muvi/ELController/preview/ELController.png

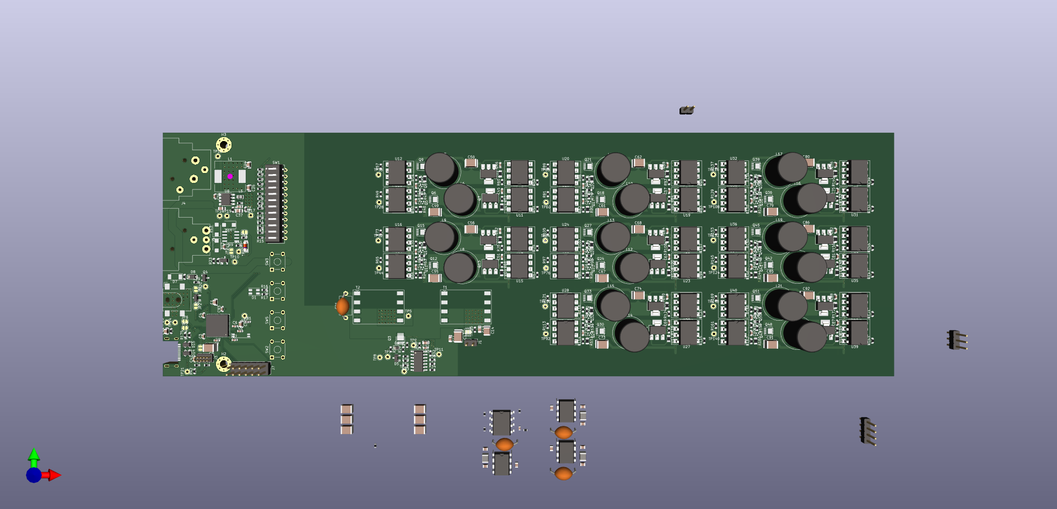
preview/ELController.png
