muvi/ELController/board design/Design Errors.txt

| oben links ist das 170V-Netzteil nur auf einer Seite verbunden und auf der anderen unterbrochen
| Der SWD stecker passt nicht, weil eine prtr-Schutzdiode vom USB Anschluss im Weg ist
  |-> angepasst, Silkscreen muss aber noch angepasst werden
| Der SWD STecker verdeckt ein Schraubloch
| Button 1 ist C, button 3 ist A
| channelnummerierung wurde geändert
| trace width change in OUTPUT_ENABLE net
/ Ground pin of DMX plug does not fit
| Numbering of DMX channels for selector DIP switch is wrong
- Additional support for 5 pin DMX connector
(/ CONFIG2 uses the same interrupt as BTN3 (EXTINT[5]))
| Silkscreen-Richtungsmarkierung ist bei D3 und D16 anders als bei D2
- at least one pin of the makeshift ADC should be a GPIO
/ add support for a display
| one more Button / replace reset button with regular BTN4
| Change order of BTN1 to BTN4 to match the letters from A to D
- replace transformers, they are not fit for the purpose (with GA3459-BL or GA3460-BL for example)
- the DIP switch could have one digit more resolution if the resistors where referenced to 1V, not 1.5V
/ maybe add support for a microphone over I2S
- order a lot more buttons. They break easily.
/ (add a header for a potential battery holder module which can also charge lithium ion batteries)
/ (add a header for wireless communication)
| Grundlast hinzufügen (10meg sind zu viel, noch ermitteln, < 250K)
- USB Anschluss ein bisschen weiter herausgucken lassen ?!
/ DMX connector does not fit easily in footprint (NOFIX: changes according to datasheet would worsen the situation)
- Add more capacitance to high voltage side (around 100 uF?)
- add capacitors to output channels
- remove some DNP resistors (at inverter for HV switching, ...)
- Diode D2 has not enough current capability, measure if 4 diodes are really enough (measure maximum discharge time and calculate current)
- buy more buttons

Channel mapping: (Beschriftung = Netzname)
1 = 2
2 = 1
3 = 4
4 = 3
5 = 5
6 = 7
7 = 6
8 = 8
