muvi/ELController/code R1/ELController/My Project/hpl/doc_lite/usart.rst

======================
USART driver
======================
The Universal Synchronous and Asynchronous serial Receiver and Transmitter (USART) peripheral is a
fast and flexible serial communication module. The USART supports full-duplex communication,
asynchronous and synchronous operation and one-wire configurations.

Features
--------
* Initialization

Applications
------------
* Terminal application
* Low-speed communication between devices.

Dependencies
------------
* CLKCTRL for clock
* PORT for I/O lines and connections
* CPUINT for interrupts
* EVSYS for events
* UPDI for debug

Concurrency
-----------
N/A

Limitations
-----------
N/A

Knows issues and workarounds
----------------------------
N/A
