muvi/ELController/board design R1/Pin mapping R1.ods

Sheet: Pins
SAMD2xG | SAMD2xJ | Pin | Cluster SAMD2xG | Cluster SAMD2xJ | Usage | Function | Power (mA) | Conflicts
1 | 1 | PA00 | 6 | 7 | XIN32 | -
2 | 2 | PA01 | 6 | 7 | XOUT32 | -
3 | 3 | PA02 | 6 | 7 | ADC – AIN[0] | B
4 | 4 | PA03 | 6 | 7 | ADC – AIN[1] | B |  | ADC/VREFA
 | 5 | PB04 |  | 7 | ADC – AIN[12] |  |  |  | USB CC1
 | 6 | PB05 |  | 7 | ADC – AIN[13] |  |  |  | USB CC2
5 | 7 | GNDANA
6 | 8 | VDDANA
 | 9 | PB06 |  | 6
 | 10 | PB07 |  | 6
7 | 11 | PB08 | 5 | 6 | TC4/WO[0] | E | 10
8 | 12 | PB09 | 5 | 6 | TC4/WO[1] | E | 10
9 | 13 | PA04 | 5 | 6 | ADC – AIN[4] | B |  | TCC0/WO[0]
10 | 14 | PA05 | 5 | 6 | ADC – AIN[5] | B |  | TCC0/WO[1]
11 | 15 | PA06 | 5 | 6 | ADC – AIN[6] | E | 10 | TCC1/WO[0]
12 | 16 | PA07 | 5 | 6 | TCC1/WO[1] | E | 10
13 | 17 | PA08 | 4 | 5 | TCC0/WO[0] | E | 10
14 | 18 | PA09 | 4 | 5 | TCC0/WO[1] | E | 10
15 | 19 | PA10 | 4 | 5 | TCC0/WO[2] | F | 10 | TCC1/WO[0]
16 | 20 | PA11 | 4 | 5 | TCC0/WO[3] | F | 10 | TCC1/WO[1]
17 | 21 | VDDIO
18 | 22 | GND
19 | 23 | PB10 | 3 | 4 | TC5/WO[0] | E | 10
20 | 24 | PB11 | 3 | 4 | TC5/WO[1] | E | 10
 | 25 | PB12 |  | 4
 | 26 | PB13 |  | 4
 | 27 | PB14 |  | 4
 | 28 | PB15 |  | 4
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
