muvi/ELController/board design/Pin mapping.xlsx

Sheet: Pins
SAMD2xG | SAMD2xJ | Pin | Cluster SAMD2xG | Cluster SAMD2xJ | Name | Usage | Function | Power (mA) | Old Name | HV Support Wave out
1 | 1 | PA00 | 6 | 7 | XIN32 | XIN32 | - |  | XIN32
2 | 2 | PA01 | 6 | 7 | XOUT32 | XOUT32 | - |  | XOUT32
3 | 3 | PA02 | 6 | 7 | PWR_SENSE | ADC – AIN[0] | B (ADC) |  | PWR_SENSE
4 | 4 | PA03 | 6 | 7 | HV_SENSE | ADC – AIN[1] | B (ADC) |  | HV_SENSE
 | 5 | PB04 |  | 7 | USB_CC1 | - | - |  | USB_CC1
 | 6 | PB05 |  | 7 | USB_CC2 | - | - |  | USB_CC2
5 | 7 | GNDANA
6 | 8 | VDDANA
 | 9 | PB06 |  | 6 | BTN_A | EXTINT[6] | A |  | GPIO3
 | 10 | PB07 |  | 6 | BTN_B | EXTINT[7] | A |  | GPIO4
7 | 11 | PB08 | 5 | 6 | CH7+ | TC4/WO[0] | E | 10 | CH6+
8 | 12 | PB09 | 5 | 6 | CH7- | TC4/WO[1] | E | 10 | CH6-
9 | 13 | PA04 | 5 | 6 | CONFIG1 | AC – AIN[0] | B (AC) |  | CONFIG1
10 | 14 | PA05 | 5 | 6 | CONFIG2 | AC – AIN[1] | B (AC) |  | CONFIG2
11 | 15 | PA06 | 5 | 6 | CONFIG3 | AC – AIN[2] | B (AC) | 10 | CONFIG3 | X
12 | 16 | PA07 | 5 | 6 | HV_SW | TCC1/WO[1] | E | 10 | HV_SW
13 | 17 | PA08 | 4 | 5 | PWR_GOOD | NMI | A | 10 | CH1+ | X
14 | 18 | PA09 | 4 | 5 | OUTPUT_ENABLE | - | - | 10 | CH1-
15 | 19 | PA10 | 4 | 5 | CH1+ | TCC0/WO[2] | F | 10 | CH2+ | X
16 | 20 | PA11 | 4 | 5 | CH1- | TCC0/WO[3] | F | 10 | CH2-
17 | 21 | VDDIO
18 | 22 | GND
19 | 23 | PB10 | 3 | 4 | CH6+ | TC5/WO[0] | E | 10 | CH7+
20 | 24 | PB11 | 3 | 4 | CH6- | TC5/WO[1] | E | 10 | CH7-
 | 25 | PB12 |  | 4 | BTN_C | EXTINT[12] | A |  | DISPLAY_MOSI / GPIO5
 | 26 | PB13 |  | 4 | BTN_D | EXTINT[13] | A |  | DISPLAY_SCK / GPIO6
 | 27 | PB14 |  | 4 | DISPLAY_SS | SERCOM4/PAD[2] | C |  | DISPLAY_SS / GPIO7
 | 28 | PB15 |  | 4 | DISPLAY_MISO | SERCOM4/PAD[3] | C |  | DISPLAY_MISO / GPIO8
21 | 29 | PA12 | 3 | 4 | DISPLAY_MOSI | SERCOM4/PAD[0] | D |  | CH3+
22 | 30 | PA13 | 3 | 4 | DISPLAY_SCK | SERCOM4/PAD[1] | D |  | CH3-
23 | 31 | PA14 | 3 | 4 | CH4+ | TC3/WO[0] | E | 10 | PWR_GOOD
24 | 32 | PA15 | 3 | 4 | CH4- | TC3/WO[1] | E | 10 | DMX_SENDER_ENABLE
 | 33 | GND
 | 34 | VDDIO
25 | 35 | PA16 | 3 | 3 | CH3+ | TCC2/WO[0] | E | 10 | BTN1
26 | 36 | PA17 | 3 | 3 | CH3- | TCC2/WO[1] | E | 10 | BTN2
27 | 37 | PA18 | 3 | 3 | MIC_ENABLE | - | - |  | CH4+
28 | 38 | PA19 | 3 | 3 | I2S_SD | I2S/SD[0] | G |  | CH4-
 | 39 | PB16 |  | 3 | GPIO1 |  | - |  | GPIO9
 | 40 | PB17 |  | 3 | GPIO2 | - | - |  | GPIO10
29 | 41 | PA20 | 3 | 3 | i2S_SCK | I2S/SCK[0] | G |  | OUTPUT_ENABLE
30 | 42 | PA21 | 3 | 3 | I2S_WS | I2S/FS[0] | G |  | BTN3
31 | 43 | PA22 | 3 | 3 | DMX_TX | SERCOM3/PAD[0] | C |  | DMX_TX
32 | 44 | PA23 | 3 | 3 | DMX_RX | SERCOM3/PAD[1] | C |  | DMX_RX
33 | 45 | PA24 | 3 | 3 | USB_D- | USB/DM | G |  | USB/DM | X
34 | 46 | PA25 | 3 | 3 | USB_D+ | USB/DP | G |  | USB/DP
35 | 47 | GND
36 | 48 | VDDIO
37 | 49 | PB22 | 2 | 2 | CH8+ | TC7/WO[0] | E | 10 | CH8+
38 | 50 | PB23 | 2 | 2 | CH8- | TC7/WO[1] | E | 10 | CH8-
39 | 51 | PA27 | 2 | 2 | LED1 | - | - | 10 | LED1
40 | 52 | RESET
41 | 53 | PA28 | 2 | 2 | LED2 | - | - | 10 | LED2
42 | 54 | GND
43 | 55 | VDDCORE
44 | 56 | VDDIN
45 | 57 | PA30 | 1 | 1 | SWDCLK | SWCLK | G |  | SWDCLK | X
46 | 58 | PA31 | 1 | 1 | SWDIO | SWDIO | G |  | SWDIO
 | 59 | PB30 |  | 1 | CH2+ | TCC0/WO[0] | E | 10 | GPIO11 | X
 | 60 | PB31 |  | 1 | CH2- | TCC0/WO[1] | E |  | GPIO12
 | 61 | PB00 |  | 7 | GPIO3 | - | - |  | GPIO1
 | 62 | PB01 |  | 7 | DMX_SENDER_ENABLE | - | - |  | GPIO2
47 | 63 | PB02 | 6 | 7 | CH5+ | TC6/WO[0] | E | 10 | CH5+
48 | 64 | PB03 | 6 | 7 | CH5- | TC6/WO[1] | E | 10 | CH5-

Sheet: Settings
 | Power (mA)
Power per channel driver | 10
Power per LED | 10
Source current per cluster | 46
Sink current per cluster | 65
Cluster | G Version | J Version
1 | 0 | 10
2 | 40 | 40
3 | 60 | 20
4 | 40 | 40
5 | 40 | 40
6 | 20 | 40
7 | 0 | 20
Sum | 200
