muvi/ELController/board design/ELController-bom-log.csv

Title: | EL Controller
Revision: | 2
Date: | Sat 25 Feb 2023 07:12:46 PM CET
Ref | Error message | Value | Footprint | Datasheet
