muvi/ELController/ideal diode board/ideal_diode-bom-log.csv

Title: | Ideal diode
Revision: | 1
Date: | Fri 06 Jan 2023 10:19:56 PM CET
Ref | Error message | Value | Footprint | Datasheet
