muvi/ELController/Ordering/2022-04-10 BOM grouped.xlsx

Sheet: Items
Item | Qty | Minimum Amount | Amount Arrived/Ordered | Duplicate of | Reference(s) | Value | Supplier part number |  | LibPart | Footprint | Datasheet
1 | 7 | 50 | 100 |  | C1, C5, C24, C28, C31, C34, C38 | 10uF | CL21A106KOQNNNE | CL21A106KOQNNNE | Device:C |  | https://www.mouser.de/datasheet/2/585/MLCC-1837944.pdf
2 | 41 | 210 | 250 |  | C2, C3, C4, C6, C10, C23, C35, C43, C45, C46, C47, C48, C51, C52, C53, C54, C57, C58, C59, C60, C63, C64, C65, C66, C69, C70, C71, C72, C75, C76, C77, C78, C81, C82, C83, C84, C87, C88, C89, C90, C93 | 100nF | CL10B104KA8NFNC | CL10B104KA8NFNC | Device:C |  | ~
3 | 2 | 10 | 20 |  | C7, C8 | 9.1pF | 0603N9R1C500CT | #N/A | Device:C |  | ~
4 | 18 | 0 | 0 | 7 | C9, C12, C49, C50, C55, C56, C61, C62, C67, C68, C73, C74, C79, C80, C85, C86, C91, C92 | 1uF, 200V |  | 0 | Device:C |  | ~
5 | 3 | 0 | 0 | 1 | C11, C13, C22 | 10uF |  | 0 | Device:C_Polarized |  | ~
6 | 1 | 5 | 10 |  | C14 | 47uF, GRM32EC81C476KE15K | GRM32EC81C476KE15K | GRM32EC81C476KE15K | Device:C_Polarized |  | ~
7 | 6 | 120 | 120 |  | C15, C16, C17, C18, C19, C20 | 1uF, 200V | 1812B105K251CT | 1812B105K251CT | Device:C_Polarized |  | ~
8 | 4 | 20 | 30 |  | C21, C39, C40, C41 | Y2 1nF | C901U102MZWDBA7317 | C901U102MZWDBA7317 | Device:C |  | ~
9 | 2 | 10 | 20 |  | C25, C37 | 22uF | CL21A226MOQNNNE | CL21A226MOQNNNE | Device:C |  | ~
10 | 6 | 30 | 40 |  | C26, C27, C29, C30, C32, C33 | 4.7uF | CL21A475KAQNNNF | CL21A475KAQNNNF | Device:C_Polarized |  | ~
11 | 1 | 5 | 10 |  | C36 | 680pF | 885012206033 | 885012206033 | Device:C |  | ~
12 | 1 | 0 | 0 | 2 | C42 | 100nF, DNP |  | 0 | Device:C |  | ~
13 | 1 | 5 | 10 |  | C44 | 4.7nF | 885012206087 | 885012206087 | Device:C |  | ~
14 | 1 | 5 | 10 |  | D1 | LED_Dual_CACA: Pinout incorrect | 150141YB73100 | 150141YB73100 | Device:LED_Dual_KAKA |  | https://eu.mouser.com/datasheet/2/445/150141YB73100-1714285.pdf
15 | 1 | 5 | 10 |  | D2 | FM4007W-W | FM4007W-W | FM4007W-W | Device:D |  | https://www.mouser.de/datasheet/2/345/fm4001w_fm4007w-1396243.pdf
16 | 2 | 10 | 15 |  | D3, D16 | BZD27B180P-M3-08 | BZD27B180P-M3-08 | BZD27B180P-M3-08 | Device:D_Zener |  | https://www.mouser.de/datasheet/2/427/VISH_S_A0008998136_1-2570582.pdf
17 | 2 | 10 | 15 |  | D4, D5 | BZX8450-C1V8-QR | BZX8450-C1V8-QR | BZX8450-C1V8-QR | el_components:BZX8450-C1V8-QR |  | ~
18 | 1 | 5 | 10 |  | D6 | MM3Z36VT1G | MM3Z36VT1G | MM3Z36VT1G | Device:D_Zener |  | ~
19 | 1 | 5 | 10 |  | D7 | PMEG3050EP,115 | PMEG3050EP,115 | PMEG3050EP,115 | Device:D_Schottky |  | ~
20 | 1 | 5 | 10 |  | D8 | PTVS13VS1UTR,115 | PTVS13VS1UTR,115 | PTVS13VS1UTR,115 | el_components:DESD1CAN2WQ-7 |  | https://www.mouser.de/datasheet/2/916/PTVSXS1UTR_SER-1600409.pdf
21 | 1 | 5 | 10 |  | D9 | BAT54A_R1_00001 | BAT54A_R1_00001 | BAT54A_R1_00001 | Diode:BAT54AW | Package_TO_SOT_SMD:SOT-323_SC-70 | https://www.mouser.de/datasheet/2/1057/BAT54_SERIES-1869048.pdf
22 | 1 | 5 | 10 |  | D10 | ZMM5226B | ZMM5226B | ZMM5226B | Diode:ZMMxx | Diode_SMD:D_MiniMELF | https://diotec.com/tl_files/diotec/files/pdf/datasheets/zmm1.pdf
23 | 3 | 15 | 20 |  | D11, D12, D13 | SMAJ6.0A-W | SMAJ6.0A-W | SMAJ6.0A-W | Device:D_TVS |  | ~
24 | 2 | 10 | 15 |  | D14, D15 | PRTR5V0U2X | PRTR5V0U2X,215 | PRTR5V0U2X,215 | Power_Protection:PRTR5V0U2X | Package_TO_SOT_SMD:SOT-143 | https://assets.nexperia.com/documents/data-sheet/PRTR5V0U2X.pdf
25 | 1 | 5 | 20 |  | F1 | ERB-RE5R00V | ERB-RE5R00V | ERB-RE5R00V | Device:Fuse |  | https://www.mouser.de/datasheet/2/315/AFA0000C7-1025982.pdf
26 | 2 | 10 | 20 |  | FB1, FB2 | MMZ1608Y221BTD25 |  | 0 | Device:FerriteBead |  | ~
27 | 4 | 20 | N/A |  | H1, H2, H3, H4 | MountingHole_Pad |  | 0 | Mechanical:MountingHole_Pad |  | ~
28 | 1 | 5 | N/A |  | J1 | 01x01_Male |  | 0 | Connector:Conn_01x01_Male |  | ~
29 | 1 | 5 | 10 |  | J2 | 54-00164 |  | 0 | Connector:Barrel_Jack_Switch |  | ~
30 | 1 | 5 | 10 |  | J3 | SWD_Connector | 3220-10-0100-00 | #N/A | Connector_Generic:Conn_02x05_Odd_Even |  | http://www.cnctech.us/pdfs/3220-XX-0100-00_.pdf
31 | 1 | 5 | 5 |  | J4 | AC3FAH2-AU-PRE |  | 0 | Connector:XLR3 |  | ~
32 | 1 | 5 | 5 |  | J5 | AC3MAH-AU-PRE |  | 0 | Connector:XLR3 |  | ~
33 | 1 | 5 | N/A |  | J6 | Conn_01x03 |  | 0 | Connector_Generic:Conn_01x03 |  | ~
34 | 1 | 5 | N/A |  | J7 | Conn_02x06_Top_Bottom |  | 0 | Connector_Generic:Conn_02x06_Top_Bottom |  | ~
35 | 1 | 5 | N/A |  | J8 | Conn_01x04 |  | 0 | Connector_Generic:Conn_01x04 |  | ~
36 | 1 | 5 | 11 |  | J9 | USB_C | USB4105-GF-A | #N/A | Connector:USB_B_Micro |  | ~
37 | 8 | 40 | 40 |  | J10, J11, J12, J13, J14, J15, J16, J17 | JST-SM |  | #N/A | Connector:Conn_01x02_Female |  | ~
38 | 3 | 15 | N/A |  | JP1, JP2, JP4 | SolderJumper |  | #N/A | Jumper:SolderJumper_2_Open |  | ~
39 | 2 | 10 | N/A |  | JP3, JP5 | SolderJumper_2_Open |  | #N/A | Jumper:SolderJumper_2_Open |  | ~
40 | 1 | 5 | 10 |  | L1 | 22uH | 7447706220 | 7447706220 | Device:L |  | ~
41 | 3 | 15 | 20 |  | L2, L3, L4 | 6.8uH | LBC3225T6R8MR | LBC3225T6R8MR | Device:L |  | ~
42 | 1 | 5 | 10 |  | L5 | 2.2uH | TFM201610ALVA2R2MTAA | TFM201610ALVA2R2MTAA | Device:L |  | ~
43 | 16 | 80 | 100 |  | L6, L7, L8, L9, L10, L11, L12, L13, L14, L15, L16, L17, L18, L19, L20, L21 | 3.3mH | RFS1317-335KL | #N/A | Device:L |  | ~
44 | 1 | 0 | 0 | 45 | Q1 | DNP, RZM001P02 |  | #N/A | Device:Q_PMOS_GSD |  | ~
45 | 17 | 90 | 100 |  | Q2, Q5, Q8, Q11, Q14, Q17, Q20, Q23, Q26, Q29, Q32, Q35, Q38, Q41, Q44, Q47, Q50 | RZM001P02 |  | #N/A | Device:Q_PMOS_GSD |  | ~
46 | 1 | 5 | 10 |  | Q3 | RQ3G100GN | RQ3G100GNTB | RQ3G100GNTB | el_components:RQ3G100GN |  | https://www.mouser.de/datasheet/2/348/rq3g100gntb-e-1873284.pdf
47 | 1 | 5 | 10 |  | Q4 | RK7002BMT116 | RK7002BMT116 | RK7002BMT116 | Device:Q_NMOS_DGS |  | ~
48 | 16 | 80 | 100 |  | Q6, Q9, Q12, Q15, Q18, Q21, Q24, Q27, Q30, Q33, Q36, Q39, Q42, Q45, Q48, Q51 | Si7119DN |  | #N/A | el_components:Si7119DN |  | https://www.mouser.de/datasheet/2/427/VISH_S_A0001142067_1-2567136.pdf
49 | 16 | 80 | 100 |  | Q7, Q10, Q13, Q16, Q19, Q22, Q25, Q28, Q31, Q34, Q37, Q40, Q43, Q46, Q49, Q52 | STN4NF20L |  | #N/A | el_components:STN4NF20L |  | https://www.mouser.de/datasheet/2/389/cd00272247-1797117.pdf
50 | 20 | 110 | 200 |  | R1, R6, R11, R21, R46, R54, R62, R70, R78, R86, R94, R102, R110, R118, R126, R134, R142, R150, R158, R166 | 10k | RC0603JR-0710KL | RC0603JR-0710KL | Device:R |  | ~
51 | 3 | 15 | 30 |  | R2, R7, R12 | 560 | RC0603JR-07560RL | RC0603JR-07560RL | Device:R |  | ~
52 | 3 | 15 | 30 |  | R3, R8, R13 | 1k2 | RMC1/16-122JTP | RMC1/16-122JTP | Device:R |  | ~
53 | 3 | 15 | 30 |  | R4, R9, R14 | 2k2 | RC0603FR-072K2L | RC0603FR-072K2L | Device:R |  | ~
54 | 3 | 15 | 30 |  | R5, R10, R15 | 4k7 | RMC1/16-472JTP | RMC1/16-472JTP | Device:R |  | ~
55 | 35 | 175 | 200 |  | R16, R17, R18, R49, R51, R57, R59, R65, R67, R73, R75, R81, R83, R89, R91, R97, R99, R105, R107, R113, R115, R121, R123, R129, R131, R137, R139, R145, R147, R153, R155, R161, R163, R169, R171 | 470 -> 510 | RC0603JR-07510RL | RC0603JR-07510RL | Device:R |  | ~
56 | 19 | 95 | 125 |  | R19, R40, R41, R50, R58, R66, R74, R82, R90, R98, R106, R114, R122, R130, R138, R146, R154, R162, R170 | 1k | RC0603FR-071KL | RC0603FR-071KL | Device:R |  | ~
57 | 1 | 0 | 0 | 50 | R20 | DNP, 10k |  | #N/A | Device:R |  | ~
58 | 1 | 5 | 20 |  | R22 | DNP, 10meg, 200V | MR12W1005FTL | #N/A | Device:R |  | ~
59 | 2 | 10 | 25 |  | R23, R24 | 22k 1% | CR0603-FX-2202ELF | CR0603-FX-2202ELF | Device:R |  | ~
60 | 1 | 5 | 10 |  | R25 | 22 | 301-22-RC | 301-22-RC | Device:R |  | ~
61 | 2 | 10 | 25 |  | R26, R27 | 680 1% | CR0603-FX-6800ELF | CR0603-FX-6800ELF | Device:R |  | ~
62 | 22 | 110 | 125 |  | R28, R31, R33, R34, R35, R36, R47, R55, R63, R71, R79, R87, R95, R103, R111, R119, R127, R135, R143, R151, R159, R167 | 0 | CR0603-J/-000ELF | CR0603-J/-000ELF | Device:R |  | ~
63 | 1 | 5 | 10 |  | R29 | 220, 1/8W | RK73B1JTTDD221J | RK73B1JTTDD221J | Device:R |  | ~
64 | 4 | 20 | 30 |  | R30, R32, R44, R45 | 1meg | RC0603JR-131ML | RC0603JR-131ML | Device:R |  | ~
65 | 1 | 5 | 10 |  | R37 | 16k | RMC16K163FTP | RMC16K163FTP | Device:R |  | ~
66 | 3 | 15 | 20 |  | R38, R174, R175 | 5.1k | WR06X512 JTL | WR06X512 JTL | Device:R |  | ~
67 | 1 | 5 | 15 |  | R39 | 10meg | RC0603JR-0710ML | RC0603JR-0710ML | Device:R |  | ~
68 | 1 | 0 | 0 | 50 | R42 | 10k, DNP |  | 0 | Device:R |  | ~
69 | 1 | 5 | 10 |  | R43 | 330 | CR0603-JW-331ELF | CR0603-JW-331ELF | Device:R |  | ~
70 | 32 | 160 | 200 |  | R48, R53, R56, R61, R64, R69, R72, R77, R80, R85, R88, R93, R96, R101, R104, R109, R112, R117, R120, R125, R128, R133, R136, R141, R144, R149, R152, R157, R160, R165, R168, R173 | 100 | RC0805FR-13100RL | RC0805FR-13100RL | Device:R |  | ~
71 | 16 | 80 | 100 | 53 | R52, R60, R68, R76, R84, R92, R100, R108, R116, R124, R132, R140, R148, R156, R164, R172 | 2.2k | 301-2.2K-RC | 301-2.2K-RC | Device:R |  | ~
72 | 1 | 5 | (8) + 6 |  | SW1 | SW_DIP_x12 | DS01C-254-S-12BE | DS01C-254-S-12BE | Switch:SW_DIP_x12 |  | ~
73 | 4 | 20 | 25 |  | SW2, SW3, SW4, SW5 | SW_Push | MJTP1230 | MJTP1230 | Switch:SW_Push |  | ~
74 | 2 | 10 | 16 |  | T1, T2 | 750032050 |  | 0 | el_components:750032050 |  | ~
75 | 33 | 165 | 200 |  | U1, U10, U11, U12, U13, U14, U15, U16, U17, U18, U19, U20, U21, U22, U23, U24, U25, U26, U27, U28, U29, U30, U31, U32, U33, U34, U35, U36, U37, U38, U39, U40, U41 | 6N137 |  | 0 | Isolator:6N137 | Package_DIP:DIP-8_W7.62mm | https://docs.broadcom.com/docs/AV02-0940EN
76 | 1 | 5 | 25 |  | U2 | ATSAMD21J15B-M |  | 0 | MCU_Microchip_SAMD:ATSAMD21J15B-M | Package_DFN_QFN:QFN-64-1EP_9x9mm_P0.5mm_EP4.7x4.7mm | http://ww1.microchip.com/downloads/en/DeviceDoc/SAM_D21_DA1_Family_Data%20Sheet_DS40001882E.pdf
77 | 1 | 5 | 10 |  | U3 | MP5000A |  | 0 | el_components:MP5000A |  | https://www.mouser.de/datasheet/2/277/MP5000A-1384322.pdf
78 | 1 | 5 | 10 |  | U4 | 74ACT14 | MC74ACT14DR2G | MC74ACT14DR2G | 74xx:74HC14 |  | http://www.ti.com/lit/gpn/sn74HC14
79 | 3 | 15 | 18 |  | U5, U6, U7 | PDSE1-S5-S5-D | PDSE1-S5-S5-D | PDSE1-S5-S5-D | el_components:PDSE1-S5-S5-D |  | https://www.mouser.de/datasheet/2/670/pdse1_d-1774645.pdf
80 | 1 | 5 | 10 |  | U8 | BD93291EFJ |  | 0 | el_components:BD93291EFJ |  | https://www.mouser.de/datasheet/2/348/bd93291efj-e-1874257.pdf
81 | 1 | 5 | 10 |  | U9 | MAX485 |  | 0 | Interface_UART:MAX485E |  | https://datasheets.maximintegrated.com/en/ds/MAX1487-MAX491.pdf
82 | 1 | 5 | 10 |  | Y1 | SSP-T7-F, MS1V-T1K | SSPT7F-7PF20-R | SSPT7F-7PF20-R | Device:Crystal_GND23 |  | ~
83 | 1 | 5 | 10 |  | D17 | TPSMB210A | TPSMB210A | TPSMB210A | Device:D_TVS |  | https://www.mouser.de/datasheet/2/240/Littelfuse_TVS_Diode_TPSMB_Datasheet_pdf-349004.pdf

Sheet: Mouser
WARENKORB
Dies ist keine Rechnung
11-Apr-22 16:41:46
 | Mouser-Nr. | Herst.- Nr. | Hersteller | Kunden-Teilenr | Beschreibung | RoHS | Lebenszyklus | Stückzahl | Preis (EUR) | Gesamtpreis: (EUR)
1 | 187-CL21A106KOQNNNE | CL21A106KOQNNNE | Samsung Electro-Mechanics |  | Kondensator aus mehreren Keramikschichten MLCC - SMD/SMT 10uF+/-10% 16V X5R 2 0805 | RoHS-konform | Neu bei Mouser | 100 | 0,035 € | 3,50 € | CL21A106KOQNNNE
2 | 187-CL10B104KA8NFNC | CL10B104KA8NFNC | Samsung Electro-Mechanics |  | Kondensator aus mehreren Keramikschichten MLCC - SMD/SMT 100nF+/-10% 25V X7R 0603 | RoHS-konform | Neu bei Mouser | 250 | 0,012 € | 3,00 € | CL10B104KA8NFNC
3 | 81-GRM32EC81C476KE5K | GRM32EC81C476KE15K | Murata |  | Kondensator aus mehreren Keramikschichten MLCC - SMD/SMT 47UF 16V 10% 1210 | RoHS-konform |  | 10 | 0,379 € | 3,79 € | GRM32EC81C476KE15K
4 | 791-1812B105K251CT | 1812B105K251CT | Walsin |  | Kondensator aus mehreren Keramikschichten MLCC - SMD/SMT 1812 MLCC X7R 1 uF +/- 10% 250 V T&R GP | RoHS-konform |  | 120 | 0,363 € | 43,56 € | 1812B105K251CT
5 | 187-CL21A226MOQNNNE | CL21A226MOQNNNE | Samsung Electro-Mechanics |  | Kondensator aus mehreren Keramikschichten MLCC - SMD/SMT 22uF+/-20% 16V X5R 2 0805 | RoHS-konform | Neu bei Mouser | 20 | 0,127 € | 2,54 € | CL21A226MOQNNNE
6 | 187-CL21A475KAQNNNF | CL21A475KAQNNNF | Samsung Electro-Mechanics |  | Kondensator aus mehreren Keramikschichten MLCC - SMD/SMT 4.7uF+/-10% 25V X5R 0805 | RoHS-konform | Neu bei Mouser | 40 | 0,074 € | 2,96 € | CL21A475KAQNNNF
7 | 710-885012206033 | 885012206033 | Wurth Elektronik |  | Kondensator aus mehreren Keramikschichten MLCC - SMD/SMT WCAP-CSGP 680pF 0603 10% 16V MLCC | RoHS-konform |  | 10 | 0,02 € | 0,20 € | 885012206033
8 | 710-885012206087 | 885012206087 | Wurth Elektronik |  | Kondensator aus mehreren Keramikschichten MLCC - SMD/SMT WCAP-CSGP 4700pF 0603 10% 50V MLCC | RoHS-konform |  | 10 | 0,017 € | 0,17 € | 885012206087
9 | 628-SSPT7F-7PF20PPM | SSPT7F-7PF20-R | Seiko Instruments |  | Quarze Quartz Crystal Unit 32.768KHZ 7pF | RoHS-konform |  | 10 | 0,553 € | 5,53 € | SSPT7F-7PF20-R
10 | 81-GRM0225C1H9R1CA3L | GRM0225C1H9R1CA03L | Murata |  | Kondensator aus mehreren Keramikschichten MLCC - SMD/SMT | RoHS-konform |  | 10 | 0,046 € | 0,46 € | #N/A
11 | 80-C901U102MZWDBAP | C901U102MZWDBA7317 | KEMET |  | Sicherheitskondensatoren 440/300V 1000pF Y5U 20% LS=10mm | RoHS-konform |  | 30 | 0,148 € | 4,44 € | C901U102MZWDBA7317
12 | 490-PDSE1-S5-S5-D | PDSE1-S5-S5-D | CUI Inc. |  | ISOLIERTE DC-DC-WANDLER dc-dc isolated, 1 W, 4.5~5.5 Vdc input, 5 Vdc, 0.2 A, single unregulated output, DIP | RoHS-konform |  | 18 | 2,70 € | 48,60 € | PDSE1-S5-S5-D
13 | 863-MC74ACT14DR2G | MC74ACT14DR2G | onsemi |  | Inverter 5V CMOS Hex Schmitt Trigger | RoHS-konform |  | 10 | 0,464 € | 4,64 € | MC74ACT14DR2G
14 | 642-MJTP1230 | MJTP1230 | Apem |  | Sensorschalter 6mm TACTILE SW | RoHS-konform |  | 25 | 0,074 € | 1,85 € | MJTP1230
15 | 755-RQ3G100GNTB | RQ3G100GNTB | ROHM Semiconductor |  | MOSFET Nch 40V 10A Power MOSFET | RoHS: Konform durch Ausnahmegenehmigung |  | 10 | 0,383 € | 3,83 € | RQ3G100GNTB
16 | 755-RK7002BMT116 | RK7002BMT116 | ROHM Semiconductor |  | MOSFET 2.5V Drive Nch MOSFET | RoHS: Konform durch Ausnahmegenehmigung |  | 10 | 0,17 € | 1,70 € | RK7002BMT116
17 | 583-FM4007W-W | FM4007W-W | Rectron |  | Gleichrichter 1A, 1000V, SM | RoHS: Konform durch Ausnahmegenehmigung |  | 10 | 0,14 € | 1,40 € | FM4007W-W
18 | 771-BZX8450-C1V8-QR | BZX8450-C1V8-QR | Nexperia |  | Zener-Dioden BZX8450-C1V8-Q/SOT23/TO-236AB | RoHS-konform | Neues Produkt | 15 | 0,134 € | 2,01 € | BZX8450-C1V8-QR
19 | 863-MM3Z36VT1G | MM3Z36VT1G | onsemi |  | Zener-Dioden 36V 200mW | RoHS-konform |  | 10 | 0,127 € | 1,27 € | MM3Z36VT1G
20 | 771-PMEG3050EP115 | PMEG3050EP,115 | Nexperia |  | Schottky Dioden & Gleichrichter SCHOTTKY RECT 30V 5A | RoHS: Konform durch Ausnahmegenehmigung |  | 10 | 0,438 € | 4,38 € | PMEG3050EP,115
21 | 241-BAT54A_R1_00001 | BAT54A_R1_00001 | Panjit |  | Schottky Dioden & Gleichrichter 30V Schottky 0.2A | RoHS-konform | Neu bei Mouser | 10 | 0,142 € | 1,42 € | BAT54A_R1_00001
22 | 583-ZMM5226B | ZMM5226B | Rectron |  | Zener-Dioden 0.5W 3.3V 5% | RoHS: Konform durch Ausnahmegenehmigung |  | 10 | 0,108 € | 1,08 € | ZMM5226B
23 | 583-SMAJ6.0A-W | SMAJ6.0A-W | Rectron |  | ESD-Entstörer/TVS-Dioden SMA 400w TVS 5% | RoHS-konform |  | 20 | 0,108 € | 2,16 € | SMAJ6.0A-W
24 | 771-PRTR5V0U2X-T/R | PRTR5V0U2X,215 | Nexperia |  | ESD-Entstörer/TVS-Dioden 5.5V DUAL R-R ESD ULTRA LOW CAP | RoHS-konform |  | 15 | 0,407 € | 6,11 € | PRTR5V0U2X,215
25 | 667-ERB-RE5R00V | ERB-RE5R00V | Panasonic |  | Sicherungen zur Aufbaumontage 5A 0603 micro chip | RoHS-konform |  | 20 | 0,211 € | 4,22 € | ERB-RE5R00V
26 | 603-RC0603JR-0710KL | RC0603JR-0710KL | YAGEO |  | Dickfilmwiderstände - SMD 10 kOhms 100 mW 0603 5% | RoHS: Konform durch Ausnahmegenehmigung |  | 200 | 0,005 € | 1,00 € | RC0603JR-0710KL
27 | 603-RC0603JR-07560RL | RC0603JR-07560RL | YAGEO |  | Dickfilmwiderstände - SMD 560 Ohms 100 mW 0603 5% | RoHS: Konform durch Ausnahmegenehmigung |  | 30 | 0,013 € | 0,39 € | RC0603JR-07560RL
28 | 791-RMC1/16-122JTP | RMC1/16-122JTP | Kamaya |  | Dickfilmwiderstände - SMD 0603 1K2 5% | RoHS: Konform durch Ausnahmegenehmigung |  | 30 | 0,013 € | 0,39 € | RMC1/16-122JTP
29 | 603-RC0603FR-072K2L | RC0603FR-072K2L | YAGEO |  | Dickfilmwiderstände - SMD 2.2 kOhms 100mW 0603 1% | RoHS: Konform durch Ausnahmegenehmigung |  | 30 | 0,015 € | 0,45 € | RC0603FR-072K2L
30 | 791-RMC1/16-472JTP | RMC1/16-472JTP | Kamaya |  | Dickfilmwiderstände - SMD 0603 4K7 5% | RoHS: Konform durch Ausnahmegenehmigung |  | 30 | 0,013 € | 0,39 € | RMC1/16-472JTP
31 | 603-RC0603JR-07510RL | RC0603JR-07510RL | YAGEO |  | Dickfilmwiderstände - SMD 510 Ohms 100 mW 0603 5% | RoHS: Konform durch Ausnahmegenehmigung |  | 200 | 0,005 € | 1,00 € | RC0603JR-07510RL
32 | 603-RC0603FR-071KL | RC0603FR-071KL | YAGEO |  | Dickfilmwiderstände - SMD 1 kOhms 100mW 0603 1% | RoHS: Konform durch Ausnahmegenehmigung |  | 125 | 0,006 € | 0,75 € | RC0603FR-071KL
33 | 652-CR0603FX-2202ELF | CR0603-FX-2202ELF | Bourns |  | Dickfilmwiderstände - SMD 22K ohm 1% | RoHS: Konform durch Ausnahmegenehmigung |  | 25 | 0,014 € | 0,35 € | CR0603-FX-2202ELF
34 | 652-CR0603FX-6800ELF | CR0603-FX-6800ELF | Bourns |  | Dickfilmwiderstände - SMD 680 ohm 1% | RoHS: Konform durch Ausnahmegenehmigung |  | 25 | 0,015 € | 0,38 € | CR0603-FX-6800ELF
35 | 301-22-RC | 301-22-RC | Xicon |  | Dickfilmwiderstände - SMD 1/10WATT 22OHMS 5% | RoHS: Konform durch Ausnahmegenehmigung |  | 10 | 0,011 € | 0,11 € | 301-22-RC
36 | 652-CR0603-J/-000ELF | CR0603-J/-000ELF | Bourns |  | Dickfilmwiderstände - SMD ZERO OHM | RoHS: Konform durch Ausnahmegenehmigung |  | 125 | 0,005 € | 0,63 € | CR0603-J/-000ELF
37 | 603-RC0603JR-131ML | RC0603JR-131ML | YAGEO |  | Dickfilmwiderstände - SMD 1 MOhms 100-200 mW 0603 5% | RoHS: Konform durch Ausnahmegenehmigung |  | 30 | 0,013 € | 0,39 € | RC0603JR-131ML
38 | 791-RMC16K163FTP | RMC16K163FTP | Kamaya |  | Dickfilmwiderstände - SMD 16 kOhms 1% 1.0A AEC-Q200 | RoHS: Konform durch Ausnahmegenehmigung |  | 10 | 0,016 € | 0,16 € | RMC16K163FTP
39 | 791-WR06X512JTL | WR06X512 JTL | Walsin |  | Dickfilmwiderstände - SMD 0603 5K1 5% Lead Free | RoHS-konform | Neues Produkt | 20 | 0,013 € | 0,26 € | WR06X512 JTL
40 | 603-RC0603JR-0710ML | RC0603JR-0710ML | YAGEO |  | Dickfilmwiderstände - SMD 10 MOhms 100 mW 0603 5% | RoHS: Konform durch Ausnahmegenehmigung |  | 15 | 0,013 € | 0,20 € | RC0603JR-0710ML
41 | 652-CR0603-JW-331ELF | CR0603-JW-331ELF | Bourns |  | Dickfilmwiderstände - SMD 330 OHM 5% | RoHS: Konform durch Ausnahmegenehmigung |  | 10 | 0,007 € | 0,07 € | CR0603-JW-331ELF
42 | 603-RC0805FR-13100RL | RC0805FR-13100RL | YAGEO |  | Dickfilmwiderstände - SMD 100 Ohms 250 mW 0805 1% | RoHS: Konform durch Ausnahmegenehmigung |  | 200 | 0,011 € | 2,20 € | RC0805FR-13100RL
43 | 301-2.2K-RC | 301-2.2K-RC | Xicon |  | Dickfilmwiderstände - SMD 1/10WATT 2.2KOHMS | RoHS: Konform durch Ausnahmegenehmigung |  | 100 | 0,004 € | 0,40 € | 301-2.2K-RC
44 | 660-RK73B1JTTDD221J | RK73B1JTTDD221J | KOA Speer |  | Dickfilmwiderstände - SMD 1/8W 220 OHM 5% | RoHS: Konform durch Ausnahmegenehmigung |  | 10 | 0,019 € | 0,19 € | RK73B1JTTDD221J
45 | 710-150141YB73100 | 150141YB73100 | Wurth Elektronik |  | Standard-LEDs - SMD WL-SBTW SMDBiClr Top Watrclr 3528Ylw&Blue | RoHS-konform |  | 10 | 0,30 € | 3,00 € | 150141YB73100
46 | 810-TFM201610ALVA2R2 | TFM201610ALVA2R2MTAA | TDK |  | Festinduktivitäten 2.2uH 20% 152mOhm 2A AEC-Q200 | RoHS-konform | Neues Produkt | 10 | 0,549 € | 5,49 € | TFM201610ALVA2R2MTAA
47 | 710-7447706220 | 7447706220 | Wurth Elektronik |  | Festinduktivitäten WE-PD 22uH 3.7A DCR=41mOhms AECQ200 | RoHS-konform |  | 10 | 0,983 € | 9,83 € | 7447706220
48 | 963-LBC3225T6R8MR | LBC3225T6R8MR | Taiyo Yuden |  | Festinduktivitäten 1210 6.8uH 156mOhms +/-20%Tol 620mA | RoHS-konform |  | 20 | 0,122 € | 2,44 € | LBC3225T6R8MR
49 | 771-PTVS13VS1UTR115 | PTVS13VS1UTR,115 | Nexperia |  | ESD-Entstörer/TVS-Dioden UNI 15.9V 400W | RoHS: Konform durch Ausnahmegenehmigung |  | 10 | 0,109 € | 1,09 € | PTVS13VS1UTR,115
50 | 640-USB4510031A | USB4510-03-1-A | Global Connector Technology (GCT) |  | USB-Stecker USB C Rec 16P 3u" Mid Mnt 1.6mm O-set SMT L = 6.5mm S-Spring | RoHS-konform | Neues Produkt | 10 | 0,574 € | 5,74 € | #N/A
51 | 78-BZD27B180P-M3-08 | BZD27B180P-M3-08 | Vishay |  | Zener-Dioden ZENER DIODE SMF AEC-Q101 Qualified | RoHS: Konform durch Ausnahmegenehmigung |  | 15 | 0,329 € | 4,94 € | BZD27B180P-M3-08
52 | 576-TPSMB210A | TPSMB210A | Littelfuse |  | ESD-Entstörer/TVS-Dioden 600W 210V AEC-Q101 5% Uni-Directional | RoHS-konform |  | 10 | 0,562 € | 5,62 € | TPSMB210A
53 | 490-DS01C-254-S-12BE | DS01C-254-S-12BE | CUI Devices |  | DIP-Schalter / SIP-Schalter 1 12 Positions, Through Hole, 2.54 mm Pitch, Slide Actuator, DIP Switch | RoHS-konform |  | 6 | 0,974 € | 5,84 € | DS01C-254-S-12BE
Durch das Absenden Ihrer Bestellung erklären Sie sich mit diesen Geschäftsbedingungen einverstanden. (https://www.mouser.de/saleterms) |  |  |  |  |  |  |  |  | Ware: | 208,52 €
Die Preise sind zum angezeigten Datum und zur Uhrzeit reflektiert. |  |  |  |  |  |  |  |  | Versandkosten: | 0,00 €

Sheet: checkup
Item | Qty | Reference(s) | Value | LibPart | Footprint | Datasheet
1 | 7 | C1, C5, C24, C28, C31, C34, C38 | 10uF | Device:C |  | ~ | C1, C5, C24, C28, C31, C34, C38
2 | 40 | C2, C3, C4, C6, C10, C23, C35, C43, C45, C46, C47, C48, C51, C52, C53, C54, C57, C58, C59, C60, C63, C64, C65, C66, C69, C70, C71, C72, C75, C76, C77, C78, C81, C82, C83, C84, C87, C88, C89, C90 | 100nF | Device:C |  | ~ | #N/A
3 | 2 | C7, C8 | 9.1pF | Device:C |  | ~ | C7, C8
4 | 2 |  | 1uF | Device:C |  | ~ | #N/A
5 | 3 | C11, C13, C22 | 10uF | Device:C_Polarized |  | ~ | C11, C13, C22
6 | 1 | C14 | 47uF, GRM32EC81C476KE15K | Device:C_Polarized |  | ~ | C14
7 | 6 | C15, C16, C17, C18, C19, C20 | 1uF, 200V | Device:C_Polarized |  | ~ | C15, C16, C17, C18, C19, C20
8 | 4 | C21, C39, C40, C41 | Y2 1nF | Device:C |  | ~ | C21, C39, C40, C41
9 | 2 | C25, C37 | 22uF | Device:C |  | ~ | C25, C37
10 | 6 | C26, C27, C29, C30, C32, C33 | 4.7uF | Device:C_Polarized |  | ~ | C26, C27, C29, C30, C32, C33
11 | 1 | C36 | 680pF | Device:C |  | ~ | C36
12 | 1 | C42 | 100nF, DNP | Device:C |  | ~ | C42
13 | 1 | C44 | 4.7nF | Device:C |  | ~ | C44
14 | 16 | C9, C12, C49, C50, C55, C56, C61, C62, C67, C68, C73, C74, C79, C80, C85, C86, C91, C92 | 1uF, 200V | Device:C |  | ~ | C9, C12, C49, C50, C55, C56, C61, C62, C67, C68, C73, C74, C79, C80, C85, C86, C91, C92
15 | 1 | D1 | 150141YB73100 | Device:LED_Dual_AAKK |  | ~ | D1
16 | 1 | D2 | FM4007W-W | Device:D |  | https://www.mouser.de/datasheet/2/345/fm4001w_fm4007w-1396243.pdf | D2
17 | 2 | D3, D16 | BZD27B180P-M3-08 | Device:D_Zener |  | https://www.mouser.de/datasheet/2/427/VISH_S_A0008998136_1-2570582.pdf | D3, D16
18 | 2 | D4, D5 | BZX8450-C1V8-QR | el_components:BZX8450-C1V8-QR |  | ~ | D4, D5
19 | 1 | D6 | MM3Z36VT1G | Device:D_Zener |  | ~ | D6
20 | 1 | D7 | PMEG3050EP,115 | Device:D_Schottky |  | ~ | D7
21 | 1 | D8 | PTVS13VS1UTR,115 | Device:D_TVS |  | https://www.mouser.de/datasheet/2/916/PTVSXS1UTR_SER-1600409.pdf | D8
22 | 1 | D9 | BAT54A_R1_00001 | Diode:BAT54AW | Package_TO_SOT_SMD:SOT-323_SC-70 | https://www.mouser.de/datasheet/2/1057/BAT54_SERIES-1869048.pdf | D9
23 | 1 | D10 | ZMM5226B | Diode:ZMMxx | Diode_SMD:D_MiniMELF | https://diotec.com/tl_files/diotec/files/pdf/datasheets/zmm1.pdf | D10
24 | 3 | D11, D12, D13 | SMAJ6.0A-W | Device:D_TVS |  | ~ | D11, D12, D13
25 | 2 | D14, D15 | PRTR5V0U2X | Power_Protection:PRTR5V0U2X | Package_TO_SOT_SMD:SOT-143 | https://assets.nexperia.com/documents/data-sheet/PRTR5V0U2X.pdf | D14, D15
26 | 1 | D17 | TPSMB210A | Device:D_TVS |  | https://www.mouser.de/datasheet/2/240/Littelfuse_TVS_Diode_TPSMB_Datasheet_pdf-349004.pdf | D17
27 | 1 | F1 | ERB-RE5R00V | Device:Fuse |  | https://www.mouser.de/datasheet/2/315/AFA0000C7-1025982.pdf | F1
28 | 2 | FB1, FB2 | MMZ1608Y221BTD25 | Device:FerriteBead |  | ~ | FB1, FB2
29 | 4 | H1, H2, H3, H4 | MountingHole_Pad | Mechanical:MountingHole_Pad |  | ~ | H1, H2, H3, H4
30 | 1 | J1 | 01x01_Male | Connector:Conn_01x01_Male |  | ~ | J1
31 | 1 | J2 | 54-00164 | Connector:Barrel_Jack_Switch |  | ~ | J2
32 | 1 | J3 | SWD_Connector | Connector_Generic:Conn_02x05_Odd_Even |  | ~ | J3
33 | 1 | J4 | AC3FAH2-AU-PRE | Connector:XLR3 |  | ~ | J4
34 | 1 | J5 | AC3MAH-AU-PRE | Connector:XLR3 |  | ~ | J5
35 | 1 | J6 | Conn_01x03 | Connector_Generic:Conn_01x03 |  | ~ | J6
36 | 1 | J7 | Conn_02x06_Top_Bottom | Connector_Generic:Conn_02x06_Top_Bottom |  | ~ | J7
37 | 1 | J8 | Conn_01x04 | Connector_Generic:Conn_01x04 |  | ~ | J8
38 | 1 | J9 | USB_C_Receptacle_USB2.0 | Connector:USB_C_Receptacle_USB2.0 |  | https://www.usb.org/sites/default/files/documents/usb_type-c.zip | J9
39 | 8 | J10, J11, J12, J13, J14, J15, J16, J17 | JST-SM | Connector:Conn_01x02_Female |  | ~ | J10, J11, J12, J13, J14, J15, J16, J17
40 | 3 | JP1, JP2, JP4 | SolderJumper | Jumper:SolderJumper_2_Open |  | ~ | JP1, JP2, JP4
41 | 2 | JP3, JP5 | SolderJumper_2_Open | Jumper:SolderJumper_2_Open |  | ~ | JP3, JP5
42 | 1 | L1 | 22uH | Device:L |  | ~ | L1
43 | 3 | L2, L3, L4 | 6.8uH | Device:L |  | ~ | L2, L3, L4
44 | 1 | L5 | 2.2uH | Device:L |  | ~ | L5
45 | 16 | L6, L7, L8, L9, L10, L11, L12, L13, L14, L15, L16, L17, L18, L19, L20, L21 | 3.3mH | Device:L |  | ~ | L6, L7, L8, L9, L10, L11, L12, L13, L14, L15, L16, L17, L18, L19, L20, L21
46 | 1 | Q1 | DNP, RZM001P02 | Device:Q_PMOS_GSD |  | ~ | Q1
47 | 17 | Q2, Q5, Q8, Q11, Q14, Q17, Q20, Q23, Q26, Q29, Q32, Q35, Q38, Q41, Q44, Q47, Q50 | RZM001P02 | Device:Q_PMOS_GSD |  | ~ | Q2, Q5, Q8, Q11, Q14, Q17, Q20, Q23, Q26, Q29, Q32, Q35, Q38, Q41, Q44, Q47, Q50
48 | 1 | Q3 | RQ3G100GN | el_components:RQ3G100GN |  | https://www.mouser.de/datasheet/2/348/rq3g100gntb-e-1873284.pdf | Q3
49 | 1 | Q4 | RK7002BMT116 | Device:Q_NMOS_DGS |  | ~ | Q4
50 | 16 | Q6, Q9, Q12, Q15, Q18, Q21, Q24, Q27, Q30, Q33, Q36, Q39, Q42, Q45, Q48, Q51 | Si7119DN | el_components:Si7119DN |  | https://www.mouser.de/datasheet/2/427/VISH_S_A0001142067_1-2567136.pdf | Q6, Q9, Q12, Q15, Q18, Q21, Q24, Q27, Q30, Q33, Q36, Q39, Q42, Q45, Q48, Q51
51 | 16 | Q7, Q10, Q13, Q16, Q19, Q22, Q25, Q28, Q31, Q34, Q37, Q40, Q43, Q46, Q49, Q52 | STN4NF20L | el_components:STN4NF20L |  | https://www.mouser.de/datasheet/2/389/cd00272247-1797117.pdf | Q7, Q10, Q13, Q16, Q19, Q22, Q25, Q28, Q31, Q34, Q37, Q40, Q43, Q46, Q49, Q52
52 | 20 | R1, R6, R11, R21, R46, R54, R62, R70, R78, R86, R94, R102, R110, R118, R126, R134, R142, R150, R158, R166 | 10k | Device:R |  | ~ | R1, R6, R11, R21, R46, R54, R62, R70, R78, R86, R94, R102, R110, R118, R126, R134, R142, R150, R158, R166
53 | 3 | R2, R7, R12 | 560 | Device:R |  | ~ | R2, R7, R12
54 | 3 | R3, R8, R13 | 1k2 | Device:R |  | ~ | R3, R8, R13
55 | 3 | R4, R9, R14 | 2k2 | Device:R |  | ~ | R4, R9, R14
56 | 3 | R5, R10, R15 | 4k7 | Device:R |  | ~ | R5, R10, R15
57 | 35 | R16, R17, R18, R49, R51, R57, R59, R65, R67, R73, R75, R81, R83, R89, R91, R97, R99, R105, R107, R113, R115, R121, R123, R129, R131, R137, R139, R145, R147, R153, R155, R161, R163, R169, R171 | 470 | Device:R |  | ~ | R16, R17, R18, R49, R51, R57, R59, R65, R67, R73, R75, R81, R83, R89, R91, R97, R99, R105, R107, R113, R115, R121, R123, R129, R131, R137, R139, R145, R147, R153, R155, R161, R163, R169, R171
58 | 19 | R19, R40, R41, R50, R58, R66, R74, R82, R90, R98, R106, R114, R122, R130, R138, R146, R154, R162, R170 | 1k | Device:R |  | ~ | R19, R40, R41, R50, R58, R66, R74, R82, R90, R98, R106, R114, R122, R130, R138, R146, R154, R162, R170
59 | 1 | R20 | DNP, 10k | Device:R |  | ~ | R20
 |  | R39 | 10meg | Device:R |  | ~ | R39
60 | 2 | R22 | 10meg | Device:R |  | ~ | R22
61 | 2 | R23, R24 | 22k 1% | Device:R |  | ~ | R23, R24
62 | 1 | R25 | 22 | Device:R |  | ~ | R25
63 | 2 | R26, R27 | 680 1% | Device:R |  | ~ | R26, R27
64 | 22 | R28, R31, R33, R34, R35, R36, R47, R55, R63, R71, R79, R87, R95, R103, R111, R119, R127, R135, R143, R151, R159, R167 | 0 | Device:R |  | ~ | R28, R31, R33, R34, R35, R36, R47, R55, R63, R71, R79, R87, R95, R103, R111, R119, R127, R135, R143, R151, R159, R167
65 | 1 | R29 | 220, 1/8W | Device:R |  | ~ | R29
66 | 4 | R30, R32, R44, R45 | 1meg | Device:R |  | ~ | R30, R32, R44, R45
67 | 1 | R37 | 16k | Device:R |  | ~ | R37
68 | 3 | R38, R174, R175 | 5.1k | Device:R |  | ~ | R38, R174, R175
69 | 1 | R42 | 10k, DNP | Device:R |  | ~ | R42
70 | 1 | R43 | 330 | Device:R |  | ~ | R43
71 | 32 | R48, R53, R56, R61, R64, R69, R72, R77, R80, R85, R88, R93, R96, R101, R104, R109, R112, R117, R120, R125, R128, R133, R136, R141, R144, R149, R152, R157, R160, R165, R168, R173 | 100, 1/4W | Device:R |  | ~ | R48, R53, R56, R61, R64, R69, R72, R77, R80, R85, R88, R93, R96, R101, R104, R109, R112, R117, R120, R125, R128, R133, R136, R141, R144, R149, R152, R157, R160, R165, R168, R173
72 | 16 | R52, R60, R68, R76, R84, R92, R100, R108, R116, R124, R132, R140, R148, R156, R164, R172 | 2.2k | Device:R |  | ~ | R52, R60, R68, R76, R84, R92, R100, R108, R116, R124, R132, R140, R148, R156, R164, R172
73 | 1 | SW1 | SW_DIP_x12 | Switch:SW_DIP_x12 |  | ~ | SW1
74 | 4 | SW2, SW3, SW4, SW5 | SW_Push | Switch:SW_Push |  | ~ | SW2, SW3, SW4, SW5
75 | 2 | T1, T2 | 750032050 | el_components:750032050 |  | ~ | T1, T2
76 | 33 | U1, U10, U11, U12, U13, U14, U15, U16, U17, U18, U19, U20, U21, U22, U23, U24, U25, U26, U27, U28, U29, U30, U31, U32, U33, U34, U35, U36, U37, U38, U39, U40, U41 | 6N137 | Isolator:6N137 | Package_DIP:DIP-8_W7.62mm | https://docs.broadcom.com/docs/AV02-0940EN | U1, U10, U11, U12, U13, U14, U15, U16, U17, U18, U19, U20, U21, U22, U23, U24, U25, U26, U27, U28, U29, U30, U31, U32, U33, U34, U35, U36, U37, U38, U39, U40, U41
77 | 1 | U2 | ATSAMD21J15B-M | MCU_Microchip_SAMD:ATSAMD21J15B-M | Package_DFN_QFN:QFN-64-1EP_9x9mm_P0.5mm_EP4.7x4.7mm | http://ww1.microchip.com/downloads/en/DeviceDoc/SAM_D21_DA1_Family_Data%20Sheet_DS40001882E.pdf | U2
78 | 1 | U3 | MP5000A | el_components:MP5000A |  | https://www.mouser.de/datasheet/2/277/MP5000A-1384322.pdf | U3
79 | 1 | U4 | 74ACT14 | 74xx:74HC14 |  | https://www.mouser.de/datasheet/2/308/1/MC74AC14_D-2315433.pdf | U4
80 | 3 | U5, U6, U7 | PDSE1-S5-S5-D | el_components:PDSE1-S5-S5-D |  | https://www.mouser.de/datasheet/2/670/pdse1_d-1774645.pdf | U5, U6, U7
81 | 1 | U8 | BD93291EFJ | el_components:BD93291EFJ |  | https://www.mouser.de/datasheet/2/348/bd93291efj-e-1874257.pdf | U8
82 | 1 | U9 | MAX485 | Interface_UART:MAX485E |  | https://datasheets.maximintegrated.com/en/ds/MAX1487-MAX491.pdf | U9
83 | 1 | Y1 | SSPT7F-7PF20-R | Device:Crystal_GND23 |  | ~ | Y1

Sheet: Legend
Arrived
In cart
Duplicate
Arrived, but not usable
In transit
Not ordered yet
