muvi/ELController/Ordering/Basket_Mar06_0542PM.xls

SHOPPING BASKET
This is not an invoice
06-Mar-22 17:42:04
 | Mouser No | Mfr. No | Manufacturer | Customer No | Description | RoHS | Lifecycle | Order Qty. | Price (EUR) | Ext.: (EUR)
1 | 80-C0603C104M3R | C0603C104M3RACTU | KEMET |  | Multilayer Ceramic Capacitors MLCC - SMD/SMT 25V 0.1uF X7R 0603 20% | RoHS Compliant |  | 100 | 0,022 € | 2,20 €
2 | 603-CC603KRNPO9BN150 | CC0603KRNPO9BN150 | YAGEO |  | Multilayer Ceramic Capacitors MLCC - SMD/SMT 50V 15pF C0G 0603 10% | RoHS Compliant |  | 20 | 0,027 € | 0,54 €
3 | 81-GRM32EC81C476KE5K | GRM32EC81C476KE15K | Murata |  | Multilayer Ceramic Capacitors MLCC - SMD/SMT 47UF 16V 10% 1210 | RoHS Compliant |  | 10 | 0,364 € | 3,64 €
4 | 581-1812VC105KAT2A | 1812VC105KAT2A | Kyocera AVX |  | Multilayer Ceramic Capacitors MLCC - SMD/SMT 250V 1uF X7R 1812 10% | RoHS Compliant |  | 10 | 0,595 € | 5,95 €
5 | 710-885012207051 | 885012207051 | Wurth Elektronik |  | Multilayer Ceramic Capacitors MLCC - SMD/SMT WCAP-CSGP 1uF 0805 10% 16V MLCC | RoHS Compliant |  | 30 | 0,069 € | 2,07 €
6 | 187-CL21A106KOCLRNC | CL21A106KOCLRNC | Samsung Electro-Mechanics |  | Multilayer Ceramic Capacitors MLCC - SMD/SMT 10uF+/-10% 16V X5R 2 0805 | RoHS Compliant | New At Mouser | 100 | 0,044 € | 4,40 €
7 | 80-C901U102MZWDBAP | C901U102MZWDBA7317 | KEMET |  | Safety Capacitors 440/300V 1000pF Y5U 20% LS=10mm | RoHS Compliant |  | 20 | 0,143 € | 2,86 €
8 | 187-CL21A226MQQNNNG | CL21A226MQQNNNG | Samsung Electro-Mechanics |  | Multilayer Ceramic Capacitors MLCC - SMD/SMT 22uF+/-20% 6.3V X5R 0805 | RoHS Compliant | New At Mouser | 20 | 0,066 € | 1,32 €
9 | 605-6R3R15X476MV4E | 6R3R15X476MV4E | Johanson |  | Multilayer Ceramic Capacitors MLCC - SMD/SMT 6.3volts 47uF 20% X5R | RoHS Compliant |  | 20 | 0,117 € | 2,34 €
10 | 80-C0603C681K5R | C0603C681K5RACTU | KEMET |  | Multilayer Ceramic Capacitors MLCC - SMD/SMT 50V 680pF X7R 0603 10% | RoHS Compliant |  | 10 | 0,027 € | 0,27 €
11 | 791-0603B472K250CT | 0603B472K250CT | Walsin |  | Multilayer Ceramic Capacitors MLCC - SMD/SMT 4700pF +-10% 25V | RoHS Compliant |  | 10 | 0,064 € | 0,64 €
12 | 710-150141YB73100 | 150141YB73100 | Wurth Elektronik |  | Standard LEDs - SMD WL-SBTW SMDBiClr Top Watrclr 3528Ylw&Blue | RoHS Compliant |  | 15 | 0,289 € | 4,34 €
13 | 583-FM4007W-W | FM4007W-W | Rectron |  | Rectifiers 1A, 1000V, SM | RoHS Compliant By Exemption |  | 25 | 0,041 € | 1,03 €
14 | 78-BZD27B180P-M3-08 | BZD27B180P-M3-08 | Vishay |  | Zener Diodes ZENER DIODE SMF AEC-Q101 Qualified | RoHS Compliant By Exemption |  | 10 | 0,317 € | 3,17 €
15 | 771-BZX8450-C1V8-QR | BZX8450-C1V8-QR | Nexperia |  | Zener Diodes BZX8450-C1V8-Q/SOT23/TO-236AB | RoHS Compliant | New Product | 10 | 0,129 € | 1,29 €
16 | 771-BZX84-C27T/R | BZX84-C27,215 | Nexperia |  | Zener Diodes DIODE ZENER 5 PCT TAPE-7 | RoHS Compliant |  | 10 | 0,134 € | 1,34 €
17 | 771-PMEG3050EP115 | PMEG3050EP,115 | Nexperia |  | Schottky Diodes & Rectifiers SCHOTTKY RECT 30V 5A | RoHS Compliant By Exemption |  | 10 | 0,412 € | 4,12 €
By submitting your order you agree to these terms and conditions. (https://eu.mouser.com/saleterms) |  |  |  |  |  |  |  |  | Merchandise: | 41,52 €
Prices are reflected at the date and time shown. |  |  |  |  |  |  |  |  | Delivery Charge: | 20,00 €
