muvi/ELController/Ordering/Digikey 2022-03-07T173425.xlsx

Index | Menge | Teilenummer | Hersteller-Teilenummer | Beschreibung | Kundenreferenz | Verfügbar | Lieferrückstände | Stückpreis | Gesamtpreis EUR
1 | 15 | 102-PDP1-S5-S5-M-ND | PDP1-S5-S5-M | DC DC CONVERTER 5V 1W |  | 15 | 0 | 256100 | 3842
2 | 10 | MAX485ECSA+TCT-ND | MAX485ECSA+T | IC TRANSCEIVER HALF 1/1 8SOIC |  | 10 | 0 | 396200 | 3962
3 | 6 | 2223-DS04-254-2-12BK-SMT-ND | DS04-254-2-12BK-SMT | DIP SWITCH, SPST, 2.54 PITCH, FL |  | 6 | 0 | 125000 | 750
