muvi/ELController/Ordering/Digikey 2022-03-08T170843.xlsx

Index | Quantity | Part Number | Manufacturer Part Number | Description | Customer Reference | Available | Backorder | Unit Price | Extended Price EUR
1 | 15 | 102-PDP1-S5-S5-M-ND | PDP1-S5-S5-M | DC DC CONVERTER 5V 1W |  | 15 | 0 | 256100 | 3842
2 | 10 | MAX485ECSA+TCT-ND | MAX485ECSA+T | IC TRANSCEIVER HALF 1/1 8SOIC |  | 10 | 0 | 396200 | 3962
3 | 6 | 2223-DS04-254-2-12BK-SMT-ND | DS04-254-2-12BK-SMT | DIP SWITCH, SPST, 2.54 PITCH, FL |  | 6 | 0 | 125000 | 750
4 | 10 | 839-54-00164CT-ND | 54-00164 | CONN JACK R/A SMT 5.5X2.1MM |  | 10 | 0 | 58800 | 588
5 | 10 | 1175-1627-ND | 3220-10-0100-00 | CONN HEADER VERT 10POS 1.27MM |  | 10 | 0 | 51300 | 513
