muvi/ELController/Ordering/important to order.xls

WARENKORB:3/6/2022 14:53:38
Mouser-Nr. | Herst.- Nr. | Hersteller | Kunden-Teilenr | Beschreibung | RoHS | Lebenszyklus | Stückzahl | Preis (EUR) | Gesamtpreis: (EUR)
523-AC3MAH-AU-PRE | AC3MAH-AU-PRE | Amphenol |  | XLR-Anschlüsse 3 PIN PLASTIC PANEL MOUNT PCB | RoHS-konform |  | 5 | 0,755 € | 3,78 €
523-AC3FAH2-AU-PRE | AC3FAH2-AU-PRE | Amphenol |  | XLR-Anschlüsse 3 SKT PLASTIC PANEL MOUNT PCB | RoHS-konform |  | 5 | 0,783 € | 3,92 €
241-BAT54A_R1_00001 | BAT54A_R1_00001 | Panjit |  | Schottky Dioden & Gleichrichter SURFACE MOUNT SCHOTTKY BARRIER | RoHS-konform | Neu bei Mouser | 10 | 0,142 € | 1,42 €
710-750032050 | 750032050 | Wurth Elektronik |  | Netztransformatoren WE-FB Flyback 10.0uH 1KVAC | RoHS-konform |  | 12 | 4,34 € | 52,08 €
556-ATSAMD21J15B-MFT | ATSAMD21J15B-MFT | Microchip |  | ARM Mikrocontroller - MCU 64QFN,125C TEMP, GREEN, 3.3V, 48MHZ, T&R | RoHS-konform |  | 25 | 2,35 € | 58,75 €
946-MP5000ADQ-LF-Z | MP5000ADQ-LF-Z | Monolithic Power Systems (MPS) |  | Hot Swap-Spannungscontroller 12V,5A Programmable Current Limit Switch | RoHS-konform |  | 10 | 1,20 € | 12,00 €
755-BD93291EFJ-E2 | BD93291EFJ-E2 | ROHM Semiconductor |  | Schaltspannungsregler IC Pwr Swtch Reg Multi Output | RoHS-konform |  | 10 | 0,888 € | 8,88 €
810-MMZ1608Y221BTD25 | MMZ1608Y221BTD25 | TDK |  | Ferritperlen 0603 220ohms 500mA Signal Line AEC-Q200 | RoHS-konform |  | 20 | 0,068 € | 1,36 €
