muvi/ELController/Ordering/Mouser Warenkorb_Mrz14_0347.xls

WARENKORB:3/6/2022 14:53:38
Mouser-Nr. | Herst.- Nr. | Hersteller | Kunden-Teilenr | Beschreibung | RoHS | Lebenszyklus | Stückzahl | Preis (EUR) | Gesamtpreis: (EUR)
80-C0603C104M3R | C0603C104M3RACTU | KEMET |  | Kondensator aus mehreren Keramikschichten MLCC - SMD/SMT 25V 0.1uF X7R 0603 20% | RoHS-konform |  | 100 | 0,043 € | 4,30 €
603-CC603KRNPO9BN150 | CC0603KRNPO9BN150 | YAGEO |  | Kondensator aus mehreren Keramikschichten MLCC - SMD/SMT 50V 15pF C0G 0603 10% | RoHS-konform |  | 20 | 0,028 € | 0,56 €
81-GRM32EC81C476KE5K | GRM32EC81C476KE15K | Murata |  | Kondensator aus mehreren Keramikschichten MLCC - SMD/SMT 47UF 16V 10% 1210 | RoHS-konform |  | 10 | 0,379 € | 3,79 €
581-1812VC105KAT2A | 1812VC105KAT2A | Kyocera AVX |  | Kondensator aus mehreren Keramikschichten MLCC - SMD/SMT 250V 1uF X7R 1812 10% | RoHS-konform |  | 10 | 0,619 € | 6,19 €
710-885012207051 | 885012207051 | Wurth Elektronik |  | Kondensator aus mehreren Keramikschichten MLCC - SMD/SMT WCAP-CSGP 1uF 0805 10% 16V MLCC | RoHS-konform |  | 30 | 0,072 € | 2,16 €
187-CL21A106KOCLRNC | CL21A106KOCLRNC | Samsung Electro-Mechanics |  | Kondensator aus mehreren Keramikschichten MLCC - SMD/SMT 10uF+/-10% 16V X5R 2 0805 | RoHS-konform | Neu bei Mouser | 100 | 0,046 € | 4,60 €
80-C901U102MZWDBAP | C901U102MZWDBA7317 | KEMET |  | Sicherheitskondensatoren 440/300V 1000pF Y5U 20% LS=10mm | RoHS-konform |  | 20 | 0,148 € | 2,96 €
187-CL21A226MQQNNNG | CL21A226MQQNNNG | Samsung Electro-Mechanics |  | Kondensator aus mehreren Keramikschichten MLCC - SMD/SMT 22uF+/-20% 6.3V X5R 0805 | RoHS-konform | Neu bei Mouser | 20 | 0,068 € | 1,36 €
605-6R3R15X476MV4E | 6R3R15X476MV4E | Johanson |  | Kondensator aus mehreren Keramikschichten MLCC - SMD/SMT 6.3volts 47uF 20% X5R | RoHS-konform |  | 20 | 1,25 € | 25,00 €
80-C0603C681K5R | C0603C681K5RACTU | KEMET |  | Kondensator aus mehreren Keramikschichten MLCC - SMD/SMT 50V 680pF X7R 0603 10% | RoHS-konform |  | 10 | 0,028 € | 0,28 €
791-0603B472K250CT | 0603B472K250CT | Walsin |  | Kondensator aus mehreren Keramikschichten MLCC - SMD/SMT 4700pF +-10% 25V | RoHS-konform |  | 10 | 0,064 € | 0,64 €
710-150141YB73100 | 150141YB73100 | Wurth Elektronik |  | Standard-LEDs - SMD WL-SBTW SMDBiClr Top Watrclr 3528Ylw&Blue | RoHS-konform |  | 15 | 0,30 € | 4,50 €
583-FM4007W-W | FM4007W-W | Rectron |  | Gleichrichter 1A, 1000V, SM | RoHS: Konform durch Ausnahmegenehmigung |  | 25 | 0,041 € | 1,03 €
78-BZD27B180P-M3-08 | BZD27B180P-M3-08 | Vishay |  | Zener-Dioden ZENER DIODE SMF AEC-Q101 Qualified | RoHS: Konform durch Ausnahmegenehmigung |  | 10 | 0,329 € | 3,29 €
771-BZX8450-C1V8-QR | BZX8450-C1V8-QR | Nexperia |  | Zener-Dioden BZX8450-C1V8-Q/SOT23/TO-236AB | RoHS-konform | Neues Produkt | 10 | 0,134 € | 1,34 €
771-BZX84-C27T/R | BZX84-C27,215 | Nexperia |  | Zener-Dioden DIODE ZENER 5 PCT TAPE-7 | RoHS-konform |  | 10 | 0,139 € | 1,39 €
771-PMEG3050EP115 | PMEG3050EP,115 | Nexperia |  | Schottky Dioden & Gleichrichter SCHOTTKY RECT 30V 5A | RoHS: Konform durch Ausnahmegenehmigung |  | 10 | 0,429 € | 4,29 €
523-AC3MAH-AU-PRE | AC3MAH-AU-PRE | Amphenol |  | XLR-Anschlüsse 3 PIN PLASTIC PANEL MOUNT PCB | RoHS-konform |  | 5 | 0,755 € | 3,78 €
523-AC3FAH2-AU-PRE | AC3FAH2-AU-PRE | Amphenol |  | XLR-Anschlüsse 3 SKT PLASTIC PANEL MOUNT PCB | RoHS-konform |  | 5 | 0,783 € | 3,92 €
241-BAT54A_R1_00001 | BAT54A_R1_00001 | Panjit |  | Schottky Dioden & Gleichrichter SURFACE MOUNT SCHOTTKY BARRIER | RoHS-konform | Neu bei Mouser | 10 | 0,142 € | 1,42 €
583-ZMM5226B | ZMM5226B | Rectron |  | Zener-Dioden 0.5W 3.3V 5% | RoHS: Konform durch Ausnahmegenehmigung |  | 25 | 0,07 € | 1,75 €
771-PRTR5V0U2X-T/R | PRTR5V0U2X,215 | Nexperia |  | ESD-Entstörer/TVS-Dioden 5.5V DUAL R-R ESD ULTRA LOW CAP | RoHS-konform |  | 10 | 0,408 € | 4,08 €
667-ERB-RE5R00V | ERB-RE5R00V | Panasonic |  | Sicherungen zur Aufbaumontage 5A 0603 micro chip | RoHS-konform |  | 10 | 0,211 € | 2,11 €
649-10118192-0002LF | 10118192-0002LF | FCI / Amphenol |  | USB-Stecker MICRO USB B-TYPE | RoHS-konform |  | 10 | 0,322 € | 3,22 €
710-750032050 | 750032050 | Wurth Elektronik |  | Netztransformatoren WE-FB Flyback 10.0uH 1KVAC | RoHS-konform |  | 12 | 4,34 € | 52,08 €
556-ATSAMD21J15B-MFT | ATSAMD21J15B-MFT | Microchip |  | ARM Mikrocontroller - MCU 64QFN,125C TEMP, GREEN, 3.3V, 48MHZ, T&R | RoHS-konform |  | 25 | 2,35 € | 58,75 €
946-MP5000ADQ-LF-Z | MP5000ADQ-LF-Z | Monolithic Power Systems (MPS) |  | Hot Swap-Spannungscontroller 12V,5A Programmable Current Limit Switch | RoHS-konform |  | 10 | 1,20 € | 12,00 €
755-BD93291EFJ-E2 | BD93291EFJ-E2 | ROHM Semiconductor |  | Schaltspannungsregler IC Pwr Swtch Reg Multi Output | RoHS-konform |  | 10 | 0,888 € | 8,88 €
755-RK7002BMT116 | RK7002BMT116 | ROHM Semiconductor |  | MOSFET 2.5V Drive Nch MOSFET | RoHS: Konform durch Ausnahmegenehmigung |  | 30 | 0,136 € | 4,08 €
755-RQ3E100BNTB | RQ3E100BNTB | ROHM Semiconductor |  | MOSFET 4.5V Drive Nch MOSFET | RoHS: Konform durch Ausnahmegenehmigung |  | 15 | 0,306 € | 4,59 €
512-FQD4P25TM_WS | FQD4P25TM-WS | onsemi |  | MOSFET 250V 3.1A 2.1Ohm P-Channel | RoHS-konform |  | 100 | 0,658 € | 65,80 €
810-MMZ1608Y221BTD25 | MMZ1608Y221BTD25 | TDK |  | Ferritperlen 0603 220ohms 500mA Signal Line AEC-Q200 | RoHS-konform |  | 20 | 0,068 € | 1,36 €
859-LTV-247 | LTV-247 | Lite-On |  | Transistor-Ausgangsoptokoppler PTR 50% 5KV 16 PIN 4CH Optocoupler | RoHS-konform |  | 50 | 0,74 € | 37,00 €
260-1.0M-RC | 260-1.0M-RC | Xicon |  | Dickfilmwiderstände - SMD 1/8WATT 1MOHMS 5% | RoHS: Konform durch Ausnahmegenehmigung |  | 5000 | 0,002 € | 10,00 €
851-RCH8011NP-221L | RCH8011NP-221L | Sumida |  | Festinduktivitäten 220uH 0.95A 15% THRU HOLE INDUCTOR | RoHS-konform |  | 100 | 0,269 € | 26,90 €
