muvi/ELController/Inventory Management/fill supply/2022-04-10 BOM grouped.xlsx

Sheet: Items
Item | Qty | Minimum Amount | Amount Arrived/Ordered | Duplicate of | Reference(s) | Value | Supplier part number |  | LibPart | Footprint | Datasheet | Vendor part | cost | sum payed | sum ordered | vendor | (value, vendor, vendor_part, manufacturer_part, cost, sum_ordered)
3 | 2 | 10 | 20 |  | C7, C8 | 9.1pF | 0603N9R1C500CT | #N/A | Device:C |  | ~ | 791-0603N9R1C500CT | 0.053 | 1.06 | 20 | mouser | ("9.1pF", "mouser", "791-0603N9R1C500CT", "0603N9R1C500CT", 0.053, 20),
8 | 4 | 20 | 30 |  | C21, C39, C40, C41 | 1nF Y2 | C901U102MZWDBA7317 | C901U102MZWDBA7317 | Device:C |  | ~ | 80-C901U102MZWDBAP | 0.148 | 4.44 | 30 | mouser | ("1nF Y2", "mouser", "80-C901U102MZWDBAP", "C901U102MZWDBA7317", 0.148, 30),
9 | 2 | 10 | 20 |  | C25, C37 | 22uF | CL21A226MOQNNNE | CL21A226MOQNNNE | Device:C |  | ~ | 187-CL21A226MOQNNNE | 0.127 | 2.54 | 20 | mouser | ("22uF", "mouser", "187-CL21A226MOQNNNE", "CL21A226MOQNNNE", 0.127, 20),
10 | 6 | 30 | 40 |  | C26, C27, C29, C30, C32, C33 | 4.7uF | CL21A475KAQNNNF | CL21A475KAQNNNF | Device:C_Polarized |  | ~ | 187-CL21A475KAQNNNF | 0.074 | 2.96 | 40 | mouser | ("4.7uF", "mouser", "187-CL21A475KAQNNNF", "CL21A475KAQNNNF", 0.074, 40),
11 | 1 | 5 | 10 |  | C36 | 680pF | 885012206033 | #N/A | Device:C |  | ~ | 710-885012206033 | 0.02 | 0.2 | 10 | mouser | ("680pF", "mouser", "710-885012206033", "885012206033", 0.02, 10),
13 | 1 | 5 | 10 |  | C44 | 4.7nF | 885012206087 | #N/A | Device:C |  | ~ | 710-885012206087 | 0.017 | 0.17 | 10 | mouser | ("4.7nF", "mouser", "710-885012206087", "885012206087", 0.017, 10),
15 | 1 | 5 | 10 |  | D2 | FM4007W | FM4007W-W | FM4007W-W | Device:D |  | https://www.mouser.de/datasheet/2/345/fm4001w_fm4007w-1396243.pdf | 583-FM4007W-W | 0.14 | 1.4 | 10 | mouser | ("FM4007W", "mouser", "583-FM4007W-W", "FM4007W-W", 0.14, 10),
17 | 2 | 10 | 15 |  | D4, D5 | 1V8 | BZX8450-C1V8-QR | BZX8450-C1V8-QR | el_components:BZX8450-C1V8-QR |  | ~ | 771-BZX8450-C1V8-QR | 0.134 | 2.01 | 15 | mouser | ("1V8", "mouser", "771-BZX8450-C1V8-QR", "BZX8450-C1V8-QR", 0.134, 15),
18 | 1 | 5 | 10 |  | D6 | 36V | MM3Z36VT1G | MM3Z36VT1G | Device:D_Zener |  | ~ | 863-MM3Z36VT1G | 0.127 | 1.27 | 10 | mouser | ("36V", "mouser", "863-MM3Z36VT1G", "MM3Z36VT1G", 0.127, 10),
19 | 1 | 5 | 10 |  | D7 | PMEG3050EP,115 | PMEG3050EP,115 | PMEG3050EP,115 | Device:D_Schottky |  | ~ | 771-PMEG3050EP115 | 0.438 | 4.38 | 10 | mouser | ("PMEG3050EP,115", "mouser", "771-PMEG3050EP115", "PMEG3050EP,115", 0.438, 10),
20 | 1 | 5 | 10 |  | D8 | PTVS13VS1UTR,115 | PTVS13VS1UTR,115 | PTVS13VS1UTR,115 | el_components:DESD1CAN2WQ-7 |  | https://www.mouser.de/datasheet/2/916/PTVSXS1UTR_SER-1600409.pdf | 771-PTVS13VS1UTR115 | 0.109 | 1.09 | 10 | mouser | ("PTVS13VS1UTR,115", "mouser", "771-PTVS13VS1UTR115", "PTVS13VS1UTR,115", 0.109, 10),
21 | 1 | 5 | 10 |  | D9 | BAT54A_R1_00001 | BAT54A_R1_00001 | BAT54A_R1_00001 | Diode:BAT54AW | Package_TO_SOT_SMD:SOT-323_SC-70 | https://www.mouser.de/datasheet/2/1057/BAT54_SERIES-1869048.pdf | 241-BAT54A_R1_00001 | 0.142 | 1.42 | 10 | mouser | ("BAT54A_R1_00001", "mouser", "241-BAT54A_R1_00001", "BAT54A_R1_00001", 0.142, 10),
22 | 1 | 5 | 10 |  | D10 | 3V3 | ZMM5226B | ZMM5226B | Diode:ZMMxx | Diode_SMD:D_MiniMELF | https://diotec.com/tl_files/diotec/files/pdf/datasheets/zmm1.pdf | 583-ZMM5226B | 0.108 | 1.08 | 10 | mouser | ("3V3", "mouser", "583-ZMM5226B", "ZMM5226B", 0.108, 10),
23 | 3 | 15 | 20 |  | D11, D12, D13 | SMAJ6.0A-W | SMAJ6.0A-W | SMAJ6.0A-W | Device:D_TVS |  | ~ | 583-SMAJ6.0A-W | 0.108 | 2.16 | 20 | mouser | ("SMAJ6.0A-W", "mouser", "583-SMAJ6.0A-W", "SMAJ6.0A-W", 0.108, 20),
24 | 2 | 10 | 15 |  | D14, D15 | PRTR5V0U2X | PRTR5V0U2X,215 | PRTR5V0U2X,215 | Power_Protection:PRTR5V0U2X | Package_TO_SOT_SMD:SOT-143 | https://assets.nexperia.com/documents/data-sheet/PRTR5V0U2X.pdf | 771-PRTR5V0U2X-T/R | 0.407 | 6.105 | 15 | mouser | ("PRTR5V0U2X", "mouser", "771-PRTR5V0U2X-T/R", "PRTR5V0U2X,215", 0.407, 15),
25 | 1 | 5 | 20 |  | F1 | F 5A 32V | ERB-RE5R00V | ERB-RE5R00V | Device:Fuse |  | https://www.mouser.de/datasheet/2/315/AFA0000C7-1025982.pdf | 667-ERB-RE5R00V | 0.211 | 4.22 | 20 | mouser | ("F 5A 32V", "mouser", "667-ERB-RE5R00V", "ERB-RE5R00V", 0.211, 20),
26 | 2 | 10 | 20 |  | FB1, FB2 | 220@100MHz | MMZ1608Y221BTD25 | #N/A | Device:FerriteBead |  | ~ | 810-MMZ1608Y221BTD25 | 0.068 | 1.36 | 20 | mouser | ("220@100MHz", "mouser", "810-MMZ1608Y221BTD25", "MMZ1608Y221BTD25", 0.068, 20),
29 | 1 | 5 | 10 |  | J2 | Barrel jack 5.5x2.1mm | 54-00164 | #N/A | Connector:Barrel_Jack_Switch |  | ~ | 839-54-00164CT-ND | 0.588 | 5.88 | 10 | digikey | ("Barrel jack 5.5x2.1mm", "digikey", "839-54-00164CT-ND", "54-00164", 0.588, 10),
30 | 1 | 5 | 10 |  | J3 | JTAG 10 pin | 3220-10-0100-00 | #N/A | Connector_Generic:Conn_02x05_Odd_Even |  | http://www.cnctech.us/pdfs/3220-XX-0100-00_.pdf | 1175-1627-ND | 0.513 | 5.13 | 10 | digikey | ("JTAG 10 pin", "digikey", "1175-1627-ND", "3220-10-0100-00", 0.513, 10),
31 | 1 | 5 | 5 |  | J4 | NC3FAH2 | AC3FAH2-AU-PRE | #N/A | Connector:XLR3 |  | ~ | 523-AC3FAH2-AU-PRE | 0.783 | 3.915 | 5 | mouser | ("NC3FAH2", "mouser", "523-AC3FAH2-AU-PRE", "AC3FAH2-AU-PRE", 0.783, 5),
32 | 1 | 5 | 5 |  | J5 | NC3MAH-0 | AC3MAH-AU-PRE | #N/A | Connector:XLR3 |  | ~ | 523-AC3MAH-AU-PRE | 0.755 | 3.775 | 5 | mouser | ("NC3MAH-0", "mouser", "523-AC3MAH-AU-PRE", "AC3MAH-AU-PRE", 0.755, 5),
36 | 1 | 5 | 11 |  | J9 | USB C (USB 2.0) | USB4510-03-1-A | USB4510-03-1-A | Connector:USB_B_Micro |  | ~ | 640-USB4510031A | 0.574 | 5.74 | 10 | mouser | ("USB C (USB 2.0)", "mouser", "640-USB4510031A", "USB4510-03-1-A", 0.574, 10),
40 | 1 | 5 | 10 |  | L1 | 22uH | 7447706220 | #N/A | Device:L |  | ~ | 710-7447706220 | 0.983 | 9.83 | 10 | mouser | ("22uH", "mouser", "710-7447706220", "7447706220", 0.983, 10),
41 | 3 | 15 | 20 |  | L2, L3, L4 | 6.8uH | LBC3225T6R8MR | LBC3225T6R8MR | Device:L |  | ~ | 963-LBC3225T6R8MR | 0.122 | 2.44 | 20 | mouser | ("6.8uH", "mouser", "963-LBC3225T6R8MR", "LBC3225T6R8MR", 0.122, 20),
42 | 1 | 5 | 10 |  | L5 | 2.2uH | TFM201610ALVA2R2MTAA | TFM201610ALVA2R2MTAA | Device:L |  | ~ | 810-TFM201610ALVA2R2 | 0.549 | 5.49 | 10 | mouser | ("2.2uH", "mouser", "810-TFM201610ALVA2R2", "TFM201610ALVA2R2MTAA", 0.549, 10),
43 | 16 | 80 | 100 |  | L6, L7, L8, L9, L10, L11, L12, L13, L14, L15, L16, L17, L18, L19, L20, L21 | 3.3mH | RFS1317-335KL | #N/A | Device:L |  | ~ | 994-RFS1317-335KL | 1.18 | 118 | 100 | mouser | ("3.3mH", "mouser", "994-RFS1317-335KL", "RFS1317-335KL", 1.18, 100),
45 | 17 | #REF! | 100 |  | Q2, Q5, Q8, Q11, Q14, Q17, Q20, Q23, Q26, Q29, Q32, Q35, Q38, Q41, Q44, Q47, Q50 | RZM001P02 | RZM001P02T2L | #N/A | Device:Q_PMOS_GSD |  | ~ | 755-RZM001P02T2L | 0.096 | 9.6 | 100 | mouser | ("RZM001P02", "mouser", "755-RZM001P02T2L", "RZM001P02T2L", 0.096, 100),
46 | 1 | 5 | 10 |  | Q3 | RQ3G100GN | RQ3G100GNTB | RQ3G100GNTB | el_components:RQ3G100GN |  | https://www.mouser.de/datasheet/2/348/rq3g100gntb-e-1873284.pdf | 755-RQ3G100GNTB | 0.383 | 3.83 | 10 | mouser | ("RQ3G100GN", "mouser", "755-RQ3G100GNTB", "RQ3G100GNTB", 0.383, 10),
47 | 1 | 5 | 10 |  | Q4 | RK7002BMT116 | RK7002BMT116 | RK7002BMT116 | Device:Q_NMOS_DGS |  | ~ | 755-RK7002BMT116 | 0.17 | 1.7 | 10 | mouser | ("RK7002BMT116", "mouser", "755-RK7002BMT116", "RK7002BMT116", 0.17, 10),
48 | 16 | 80 | 100 |  | Q6, Q9, Q12, Q15, Q18, Q21, Q24, Q27, Q30, Q33, Q36, Q39, Q42, Q45, Q48, Q51 | Si7119DN | SI7119DN-T1-E3 | #N/A | el_components:Si7119DN |  | https://www.mouser.de/datasheet/2/427/VISH_S_A0001142067_1-2567136.pdf | 781-SI7119DN-T1-E3 | 0.697 | 69.7 | 100 | mouser | ("Si7119DN", "mouser", "781-SI7119DN-T1-E3", "SI7119DN-T1-E3", 0.697, 100),
49 | 16 | 80 | 100 |  | Q7, Q10, Q13, Q16, Q19, Q22, Q25, Q28, Q31, Q34, Q37, Q40, Q43, Q46, Q49, Q52 | STN4NF20L | STN4NF20L | #N/A | el_components:STN4NF20L |  | https://www.mouser.de/datasheet/2/389/cd00272247-1797117.pdf | 511-STN4NF20L | 0.556 | 55.6 | 100 | mouser | ("STN4NF20L", "mouser", "511-STN4NF20L", "STN4NF20L", 0.556, 100),
50 | 20 | #REF! | 200 |  | R1, R6, R11, R21, R46, R54, R62, R70, R78, R86, R94, R102, R110, R118, R126, R134, R142, R150, R158, R166 | 10k | RC0603JR-0710KL | RC0603JR-0710KL | Device:R |  | ~ | 603-RC0603JR-0710KL | 0.005 | 1 | 200 | mouser | ("10k", "mouser", "603-RC0603JR-0710KL", "RC0603JR-0710KL", 0.005, 200),
51 | 3 | 15 | 30 |  | R2, R7, R12 | 560 | RC0603JR-07560RL | RC0603JR-07560RL | Device:R |  | ~ | 603-RC0603JR-07560RL | 0.013 | 0.39 | 30 | mouser | ("560", "mouser", "603-RC0603JR-07560RL", "RC0603JR-07560RL", 0.013, 30),
52 | 3 | 15 | 30 |  | R3, R8, R13 | 1.2k | RMC1/16-122JTP | RMC1/16-122JTP | Device:R |  | ~ | 791-RMC1/16-122JTP | 0.013 | 0.39 | 30 | mouser | ("1.2k", "mouser", "791-RMC1/16-122JTP", "RMC1/16-122JTP", 0.013, 30),
53 | 3 | 15 | 30 |  | R4, R9, R14 | 2.2k | RC0603FR-072K2L | RC0603FR-072K2L | Device:R |  | ~ | 603-RC0603FR-072K2L | 0.015 | 0.45 | 30 | mouser | ("2.2k", "mouser", "603-RC0603FR-072K2L", "RC0603FR-072K2L", 0.015, 30),
54 | 3 | 15 | 30 |  | R5, R10, R15 | 4.7k | RMC1/16-472JTP | RMC1/16-472JTP | Device:R |  | ~ | 791-RMC1/16-472JTP | 0.013 | 0.39 | 30 | mouser | ("4.7k", "mouser", "791-RMC1/16-472JTP", "RMC1/16-472JTP", 0.013, 30),
55 | 35 | 175 | 200 |  | R16, R17, R18, R49, R51, R57, R59, R65, R67, R73, R75, R81, R83, R89, R91, R97, R99, R105, R107, R113, R115, R121, R123, R129, R131, R137, R139, R145, R147, R153, R155, R161, R163, R169, R171 | 510 | RC0603JR-07510RL | RC0603JR-07510RL | Device:R |  | ~ | 603-RC0603JR-07510RL | 0.005 | 1 | 200 | mouser | ("510", "mouser", "603-RC0603JR-07510RL", "RC0603JR-07510RL", 0.005, 200),
56 | 19 | 95 | 125 |  | R19, R40, R41, R50, R58, R66, R74, R82, R90, R98, R106, R114, R122, R130, R138, R146, R154, R162, R170 | 1k | RC0603FR-071KL | RC0603FR-071KL | Device:R |  | ~ | 603-RC0603FR-071KL | 0.006 | 0.75 | 125 | mouser | ("1k", "mouser", "603-RC0603FR-071KL", "RC0603FR-071KL", 0.006, 125),
58 | 1 | 5 | 20 |  | R22 | 10meg 200V | MR12W1005FTL | #N/A | Device:R |  | ~ | 791-MR12W1005FTL | 0.083 | 1.66 | 20 | mouser | ("10meg 200V", "mouser", "791-MR12W1005FTL", "MR12W1005FTL", 0.083, 20),
59 | 2 | 10 | 25 |  | R23, R24 | 22k 1% | CR0603-FX-2202ELF | CR0603-FX-2202ELF | Device:R |  | ~ | 652-CR0603FX-2202ELF | 0.014 | 0.35 | 25 | mouser | ("22k 1%", "mouser", "652-CR0603FX-2202ELF", "CR0603-FX-2202ELF", 0.014, 25),
60 | 1 | 5 | 10 |  | R25 | 22 | 301-22-RC | 301-22-RC | Device:R |  | ~ | 301-22-RC | 0.011 | 0.11 | 10 | mouser | ("22", "mouser", "301-22-RC", "301-22-RC", 0.011, 10),
61 | 2 | 10 | 25 |  | R26, R27 | 680 1% | CR0603-FX-6800ELF | CR0603-FX-6800ELF | Device:R |  | ~ | 652-CR0603FX-6800ELF | 0.015 | 0.375 | 25 | mouser | ("680 1%", "mouser", "652-CR0603FX-6800ELF", "CR0603-FX-6800ELF", 0.015, 25),
62 | 22 | 110 | 125 |  | R28, R31, R33, R34, R35, R36, R47, R55, R63, R71, R79, R87, R95, R103, R111, R119, R127, R135, R143, R151, R159, R167 | 0 | CR0603-J/-000ELF | CR0603-J/-000ELF | Device:R |  | ~ | 652-CR0603-J/-000ELF | 0.005 | 0.625 | 125 | mouser | ("0", "mouser", "652-CR0603-J/-000ELF", "CR0603-J/-000ELF", 0.005, 125),
63 | 1 | 5 | 10 |  | R29 | 220 1/8W | RK73B1JTTDD221J | RK73B1JTTDD221J | Device:R |  | ~ | 660-RK73B1JTTDD221J | 0.019 | 0.19 | 10 | mouser | ("220 1/8W", "mouser", "660-RK73B1JTTDD221J", "RK73B1JTTDD221J", 0.019, 10),
64 | 4 | 20 | 30 |  | R30, R32, R44, R45 | 1meg | RC0603JR-131ML | RC0603JR-131ML | Device:R |  | ~ | 603-RC0603JR-131ML | 0.013 | 0.39 | 30 | mouser | ("1meg", "mouser", "603-RC0603JR-131ML", "RC0603JR-131ML", 0.013, 30),
65 | 1 | 5 | 10 |  | R37 | 16k | RMC16K163FTP | RMC16K163FTP | Device:R |  | ~ | 791-RMC16K163FTP | 0.016 | 0.16 | 10 | mouser | ("16k", "mouser", "791-RMC16K163FTP", "RMC16K163FTP", 0.016, 10),
66 | 3 | 15 | 20 |  | R38, R174, R175 | 5.1k | WR06X512 JTL | WR06X512 JTL | Device:R |  | ~ | 791-WR06X512JTL | 0.013 | 0.26 | 20 | mouser | ("5.1k", "mouser", "791-WR06X512JTL", "WR06X512 JTL", 0.013, 20),
67 | 1 | 5 | 15 |  | R39 | 10meg | RC0603JR-0710ML | RC0603JR-0710ML | Device:R |  | ~ | 603-RC0603JR-0710ML | 0.013 | 0.195 | 15 | mouser | ("10meg", "mouser", "603-RC0603JR-0710ML", "RC0603JR-0710ML", 0.013, 15),
69 | 1 | 5 | 10 |  | R43 | 330 | CR0603-JW-331ELF | CR0603-JW-331ELF | Device:R |  | ~ | 652-CR0603-JW-331ELF | 0.007 | 0.07 | 10 | mouser | ("330", "mouser", "652-CR0603-JW-331ELF", "CR0603-JW-331ELF", 0.007, 10),
70 | 32 | 160 | 200 |  | R48, R53, R56, R61, R64, R69, R72, R77, R80, R85, R88, R93, R96, R101, R104, R109, R112, R117, R120, R125, R128, R133, R136, R141, R144, R149, R152, R157, R160, R165, R168, R173 | 100 1/4W | RC0805FR-13100RL | RC0805FR-13100RL | Device:R |  | ~ | 603-RC0805FR-13100RL | 0.011 | 2.2 | 200 | mouser | ("100 1/4W", "mouser", "603-RC0805FR-13100RL", "RC0805FR-13100RL", 0.011, 200),
71 | 16 | 80 | 100 | 53 | R52, R60, R68, R76, R84, R92, R100, R108, R116, R124, R132, R140, R148, R156, R164, R172 | 2.2k | 301-2.2K-RC | 301-2.2K-RC | Device:R |  | ~ | 301-2.2K-RC | 0.004 | 0.4 | 100 | mouser | ("2.2k", "mouser", "301-2.2K-RC", "301-2.2K-RC", 0.004, 100),
72 | 1 | 5 | (8) + 6 |  | SW1 | DIP 12 | DS01C-254-S-12BE | DS01C-254-S-12BE | Switch:SW_DIP_x12 |  | ~ | 490-DS01C-254-S-12BE | 0.974 | 5.844 | 6 | mouser | ("DIP 12", "mouser", "490-DS01C-254-S-12BE", "DS01C-254-S-12BE", 0.974, 6),
73 | 4 | 20 | 25 |  | SW2, SW3, SW4, SW5 | Pushbutton | MJTP1230 | MJTP1230 | Switch:SW_Push |  | ~ | 642-MJTP1230 | 0.074 | 1.85 | 25 | mouser | ("Pushbutton", "mouser", "642-MJTP1230", "MJTP1230", 0.074, 25),
74 | 2 | 10 | 16 |  | T1, T2 | 750032050 | 750032050 | #N/A | el_components:750032050 |  | ~ | 710-750032050 | 4.34 | 69.44 | 16 | mouser | ("750032050", "mouser", "710-750032050", "750032050", 4.34, 16),
75 | 33 | 165 | 200 |  | U1, U10, U11, U12, U13, U14, U15, U16, U17, U18, U19, U20, U21, U22, U23, U24, U25, U26, U27, U28, U29, U30, U31, U32, U33, U34, U35, U36, U37, U38, U39, U40, U41 | 6N137 | 6N137S-TA1 | #N/A | Isolator:6N137 | Package_DIP:DIP-8_W7.62mm | https://docs.broadcom.com/docs/AV02-0940EN | 160-1794-1-ND | 0.3306 | 66.12 | 200 | digikey | ("6N137", "digikey", "160-1794-1-ND", "6N137S-TA1", 0.3306, 200),
76 | 1 | 5 | 25 |  | U2 | ATSAMD21J15B-M | ATSAMD21J15B-MFT | #N/A | MCU_Microchip_SAMD:ATSAMD21J15B-M | Package_DFN_QFN:QFN-64-1EP_9x9mm_P0.5mm_EP4.7x4.7mm | http://ww1.microchip.com/downloads/en/DeviceDoc/SAM_D21_DA1_Family_Data%20Sheet_DS40001882E.pdf | 556-ATSAMD21J15B-MFT | 2.35 | 58.75 | 25 | mouser | ("ATSAMD21J15B-M", "mouser", "556-ATSAMD21J15B-MFT", "ATSAMD21J15B-MFT", 2.35, 25),
77 | 1 | 5 | 10 |  | U3 | MP5000A | MP5000ADQ-LF-Z | #N/A | el_components:MP5000A |  | https://www.mouser.de/datasheet/2/277/MP5000A-1384322.pdf | 946-MP5000ADQ-LF-Z | 1.2 | 12 | 10 | mouser | ("MP5000A", "mouser", "946-MP5000ADQ-LF-Z", "MP5000ADQ-LF-Z", 1.2, 10),
78 | 1 | 5 | 10 |  | U4 | 74ACT14 | MC74ACT14DR2G | MC74ACT14DR2G | 74xx:74HC14 |  | http://www.ti.com/lit/gpn/sn74HC14 | 863-MC74ACT14DR2G | 0.464 | 4.64 | 10 | mouser | ("74ACT14", "mouser", "863-MC74ACT14DR2G", "MC74ACT14DR2G", 0.464, 10),
79 | 3 | 15 | 18 |  | U5, U6, U7 | PDSE1-S5-S5 | PDSE1-S5-S5-D | PDSE1-S5-S5-D | el_components:PDSE1-S5-S5-D |  | https://www.mouser.de/datasheet/2/670/pdse1_d-1774645.pdf | 490-PDSE1-S5-S5-D | 2.7 | 48.6 | 18 | mouser | ("PDSE1-S5-S5", "mouser", "490-PDSE1-S5-S5-D", "PDSE1-S5-S5-D", 2.7, 18),
80 | 1 | 5 | 10 |  | U8 | BD93291EFJ | BD93291EFJ-E2 | #N/A | el_components:BD93291EFJ |  | https://www.mouser.de/datasheet/2/348/bd93291efj-e-1874257.pdf | 755-BD93291EFJ-E2 | 0.888 | 8.88 | 10 | mouser | ("BD93291EFJ", "mouser", "755-BD93291EFJ-E2", "BD93291EFJ-E2", 0.888, 10),
81 | 1 | 5 | 10 |  | U9 | MAX485CSA+T | MAX485CSA+T | #N/A | Interface_UART:MAX485E |  | https://datasheets.maximintegrated.com/en/ds/MAX1487-MAX491.pdf | MAX485CSA+TCT-ND | 3.242 | 32.42 | 10 | digikey | ("MAX485CSA+T", "digikey", "MAX485CSA+TCT-ND", "MAX485CSA+T", 3.242, 10),
82 | 1 | 5 | 10 |  | Y1 | SSPT7F-7PF20-R | SSPT7F-7PF20-R | SSPT7F-7PF20-R | Device:Crystal_GND23 |  | ~ | 628-SSPT7F-7PF20PPM | 0.553 | 5.53 | 10 | mouser | ("SSPT7F-7PF20-R", "mouser", "628-SSPT7F-7PF20PPM", "SSPT7F-7PF20-R", 0.553, 10),
83 | 1 | 5 | 10 |  | D17 | TPSMB210A | TPSMB210A | TPSMB210A | Device:D_TVS |  | https://www.mouser.de/datasheet/2/240/Littelfuse_TVS_Diode_TPSMB_Datasheet_pdf-349004.pdf | 576-TPSMB210A | 0.562 | 5.62 | 10 | mouser | ("TPSMB210A", "mouser", "576-TPSMB210A", "TPSMB210A", 0.562, 10),

Sheet: Mouser
WARENKORB
Dies ist keine Rechnung
11-Apr-22 16:41:46
 | Mouser-Nr. | Herst.- Nr. | Hersteller | Kunden-Teilenr | Beschreibung | RoHS | Lebenszyklus | Stückzahl | Preis (EUR) | Gesamtpreis: (EUR)
1 | 187-CL21A106KOQNNNE | CL21A106KOQNNNE | Samsung Electro-Mechanics |  | Kondensator aus mehreren Keramikschichten MLCC - SMD/SMT 10uF+/-10% 16V X5R 2 0805 | RoHS-konform | Neu bei Mouser | 100 | 0,035 € | 3,50 € | #N/A
2 | 187-CL10B104KA8NFNC | CL10B104KA8NFNC | Samsung Electro-Mechanics |  | Kondensator aus mehreren Keramikschichten MLCC - SMD/SMT 100nF+/-10% 25V X7R 0603 | RoHS-konform | Neu bei Mouser | 250 | 0,012 € | 3,00 € | #N/A
3 | 81-GRM32EC81C476KE5K | GRM32EC81C476KE15K | Murata |  | Kondensator aus mehreren Keramikschichten MLCC - SMD/SMT 47UF 16V 10% 1210 | RoHS-konform |  | 10 | 0,379 € | 3,79 € | #N/A
4 | 791-1812B105K251CT | 1812B105K251CT | Walsin |  | Kondensator aus mehreren Keramikschichten MLCC - SMD/SMT 1812 MLCC X7R 1 uF +/- 10% 250 V T&R GP | RoHS-konform |  | 120 | 0,363 € | 43,56 € | #N/A
5 | 187-CL21A226MOQNNNE | CL21A226MOQNNNE | Samsung Electro-Mechanics |  | Kondensator aus mehreren Keramikschichten MLCC - SMD/SMT 22uF+/-20% 16V X5R 2 0805 | RoHS-konform | Neu bei Mouser | 20 | 0,127 € | 2,54 € | CL21A226MOQNNNE
6 | 187-CL21A475KAQNNNF | CL21A475KAQNNNF | Samsung Electro-Mechanics |  | Kondensator aus mehreren Keramikschichten MLCC - SMD/SMT 4.7uF+/-10% 25V X5R 0805 | RoHS-konform | Neu bei Mouser | 40 | 0,074 € | 2,96 € | CL21A475KAQNNNF
7 | 710-885012206033 | 885012206033 | Wurth Elektronik |  | Kondensator aus mehreren Keramikschichten MLCC - SMD/SMT WCAP-CSGP 680pF 0603 10% 16V MLCC | RoHS-konform |  | 10 | 0,02 € | 0,20 € | #N/A
8 | 710-885012206087 | 885012206087 | Wurth Elektronik |  | Kondensator aus mehreren Keramikschichten MLCC - SMD/SMT WCAP-CSGP 4700pF 0603 10% 50V MLCC | RoHS-konform |  | 10 | 0,017 € | 0,17 € | #N/A
9 | 628-SSPT7F-7PF20PPM | SSPT7F-7PF20-R | Seiko Instruments |  | Quarze Quartz Crystal Unit 32.768KHZ 7pF | RoHS-konform |  | 10 | 0,553 € | 5,53 € | SSPT7F-7PF20-R
10 | 81-GRM0225C1H9R1CA3L | GRM0225C1H9R1CA03L | Murata |  | Kondensator aus mehreren Keramikschichten MLCC - SMD/SMT | RoHS-konform |  | 10 | 0,046 € | 0,46 € | #N/A
11 | 80-C901U102MZWDBAP | C901U102MZWDBA7317 | KEMET |  | Sicherheitskondensatoren 440/300V 1000pF Y5U 20% LS=10mm | RoHS-konform |  | 30 | 0,148 € | 4,44 € | C901U102MZWDBA7317
12 | 490-PDSE1-S5-S5-D | PDSE1-S5-S5-D | CUI Inc. |  | ISOLIERTE DC-DC-WANDLER dc-dc isolated, 1 W, 4.5~5.5 Vdc input, 5 Vdc, 0.2 A, single unregulated output, DIP | RoHS-konform |  | 18 | 2,70 € | 48,60 € | PDSE1-S5-S5-D
13 | 863-MC74ACT14DR2G | MC74ACT14DR2G | onsemi |  | Inverter 5V CMOS Hex Schmitt Trigger | RoHS-konform |  | 10 | 0,464 € | 4,64 € | MC74ACT14DR2G
14 | 642-MJTP1230 | MJTP1230 | Apem |  | Sensorschalter 6mm TACTILE SW | RoHS-konform |  | 25 | 0,074 € | 1,85 € | MJTP1230
15 | 755-RQ3G100GNTB | RQ3G100GNTB | ROHM Semiconductor |  | MOSFET Nch 40V 10A Power MOSFET | RoHS: Konform durch Ausnahmegenehmigung |  | 10 | 0,383 € | 3,83 € | RQ3G100GNTB
16 | 755-RK7002BMT116 | RK7002BMT116 | ROHM Semiconductor |  | MOSFET 2.5V Drive Nch MOSFET | RoHS: Konform durch Ausnahmegenehmigung |  | 10 | 0,17 € | 1,70 € | RK7002BMT116
17 | 583-FM4007W-W | FM4007W-W | Rectron |  | Gleichrichter 1A, 1000V, SM | RoHS: Konform durch Ausnahmegenehmigung |  | 10 | 0,14 € | 1,40 € | FM4007W-W
18 | 771-BZX8450-C1V8-QR | BZX8450-C1V8-QR | Nexperia |  | Zener-Dioden BZX8450-C1V8-Q/SOT23/TO-236AB | RoHS-konform | Neues Produkt | 15 | 0,134 € | 2,01 € | BZX8450-C1V8-QR
19 | 863-MM3Z36VT1G | MM3Z36VT1G | onsemi |  | Zener-Dioden 36V 200mW | RoHS-konform |  | 10 | 0,127 € | 1,27 € | MM3Z36VT1G
20 | 771-PMEG3050EP115 | PMEG3050EP,115 | Nexperia |  | Schottky Dioden & Gleichrichter SCHOTTKY RECT 30V 5A | RoHS: Konform durch Ausnahmegenehmigung |  | 10 | 0,438 € | 4,38 € | PMEG3050EP,115
21 | 241-BAT54A_R1_00001 | BAT54A_R1_00001 | Panjit |  | Schottky Dioden & Gleichrichter 30V Schottky 0.2A | RoHS-konform | Neu bei Mouser | 10 | 0,142 € | 1,42 € | BAT54A_R1_00001
22 | 583-ZMM5226B | ZMM5226B | Rectron |  | Zener-Dioden 0.5W 3.3V 5% | RoHS: Konform durch Ausnahmegenehmigung |  | 10 | 0,108 € | 1,08 € | ZMM5226B
23 | 583-SMAJ6.0A-W | SMAJ6.0A-W | Rectron |  | ESD-Entstörer/TVS-Dioden SMA 400w TVS 5% | RoHS-konform |  | 20 | 0,108 € | 2,16 € | SMAJ6.0A-W
24 | 771-PRTR5V0U2X-T/R | PRTR5V0U2X,215 | Nexperia |  | ESD-Entstörer/TVS-Dioden 5.5V DUAL R-R ESD ULTRA LOW CAP | RoHS-konform |  | 15 | 0,407 € | 6,11 € | PRTR5V0U2X,215
25 | 667-ERB-RE5R00V | ERB-RE5R00V | Panasonic |  | Sicherungen zur Aufbaumontage 5A 0603 micro chip | RoHS-konform |  | 20 | 0,211 € | 4,22 € | ERB-RE5R00V
26 | 603-RC0603JR-0710KL | RC0603JR-0710KL | YAGEO |  | Dickfilmwiderstände - SMD 10 kOhms 100 mW 0603 5% | RoHS: Konform durch Ausnahmegenehmigung |  | 200 | 0,005 € | 1,00 € | RC0603JR-0710KL
27 | 603-RC0603JR-07560RL | RC0603JR-07560RL | YAGEO |  | Dickfilmwiderstände - SMD 560 Ohms 100 mW 0603 5% | RoHS: Konform durch Ausnahmegenehmigung |  | 30 | 0,013 € | 0,39 € | RC0603JR-07560RL
28 | 791-RMC1/16-122JTP | RMC1/16-122JTP | Kamaya |  | Dickfilmwiderstände - SMD 0603 1K2 5% | RoHS: Konform durch Ausnahmegenehmigung |  | 30 | 0,013 € | 0,39 € | RMC1/16-122JTP
29 | 603-RC0603FR-072K2L | RC0603FR-072K2L | YAGEO |  | Dickfilmwiderstände - SMD 2.2 kOhms 100mW 0603 1% | RoHS: Konform durch Ausnahmegenehmigung |  | 30 | 0,015 € | 0,45 € | RC0603FR-072K2L
30 | 791-RMC1/16-472JTP | RMC1/16-472JTP | Kamaya |  | Dickfilmwiderstände - SMD 0603 4K7 5% | RoHS: Konform durch Ausnahmegenehmigung |  | 30 | 0,013 € | 0,39 € | RMC1/16-472JTP
31 | 603-RC0603JR-07510RL | RC0603JR-07510RL | YAGEO |  | Dickfilmwiderstände - SMD 510 Ohms 100 mW 0603 5% | RoHS: Konform durch Ausnahmegenehmigung |  | 200 | 0,005 € | 1,00 € | RC0603JR-07510RL
32 | 603-RC0603FR-071KL | RC0603FR-071KL | YAGEO |  | Dickfilmwiderstände - SMD 1 kOhms 100mW 0603 1% | RoHS: Konform durch Ausnahmegenehmigung |  | 125 | 0,006 € | 0,75 € | RC0603FR-071KL
33 | 652-CR0603FX-2202ELF | CR0603-FX-2202ELF | Bourns |  | Dickfilmwiderstände - SMD 22K ohm 1% | RoHS: Konform durch Ausnahmegenehmigung |  | 25 | 0,014 € | 0,35 € | CR0603-FX-2202ELF
34 | 652-CR0603FX-6800ELF | CR0603-FX-6800ELF | Bourns |  | Dickfilmwiderstände - SMD 680 ohm 1% | RoHS: Konform durch Ausnahmegenehmigung |  | 25 | 0,015 € | 0,38 € | CR0603-FX-6800ELF
35 | 301-22-RC | 301-22-RC | Xicon |  | Dickfilmwiderstände - SMD 1/10WATT 22OHMS 5% | RoHS: Konform durch Ausnahmegenehmigung |  | 10 | 0,011 € | 0,11 € | 301-22-RC
36 | 652-CR0603-J/-000ELF | CR0603-J/-000ELF | Bourns |  | Dickfilmwiderstände - SMD ZERO OHM | RoHS: Konform durch Ausnahmegenehmigung |  | 125 | 0,005 € | 0,63 € | CR0603-J/-000ELF
37 | 603-RC0603JR-131ML | RC0603JR-131ML | YAGEO |  | Dickfilmwiderstände - SMD 1 MOhms 100-200 mW 0603 5% | RoHS: Konform durch Ausnahmegenehmigung |  | 30 | 0,013 € | 0,39 € | RC0603JR-131ML
38 | 791-RMC16K163FTP | RMC16K163FTP | Kamaya |  | Dickfilmwiderstände - SMD 16 kOhms 1% 1.0A AEC-Q200 | RoHS: Konform durch Ausnahmegenehmigung |  | 10 | 0,016 € | 0,16 € | RMC16K163FTP
39 | 791-WR06X512JTL | WR06X512 JTL | Walsin |  | Dickfilmwiderstände - SMD 0603 5K1 5% Lead Free | RoHS-konform | Neues Produkt | 20 | 0,013 € | 0,26 € | WR06X512 JTL
40 | 603-RC0603JR-0710ML | RC0603JR-0710ML | YAGEO |  | Dickfilmwiderstände - SMD 10 MOhms 100 mW 0603 5% | RoHS: Konform durch Ausnahmegenehmigung |  | 15 | 0,013 € | 0,20 € | RC0603JR-0710ML
41 | 652-CR0603-JW-331ELF | CR0603-JW-331ELF | Bourns |  | Dickfilmwiderstände - SMD 330 OHM 5% | RoHS: Konform durch Ausnahmegenehmigung |  | 10 | 0,007 € | 0,07 € | CR0603-JW-331ELF
42 | 603-RC0805FR-13100RL | RC0805FR-13100RL | YAGEO |  | Dickfilmwiderstände - SMD 100 Ohms 250 mW 0805 1% | RoHS: Konform durch Ausnahmegenehmigung |  | 200 | 0,011 € | 2,20 € | RC0805FR-13100RL
43 | 301-2.2K-RC | 301-2.2K-RC | Xicon |  | Dickfilmwiderstände - SMD 1/10WATT 2.2KOHMS | RoHS: Konform durch Ausnahmegenehmigung |  | 100 | 0,004 € | 0,40 € | 301-2.2K-RC
44 | 660-RK73B1JTTDD221J | RK73B1JTTDD221J | KOA Speer |  | Dickfilmwiderstände - SMD 1/8W 220 OHM 5% | RoHS: Konform durch Ausnahmegenehmigung |  | 10 | 0,019 € | 0,19 € | RK73B1JTTDD221J
45 | 710-150141YB73100 | 150141YB73100 | Wurth Elektronik |  | Standard-LEDs - SMD WL-SBTW SMDBiClr Top Watrclr 3528Ylw&Blue | RoHS-konform |  | 10 | 0,30 € | 3,00 € | #N/A
46 | 810-TFM201610ALVA2R2 | TFM201610ALVA2R2MTAA | TDK |  | Festinduktivitäten 2.2uH 20% 152mOhm 2A AEC-Q200 | RoHS-konform | Neues Produkt | 10 | 0,549 € | 5,49 € | TFM201610ALVA2R2MTAA
47 | 710-7447706220 | 7447706220 | Wurth Elektronik |  | Festinduktivitäten WE-PD 22uH 3.7A DCR=41mOhms AECQ200 | RoHS-konform |  | 10 | 0,983 € | 9,83 € | #N/A
48 | 963-LBC3225T6R8MR | LBC3225T6R8MR | Taiyo Yuden |  | Festinduktivitäten 1210 6.8uH 156mOhms +/-20%Tol 620mA | RoHS-konform |  | 20 | 0,122 € | 2,44 € | LBC3225T6R8MR
49 | 771-PTVS13VS1UTR115 | PTVS13VS1UTR,115 | Nexperia |  | ESD-Entstörer/TVS-Dioden UNI 15.9V 400W | RoHS: Konform durch Ausnahmegenehmigung |  | 10 | 0,109 € | 1,09 € | PTVS13VS1UTR,115
50 | 640-USB4510031A | USB4510-03-1-A | Global Connector Technology (GCT) |  | USB-Stecker USB C Rec 16P 3u" Mid Mnt 1.6mm O-set SMT L = 6.5mm S-Spring | RoHS-konform | Neues Produkt | 10 | 0,574 € | 5,74 € | USB4510-03-1-A
51 | 78-BZD27B180P-M3-08 | BZD27B180P-M3-08 | Vishay |  | Zener-Dioden ZENER DIODE SMF AEC-Q101 Qualified | RoHS: Konform durch Ausnahmegenehmigung |  | 15 | 0,329 € | 4,94 € | #N/A
52 | 576-TPSMB210A | TPSMB210A | Littelfuse |  | ESD-Entstörer/TVS-Dioden 600W 210V AEC-Q101 5% Uni-Directional | RoHS-konform |  | 10 | 0,562 € | 5,62 € | TPSMB210A
53 | 490-DS01C-254-S-12BE | DS01C-254-S-12BE | CUI Devices |  | DIP-Schalter / SIP-Schalter 1 12 Positions, Through Hole, 2.54 mm Pitch, Slide Actuator, DIP Switch | RoHS-konform |  | 6 | 0,974 € | 5,84 € | DS01C-254-S-12BE
Durch das Absenden Ihrer Bestellung erklären Sie sich mit diesen Geschäftsbedingungen einverstanden. (https://www.mouser.de/saleterms) |  |  |  |  |  |  |  |  | Ware: | 208,52 €
Die Preise sind zum angezeigten Datum und zur Uhrzeit reflektiert. |  |  |  |  |  |  |  |  | Versandkosten: | 0,00 €

Sheet: checkup
Item | Qty | Reference(s) | Value | LibPart | Footprint | Datasheet
1 | 7 | C1, C5, C24, C28, C31, C34, C38 | 10uF | Device:C |  | ~ | #N/A
2 | 40 | C2, C3, C4, C6, C10, C23, C35, C43, C45, C46, C47, C48, C51, C52, C53, C54, C57, C58, C59, C60, C63, C64, C65, C66, C69, C70, C71, C72, C75, C76, C77, C78, C81, C82, C83, C84, C87, C88, C89, C90 | 100nF | Device:C |  | ~ | #N/A
3 | 2 | C7, C8 | 9.1pF | Device:C |  | ~ | C7, C8
4 | 2 |  | 1uF | Device:C |  | ~ | #N/A
5 | 3 | C11, C13, C22 | 10uF | Device:C_Polarized |  | ~ | #N/A
6 | 1 | C14 | 47uF, GRM32EC81C476KE15K | Device:C_Polarized |  | ~ | #N/A
7 | 6 | C15, C16, C17, C18, C19, C20 | 1uF, 200V | Device:C_Polarized |  | ~ | #N/A
8 | 4 | C21, C39, C40, C41 | Y2 1nF | Device:C |  | ~ | C21, C39, C40, C41
9 | 2 | C25, C37 | 22uF | Device:C |  | ~ | C25, C37
10 | 6 | C26, C27, C29, C30, C32, C33 | 4.7uF | Device:C_Polarized |  | ~ | C26, C27, C29, C30, C32, C33
11 | 1 | C36 | 680pF | Device:C |  | ~ | C36
12 | 1 | C42 | 100nF, DNP | Device:C |  | ~ | #N/A
13 | 1 | C44 | 4.7nF | Device:C |  | ~ | C44
14 | 16 | C9, C12, C49, C50, C55, C56, C61, C62, C67, C68, C73, C74, C79, C80, C85, C86, C91, C92 | 1uF, 200V | Device:C |  | ~ | #N/A
15 | 1 | D1 | 150141YB73100 | Device:LED_Dual_AAKK |  | ~ | #N/A
16 | 1 | D2 | FM4007W-W | Device:D |  | https://www.mouser.de/datasheet/2/345/fm4001w_fm4007w-1396243.pdf | D2
17 | 2 | D3, D16 | BZD27B180P-M3-08 | Device:D_Zener |  | https://www.mouser.de/datasheet/2/427/VISH_S_A0008998136_1-2570582.pdf | #N/A
18 | 2 | D4, D5 | BZX8450-C1V8-QR | el_components:BZX8450-C1V8-QR |  | ~ | D4, D5
19 | 1 | D6 | MM3Z36VT1G | Device:D_Zener |  | ~ | D6
20 | 1 | D7 | PMEG3050EP,115 | Device:D_Schottky |  | ~ | D7
21 | 1 | D8 | PTVS13VS1UTR,115 | Device:D_TVS |  | https://www.mouser.de/datasheet/2/916/PTVSXS1UTR_SER-1600409.pdf | D8
22 | 1 | D9 | BAT54A_R1_00001 | Diode:BAT54AW | Package_TO_SOT_SMD:SOT-323_SC-70 | https://www.mouser.de/datasheet/2/1057/BAT54_SERIES-1869048.pdf | D9
23 | 1 | D10 | ZMM5226B | Diode:ZMMxx | Diode_SMD:D_MiniMELF | https://diotec.com/tl_files/diotec/files/pdf/datasheets/zmm1.pdf | D10
24 | 3 | D11, D12, D13 | SMAJ6.0A-W | Device:D_TVS |  | ~ | D11, D12, D13
25 | 2 | D14, D15 | PRTR5V0U2X | Power_Protection:PRTR5V0U2X | Package_TO_SOT_SMD:SOT-143 | https://assets.nexperia.com/documents/data-sheet/PRTR5V0U2X.pdf | D14, D15
26 | 1 | D17 | TPSMB210A | Device:D_TVS |  | https://www.mouser.de/datasheet/2/240/Littelfuse_TVS_Diode_TPSMB_Datasheet_pdf-349004.pdf | D17
27 | 1 | F1 | ERB-RE5R00V | Device:Fuse |  | https://www.mouser.de/datasheet/2/315/AFA0000C7-1025982.pdf | F1
28 | 2 | FB1, FB2 | MMZ1608Y221BTD25 | Device:FerriteBead |  | ~ | FB1, FB2
29 | 4 | H1, H2, H3, H4 | MountingHole_Pad | Mechanical:MountingHole_Pad |  | ~ | #N/A
30 | 1 | J1 | 01x01_Male | Connector:Conn_01x01_Male |  | ~ | #N/A
31 | 1 | J2 | 54-00164 | Connector:Barrel_Jack_Switch |  | ~ | J2
32 | 1 | J3 | SWD_Connector | Connector_Generic:Conn_02x05_Odd_Even |  | ~ | J3
33 | 1 | J4 | AC3FAH2-AU-PRE | Connector:XLR3 |  | ~ | J4
34 | 1 | J5 | AC3MAH-AU-PRE | Connector:XLR3 |  | ~ | J5
35 | 1 | J6 | Conn_01x03 | Connector_Generic:Conn_01x03 |  | ~ | #N/A
36 | 1 | J7 | Conn_02x06_Top_Bottom | Connector_Generic:Conn_02x06_Top_Bottom |  | ~ | #N/A
37 | 1 | J8 | Conn_01x04 | Connector_Generic:Conn_01x04 |  | ~ | #N/A
38 | 1 | J9 | USB_C_Receptacle_USB2.0 | Connector:USB_C_Receptacle_USB2.0 |  | https://www.usb.org/sites/default/files/documents/usb_type-c.zip | J9
39 | 8 | J10, J11, J12, J13, J14, J15, J16, J17 | JST-SM | Connector:Conn_01x02_Female |  | ~ | #N/A
40 | 3 | JP1, JP2, JP4 | SolderJumper | Jumper:SolderJumper_2_Open |  | ~ | #N/A
41 | 2 | JP3, JP5 | SolderJumper_2_Open | Jumper:SolderJumper_2_Open |  | ~ | #N/A
42 | 1 | L1 | 22uH | Device:L |  | ~ | L1
43 | 3 | L2, L3, L4 | 6.8uH | Device:L |  | ~ | L2, L3, L4
44 | 1 | L5 | 2.2uH | Device:L |  | ~ | L5
45 | 16 | L6, L7, L8, L9, L10, L11, L12, L13, L14, L15, L16, L17, L18, L19, L20, L21 | 3.3mH | Device:L |  | ~ | L6, L7, L8, L9, L10, L11, L12, L13, L14, L15, L16, L17, L18, L19, L20, L21
46 | 1 | Q1 | DNP, RZM001P02 | Device:Q_PMOS_GSD |  | ~ | #N/A
47 | 17 | Q2, Q5, Q8, Q11, Q14, Q17, Q20, Q23, Q26, Q29, Q32, Q35, Q38, Q41, Q44, Q47, Q50 | RZM001P02 | Device:Q_PMOS_GSD |  | ~ | Q2, Q5, Q8, Q11, Q14, Q17, Q20, Q23, Q26, Q29, Q32, Q35, Q38, Q41, Q44, Q47, Q50
48 | 1 | Q3 | RQ3G100GN | el_components:RQ3G100GN |  | https://www.mouser.de/datasheet/2/348/rq3g100gntb-e-1873284.pdf | Q3
49 | 1 | Q4 | RK7002BMT116 | Device:Q_NMOS_DGS |  | ~ | Q4
50 | 16 | Q6, Q9, Q12, Q15, Q18, Q21, Q24, Q27, Q30, Q33, Q36, Q39, Q42, Q45, Q48, Q51 | Si7119DN | el_components:Si7119DN |  | https://www.mouser.de/datasheet/2/427/VISH_S_A0001142067_1-2567136.pdf | Q6, Q9, Q12, Q15, Q18, Q21, Q24, Q27, Q30, Q33, Q36, Q39, Q42, Q45, Q48, Q51
51 | 16 | Q7, Q10, Q13, Q16, Q19, Q22, Q25, Q28, Q31, Q34, Q37, Q40, Q43, Q46, Q49, Q52 | STN4NF20L | el_components:STN4NF20L |  | https://www.mouser.de/datasheet/2/389/cd00272247-1797117.pdf | Q7, Q10, Q13, Q16, Q19, Q22, Q25, Q28, Q31, Q34, Q37, Q40, Q43, Q46, Q49, Q52
52 | 20 | R1, R6, R11, R21, R46, R54, R62, R70, R78, R86, R94, R102, R110, R118, R126, R134, R142, R150, R158, R166 | 10k | Device:R |  | ~ | R1, R6, R11, R21, R46, R54, R62, R70, R78, R86, R94, R102, R110, R118, R126, R134, R142, R150, R158, R166
53 | 3 | R2, R7, R12 | 560 | Device:R |  | ~ | R2, R7, R12
54 | 3 | R3, R8, R13 | 1k2 | Device:R |  | ~ | R3, R8, R13
55 | 3 | R4, R9, R14 | 2k2 | Device:R |  | ~ | R4, R9, R14
56 | 3 | R5, R10, R15 | 4k7 | Device:R |  | ~ | R5, R10, R15
57 | 35 | R16, R17, R18, R49, R51, R57, R59, R65, R67, R73, R75, R81, R83, R89, R91, R97, R99, R105, R107, R113, R115, R121, R123, R129, R131, R137, R139, R145, R147, R153, R155, R161, R163, R169, R171 | 470 | Device:R |  | ~ | R16, R17, R18, R49, R51, R57, R59, R65, R67, R73, R75, R81, R83, R89, R91, R97, R99, R105, R107, R113, R115, R121, R123, R129, R131, R137, R139, R145, R147, R153, R155, R161, R163, R169, R171
58 | 19 | R19, R40, R41, R50, R58, R66, R74, R82, R90, R98, R106, R114, R122, R130, R138, R146, R154, R162, R170 | 1k | Device:R |  | ~ | R19, R40, R41, R50, R58, R66, R74, R82, R90, R98, R106, R114, R122, R130, R138, R146, R154, R162, R170
59 | 1 | R20 | DNP, 10k | Device:R |  | ~ | #N/A
 |  | R39 | 10meg | Device:R |  | ~ | R39
60 | 2 | R22 | 10meg | Device:R |  | ~ | R22
61 | 2 | R23, R24 | 22k 1% | Device:R |  | ~ | R23, R24
62 | 1 | R25 | 22 | Device:R |  | ~ | R25
63 | 2 | R26, R27 | 680 1% | Device:R |  | ~ | R26, R27
64 | 22 | R28, R31, R33, R34, R35, R36, R47, R55, R63, R71, R79, R87, R95, R103, R111, R119, R127, R135, R143, R151, R159, R167 | 0 | Device:R |  | ~ | R28, R31, R33, R34, R35, R36, R47, R55, R63, R71, R79, R87, R95, R103, R111, R119, R127, R135, R143, R151, R159, R167
65 | 1 | R29 | 220, 1/8W | Device:R |  | ~ | R29
66 | 4 | R30, R32, R44, R45 | 1meg | Device:R |  | ~ | R30, R32, R44, R45
67 | 1 | R37 | 16k | Device:R |  | ~ | R37
68 | 3 | R38, R174, R175 | 5.1k | Device:R |  | ~ | R38, R174, R175
69 | 1 | R42 | 10k, DNP | Device:R |  | ~ | #N/A
70 | 1 | R43 | 330 | Device:R |  | ~ | R43
71 | 32 | R48, R53, R56, R61, R64, R69, R72, R77, R80, R85, R88, R93, R96, R101, R104, R109, R112, R117, R120, R125, R128, R133, R136, R141, R144, R149, R152, R157, R160, R165, R168, R173 | 100, 1/4W | Device:R |  | ~ | R48, R53, R56, R61, R64, R69, R72, R77, R80, R85, R88, R93, R96, R101, R104, R109, R112, R117, R120, R125, R128, R133, R136, R141, R144, R149, R152, R157, R160, R165, R168, R173
72 | 16 | R52, R60, R68, R76, R84, R92, R100, R108, R116, R124, R132, R140, R148, R156, R164, R172 | 2.2k | Device:R |  | ~ | R52, R60, R68, R76, R84, R92, R100, R108, R116, R124, R132, R140, R148, R156, R164, R172
73 | 1 | SW1 | SW_DIP_x12 | Switch:SW_DIP_x12 |  | ~ | SW1
74 | 4 | SW2, SW3, SW4, SW5 | SW_Push | Switch:SW_Push |  | ~ | SW2, SW3, SW4, SW5
75 | 2 | T1, T2 | 750032050 | el_components:750032050 |  | ~ | T1, T2
76 | 33 | U1, U10, U11, U12, U13, U14, U15, U16, U17, U18, U19, U20, U21, U22, U23, U24, U25, U26, U27, U28, U29, U30, U31, U32, U33, U34, U35, U36, U37, U38, U39, U40, U41 | 6N137 | Isolator:6N137 | Package_DIP:DIP-8_W7.62mm | https://docs.broadcom.com/docs/AV02-0940EN | U1, U10, U11, U12, U13, U14, U15, U16, U17, U18, U19, U20, U21, U22, U23, U24, U25, U26, U27, U28, U29, U30, U31, U32, U33, U34, U35, U36, U37, U38, U39, U40, U41
77 | 1 | U2 | ATSAMD21J15B-M | MCU_Microchip_SAMD:ATSAMD21J15B-M | Package_DFN_QFN:QFN-64-1EP_9x9mm_P0.5mm_EP4.7x4.7mm | http://ww1.microchip.com/downloads/en/DeviceDoc/SAM_D21_DA1_Family_Data%20Sheet_DS40001882E.pdf | U2
78 | 1 | U3 | MP5000A | el_components:MP5000A |  | https://www.mouser.de/datasheet/2/277/MP5000A-1384322.pdf | U3
79 | 1 | U4 | 74ACT14 | 74xx:74HC14 |  | https://www.mouser.de/datasheet/2/308/1/MC74AC14_D-2315433.pdf | U4
80 | 3 | U5, U6, U7 | PDSE1-S5-S5-D | el_components:PDSE1-S5-S5-D |  | https://www.mouser.de/datasheet/2/670/pdse1_d-1774645.pdf | U5, U6, U7
81 | 1 | U8 | BD93291EFJ | el_components:BD93291EFJ |  | https://www.mouser.de/datasheet/2/348/bd93291efj-e-1874257.pdf | U8
82 | 1 | U9 | MAX485 | Interface_UART:MAX485E |  | https://datasheets.maximintegrated.com/en/ds/MAX1487-MAX491.pdf | U9
83 | 1 | Y1 | SSPT7F-7PF20-R | Device:Crystal_GND23 |  | ~ | Y1

Sheet: Legend
Arrived
In cart
Duplicate
Arrived, but not usable
In transit
Not ordered yet

Sheet: all_carts
Sales Order No: | Web Order No: | PO Number: | Line No. | Order Date: | Order Status: | Mfr. No: | Mouser No: | Desc.: | Customer No | Order Qty. | Price (EUR) | Price (EUR) | Status | Date | Invoice No. | vendor
259492587 | 24821627 | 24821627 | 1 | 14-Mar-22 | COMPLETE | AC3MAH-AU-PRE | 523-AC3MAH-AU-PRE | XLR Connectors XLR Connectors 3 PIN PLASTIC PANEL MOUNT PCB |  | 5 | 0,755 € | 0.755 | 5 Shipped | 15-Mar-22 | 66728348 | mouser
259492587 | 24821627 | 24821627 | 2 | 14-Mar-22 | COMPLETE | AC3FAH2-AU-PRE | 523-AC3FAH2-AU-PRE | XLR Connectors XLR Connectors 3 SKT PLASTIC PANEL MOUNT PCB |  | 5 | 0,783 € | 0.783 | 5 Shipped | 15-Mar-22 | 66728348 | mouser
259492587 | 24821627 | 24821627 | 3 | 14-Mar-22 | COMPLETE | 750032050 | 710-750032050 | Power Transformers Power Transformers WE-FB Flyback 10.0uH 1KVAC |  | 16 | 4,34 € | 4.34 | 16 Shipped | 15-Mar-22 | 66728348 | mouser
259492587 | 24821627 | 24821627 | 4 | 14-Mar-22 | COMPLETE | ATSAMD21J15B-MFT | 556-ATSAMD21J15B-MFT | ARM Microcontrollers - MCU ARM Microcontrollers - MCU 64QFN,125C TEMP, GREEN, 3.3V, 48MHZ, T&R |  | 25 | 2,35 € | 2.35 | 25 Shipped | 15-Mar-22 | 66728348 | mouser
259492587 | 24821627 | 24821627 | 5 | 14-Mar-22 | COMPLETE | MP5000ADQ-LF-Z | 946-MP5000ADQ-LF-Z | Hot Swap Voltage Controllers Hot Swap Voltage Controllers 12V,5A Programmable Current Limit Switch |  | 10 | 1,20 € | 1.2 | 10 Shipped | 15-Mar-22 | 66728348 | mouser
259492587 | 24821627 | 24821627 | 6 | 14-Mar-22 | COMPLETE | BD93291EFJ-E2 | 755-BD93291EFJ-E2 | Switching Voltage Regulators Switching Voltage Regulators IC Pwr Swtch Reg Multi Output |  | 10 | 0,888 € | 0.888 | 10 Shipped | 15-Mar-22 | 66728348 | mouser
259492587 | 24821627 | 24821627 | 7 | 14-Mar-22 | COMPLETE | MMZ1608Y221BTD25 | 810-MMZ1608Y221BTD25 | Ferrite Beads Ferrite Beads 0603 220ohms 500mA Signal Line AEC-Q200 |  | 20 | 0,068 € | 0.068 | 20 Shipped | 15-Mar-22 | 66728348 | mouser
259721466 | 24979255 | 24979255 | 1 | 28-Mar-22 | COMPLETE | RFS1317-335KL | 994-RFS1317-335KL | Power Inductors - Leaded Power Inductors - Leaded 3.3 mH Shld 10% 410mA 2.38ohms |  | 100 | 1,18 € | 1.18 | 100 Shipped | 28-Mar-22 | 66983413 | mouser
259961553 | 25139898 | 25139898 | 1 | 11-Apr-22 | COMPLETE | CL21A106KOQNNNE | 187-CL21A106KOQNNNE | Multilayer Ceramic Capacitors MLCC - SMD/SMT Multilayer Ceramic Capacitors MLCC - SMD/SMT 10uF+/-10% 16V X5R 2 0805 |  | 100 | 0,035 € | 0.035 | 100 Shipped | 12-Apr-22 | 67255078 | mouser
259961553 | 25139898 | 25139898 | 2 | 11-Apr-22 | COMPLETE | CL10B104KA8NFNC | 187-CL10B104KA8NFNC | Multilayer Ceramic Capacitors MLCC - SMD/SMT Multilayer Ceramic Capacitors MLCC - SMD/SMT 100nF+/-10% 25V X7R 0603 |  | 250 | 0,012 € | 0.012 | 250 Shipped | 12-Apr-22 | 67255078 | mouser
259961553 | 25139898 | 25139898 | 3 | 11-Apr-22 | COMPLETE | GRM32EC81C476KE15K | 81-GRM32EC81C476KE5K | Multilayer Ceramic Capacitors MLCC - SMD/SMT Multilayer Ceramic Capacitors MLCC - SMD/SMT 47UF 16V 10% 1210 |  | 10 | 0,379 € | 0.379 | 10 Shipped | 12-Apr-22 | 67255078 | mouser
259961553 | 25139898 | 25139898 | 4 | 11-Apr-22 | COMPLETE | 1812B105K251CT | 791-1812B105K251CT | Multilayer Ceramic Capacitors MLCC - SMD/SMT Multilayer Ceramic Capacitors MLCC - SMD/SMT 1812 MLCC X7R 1 uF, +/- 10% 250 V T&R GP |  | 120 | 0,363 € | 0.363 | 120 Shipped | 12-Apr-22 | 67255078 | mouser
259961553 | 25139898 | 25139898 | 5 | 11-Apr-22 | COMPLETE | CL21A226MOQNNNE | 187-CL21A226MOQNNNE | Multilayer Ceramic Capacitors MLCC - SMD/SMT Multilayer Ceramic Capacitors MLCC - SMD/SMT 22uF+/-20% 16V X5R 2 0805 |  | 20 | 0,127 € | 0.127 | 20 Shipped | 12-Apr-22 | 67255078 | mouser
259961553 | 25139898 | 25139898 | 6 | 11-Apr-22 | COMPLETE | CL21A475KAQNNNF | 187-CL21A475KAQNNNF | Multilayer Ceramic Capacitors MLCC - SMD/SMT Multilayer Ceramic Capacitors MLCC - SMD/SMT 4.7uF+/-10% 25V X5R 0805 |  | 40 | 0,074 € | 0.074 | 40 Shipped | 12-Apr-22 | 67255078 | mouser
259961553 | 25139898 | 25139898 | 7 | 11-Apr-22 | COMPLETE | 885012206033 | 710-885012206033 | Multilayer Ceramic Capacitors MLCC - SMD/SMT Multilayer Ceramic Capacitors MLCC - SMD/SMT WCAP-CSGP 680pF 0603 10% 16V MLCC |  | 10 | 0,02 € | 0.02 | 10 Shipped | 12-Apr-22 | 67255078 | mouser
259961553 | 25139898 | 25139898 | 8 | 11-Apr-22 | COMPLETE | 885012206087 | 710-885012206087 | Multilayer Ceramic Capacitors MLCC - SMD/SMT Multilayer Ceramic Capacitors MLCC - SMD/SMT WCAP-CSGP 4700pF 0603 10% 50V MLCC |  | 10 | 0,017 € | 0.017 | 10 Shipped | 12-Apr-22 | 67255078 | mouser
259961553 | 25139898 | 25139898 | 9 | 11-Apr-22 | COMPLETE | SSPT7F-7PF20-R | 628-SSPT7F-7PF20PPM | Crystals Crystals Quartz Crystal Unit 32.768KHZ 7pF |  | 10 | 0,553 € | 0.553 | 10 Shipped | 12-Apr-22 | 67255078 | mouser
259961553 | 25139898 | 25139898 | 10 | 11-Apr-22 | COMPLETE | GRM0225C1H9R1CA03L | 81-GRM0225C1H9R1CA3L | Multilayer Ceramic Capacitors MLCC - SMD/SMT Multilayer Ceramic Capacitors MLCC - SMD/SMT |  | 10 | 0,046 € | 0.046 | 10 Shipped | 12-Apr-22 | 67255078 | mouser
259961553 | 25139898 | 25139898 | 11 | 11-Apr-22 | COMPLETE | C901U102MZWDBA7317 | 80-C901U102MZWDBAP | Safety Capacitors Safety Capacitors 440/300V 1000pF Y5U 20% LS=10mm |  | 30 | 0,148 € | 0.148 | 30 Shipped | 12-Apr-22 | 67255078 | mouser
259961553 | 25139898 | 25139898 | 12 | 11-Apr-22 | COMPLETE | PDSE1-S5-S5-D | 490-PDSE1-S5-S5-D | Isolated DC/DC Converters - Through Hole Isolated DC/DC Converters - Through Hole dc-dc isolated, 1 W, 4.5~5.5 Vdc input, 5 Vdc, 0.2 A, single unregulated output, DIP |  | 18 | 2,70 € | 2.7 | 18 Shipped | 12-Apr-22 | 67255078 | mouser
259961553 | 25139898 | 25139898 | 13 | 11-Apr-22 | COMPLETE | MC74ACT14DR2G | 863-MC74ACT14DR2G | Inverters Inverters 5V CMOS Hex Schmitt Trigger |  | 10 | 0,464 € | 0.464 | 10 Shipped | 12-Apr-22 | 67255078 | mouser
259961553 | 25139898 | 25139898 | 14 | 11-Apr-22 | COMPLETE | MJTP1230 | 642-MJTP1230 | Tactile Switches Tactile Switches 6mm TACTILE SW |  | 25 | 0,074 € | 0.074 | 25 Shipped | 12-Apr-22 | 67255078 | mouser
259961553 | 25139898 | 25139898 | 15 | 11-Apr-22 | COMPLETE | RQ3G100GNTB | 755-RQ3G100GNTB | MOSFET MOSFET Nch 40V 10A Power MOSFET |  | 10 | 0,383 € | 0.383 | 10 Shipped | 12-Apr-22 | 67255078 | mouser
259961553 | 25139898 | 25139898 | 16 | 11-Apr-22 | COMPLETE | RK7002BMT116 | 755-RK7002BMT116 | MOSFET MOSFET 2.5V Drive Nch MOSFET |  | 10 | 0,17 € | 0.17 | 10 Shipped | 12-Apr-22 | 67255078 | mouser
259961553 | 25139898 | 25139898 | 17 | 11-Apr-22 | COMPLETE | FM4007W-W | 583-FM4007W-W | Rectifiers Rectifiers 1A, 1000V, SM |  | 10 | 0,14 € | 0.14 | 10 Shipped | 12-Apr-22 | 67255078 | mouser
259961553 | 25139898 | 25139898 | 18 | 11-Apr-22 | COMPLETE | BZX8450-C1V8-QR | 771-BZX8450-C1V8-QR | Zener Diodes Zener Diodes BZX8450-C1V8-Q/SOT23/TO-236AB |  | 15 | 0,134 € | 0.134 | 15 Shipped | 12-Apr-22 | 67255078 | mouser
259961553 | 25139898 | 25139898 | 19 | 11-Apr-22 | COMPLETE | MM3Z36VT1G | 863-MM3Z36VT1G | Zener Diodes Zener Diodes 36V 200mW |  | 10 | 0,127 € | 0.127 | 10 Shipped | 12-Apr-22 | 67255078 | mouser
259961553 | 25139898 | 25139898 | 20 | 11-Apr-22 | COMPLETE | PMEG3050EP,115 | 771-PMEG3050EP115 | Schottky Diodes & Rectifiers Schottky Diodes & Rectifiers PMEG3050EP/SOD128/FlatPower |  | 10 | 0,438 € | 0.438 | 10 Shipped | 12-Apr-22 | 67255078 | mouser
259961553 | 25139898 | 25139898 | 21 | 11-Apr-22 | COMPLETE | BAT54A_R1_00001 | 241-BAT54A_R1_00001 | Schottky Diodes & Rectifiers Schottky Diodes & Rectifiers 30V Schottky 0.2A |  | 10 | 0,142 € | 0.142 | 10 Shipped | 12-Apr-22 | 67255078 | mouser
259961553 | 25139898 | 25139898 | 22 | 11-Apr-22 | COMPLETE | ZMM5226B | 583-ZMM5226B | Zener Diodes Zener Diodes 0.5W 3.3V 5% |  | 10 | 0,108 € | 0.108 | 10 Shipped | 12-Apr-22 | 67255078 | mouser
259961553 | 25139898 | 25139898 | 23 | 11-Apr-22 | COMPLETE | SMAJ6.0A-W | 583-SMAJ6.0A-W | ESD Suppressors / TVS Diodes ESD Suppressors / TVS Diodes SMA 400w TVS 5% |  | 20 | 0,108 € | 0.108 | 20 Shipped | 12-Apr-22 | 67255078 | mouser
259961553 | 25139898 | 25139898 | 24 | 11-Apr-22 | COMPLETE | PRTR5V0U2X,215 | 771-PRTR5V0U2X-T/R | ESD Suppressors / TVS Diodes ESD Suppressors / TVS Diodes PRTR5V0U2X/SOT143/SOT4 |  | 15 | 0,407 € | 0.407 | 15 Shipped | 12-Apr-22 | 67255078 | mouser
259961553 | 25139898 | 25139898 | 25 | 11-Apr-22 | COMPLETE | ERB-RE5R00V | 667-ERB-RE5R00V | Surface Mount Fuses Surface Mount Fuses 5A 0603 micro chip |  | 20 | 0,211 € | 0.211 | 20 Shipped | 12-Apr-22 | 67255078 | mouser
259961553 | 25139898 | 25139898 | 26 | 11-Apr-22 | COMPLETE | RC0603JR-0710KL | 603-RC0603JR-0710KL | Thick Film Resistors - SMD Thick Film Resistors - SMD 10 kOhms 100 mW 0603 5% |  | 200 | 0,005 € | 0.005 | 200 Shipped | 12-Apr-22 | 67255078 | mouser
259961553 | 25139898 | 25139898 | 27 | 11-Apr-22 | COMPLETE | RC0603JR-07560RL | 603-RC0603JR-07560RL | Thick Film Resistors - SMD Thick Film Resistors - SMD 560 Ohms 100 mW 0603 5% |  | 30 | 0,013 € | 0.013 | 30 Shipped | 12-Apr-22 | 67255078 | mouser
259961553 | 25139898 | 25139898 | 28 | 11-Apr-22 | COMPLETE | RMC1/16-122JTP | 791-RMC1/16-122JTP | Thick Film Resistors - SMD Thick Film Resistors - SMD 0603 1K2 5% |  | 30 | 0,013 € | 0.013 | 30 Shipped | 12-Apr-22 | 67255078 | mouser
259961553 | 25139898 | 25139898 | 29 | 11-Apr-22 | COMPLETE | RC0603FR-072K2L | 603-RC0603FR-072K2L | Thick Film Resistors - SMD Thick Film Resistors - SMD 2.2 kOhms 100mW 0603 1% |  | 30 | 0,015 € | 0.015 | 30 Shipped | 12-Apr-22 | 67255078 | mouser
259961553 | 25139898 | 25139898 | 30 | 11-Apr-22 | COMPLETE | RMC1/16-472JTP | 791-RMC1/16-472JTP | Thick Film Resistors - SMD Thick Film Resistors - SMD 0603 4K7 5% |  | 30 | 0,013 € | 0.013 | 30 Shipped | 12-Apr-22 | 67255078 | mouser
259961553 | 25139898 | 25139898 | 31 | 11-Apr-22 | COMPLETE | RC0603JR-07510RL | 603-RC0603JR-07510RL | Thick Film Resistors - SMD Thick Film Resistors - SMD 510 Ohms 100 mW 0603 5% |  | 200 | 0,005 € | 0.005 | 200 Shipped | 12-Apr-22 | 67255078 | mouser
259961553 | 25139898 | 25139898 | 32 | 11-Apr-22 | COMPLETE | RC0603FR-071KL | 603-RC0603FR-071KL | Thick Film Resistors - SMD Thick Film Resistors - SMD 1 kOhms 100mW 0603 1% |  | 125 | 0,006 € | 0.006 | 125 Shipped | 12-Apr-22 | 67255078 | mouser
259961553 | 25139898 | 25139898 | 33 | 11-Apr-22 | COMPLETE | CR0603-FX-2202ELF | 652-CR0603FX-2202ELF | Thick Film Resistors - SMD Thick Film Resistors - SMD 22K ohm 1% |  | 25 | 0,014 € | 0.014 | 25 Shipped | 12-Apr-22 | 67255078 | mouser
259961553 | 25139898 | 25139898 | 34 | 11-Apr-22 | COMPLETE | CR0603-FX-6800ELF | 652-CR0603FX-6800ELF | Thick Film Resistors - SMD Thick Film Resistors - SMD 680 ohm 1% |  | 25 | 0,015 € | 0.015 | 25 Shipped | 12-Apr-22 | 67255078 | mouser
259961553 | 25139898 | 25139898 | 35 | 11-Apr-22 | COMPLETE | 301-22-RC | 301-22-RC | Thick Film Resistors - SMD Thick Film Resistors - SMD 1/10WATT 22OHMS 5% |  | 10 | 0,011 € | 0.011 | 10 Shipped | 12-Apr-22 | 67255078 | mouser
259961553 | 25139898 | 25139898 | 36 | 11-Apr-22 | COMPLETE | CR0603-J/-000ELF | 652-CR0603-J/-000ELF | Thick Film Resistors - SMD Thick Film Resistors - SMD ZERO OHM |  | 125 | 0,005 € | 0.005 | 125 Shipped | 12-Apr-22 | 67255078 | mouser
259961553 | 25139898 | 25139898 | 37 | 11-Apr-22 | COMPLETE | RC0603JR-131ML | 603-RC0603JR-131ML | Thick Film Resistors - SMD Thick Film Resistors - SMD 1 MOhms 100-200 mW 0603 5% |  | 30 | 0,013 € | 0.013 | 30 Shipped | 12-Apr-22 | 67255078 | mouser
259961553 | 25139898 | 25139898 | 38 | 11-Apr-22 | COMPLETE | RMC16K163FTP | 791-RMC16K163FTP | Thick Film Resistors - SMD Thick Film Resistors - SMD 16 kOhms 1% 1.0A AEC-Q200 |  | 10 | 0,016 € | 0.016 | 10 Shipped | 12-Apr-22 | 67255078 | mouser
259961553 | 25139898 | 25139898 | 39 | 11-Apr-22 | COMPLETE | WR06X512 JTL | 791-WR06X512JTL | Thick Film Resistors - SMD Thick Film Resistors - SMD 0603 5K1 5% Lead Free |  | 20 | 0,013 € | 0.013 | 20 Shipped | 12-Apr-22 | 67255078 | mouser
259961553 | 25139898 | 25139898 | 40 | 11-Apr-22 | COMPLETE | RC0603JR-0710ML | 603-RC0603JR-0710ML | Thick Film Resistors - SMD Thick Film Resistors - SMD 10 MOhms 100 mW 0603 5% |  | 15 | 0,013 € | 0.013 | 15 Shipped | 12-Apr-22 | 67255078 | mouser
259961553 | 25139898 | 25139898 | 41 | 11-Apr-22 | COMPLETE | CR0603-JW-331ELF | 652-CR0603-JW-331ELF | Thick Film Resistors - SMD Thick Film Resistors - SMD 330 OHM 5% |  | 10 | 0,007 € | 0.007 | 10 Shipped | 12-Apr-22 | 67255078 | mouser
259961553 | 25139898 | 25139898 | 42 | 11-Apr-22 | COMPLETE | RC0805FR-13100RL | 603-RC0805FR-13100RL | Thick Film Resistors - SMD Thick Film Resistors - SMD 100 Ohms 250 mW 0805 1% |  | 200 | 0,011 € | 0.011 | 200 Shipped | 12-Apr-22 | 67255078 | mouser
259961553 | 25139898 | 25139898 | 43 | 11-Apr-22 | COMPLETE | 301-2.2K-RC | 301-2.2K-RC | Thick Film Resistors - SMD Thick Film Resistors - SMD 1/10WATT 2.2KOHMS |  | 100 | 0,004 € | 0.004 | 100 Shipped | 12-Apr-22 | 67255078 | mouser
259961553 | 25139898 | 25139898 | 44 | 11-Apr-22 | COMPLETE | RK73B1JTTDD221J | 660-RK73B1JTTDD221J | Thick Film Resistors - SMD Thick Film Resistors - SMD 1/8W 220 OHM 5% |  | 10 | 0,019 € | 0.019 | 10 Shipped | 12-Apr-22 | 67255078 | mouser
259961553 | 25139898 | 25139898 | 45 | 11-Apr-22 | COMPLETE | 150141YB73100 | 710-150141YB73100 | Standard LEDs - SMD Standard LEDs - SMD WL-SBTW SMDBiClr Top Watrclr 3528Ylw&Blue |  | 10 | 0,30 € | 0.3 | 10 Shipped | 12-Apr-22 | 67255078 | mouser
259961553 | 25139898 | 25139898 | 46 | 11-Apr-22 | COMPLETE | TFM201610ALVA2R2MTAA | 810-TFM201610ALVA2R2 | Power Inductors - SMD Power Inductors - SMD 2.2uH 20% 152mOhm 2A AEC-Q200 |  | 10 | 0,549 € | 0.549 | 10 Shipped | 12-Apr-22 | 67255078 | mouser
259961553 | 25139898 | 25139898 | 47 | 11-Apr-22 | COMPLETE | 7447706220 | 710-7447706220 | Power Inductors - SMD Power Inductors - SMD WE-PD 22uH 3.7A DCR=41mOhms AECQ200 |  | 10 | 0,983 € | 0.983 | 10 Shipped | 12-Apr-22 | 67255078 | mouser
259961553 | 25139898 | 25139898 | 48 | 11-Apr-22 | COMPLETE | LBC3225T6R8MR | 963-LBC3225T6R8MR | Power Inductors - SMD Power Inductors - SMD 1210 6.8uH 156mOhms +/-20%Tol 620mA |  | 20 | 0,122 € | 0.122 | 20 Shipped | 12-Apr-22 | 67255078 | mouser
259961553 | 25139898 | 25139898 | 49 | 11-Apr-22 | COMPLETE | PTVS13VS1UTR,115 | 771-PTVS13VS1UTR115 | ESD Suppressors / TVS Diodes ESD Suppressors / TVS Diodes PTVS13VS1UTR/SOD123W/SOD2 |  | 10 | 0,109 € | 0.109 | 10 Shipped | 12-Apr-22 | 67255078 | mouser
259961553 | 25139898 | 25139898 | 50 | 11-Apr-22 | COMPLETE | USB4510-03-1-A | 640-USB4510031A | USB Connectors USB Connectors USB C Rec 16P 3u" Mid Mnt 1.6mm O-set SMT L = 6.5mm S-Spring |  | 10 | 0,574 € | 0.574 | 10 Shipped | 12-Apr-22 | 67255078 | mouser
259961553 | 25139898 | 25139898 | 51 | 11-Apr-22 | COMPLETE | BZD27B180P-M3-08 | 78-BZD27B180P-M3-08 | Zener Diodes Zener Diodes ZENER DIODE SMF AEC-Q101 Qualified |  | 15 | 0,329 € | 0.329 | 15 Shipped | 12-Apr-22 | 67255078 | mouser
259961553 | 25139898 | 25139898 | 52 | 11-Apr-22 | COMPLETE | TPSMB210A | 576-TPSMB210A | ESD Suppressors / TVS Diodes ESD Suppressors / TVS Diodes 600W 210V AEC-Q101 5% Uni-Directional |  | 10 | 0,562 € | 0.562 | 10 Shipped | 12-Apr-22 | 67255078 | mouser
259961553 | 25139898 | 25139898 | 53 | 11-Apr-22 | COMPLETE | DS01C-254-S-12BE | 490-DS01C-254-S-12BE | DIP Switches/SIP Switches DIP Switches/SIP Switches 1 12 Positions, Through Hole, 2.54 mm Pitch, Slide Actuator, DIP Switch |  | 6 | 0,974 € | 0.974 | 6 Shipped | 12-Apr-22 | 67255078 | mouser
260870537 | 25766667 | 25766667 | 1 | 08-Jun-22 | COMPLETE | TOL-12878 | 474-TOL-12878 | SparkFun Accessories SparkFun Accessories Solder Paste - 50g (Lead Free) |  | 1 | 16,73 € | 16.73 | 1 Shipped | 08-Jun-22 | 68321603 | mouser
260870537 | 25766667 | 25766667 | 2 | 08-Jun-22 | COMPLETE | SOLDERWICK1.5 | 910-SOLDERWICK1.5 | Desoldering Braid / Solder Removal Desoldering Braid / Solder Removal 1.5mm Solder Wick (#2 Yellow) - No Clean |  | 3 | 1,89 € | 1.89 | 3 Shipped | 08-Jun-22 | 68321603 | mouser
260870537 | 25766667 | 25766667 | 3 | 08-Jun-22 | COMPLETE | CQ4300LF | 910-CQ4300LF | Soldering Flux Soldering Flux Liquid Flux Alcohol-Based No-Clean Water-Washable in 10ml (0.34oz) Pen w/tip |  | 1 | 7,55 € | 7.55 | 1 Shipped | 08-Jun-22 | 68321603 | mouser
260870537 | 25766667 | 25766667 | 4 | 08-Jun-22 | COMPLETE | USB4105-GF-A-120 | 640-USB4105-GF-A-120 | USB Connectors USB Connectors USB Type C, 2.0 SMT PCB Top Mnt 1.20mm |  | 11 | 0,62 € | 0.62 | 11 Shipped | 08-Jun-22 | 68321603 | mouser
260870537 | 25766667 | 25766667 | 5 | 08-Jun-22 | COMPLETE | MR12W1005FTL | 791-MR12W1005FTL | Thick Film Resistors - SMD Thick Film Resistors - SMD 1206 10M0 1% Lead Free |  | 20 | 0,083 € | 0.083 | 20 Shipped | 08-Jun-22 | 68321603 | mouser
260870537 | 25766667 | 25766667 | 6 | 08-Jun-22 | COMPLETE | 0603N9R1C500CT | 791-0603N9R1C500CT | Multilayer Ceramic Capacitors MLCC - SMD/SMT Multilayer Ceramic Capacitors MLCC - SMD/SMT 0603 MLCC NPO 9.1 pF, +/- 0.25pF 50 V T&R GP |  | 20 | 0,053 € | 0.053 | 20 Shipped | 08-Jun-22 | 68321603 | mouser
260870537 | 25766667 | 25766667 | 7 | 08-Jun-22 | COMPLETE | 0603N100F500CT | 791-0603N100F500CT | Multilayer Ceramic Capacitors MLCC - SMD/SMT Multilayer Ceramic Capacitors MLCC - SMD/SMT 0603 MLCC NPO 10 pF, +/- 1% 50 V T&R GP |  | 20 | 0,024 € | 0.024 | 20 Shipped | 08-Jun-22 | 68321603 | mouser
260870537 | 25766667 | 25766667 | 8 | 08-Jun-22 | COMPLETE | ESP32-DevKitC-32D | 356-ESP32-DEVKITC32D | WiFi Development Tools - 802.11 WiFi Development Tools - 802.11 ESP32 General Development Kit, ESP32-WROOM-32D on the board |  | 1 | 9,50 € | 9.5 | 1 Shipped | 08-Jun-22 | 68321603 | mouser
260870537 | 25766667 | 25766667 | 9 | 08-Jun-22 | COMPLETE | CC0603CRNPO9BN8R2 | 603-CC603CRNPO9BN8R2 | Multilayer Ceramic Capacitors MLCC - SMD/SMT Multilayer Ceramic Capacitors MLCC - SMD/SMT 50 V 8.2pF C0G 0603 Tol 0.25pF |  | 15 | 0,059 € | 0.059 | 15 Shipped | 08-Jun-22 | 68321603 | mouser
261078849 | 25910042 | 25910042 | 1 | 22-Jun-22 | COMPLETE | SI7119DN-T1-E3 | 781-SI7119DN-T1-E3 | MOSFET MOSFET -200V Vds 20V Vgs PowerPAK 1212-8 |  | 100 | 0,697 € | 0.697 | 100 Shipped | 01-Jul-22 | 68715414 | mouser
261078849 | 25910042 | 25910042 | 2 | 22-Jun-22 | COMPLETE | STN4NF20L | 511-STN4NF20L | MOSFET MOSFET N-Ch 200V 1.1 Ohm 1A LGC STripFET II |  | 100 | 0,556 € | 0.556 | 100 Shipped | 22-Jun-22 | 68563476 | mouser
261078849 | 25910042 | 25910042 | 3 | 22-Jun-22 | COMPLETE | RZM001P02T2L | 755-RZM001P02T2L | MOSFET MOSFET 1.2V Drive Pch MOSFET |  | 100 | 0,096 € | 0.096 | 100 Shipped | 22-Jun-22 | 68563476 | mouser
262770403 | 27088815 | 27088815 | 1 | 23-Oct-22 | COMPLETE | GA3459-BL | 994-GA3459-BL | Audio Transformers / Signal Transformers Audio Transformers / Signal Transformers GA3459 for LT3751 500V 20A |  | 3 | 9,13 € | 9.13 | 3 Shipped | 24-Oct-22 | 70627575 | mouser
262770403 | 27088815 | 27088815 | 2 | 23-Oct-22 | COMPLETE | GA3460-BL | 994-GA3460-BL | Audio Transformers / Signal Transformers Audio Transformers / Signal Transformers GA3460 for LT3751 500V 50A |  | 2 | 12,10 € | 12.1 | 2 Shipped | 24-Oct-22 | 70627575 | mouser
262770403 | 27088815 | 27088815 | 3 | 23-Oct-22 | COMPLETE | PHE426KJ5330JR05 | 80-PHE426KJ5330JR05 | Film Capacitors Film Capacitors 400V 0.033uF 5% LS=5mm |  | 12 | 0,25 € | 0.25 | 12 Shipped | 24-Oct-22 | 70627575 | mouser
262770403 | 27088815 | 27088815 | 4 | 23-Oct-22 | COMPLETE | R82MC2470Z350K | 80-R82MC2470Z350K | Film Capacitors Film Capacitors 400V 0.047uF 10% LS=5mm AEC-Q200 |  | 12 | 0,288 € | 0.288 | 12 Shipped | 24-Oct-22 | 70627575 | mouser
262770403 | 27088815 | 27088815 | 5 | 23-Oct-22 | COMPLETE | B32922C3224K | 871-B32922C3224K | Safety Capacitors Safety Capacitors 0.22uF 10% 305Vac MKP X2, LS 15MM |  | 12 | 0,294 € | 0.294 | 12 Shipped | 24-Oct-22 | 70627575 | mouser
262770403 | 27088815 | 27088815 | 6 | 23-Oct-22 | COMPLETE | SSR10H-22034 | 80-SSR10H-22034 | Common Mode Chokes / Filters Common Mode Chokes / Filters 3.4mH 2.2A 11.5mm DCR=110mOhms |  | 4 | 1,97 € | 1.97 | 4 Shipped | 24-Oct-22 | 70627575 | mouser
262770403 | 27088815 | 27088815 | 7 | 23-Oct-22 | COMPLETE | R82IC2220DQ60J | 80-R82IC2220DQ60J | Film Capacitors Film Capacitors 250V 0.022uF 5% LS=5mm AEC-Q200 |  | 5 | 0,31 € | 0.31 | 5 Shipped | 24-Oct-22 | 70627575 | mouser
262770403 | 27088815 | 27088815 | 8 | 23-Oct-22 | COMPLETE | CR1206-JW-204ELF | 652-CR1206JW-204ELF | Thick Film Resistors - SMD Thick Film Resistors - SMD 200K 5% |  | 20 | 0,042 € | 0.042 | 20 Shipped | 24-Oct-22 | 70627575 | mouser
262770403 | 27088815 | 27088815 | 9 | 23-Oct-22 | COMPLETE | CR1206-FX-2203ELF | 652-CR1206FX-2203ELF | Thick Film Resistors - SMD Thick Film Resistors - SMD 220K 1% |  | 20 | 0,045 € | 0.045 | 20 Shipped | 24-Oct-22 | 70627575 | mouser
262770403 | 27088815 | 27088815 | 10 | 23-Oct-22 | COMPLETE | WHE1R0FET | 588-WHE1R0FET | Wirewound Resistors - Through Hole Wirewound Resistors - Through Hole 5W 1 ohm 1% |  | 10 | 1,07 € | 1.07 | 10 Shipped | 24-Oct-22 | 70627575 | mouser
262770403 | 27088815 | 27088815 | 11 | 23-Oct-22 | COMPLETE | PM5022-102M-RC | 542-PM5022-102M-RC | Power Inductors - SMD Power Inductors - SMD 1.0mH 20% |  | 4 | 0,95 € | 0.95 | 4 Shipped | 24-Oct-22 | 70627575 | mouser
262770403 | 27088815 | 27088815 | 12 | 23-Oct-22 | COMPLETE | SRR1280-103K | 652-SRR1280-103K | Power Inductors - SMD Power Inductors - SMD Ind12.5x12.5x7.5mm,10m10%6A,shdSMD |  | 4 | 1,26 € | 1.26 | 4 Shipped | 24-Oct-22 | 70627575 | mouser
262770403 | 27088815 | 27088815 | 13 | 23-Oct-22 | COMPLETE | PM5022-471M-RC | 542-PM5022-471M-RC | Power Inductors - SMD Power Inductors - SMD 470uH 20% |  | 4 | 1,01 € | 1.01 | 4 Shipped | 24-Oct-22 | 70627575 | mouser
262770403 | 27088815 | 27088815 | 14 | 23-Oct-22 | COMPLETE | RCP1317NP-222L | 851-RCP1317NP-222L | Power Inductors - Leaded Power Inductors - Leaded 2200uH 0.52A 15% THRU HOLE INDUCTOR |  | 4 | 1,16 € | 1.16 | 4 Shipped | 24-Oct-22 | 70627575 | mouser
262770403 | 27088815 | 27088815 | 15 | 23-Oct-22 | COMPLETE | 10129378-910002BLF | 649-1012937891002BLF | Headers & Wire Housings Headers & Wire Housings ECONOSTIK HEADER SR VT TH 1X10 |  | 20 | 0,191 € | 0.191 | 20 Shipped | 24-Oct-22 | 70627575 | mouser
 |  |  | 1 |  |  | DS04-254-2-12BK-SMT | 2223-DS04-254-2-12BK-SMT-ND | DIP SWITCH, SPST, 2.54 PITCH, FL |  | 8 | 1,31000 | 1.31 | 10,48 € |  |  | digikey
 |  |  | 2 |  |  | 54-00164 | 839-54-00164CT-ND | CONN JACK R/A SMT 5.5X2.1MM |  | 10 | 0,58800 | 0.588 | 5,88 € |  |  | digikey
 |  |  | 3 |  |  | 3220-10-0100-00 | 1175-1627-ND | CONN HEADER VERT 10POS 1.27MM |  | 10 | 0,51300 | 0.513 | 5,13 € |  |  | digikey
 |  |  | 4 |  |  | 6N137S-TA1 | 160-1794-1-ND | OPTOISO 5KV 1CH OPEN COLL 8SMD |  | 200 | 0,33060 | 0.3306 | 66,12 € |  |  | digikey
 |  |  | 5 |  |  | MAX485CSA+T | MAX485CSA+TCT-ND | IC TRANSCEIVER HALF 1/1 8SOIC |  | 10 | 3,24200 | 3.242 | 32,42 € |  |  | digikey
