muvi/ELController/Inventory Management/fill supply/mouser/259721466.xls

Sales Order No: | Web Order No: | PO Number: | Line No. | Order Date: | Order Status: | Mouser No: | Mfr. No: | Desc.: | Customer No | Order Qty. | Ext. (EUR) | Price (EUR) | Status | Date | Invoice No.
259721466 | 24979255 | 24979255 | 1 | 28-Mar-22 | COMPLETE | 994-RFS1317-335KL | RFS1317-335KL | Power Inductors - Leaded Power Inductors - Leaded 3.3 mH Shld 10% 410mA 2.38ohms |  | 100 | 1,18 € | 1,18 € | 100 Shipped | 28-Mar-22 | 66983413
