muvi/ELController/Inventory Management/fill supply/mouser/261078849.xls

Sales Order No: | Web Order No: | PO Number: | Line No. | Order Date: | Order Status: | Mouser No: | Mfr. No: | Desc.: | Customer No | Order Qty. | Ext. (EUR) | Price (EUR) | Status | Date | Invoice No.
261078849 | 25910042 | 25910042 | 1 | 22-Jun-22 | COMPLETE | 781-SI7119DN-T1-E3 | SI7119DN-T1-E3 | MOSFET MOSFET -200V Vds 20V Vgs PowerPAK 1212-8 |  | 100 | 0,697 € | 0,697 € | 100 Shipped | 01-Jul-22 | 68715414
261078849 | 25910042 | 25910042 | 2 | 22-Jun-22 | COMPLETE | 511-STN4NF20L | STN4NF20L | MOSFET MOSFET N-Ch 200V 1.1 Ohm 1A LGC STripFET II |  | 100 | 0,556 € | 0,556 € | 100 Shipped | 22-Jun-22 | 68563476
261078849 | 25910042 | 25910042 | 3 | 22-Jun-22 | COMPLETE | 755-RZM001P02T2L | RZM001P02T2L | MOSFET MOSFET 1.2V Drive Pch MOSFET |  | 100 | 0,096 € | 0,096 € | 100 Shipped | 22-Jun-22 | 68563476
