muvi/ELController/Ordering/crazy inductor/Basket_Mar06_0542PM.xls

Part Number | Data Sheet | Series | Material Core | Inductance (μH) | Tolerance | Current Rating (A) | Current Saturation (A) | Shielding | DCR (Ohms) | Q | Q Test Freq (MHz) | SRF (MHz) | Ratings | Operating Temp (°C) | Test Freq (MHz) | Dimensions (mm) | Engineering | Buy Now
1110-8R2M-RC | https://www.bourns.comhttp://www.bourns.com/docs/Product-Datasheets/1110_series.pdf | 1110 | Ferrite | 8.2 | 20 | 9 |  | Unshielded | .009 |  |  |  | - | -55 - 105 |  | 16.76 x 16.76 x 21.34 | https://componentsearchengine.com/part-view/1110-8R2M-RC/Bourns | https://www.bourns.com/inventory-search-results?PARTS=1110-8R2M-RC
1110-820K-RC | https://www.bourns.comhttp://www.bourns.com/docs/Product-Datasheets/1110_series.pdf | 1110 | Ferrite | 82 | 10 | 2.8 |  | Unshielded | .083 |  |  |  | - | -55 - 105 |  | 16.76 x 16.76 x 21.34 | https://componentsearchengine.com/part-view/1110-820K-RC/Bourns | https://www.bourns.com/inventory-search-results?PARTS=1110-820K-RC
1110-6R8M-RC | https://www.bourns.comhttp://www.bourns.com/docs/Product-Datasheets/1110_series.pdf | 1110 | Ferrite | 6.8 | 20 | 9 |  | Unshielded | .008 |  |  |  | - | -55 - 105 |  | 16.76 x 16.76 x 21.34 | https://componentsearchengine.com/part-view/1110-6R8M-RC/Bourns | https://www.bourns.com/inventory-search-results?PARTS=1110-6R8M-RC
1110-5R6M-RC | https://www.bourns.comhttp://www.bourns.com/docs/Product-Datasheets/1110_series.pdf | 1110 | Ferrite | 5.6 | 20 | 9 |  | Unshielded | .007 |  |  |  | - | -55 - 105 |  | 16.76 x 16.76 x 21.34 | https://componentsearchengine.com/part-view/1110-5R6M-RC/Bourns | https://www.bourns.com/inventory-search-results?PARTS=1110-5R6M-RC
1110-561K-RC | https://www.bourns.comhttp://www.bourns.com/docs/Product-Datasheets/1110_series.pdf | 1110 | Ferrite | 560 | 10 | .8 |  | Unshielded | .696 |  |  |  | - | -55 - 105 |  | 16.76 x 16.76 x 21.34 | https://componentsearchengine.com/part-view/1110-561K-RC/Bourns | https://www.bourns.com/inventory-search-results?PARTS=1110-561K-RC
1110-560K-RC | https://www.bourns.comhttp://www.bourns.com/docs/Product-Datasheets/1110_series.pdf | 1110 | Ferrite | 56 | 10 | 2.8 |  | Unshielded | .069 |  |  |  | - | -55 - 105 |  | 16.76 x 16.76 x 21.34 | https://componentsearchengine.com/part-view/1110-560K-RC/Bourns | https://www.bourns.com/inventory-search-results?PARTS=1110-560K-RC
1110-4R7M-RC | https://www.bourns.comhttp://www.bourns.com/docs/Product-Datasheets/1110_series.pdf | 1110 | Ferrite | 4.7 | 20 | 9 |  | Unshielded | .007 |  |  |  | - | -55 - 105 |  | 16.76 x 16.76 x 21.34 | https://componentsearchengine.com/part-view/1110-4R7M-RC/Bourns | https://www.bourns.com/inventory-search-results?PARTS=1110-4R7M-RC
1110-471K-RC | https://www.bourns.comhttp://www.bourns.com/docs/Product-Datasheets/1110_series.pdf | 1110 | Ferrite | 470 | 10 | .8 |  | Unshielded | .636 |  |  |  | - | -55 - 105 |  | 16.76 x 16.76 x 21.34 | https://componentsearchengine.com/part-view/1110-471K-RC/Bourns | https://www.bourns.com/inventory-search-results?PARTS=1110-471K-RC
1110-470K-RC | https://www.bourns.comhttp://www.bourns.com/docs/Product-Datasheets/1110_series.pdf | 1110 | Ferrite | 47 | 10 | 2.8 |  | Unshielded | .062 |  |  |  | - | -55 - 105 |  | 16.76 x 16.76 x 21.34 | https://componentsearchengine.com/part-view/1110-470K-RC/Bourns | https://www.bourns.com/inventory-search-results?PARTS=1110-470K-RC
1110-3R9M-RC | https://www.bourns.comhttp://www.bourns.com/docs/Product-Datasheets/1110_series.pdf | 1110 | Ferrite | 3.9 | 20 | 9 |  | Unshielded | .006 |  |  |  | - | -55 - 105 |  | 16.76 x 16.76 x 21.34 | https://componentsearchengine.com/part-view/1110-3R9M-RC/Bourns | https://www.bourns.com/inventory-search-results?PARTS=1110-3R9M-RC
1110-3R3M-RC | https://www.bourns.comhttp://www.bourns.com/docs/Product-Datasheets/1110_series.pdf | 1110 | Ferrite | 3.3 | 20 | 9 |  | Unshielded | .005 |  |  |  | - | -55 - 105 |  | 16.76 x 16.76 x 21.34 | https://componentsearchengine.com/part-view/1110-3R3M-RC/Bourns | https://www.bourns.com/inventory-search-results?PARTS=1110-3R3M-RC
1110-391K-RC | https://www.bourns.comhttp://www.bourns.com/docs/Product-Datasheets/1110_series.pdf | 1110 | Ferrite | 390 | 10 | 1 |  | Unshielded | .46 |  |  |  | - | -55 - 105 |  | 16.76 x 16.76 x 21.34 | https://componentsearchengine.com/part-view/1110-391K-RC/Bourns | https://www.bourns.com/inventory-search-results?PARTS=1110-391K-RC
1110-390K-RC | https://www.bourns.comhttp://www.bourns.com/docs/Product-Datasheets/1110_series.pdf | 1110 | Ferrite | 39 | 10 | 4 |  | Unshielded | .046 |  |  |  | - | -55 - 105 |  | 16.76 x 16.76 x 21.34 | https://componentsearchengine.com/part-view/1110-390K-RC/Bourns | https://www.bourns.com/inventory-search-results?PARTS=1110-390K-RC
1110-331K-RC | https://www.bourns.comhttp://www.bourns.com/docs/Product-Datasheets/1110_series.pdf | 1110 | Ferrite | 330 | 10 | 1.3 |  | Unshielded | .336 |  |  |  | - | -55 - 105 |  | 16.76 x 16.76 x 21.34 | https://componentsearchengine.com/part-view/1110-331K-RC/Bourns | https://www.bourns.com/inventory-search-results?PARTS=1110-331K-RC
1110-330K-RC | https://www.bourns.comhttp://www.bourns.com/docs/Product-Datasheets/1110_series.pdf | 1110 | Ferrite | 33 | 10 | 4 |  | Unshielded | .04 |  |  |  | - | -55 - 105 |  | 16.76 x 16.76 x 21.34 | https://componentsearchengine.com/part-view/1110-330K-RC/Bourns | https://www.bourns.com/inventory-search-results?PARTS=1110-330K-RC
1110-2R7M-RC | https://www.bourns.comhttp://www.bourns.com/docs/Product-Datasheets/1110_series.pdf | 1110 | Ferrite | 2.7 | 20 | 9 |  | Unshielded | .005 |  |  |  | - | -55 - 105 |  | 16.76 x 16.76 x 21.34 | https://componentsearchengine.com/part-view/1110-2R7M-RC/Bourns | https://www.bourns.com/inventory-search-results?PARTS=1110-2R7M-RC
1110-2R2M-RC | https://www.bourns.comhttp://www.bourns.com/docs/Product-Datasheets/1110_series.pdf | 1110 | Ferrite | 2.2 | 20 | 9 |  | Unshielded | .005 |  |  |  | - | -55 - 105 |  | 16.76 x 16.76 x 21.34 | https://componentsearchengine.com/part-view/1110-2R2M-RC/Bourns | https://www.bourns.com/inventory-search-results?PARTS=1110-2R2M-RC
1110-271K-RC | https://www.bourns.comhttp://www.bourns.com/docs/Product-Datasheets/1110_series.pdf | 1110 | Ferrite | 270 | 10 | 1.6 |  | Unshielded | .3 |  |  |  | - | -55 - 105 |  | 16.76 x 16.76 x 21.34 | https://componentsearchengine.com/part-view/1110-271K-RC/Bourns | https://www.bourns.com/inventory-search-results?PARTS=1110-271K-RC
1110-270K-RC | https://www.bourns.comhttp://www.bourns.com/docs/Product-Datasheets/1110_series.pdf | 1110 | Ferrite | 27 | 10 | 4.5 |  | Unshielded | .03 |  |  |  | - | -55 - 105 |  | 16.76 x 16.76 x 21.34 | https://componentsearchengine.com/part-view/1110-270K-RC/Bourns | https://www.bourns.com/inventory-search-results?PARTS=1110-270K-RC
1110-221K-RC | https://www.bourns.comhttp://www.bourns.com/docs/Product-Datasheets/1110_series.pdf | 1110 | Ferrite | 220 | 10 | 1.6 |  | Unshielded | .24 |  |  |  | - | -55 - 105 |  | 16.76 x 16.76 x 21.34 | https://componentsearchengine.com/part-view/1110-221K-RC/Bourns | https://www.bourns.com/inventory-search-results?PARTS=1110-221K-RC
1110-220K-RC | https://www.bourns.comhttp://www.bourns.com/docs/Product-Datasheets/1110_series.pdf | 1110 | Ferrite | 22 | 10 | 5.5 |  | Unshielded | .02 |  |  |  | - | -55 - 105 |  | 16.76 x 16.76 x 21.34 | https://componentsearchengine.com/part-view/1110-220K-RC/Bourns | https://www.bourns.com/inventory-search-results?PARTS=1110-220K-RC
1110-1R8M-RC | https://www.bourns.comhttp://www.bourns.com/docs/Product-Datasheets/1110_series.pdf | 1110 | Ferrite | 1.8 | 20 | 9 |  | Unshielded | .004 |  |  |  | - | -55 - 105 |  | 16.76 x 16.76 x 21.34 | https://componentsearchengine.com/part-view/1110-1R8M-RC/Bourns | https://www.bourns.com/inventory-search-results?PARTS=1110-1R8M-RC
1110-1R5M-RC | https://www.bourns.comhttp://www.bourns.com/docs/Product-Datasheets/1110_series.pdf | 1110 | Ferrite | 1.5 | 20 | 9 |  | Unshielded | .004 |  |  |  | - | -55 - 105 |  | 16.76 x 16.76 x 21.34 | https://componentsearchengine.com/part-view/1110-1R5M-RC/Bourns | https://www.bourns.com/inventory-search-results?PARTS=1110-1R5M-RC
1110-1R2M-RC | https://www.bourns.comhttp://www.bourns.com/docs/Product-Datasheets/1110_series.pdf | 1110 | Ferrite | 1.2 | 20 | 9 |  | Unshielded | .003 |  |  |  | - | -55 - 105 |  | 16.76 x 16.76 x 21.34 | https://componentsearchengine.com/part-view/1110-1R2M-RC/Bourns | https://www.bourns.com/inventory-search-results?PARTS=1110-1R2M-RC
1110-1R0M-RC | https://www.bourns.comhttp://www.bourns.com/docs/Product-Datasheets/1110_series.pdf | 1110 | Ferrite | 1 | 20 | 9 |  | Unshielded | .003 |  |  |  | - | -55 - 105 |  | 16.76 x 16.76 x 21.34 | https://componentsearchengine.com/part-view/1110-1R0M-RC/Bourns | https://www.bourns.com/inventory-search-results?PARTS=1110-1R0M-RC
1110-181K-RC | https://www.bourns.comhttp://www.bourns.com/docs/Product-Datasheets/1110_series.pdf | 1110 | Ferrite | 180 | 10 | 1.6 |  | Unshielded | .217 |  |  |  | - | -55 - 105 |  | 16.76 x 16.76 x 21.34 | https://componentsearchengine.com/part-view/1110-181K-RC/Bourns | https://www.bourns.com/inventory-search-results?PARTS=1110-181K-RC
1110-180K-RC | https://www.bourns.comhttp://www.bourns.com/docs/Product-Datasheets/1110_series.pdf | 1110 | Ferrite | 18 | 10 | 7.2 |  | Unshielded | .016 |  |  |  | - | -55 - 105 |  | 16.76 x 16.76 x 21.34 | https://componentsearchengine.com/part-view/1110-180K-RC/Bourns | https://www.bourns.com/inventory-search-results?PARTS=1110-180K-RC
1110-151K-RC | https://www.bourns.comhttp://www.bourns.com/docs/Product-Datasheets/1110_series.pdf | 1110 | Ferrite | 150 | 10 | 1.6 |  | Unshielded | .181 |  |  |  | - | -55 - 105 |  | 16.76 x 16.76 x 21.34 | https://componentsearchengine.com/part-view/1110-151K-RC/Bourns | https://www.bourns.com/inventory-search-results?PARTS=1110-151K-RC
1110-150K-RC | https://www.bourns.comhttp://www.bourns.com/docs/Product-Datasheets/1110_series.pdf | 1110 | Ferrite | 15 | 10 | 7.2 |  | Unshielded | .015 |  |  |  | - | -55 - 105 |  | 16.76 x 16.76 x 21.34 | https://componentsearchengine.com/part-view/1110-150K-RC/Bourns | https://www.bourns.com/inventory-search-results?PARTS=1110-150K-RC
1110-121K-RC | https://www.bourns.comhttp://www.bourns.com/docs/Product-Datasheets/1110_series.pdf | 1110 | Ferrite | 120 | 10 | 2 |  | Unshielded | .127 |  |  |  | - | -55 - 105 |  | 16.76 x 16.76 x 21.34 | https://componentsearchengine.com/part-view/1110-121K-RC/Bourns | https://www.bourns.com/inventory-search-results?PARTS=1110-121K-RC
1110-120K-RC | https://www.bourns.comhttp://www.bourns.com/docs/Product-Datasheets/1110_series.pdf | 1110 | Ferrite | 12 | 10 | 9 |  | Unshielded | .011 |  |  |  | - | -55 - 105 |  | 16.76 x 16.76 x 21.34 | https://componentsearchengine.com/part-view/1110-120K-RC/Bourns | https://www.bourns.com/inventory-search-results?PARTS=1110-120K-RC
1110-101K-RC | https://www.bourns.comhttp://www.bourns.com/docs/Product-Datasheets/1110_series.pdf | 1110 | Ferrite | 100 | 10 | 2.8 |  | Unshielded | .095 |  |  |  | - | -55 - 105 |  | 16.76 x 16.76 x 21.34 | https://componentsearchengine.com/part-view/1110-101K-RC/Bourns | https://www.bourns.com/inventory-search-results?PARTS=1110-101K-RC
1110-100K-RC | https://www.bourns.comhttp://www.bourns.com/docs/Product-Datasheets/1110_series.pdf | 1110 | Ferrite | 10 | 10 | 9 |  | Unshielded | .01 |  |  |  | - | -55 - 105 |  | 16.76 x 16.76 x 21.34 | https://componentsearchengine.com/part-view/1110-100K-RC/Bourns | https://www.bourns.com/inventory-search-results?PARTS=1110-100K-RC
1120-820K-RC | https://www.bourns.comhttp://www.bourns.com/docs/Product-Datasheets/1120_series.pdf | 1120 | Ferrite | 82 | 10 | 4.8 |  | Unshielded | .06 |  |  |  | - | -55 - 105 |  | 20.57 x 20.57 x 21.34 | https://componentsearchengine.com/part-view/1120-820K-RC/Bourns | https://www.bourns.com/inventory-search-results?PARTS=1120-820K-RC
1120-6R8M-RC | https://www.bourns.comhttp://www.bourns.com/docs/Product-Datasheets/1120_series.pdf | 1120 | Ferrite | 6.8 | 20 | 11.4 |  | Unshielded | .007 |  |  |  | - | -55 - 105 |  | 20.57 x 20.57 x 21.34 | https://componentsearchengine.com/part-view/1120-6R8M-RC/Bourns | https://www.bourns.com/inventory-search-results?PARTS=1120-6R8M-RC
1120-681K-RC | https://www.bourns.comhttp://www.bourns.com/docs/Product-Datasheets/1120_series.pdf | 1120 | Ferrite | 680 | 10 | 1.6 |  | Unshielded | .43 |  |  |  | - | -55 - 105 |  | 20.57 x 20.57 x 21.34 | https://componentsearchengine.com/part-view/1120-681K-RC/Bourns | https://www.bourns.com/inventory-search-results?PARTS=1120-681K-RC
1120-680K-RC | https://www.bourns.comhttp://www.bourns.com/docs/Product-Datasheets/1120_series.pdf | 1120 | Ferrite | 68 | 10 | 4.8 |  | Unshielded | .053 |  |  |  | - | -55 - 105 |  | 20.57 x 20.57 x 21.34 | https://componentsearchengine.com/part-view/1120-680K-RC/Bourns | https://www.bourns.com/inventory-search-results?PARTS=1120-680K-RC
1120-561K-RC | https://www.bourns.comhttp://www.bourns.com/docs/Product-Datasheets/1120_series.pdf | 1120 | Ferrite | 560 | 10 | 1.6 |  | Unshielded | .388 |  |  |  | - | -55 - 105 |  | 20.57 x 20.57 x 21.34 | https://componentsearchengine.com/part-view/1120-561K-RC/Bourns | https://www.bourns.com/inventory-search-results?PARTS=1120-561K-RC
1120-4R7M-RC | https://www.bourns.comhttp://www.bourns.com/docs/Product-Datasheets/1120_series.pdf | 1120 | Ferrite | 4.7 | 20 | 11.4 |  | Unshielded | .005 |  |  |  | - | -55 - 105 |  | 20.57 x 20.57 x 21.34 | https://componentsearchengine.com/part-view/1120-4R7M-RC/Bourns | https://www.bourns.com/inventory-search-results?PARTS=1120-4R7M-RC
1120-471K-RC | https://www.bourns.comhttp://www.bourns.com/docs/Product-Datasheets/1120_series.pdf | 1120 | Ferrite | 470 | 10 | 1.6 |  | Unshielded | .355 |  |  |  | - | -55 - 105 |  | 20.57 x 20.57 x 21.34 | https://componentsearchengine.com/part-view/1120-471K-RC/Bourns | https://www.bourns.com/inventory-search-results?PARTS=1120-471K-RC
1120-470K-RC | https://www.bourns.comhttp://www.bourns.com/docs/Product-Datasheets/1120_series.pdf | 1120 | Ferrite | 47 | 10 | 5.5 |  | Unshielded | .035 |  |  |  | - | -55 - 105 |  | 20.57 x 20.57 x 21.34 | https://componentsearchengine.com/part-view/1120-470K-RC/Bourns | https://www.bourns.com/inventory-search-results?PARTS=1120-470K-RC
1120-3R9M-RC | https://www.bourns.comhttp://www.bourns.com/docs/Product-Datasheets/1120_series.pdf | 1120 | Ferrite | 3.9 | 20 | 11.4 |  | Unshielded | .005 |  |  |  | - | -55 - 105 |  | 20.57 x 20.57 x 21.34 | https://componentsearchengine.com/part-view/1120-3R9M-RC/Bourns | https://www.bourns.com/inventory-search-results?PARTS=1120-3R9M-RC
1120-3R3M-RC | https://www.bourns.comhttp://www.bourns.com/docs/Product-Datasheets/1120_series.pdf | 1120 | Ferrite | 3.3 | 20 | 11.4 |  | Unshielded | .005 |  |  |  | - | -55 - 105 |  | 20.57 x 20.57 x 21.34 | https://componentsearchengine.com/part-view/1120-3R3M-RC/Bourns | https://www.bourns.com/inventory-search-results?PARTS=1120-3R3M-RC
1120-390K-RC | https://www.bourns.comhttp://www.bourns.com/docs/Product-Datasheets/1120_series.pdf | 1120 | Ferrite | 39 | 10 | 5.5 |  | Unshielded | .03 |  |  |  | - | -55 - 105 |  | 20.57 x 20.57 x 21.34 | https://componentsearchengine.com/part-view/1120-390K-RC/Bourns | https://www.bourns.com/inventory-search-results?PARTS=1120-390K-RC
1120-331K-RC | https://www.bourns.comhttp://www.bourns.com/docs/Product-Datasheets/1120_series.pdf | 1120 | Ferrite | 330 | 10 | 1.6 |  | Unshielded | .305 |  |  |  | - | -55 - 105 |  | 20.57 x 20.57 x 21.34 | https://componentsearchengine.com/part-view/1120-331K-RC/Bourns | https://www.bourns.com/inventory-search-results?PARTS=1120-331K-RC
1120-330K-RC | https://www.bourns.comhttp://www.bourns.com/docs/Product-Datasheets/1120_series.pdf | 1120 | Ferrite | 33 | 10 | 5.5 |  | Unshielded | .029 |  |  |  | - | -55 - 105 |  | 20.57 x 20.57 x 21.34 | https://componentsearchengine.com/part-view/1120-330K-RC/Bourns | https://www.bourns.com/inventory-search-results?PARTS=1120-330K-RC
1120-271K-RC | https://www.bourns.comhttp://www.bourns.com/docs/Product-Datasheets/1120_series.pdf | 1120 | Ferrite | 270 | 10 | 2 |  | Unshielded | .213 |  |  |  | - | -55 - 105 |  | 20.57 x 20.57 x 21.34 | https://componentsearchengine.com/part-view/1120-271K-RC/Bourns | https://www.bourns.com/inventory-search-results?PARTS=1120-271K-RC
1120-270K-RC | https://www.bourns.comhttp://www.bourns.com/docs/Product-Datasheets/1120_series.pdf | 1120 | Ferrite | 27 | 10 | 5.5 |  | Unshielded | .026 |  |  |  | - | -55 - 105 |  | 20.57 x 20.57 x 21.34 | https://componentsearchengine.com/part-view/1120-270K-RC/Bourns | https://www.bourns.com/inventory-search-results?PARTS=1120-270K-RC
1120-222K-RC | https://www.bourns.comhttp://www.bourns.com/docs/Product-Datasheets/1120_series.pdf | 1120 | Ferrite | 2200 | 10 | .8 |  | Unshielded | 1.54 |  |  |  | - | -55 - 105 |  | 20.57 x 20.57 x 21.34 | https://componentsearchengine.com/part-view/1120-222K-RC/Bourns | https://www.bourns.com/inventory-search-results?PARTS=1120-222K-RC
1120-221K-RC | https://www.bourns.comhttp://www.bourns.com/docs/Product-Datasheets/1120_series.pdf | 1120 | Ferrite | 220 | 10 | 2.8 |  | Unshielded | .15 |  |  |  | - | -55 - 105 |  | 20.57 x 20.57 x 21.34 | https://componentsearchengine.com/part-view/1120-221K-RC/Bourns | https://www.bourns.com/inventory-search-results?PARTS=1120-221K-RC
1120-220K-RC | https://www.bourns.comhttp://www.bourns.com/docs/Product-Datasheets/1120_series.pdf | 1120 | Ferrite | 22 | 10 | 7.2 |  | Unshielded | .019 |  |  |  | - | -55 - 105 |  | 20.57 x 20.57 x 21.34 | https://componentsearchengine.com/part-view/1120-220K-RC/Bourns | https://www.bourns.com/inventory-search-results?PARTS=1120-220K-RC
1120-1R0M-RC | https://www.bourns.comhttp://www.bourns.com/docs/Product-Datasheets/1120_series.pdf | 1120 | Ferrite | 1 | 20 | 11.4 |  | Unshielded | .003 |  |  |  | - | -55 - 105 |  | 20.57 x 20.57 x 21.34 | https://componentsearchengine.com/part-view/1120-1R0M-RC/Bourns | https://www.bourns.com/inventory-search-results?PARTS=1120-1R0M-RC
1120-182K-RC | https://www.bourns.comhttp://www.bourns.com/docs/Product-Datasheets/1120_series.pdf | 1120 | Ferrite | 1800 | 10 | .8 |  | Unshielded | 1.39 |  |  |  | - | -55 - 105 |  | 20.57 x 20.57 x 21.34 | https://componentsearchengine.com/part-view/1120-182K-RC/Bourns | https://www.bourns.com/inventory-search-results?PARTS=1120-182K-RC
1120-181K-RC | https://www.bourns.comhttp://www.bourns.com/docs/Product-Datasheets/1120_series.pdf | 1120 | Ferrite | 180 | 10 | 4 |  | Unshielded | .11 |  |  |  | - | -55 - 105 |  | 20.57 x 20.57 x 21.34 | https://componentsearchengine.com/part-view/1120-181K-RC/Bourns | https://www.bourns.com/inventory-search-results?PARTS=1120-181K-RC
1120-180K-RC | https://www.bourns.comhttp://www.bourns.com/docs/Product-Datasheets/1120_series.pdf | 1120 | Ferrite | 18 | 10 | 7.2 |  | Unshielded | .018 |  |  |  | - | -55 - 105 |  | 20.57 x 20.57 x 21.34 | https://componentsearchengine.com/part-view/1120-180K-RC/Bourns | https://www.bourns.com/inventory-search-results?PARTS=1120-180K-RC
1120-152K-RC | https://www.bourns.comhttp://www.bourns.com/docs/Product-Datasheets/1120_series.pdf | 1120 | Ferrite | 1500 | 10 | .8 |  | Unshielded | 1.26 |  |  |  | - | -55 - 105 |  | 20.57 x 20.57 x 21.34 | https://componentsearchengine.com/part-view/1120-152K-RC/Bourns | https://www.bourns.com/inventory-search-results?PARTS=1120-152K-RC
1120-151K-RC | https://www.bourns.comhttp://www.bourns.com/docs/Product-Datasheets/1120_series.pdf | 1120 | Ferrite | 150 | 10 | 4 |  | Unshielded | .098 |  |  |  | - | -55 - 105 |  | 20.57 x 20.57 x 21.34 | https://componentsearchengine.com/part-view/1120-151K-RC/Bourns | https://www.bourns.com/inventory-search-results?PARTS=1120-151K-RC
1120-150K-RC | https://www.bourns.comhttp://www.bourns.com/docs/Product-Datasheets/1120_series.pdf | 1120 | Ferrite | 15 | 10 | 9 |  | Unshielded | .013 |  |  |  | - | -55 - 105 |  | 20.57 x 20.57 x 21.34 | https://componentsearchengine.com/part-view/1120-150K-RC/Bourns | https://www.bourns.com/inventory-search-results?PARTS=1120-150K-RC
1120-122K-RC | https://www.bourns.comhttp://www.bourns.com/docs/Product-Datasheets/1120_series.pdf | 1120 | Ferrite | 1200 | 10 | .8 |  | Unshielded | 1.14 |  |  |  | - | -55 - 105 |  | 20.57 x 20.57 x 21.34 | https://componentsearchengine.com/part-view/1120-122K-RC/Bourns | https://www.bourns.com/inventory-search-results?PARTS=1120-122K-RC
1120-121K-RC | https://www.bourns.comhttp://www.bourns.com/docs/Product-Datasheets/1120_series.pdf | 1120 | Ferrite | 120 | 10 | 4 |  | Unshielded | .09 |  |  |  | - | -55 - 105 |  | 20.57 x 20.57 x 21.34 | https://componentsearchengine.com/part-view/1120-121K-RC/Bourns | https://www.bourns.com/inventory-search-results?PARTS=1120-121K-RC
1120-120K-RC | https://www.bourns.comhttp://www.bourns.com/docs/Product-Datasheets/1120_series.pdf | 1120 | Ferrite | 12 | 10 | 11.4 |  | Unshielded | .009 |  |  |  | - | -55 - 105 |  | 20.57 x 20.57 x 21.34 | https://componentsearchengine.com/part-view/1120-120K-RC/Bourns | https://www.bourns.com/inventory-search-results?PARTS=1120-120K-RC
1120-102K-RC | https://www.bourns.comhttp://www.bourns.com/docs/Product-Datasheets/1120_series.pdf | 1120 | Ferrite | 1000 | 10 | 1 |  | Unshielded | .818 |  |  |  | - | -55 - 105 |  | 20.57 x 20.57 x 21.34 | https://componentsearchengine.com/part-view/1120-102K-RC/Bourns | https://www.bourns.com/inventory-search-results?PARTS=1120-102K-RC
1120-101K-RC | https://www.bourns.comhttp://www.bourns.com/docs/Product-Datasheets/1120_series.pdf | 1120 | Ferrite | 100 | 10 | 4 |  | Unshielded | .08 |  |  |  | - | -55 - 105 |  | 20.57 x 20.57 x 21.34 | https://componentsearchengine.com/part-view/1120-101K-RC/Bourns | https://www.bourns.com/inventory-search-results?PARTS=1120-101K-RC
1120-100K-RC | https://www.bourns.comhttp://www.bourns.com/docs/Product-Datasheets/1120_series.pdf | 1120 | Ferrite | 10 | 10 | 11.4 |  | Unshielded | .009 |  |  |  | - | -55 - 105 |  | 20.57 x 20.57 x 21.34 | https://componentsearchengine.com/part-view/1120-100K-RC/Bourns | https://www.bourns.com/inventory-search-results?PARTS=1120-100K-RC
1130-8R2M-RC | https://www.bourns.comhttp://www.bourns.com/docs/Product-Datasheets/1130_series.pdf | 1130 | Ferrite | 8.2 | 20 | 21 |  | Unshielded | .004 |  |  |  | - | -55 - 105 |  | 27.94 x 27.94 x 21.34 | https://componentsearchengine.com/part-view/1130-8R2M-RC/Bourns | https://www.bourns.com/inventory-search-results?PARTS=1130-8R2M-RC
1130-821K-RC | https://www.bourns.comhttp://www.bourns.com/docs/Product-Datasheets/1130_series.pdf | 1130 | Ferrite | 820 | 10 | 2.8 |  | Unshielded | .288 |  |  |  | - | -55 - 105 |  | 27.94 x 27.94 x 21.34 | https://componentsearchengine.com/part-view/1130-821K-RC/Bourns | https://www.bourns.com/inventory-search-results?PARTS=1130-821K-RC
1130-820K-RC | https://www.bourns.comhttp://www.bourns.com/docs/Product-Datasheets/1130_series.pdf | 1130 | Ferrite | 82 | 10 | 9 |  | Unshielded | .032 |  |  |  | - | -55 - 105 |  | 27.94 x 27.94 x 21.34 | https://componentsearchengine.com/part-view/1130-820K-RC/Bourns | https://www.bourns.com/inventory-search-results?PARTS=1130-820K-RC
1130-6R8M-RC | https://www.bourns.comhttp://www.bourns.com/docs/Product-Datasheets/1130_series.pdf | 1130 | Ferrite | 6.8 | 20 | 21 |  | Unshielded | .004 |  |  |  | - | -55 - 105 |  | 27.94 x 27.94 x 21.34 | https://componentsearchengine.com/part-view/1130-6R8M-RC/Bourns | https://www.bourns.com/inventory-search-results?PARTS=1130-6R8M-RC
1130-681K-RC | https://www.bourns.comhttp://www.bourns.com/docs/Product-Datasheets/1130_series.pdf | 1130 | Ferrite | 680 | 10 | 2.8 |  | Unshielded | .256 |  |  |  | - | -55 - 105 |  | 27.94 x 27.94 x 21.34 | https://componentsearchengine.com/part-view/1130-681K-RC/Bourns | https://www.bourns.com/inventory-search-results?PARTS=1130-681K-RC
1130-680K-RC | https://www.bourns.comhttp://www.bourns.com/docs/Product-Datasheets/1130_series.pdf | 1130 | Ferrite | 68 | 10 | 9 |  | Unshielded | .029 |  |  |  | - | -55 - 105 |  | 27.94 x 27.94 x 21.34 | https://componentsearchengine.com/part-view/1130-680K-RC/Bourns | https://www.bourns.com/inventory-search-results?PARTS=1130-680K-RC
1130-5R6M-RC | https://www.bourns.comhttp://www.bourns.com/docs/Product-Datasheets/1130_series.pdf | 1130 | Ferrite | 5.6 | 20 | 21 |  | Unshielded | .003 |  |  |  | - | -55 - 105 |  | 27.94 x 27.94 x 21.34 | https://componentsearchengine.com/part-view/1130-5R6M-RC/Bourns | https://www.bourns.com/inventory-search-results?PARTS=1130-5R6M-RC
1130-561K-RC | https://www.bourns.comhttp://www.bourns.com/docs/Product-Datasheets/1130_series.pdf | 1130 | Ferrite | 560 | 10 | 4 |  | Unshielded | .205 |  |  |  | - | -55 - 105 |  | 27.94 x 27.94 x 21.34 | https://componentsearchengine.com/part-view/1130-561K-RC/Bourns | https://www.bourns.com/inventory-search-results?PARTS=1130-561K-RC
1130-560K-RC | https://www.bourns.comhttp://www.bourns.com/docs/Product-Datasheets/1130_series.pdf | 1130 | Ferrite | 56 | 10 | 9 |  | Unshielded | .026 |  |  |  | - | -55 - 105 |  | 27.94 x 27.94 x 21.34 | https://componentsearchengine.com/part-view/1130-560K-RC/Bourns | https://www.bourns.com/inventory-search-results?PARTS=1130-560K-RC
1130-4R7M-RC | https://www.bourns.comhttp://www.bourns.com/docs/Product-Datasheets/1130_series.pdf | 1130 | Ferrite | 4.7 | 20 | 21 |  | Unshielded | .003 |  |  |  | - | -55 - 105 |  | 27.94 x 27.94 x 21.34 | https://componentsearchengine.com/part-view/1130-4R7M-RC/Bourns | https://www.bourns.com/inventory-search-results?PARTS=1130-4R7M-RC
1130-472K-RC | https://www.bourns.comhttp://www.bourns.com/docs/Product-Datasheets/1130_series.pdf | 1130 | Ferrite | 4700 | 10 | 1 |  | Unshielded | 1.86 |  |  |  | - | -55 - 105 |  | 38.1 x 38.1 x 21.34 | https://componentsearchengine.com/part-view/1130-472K-RC/Bourns | https://www.bourns.com/inventory-search-results?PARTS=1130-472K-RC
1130-471K-RC | https://www.bourns.comhttp://www.bourns.com/docs/Product-Datasheets/1130_series.pdf | 1130 | Ferrite | 470 | 10 | 4 |  | Unshielded | .187 |  |  |  | - | -55 - 105 |  | 27.94 x 27.94 x 21.34 | https://componentsearchengine.com/part-view/1130-471K-RC/Bourns | https://www.bourns.com/inventory-search-results?PARTS=1130-471K-RC
1130-470K-RC | https://www.bourns.comhttp://www.bourns.com/docs/Product-Datasheets/1130_series.pdf | 1130 | Ferrite | 47 | 10 | 9 |  | Unshielded | .024 |  |  |  | - | -55 - 105 |  | 27.94 x 27.94 x 21.34 | https://componentsearchengine.com/part-view/1130-470K-RC/Bourns | https://www.bourns.com/inventory-search-results?PARTS=1130-470K-RC
1130-3R9M-RC | https://www.bourns.comhttp://www.bourns.com/docs/Product-Datasheets/1130_series.pdf | 1130 | Ferrite | 3.9 | 20 | 21 |  | Unshielded | .003 |  |  |  | - | -55 - 105 |  | 27.94 x 27.94 x 21.34 | https://componentsearchengine.com/part-view/1130-3R9M-RC/Bourns | https://www.bourns.com/inventory-search-results?PARTS=1130-3R9M-RC
1130-3R3M-RC | https://www.bourns.comhttp://www.bourns.com/docs/Product-Datasheets/1130_series.pdf | 1130 | Ferrite | 3.3 | 20 | 21 |  | Unshielded | .003 |  |  |  | - | -55 - 105 |  | 27.94 x 27.94 x 21.34 | https://componentsearchengine.com/part-view/1130-3R3M-RC/Bourns | https://www.bourns.com/inventory-search-results?PARTS=1130-3R3M-RC
1130-392K-RC | https://www.bourns.comhttp://www.bourns.com/docs/Product-Datasheets/1130_series.pdf | 1130 | Ferrite | 3900 | 10 | 1 |  | Unshielded | 1.67 |  |  |  | - | -55 - 105 |  | 27.94 x 27.94 x 21.34 | https://componentsearchengine.com/part-view/1130-392K-RC/Bourns | https://www.bourns.com/inventory-search-results?PARTS=1130-392K-RC
1130-391K-RC | https://www.bourns.comhttp://www.bourns.com/docs/Product-Datasheets/1130_series.pdf | 1130 | Ferrite | 390 | 10 | 4 |  | Unshielded | .169 |  |  |  | - | -55 - 105 |  | 27.94 x 27.94 x 21.34 | https://componentsearchengine.com/part-view/1130-391K-RC/Bourns | https://www.bourns.com/inventory-search-results?PARTS=1130-391K-RC
1130-390K-RC | https://www.bourns.comhttp://www.bourns.com/docs/Product-Datasheets/1130_series.pdf | 1130 | Ferrite | 39 | 10 | 11.4 |  | Unshielded | .022 |  |  |  | - | -55 - 105 |  | 27.94 x 27.94 x 21.34 | https://componentsearchengine.com/part-view/1130-390K-RC/Bourns | https://www.bourns.com/inventory-search-results?PARTS=1130-390K-RC
1130-332K-RC | https://www.bourns.comhttp://www.bourns.com/docs/Product-Datasheets/1130_series.pdf | 1130 | Ferrite | 3300 | 10 | 1.3 |  | Unshielded | 1.27 |  |  |  | - | -55 - 105 |  | 27.94 x 27.94 x 21.34 | https://componentsearchengine.com/part-view/1130-332K-RC/Bourns | https://www.bourns.com/inventory-search-results?PARTS=1130-332K-RC
1130-331K-RC | https://www.bourns.comhttp://www.bourns.com/docs/Product-Datasheets/1130_series.pdf | 1130 | Ferrite | 330 | 10 | 4.5 |  | Unshielded | .122 |  |  |  | - | -55 - 105 |  | 27.94 x 27.94 x 21.34 | https://componentsearchengine.com/part-view/1130-331K-RC/Bourns | https://www.bourns.com/inventory-search-results?PARTS=1130-331K-RC
1130-330K-RC | https://www.bourns.comhttp://www.bourns.com/docs/Product-Datasheets/1130_series.pdf | 1130 | Ferrite | 33 | 10 | 13.5 |  | Unshielded | .017 |  |  |  | - | -55 - 105 |  | 27.94 x 27.94 x 21.34 | https://componentsearchengine.com/part-view/1130-330K-RC/Bourns | https://www.bourns.com/inventory-search-results?PARTS=1130-330K-RC
1130-2R7M-RC | https://www.bourns.comhttp://www.bourns.com/docs/Product-Datasheets/1130_series.pdf | 1130 | Ferrite | 2.7 | 20 | 21 |  | Unshielded | .003 |  |  |  | - | -55 - 105 |  | 27.94 x 27.94 x 21.34 | https://componentsearchengine.com/part-view/1130-2R7M-RC/Bourns | https://www.bourns.com/inventory-search-results?PARTS=1130-2R7M-RC
1130-2R2M-RC | https://www.bourns.comhttp://www.bourns.com/docs/Product-Datasheets/1130_series.pdf | 1130 | Ferrite | 2.2 | 20 | 21 |  | Unshielded | .003 |  |  |  | - | -55 - 105 |  | 27.94 x 27.94 x 21.34 | https://componentsearchengine.com/part-view/1130-2R2M-RC/Bourns | https://www.bourns.com/inventory-search-results?PARTS=1130-2R2M-RC
1130-272K-RC | https://www.bourns.comhttp://www.bourns.com/docs/Product-Datasheets/1130_series.pdf | 1130 | Ferrite | 2700 | 10 | 1.3 |  | Unshielded | 1.14 |  |  |  | - | -55 - 105 |  | 27.94 x 27.94 x 21.34 | https://componentsearchengine.com/part-view/1130-272K-RC/Bourns | https://www.bourns.com/inventory-search-results?PARTS=1130-272K-RC
1130-271K-RC | https://www.bourns.comhttp://www.bourns.com/docs/Product-Datasheets/1130_series.pdf | 1130 | Ferrite | 270 | 10 | 4.5 |  | Unshielded | .11 |  |  |  | - | -55 - 105 |  | 27.94 x 27.94 x 21.34 | https://componentsearchengine.com/part-view/1130-271K-RC/Bourns | https://www.bourns.com/inventory-search-results?PARTS=1130-271K-RC
1130-270K-RC | https://www.bourns.comhttp://www.bourns.com/docs/Product-Datasheets/1130_series.pdf | 1130 | Ferrite | 27 | 10 | 13.5 |  | Unshielded | .012 |  |  |  | - | -55 - 105 |  | 27.94 x 27.94 x 21.34 | https://componentsearchengine.com/part-view/1130-270K-RC/Bourns | https://www.bourns.com/inventory-search-results?PARTS=1130-270K-RC
1130-222K-RC | https://www.bourns.comhttp://www.bourns.com/docs/Product-Datasheets/1130_series.pdf | 1130 | Ferrite | 2200 | 10 | 1.3 |  | Unshielded | 1.02 |  |  |  | - | -55 - 105 |  | 27.94 x 27.94 x 21.34 | https://componentsearchengine.com/part-view/1130-222K-RC/Bourns | https://www.bourns.com/inventory-search-results?PARTS=1130-222K-RC
1130-221K-RC | https://www.bourns.comhttp://www.bourns.com/docs/Product-Datasheets/1130_series.pdf | 1130 | Ferrite | 220 | 10 | 5.5 |  | Unshielded | .08 |  |  |  | - | -55 - 105 |  | 27.94 x 27.94 x 21.34 | https://componentsearchengine.com/part-view/1130-221K-RC/Bourns | https://www.bourns.com/inventory-search-results?PARTS=1130-221K-RC
1130-220K-RC | https://www.bourns.comhttp://www.bourns.com/docs/Product-Datasheets/1130_series.pdf | 1130 | Ferrite | 22 | 10 | 13.5 |  | Unshielded | .011 |  |  |  | - | -55 - 105 |  | 27.94 x 27.94 x 21.34 | https://componentsearchengine.com/part-view/1130-220K-RC/Bourns | https://www.bourns.com/inventory-search-results?PARTS=1130-220K-RC
1130-1R8M-RC | https://www.bourns.comhttp://www.bourns.com/docs/Product-Datasheets/1130_series.pdf | 1130 | Ferrite | 1.8 | 20 | 21 |  | Unshielded | .003 |  |  |  | - | -55 - 105 |  | 27.94 x 27.94 x 21.34 | https://componentsearchengine.com/part-view/1130-1R8M-RC/Bourns | https://www.bourns.com/inventory-search-results?PARTS=1130-1R8M-RC
1130-1R5M-RC | https://www.bourns.comhttp://www.bourns.com/docs/Product-Datasheets/1130_series.pdf | 1130 | Ferrite | 1.5 | 20 | 21 |  | Unshielded | .003 |  |  |  | - | -55 - 105 |  | 27.94 x 27.94 x 21.34 | https://componentsearchengine.com/part-view/1130-1R5M-RC/Bourns | https://www.bourns.com/inventory-search-results?PARTS=1130-1R5M-RC
1130-1R2M-RC | https://www.bourns.comhttp://www.bourns.com/docs/Product-Datasheets/1130_series.pdf | 1130 | Ferrite | 1.2 | 20 | 21 |  | Unshielded | .003 |  |  |  | - | -55 - 105 |  | 27.94 x 27.94 x 21.34 | https://componentsearchengine.com/part-view/1130-1R2M-RC/Bourns | https://www.bourns.com/inventory-search-results?PARTS=1130-1R2M-RC
1130-1R0M-RC | https://www.bourns.comhttp://www.bourns.com/docs/Product-Datasheets/1130_series.pdf | 1130 | Ferrite | 1 | 20 | 21 |  | Unshielded | .003 |  |  |  | - | -55 - 105 |  | 27.94 x 27.94 x 21.34 | https://componentsearchengine.com/part-view/1130-1R0M-RC/Bourns | https://www.bourns.com/inventory-search-results?PARTS=1130-1R0M-RC
1130-182K-RC | https://www.bourns.comhttp://www.bourns.com/docs/Product-Datasheets/1130_series.pdf | 1130 | Ferrite | 1800 | 10 | 1.6 |  | Unshielded | .705 |  |  |  | - | -55 - 105 |  | 27.94 x 27.94 x 21.34 | https://componentsearchengine.com/part-view/1130-182K-RC/Bourns | https://www.bourns.com/inventory-search-results?PARTS=1130-182K-RC
1130-181K-RC | https://www.bourns.comhttp://www.bourns.com/docs/Product-Datasheets/1130_series.pdf | 1130 | Ferrite | 180 | 10 | 5.5 |  | Unshielded | .072 |  |  |  | - | -55 - 105 |  | 27.94 x 27.94 x 21.34 | https://componentsearchengine.com/part-view/1130-181K-RC/Bourns | https://www.bourns.com/inventory-search-results?PARTS=1130-181K-RC
1130-180K-RC | https://www.bourns.comhttp://www.bourns.com/docs/Product-Datasheets/1130_series.pdf | 1130 | Ferrite | 18 | 10 | 13.5 |  | Unshielded | .01 |  |  |  | - | -55 - 105 |  | 27.94 x 27.94 x 21.34 | https://componentsearchengine.com/part-view/1130-180K-RC/Bourns | https://www.bourns.com/inventory-search-results?PARTS=1130-180K-RC
1130-152K-RC | https://www.bourns.comhttp://www.bourns.com/docs/Product-Datasheets/1130_series.pdf | 1130 | Ferrite | 1500 | 10 | 2 |  | Unshielded | .518 |  |  |  | - | -55 - 105 |  | 27.94 x 27.94 x 21.34 | https://componentsearchengine.com/part-view/1130-152K-RC/Bourns | https://www.bourns.com/inventory-search-results?PARTS=1130-152K-RC
1130-151K-RC | https://www.bourns.comhttp://www.bourns.com/docs/Product-Datasheets/1130_series.pdf | 1130 | Ferrite | 150 | 10 | 5.5 |  | Unshielded | .064 |  |  |  | - | -55 - 105 |  | 27.94 x 27.94 x 21.34 | https://componentsearchengine.com/part-view/1130-151K-RC/Bourns | https://www.bourns.com/inventory-search-results?PARTS=1130-151K-RC
1130-150K-RC | https://www.bourns.comhttp://www.bourns.com/docs/Product-Datasheets/1130_series.pdf | 1130 | Ferrite | 15 | 10 | 13.5 |  | Unshielded | .009 |  |  |  | - | -55 - 105 |  | 27.94 x 27.94 x 21.34 | https://componentsearchengine.com/part-view/1130-150K-RC/Bourns | https://www.bourns.com/inventory-search-results?PARTS=1130-150K-RC
1130-122K-RC | https://www.bourns.comhttp://www.bourns.com/docs/Product-Datasheets/1130_series.pdf | 1130 | Ferrite | 1200 | 10 | 2 |  | Unshielded | .426 |  |  |  | - | -55 - 105 |  | 27.94 x 27.94 x 21.34 | https://componentsearchengine.com/part-view/1130-122K-RC/Bourns | https://www.bourns.com/inventory-search-results?PARTS=1130-122K-RC
1130-121K-RC | https://www.bourns.comhttp://www.bourns.com/docs/Product-Datasheets/1130_series.pdf | 1130 | Ferrite | 120 | 10 | 7.2 |  | Unshielded | .046 |  |  |  | - | -55 - 105 |  | 27.94 x 27.94 x 21.34 | https://componentsearchengine.com/part-view/1130-121K-RC/Bourns | https://www.bourns.com/inventory-search-results?PARTS=1130-121K-RC
1130-120K-RC | https://www.bourns.comhttp://www.bourns.com/docs/Product-Datasheets/1130_series.pdf | 1130 | Ferrite | 12 | 10 | 13.5 |  | Unshielded | .008 |  |  |  | - | -55 - 105 |  | 27.94 x 27.94 x 21.34 | https://componentsearchengine.com/part-view/1130-120K-RC/Bourns | https://www.bourns.com/inventory-search-results?PARTS=1130-120K-RC
1130-102K-RC | https://www.bourns.comhttp://www.bourns.com/docs/Product-Datasheets/1130_series.pdf | 1130 | Ferrite | 1000 | 10 | 2 |  | Unshielded | .426 |  |  |  | - | -55 - 105 |  | 27.94 x 27.94 x 21.34 | https://componentsearchengine.com/part-view/1130-102K-RC/Bourns | https://www.bourns.com/inventory-search-results?PARTS=1130-102K-RC
1130-101K-RC | https://www.bourns.comhttp://www.bourns.com/docs/Product-Datasheets/1130_series.pdf | 1130 | Ferrite | 100 | 10 | 9 |  | Unshielded | .034 |  |  |  | - | -55 - 105 |  | 27.94 x 27.94 x 21.34 | https://componentsearchengine.com/part-view/1130-101K-RC/Bourns | https://www.bourns.com/inventory-search-results?PARTS=1130-101K-RC
1130-100K-RC | https://www.bourns.comhttp://www.bourns.com/docs/Product-Datasheets/1130_series.pdf | 1130 | Ferrite | 10 | 10 | 17 |  | Unshielded | .006 |  |  |  | - | -55 - 105 |  | 27.94 x 27.94 x 21.34 | https://componentsearchengine.com/part-view/1130-100K-RC/Bourns | https://www.bourns.com/inventory-search-results?PARTS=1130-100K-RC
1140-8R2M-RC | https://www.bourns.comhttp://www.bourns.com/docs/Product-Datasheets/1140_series.pdf | 1140 | Ferrite | 8.2 | 20 | 24.4 | 70.3 | Unshielded | .004 |  |  |  | - | -55 - 105 |  | 38.1 x 38.1 x 26.16 | https://componentsearchengine.com/part-view/1140-8R2M-RC/Bourns | https://www.bourns.com/inventory-search-results?PARTS=1140-8R2M-RC
1140-822K-RC | https://www.bourns.comhttp://www.bourns.com/docs/Product-Datasheets/1140_series.pdf | 1140 | Ferrite | 8200 | 10 | 1.2 | 2.3 | Unshielded | 1.95 |  |  |  | - | -55 - 105 |  | 38.1 x 38.1 x 26.16 | https://componentsearchengine.com/part-view/1140-822K-RC/Bourns | https://www.bourns.com/inventory-search-results?PARTS=1140-822K-RC
1140-821K-RC | https://www.bourns.comhttp://www.bourns.com/docs/Product-Datasheets/1140_series.pdf | 1140 | Ferrite | 820 | 10 | 4.2 | 7.2 | Unshielded | .154 |  |  |  | - | -55 - 105 |  | 38.1 x 38.1 x 26.16 | https://componentsearchengine.com/part-view/1140-821K-RC/Bourns | https://www.bourns.com/inventory-search-results?PARTS=1140-821K-RC
1140-820K-RC | https://www.bourns.comhttp://www.bourns.com/docs/Product-Datasheets/1140_series.pdf | 1140 | Ferrite | 82 | 10 | 10.9 | 23.1 | Unshielded | .023 |  |  |  | - | -55 - 105 |  | 38.1 x 38.1 x 26.16 | https://componentsearchengine.com/part-view/1140-820K-RC/Bourns | https://www.bourns.com/inventory-search-results?PARTS=1140-820K-RC
1140-6R8M-RC | https://www.bourns.comhttp://www.bourns.com/docs/Product-Datasheets/1140_series.pdf | 1140 | Ferrite | 6.8 | 20 | 24.4 | 73.5 | Unshielded | .004 |  |  |  | - | -55 - 105 |  | 38.1 x 38.1 x 26.16 | https://componentsearchengine.com/part-view/1140-6R8M-RC/Bourns | https://www.bourns.com/inventory-search-results?PARTS=1140-6R8M-RC
1140-682K-RC | https://www.bourns.comhttp://www.bourns.com/docs/Product-Datasheets/1140_series.pdf | 1140 | Ferrite | 6800 | 10 | 1.2 | 2.5 | Unshielded | 1.76 |  |  |  | - | -55 - 105 |  | 38.1 x 38.1 x 26.16 | https://componentsearchengine.com/part-view/1140-682K-RC/Bourns | https://www.bourns.com/inventory-search-results?PARTS=1140-682K-RC
1140-681K-RC | https://www.bourns.comhttp://www.bourns.com/docs/Product-Datasheets/1140_series.pdf | 1140 | Ferrite | 680 | 10 | 4.4 | 7.9 | Unshielded | .139 |  |  |  | - | -55 - 105 |  | 38.1 x 38.1 x 26.16 | https://componentsearchengine.com/part-view/1140-681K-RC/Bourns | https://www.bourns.com/inventory-search-results?PARTS=1140-681K-RC
1140-680K-RC | https://www.bourns.comhttp://www.bourns.com/docs/Product-Datasheets/1140_series.pdf | 1140 | Ferrite | 68 | 10 | 11.4 | 25.2 | Unshielded | .021 |  |  |  | - | -55 - 105 |  | 38.1 x 38.1 x 26.16 | https://componentsearchengine.com/part-view/1140-680K-RC/Bourns | https://www.bourns.com/inventory-search-results?PARTS=1140-680K-RC
1140-5R6M-RC | https://www.bourns.comhttp://www.bourns.com/docs/Product-Datasheets/1140_series.pdf | 1140 | Ferrite | 5.6 | 20 | 24.4 | 80 | Unshielded | .004 |  |  |  | - | -55 - 105 |  | 38.1 x 38.1 x 26.16 | https://componentsearchengine.com/part-view/1140-5R6M-RC/Bourns | https://www.bourns.com/inventory-search-results?PARTS=1140-5R6M-RC
1140-562K-RC | https://www.bourns.comhttp://www.bourns.com/docs/Product-Datasheets/1140_series.pdf | 1140 | Ferrite | 5600 | 10 | 1.3 | 2.8 | Unshielded | 1.6 |  |  |  | - | -55 - 105 |  | 38.1 x 38.1 x 26.16 | https://componentsearchengine.com/part-view/1140-562K-RC/Bourns | https://www.bourns.com/inventory-search-results?PARTS=1140-562K-RC
1140-561K-RC | https://www.bourns.comhttp://www.bourns.com/docs/Product-Datasheets/1140_series.pdf | 1140 | Ferrite | 560 | 10 | 4.7 | 8.6 | Unshielded | .125 |  |  |  | - | -55 - 105 |  | 38.1 x 38.1 x 26.16 | https://componentsearchengine.com/part-view/1140-561K-RC/Bourns | https://www.bourns.com/inventory-search-results?PARTS=1140-561K-RC
1140-560K-RC | https://www.bourns.comhttp://www.bourns.com/docs/Product-Datasheets/1140_series.pdf | 1140 | Ferrite | 56 | 10 | 12 | 27.6 | Unshielded | .019 |  |  |  | - | -55 - 105 |  | 38.1 x 38.1 x 26.16 | https://componentsearchengine.com/part-view/1140-560K-RC/Bourns | https://www.bourns.com/inventory-search-results?PARTS=1140-560K-RC
1140-4R7M-RC | https://www.bourns.comhttp://www.bourns.com/docs/Product-Datasheets/1140_series.pdf | 1140 | Ferrite | 4.7 | 20 | 28.1 | 80 | Unshielded | .003 |  |  |  | - | -55 - 105 |  | 38.1 x 38.1 x 26.16 | https://componentsearchengine.com/part-view/1140-4R7M-RC/Bourns | https://www.bourns.com/inventory-search-results?PARTS=1140-4R7M-RC
1140-472K-RC | https://www.bourns.comhttp://www.bourns.com/docs/Product-Datasheets/1140_series.pdf | 1140 | Ferrite | 4700 | 10 | 1.6 | 3 | Unshielded | 1.14 |  |  |  | - | -55 - 105 |  | 38.1 x 38.1 x 26.16 | https://componentsearchengine.com/part-view/1140-472K-RC/Bourns | https://www.bourns.com/inventory-search-results?PARTS=1140-472K-RC
1140-471K-RC | https://www.bourns.comhttp://www.bourns.com/docs/Product-Datasheets/1140_series.pdf | 1140 | Ferrite | 470 | 10 | 4.9 | 9.5 | Unshielded | .114 |  |  |  | - | -55 - 105 |  | 38.1 x 38.1 x 26.16 | https://componentsearchengine.com/part-view/1140-471K-RC/Bourns | https://www.bourns.com/inventory-search-results?PARTS=1140-471K-RC
1140-3R3M-RC | https://www.bourns.comhttp://www.bourns.com/docs/Product-Datasheets/1140_series.pdf | 1140 | Ferrite | 3.3 | 20 | 28.1 | 80 | Unshielded | .003 |  |  |  | - | -55 - 105 |  | 38.1 x 38.1 x 26.16 | https://componentsearchengine.com/part-view/1140-3R3M-RC/Bourns | https://www.bourns.com/inventory-search-results?PARTS=1140-3R3M-RC
1140-392K-RC | https://www.bourns.comhttp://www.bourns.com/docs/Product-Datasheets/1140_series.pdf | 1140 | Ferrite | 3900 | 10 | 1.8 | 3.3 | Unshielded | .845 |  |  |  | - | -55 - 105 |  | 38.1 x 38.1 x 26.16 | https://componentsearchengine.com/part-view/1140-392K-RC/Bourns | https://www.bourns.com/inventory-search-results?PARTS=1140-392K-RC
1140-391K-RC | https://www.bourns.comhttp://www.bourns.com/docs/Product-Datasheets/1140_series.pdf | 1140 | Ferrite | 390 | 10 | 5.8 | 10.4 | Unshielded | .082 |  |  |  | - | -55 - 105 |  | 38.1 x 38.1 x 26.16 | https://componentsearchengine.com/part-view/1140-391K-RC/Bourns | https://www.bourns.com/inventory-search-results?PARTS=1140-391K-RC
1140-390K-RC | https://www.bourns.comhttp://www.bourns.com/docs/Product-Datasheets/1140_series.pdf | 1140 | Ferrite | 39 | 10 | 15.1 | 32.3 | Unshielded | .012 |  |  |  | - | -55 - 105 |  | 38.1 x 38.1 x 26.16 | https://componentsearchengine.com/part-view/1140-390K-RC/Bourns | https://www.bourns.com/inventory-search-results?PARTS=1140-390K-RC
1140-332K-RC | https://www.bourns.comhttp://www.bourns.com/docs/Product-Datasheets/1140_series.pdf | 1140 | Ferrite | 3300 | 10 | 1.9 | 3.6 | Unshielded | .773 |  |  |  | - | -55 - 105 |  | 38.1 x 38.1 x 26.16 | https://componentsearchengine.com/part-view/1140-332K-RC/Bourns | https://www.bourns.com/inventory-search-results?PARTS=1140-332K-RC
1140-331K-RC | https://www.bourns.comhttp://www.bourns.com/docs/Product-Datasheets/1140_series.pdf | 1140 | Ferrite | 330 | 10 | 6.1 | 11.2 | Unshielded | .074 |  |  |  | - | -55 - 105 |  | 38.1 x 38.1 x 26.16 | https://componentsearchengine.com/part-view/1140-331K-RC/Bourns | https://www.bourns.com/inventory-search-results?PARTS=1140-331K-RC
1140-330K-RC | https://www.bourns.comhttp://www.bourns.com/docs/Product-Datasheets/1140_series.pdf | 1140 | Ferrite | 33 | 10 | 15.8 | 36.5 | Unshielded | .011 |  |  |  | - | -55 - 105 |  | 38.1 x 38.1 x 26.16 | https://componentsearchengine.com/part-view/1140-330K-RC/Bourns | https://www.bourns.com/inventory-search-results?PARTS=1140-330K-RC
1140-2R7M-RC | https://www.bourns.comhttp://www.bourns.com/docs/Product-Datasheets/1140_series.pdf | 1140 | Ferrite | 2.7 | 20 | 28.1 | 80 | Unshielded | .003 |  |  |  | - | -55 - 105 |  | 38.1 x 38.1 x 26.16 | https://componentsearchengine.com/part-view/1140-2R7M-RC/Bourns | https://www.bourns.com/inventory-search-results?PARTS=1140-2R7M-RC
1140-2R2M-RC | https://www.bourns.comhttp://www.bourns.com/docs/Product-Datasheets/1140_series.pdf | 1140 | Ferrite | 2.2 | 20 | 34.5 | 80 | Unshielded | .002 |  |  |  | - | -55 - 105 |  | 38.1 x 38.1 x 26.16 | https://componentsearchengine.com/part-view/1140-2R2M-RC/Bourns | https://www.bourns.com/inventory-search-results?PARTS=1140-2R2M-RC
1140-272K-RC | https://www.bourns.comhttp://www.bourns.com/docs/Product-Datasheets/1140_series.pdf | 1140 | Ferrite | 2700 | 10 | 2.2 | 3.9 | Unshielded | .555 |  |  |  | - | -55 - 105 |  | 38.1 x 38.1 x 26.16 | https://componentsearchengine.com/part-view/1140-272K-RC/Bourns | https://www.bourns.com/inventory-search-results?PARTS=1140-272K-RC
1140-271K-RC | https://www.bourns.comhttp://www.bourns.com/docs/Product-Datasheets/1140_series.pdf | 1140 | Ferrite | 270 | 10 | 7 | 12.4 | Unshielded | .056 |  |  |  | - | -55 - 105 |  | 38.1 x 38.1 x 26.16 | https://componentsearchengine.com/part-view/1140-271K-RC/Bourns | https://www.bourns.com/inventory-search-results?PARTS=1140-271K-RC
1140-270K-RC | https://www.bourns.comhttp://www.bourns.com/docs/Product-Datasheets/1140_series.pdf | 1140 | Ferrite | 27 | 10 | 16 | 39 | Unshielded | .01 |  |  |  | - | -55 - 105 |  | 38.1 x 38.1 x 26.16 | https://componentsearchengine.com/part-view/1140-270K-RC/Bourns | https://www.bourns.com/inventory-search-results?PARTS=1140-270K-RC
1140-222K-RC | https://www.bourns.comhttp://www.bourns.com/docs/Product-Datasheets/1140_series.pdf | 1140 | Ferrite | 2200 | 10 | 2.4 | 4.4 | Unshielded | .494 |  |  |  | - | -55 - 105 |  | 38.1 x 38.1 x 26.1 | https://componentsearchengine.com/part-view/1140-222K-RC/Bourns | https://www.bourns.com/inventory-search-results?PARTS=1140-222K-RC
1140-221K-RC | https://www.bourns.comhttp://www.bourns.com/docs/Product-Datasheets/1140_series.pdf | 1140 | Ferrite | 220 | 10 | 7.4 | 14 | Unshielded | .05 |  |  |  | - | -55 - 105 |  | 38.1 x 38.1 x 26.16 | https://componentsearchengine.com/part-view/1140-221K-RC/Bourns | https://www.bourns.com/inventory-search-results?PARTS=1140-221K-RC
1140-220K-RC | https://www.bourns.comhttp://www.bourns.com/docs/Product-Datasheets/1140_series.pdf | 1140 | Ferrite | 22 | 10 | 16.2 | 43.7 | Unshielded | .009 |  |  |  | - | -55 - 105 |  | 38.1 x 38.1 x 26.16 | https://componentsearchengine.com/part-view/1140-220K-RC/Bourns | https://www.bourns.com/inventory-search-results?PARTS=1140-220K-RC
1140-1R8M-RC | https://www.bourns.comhttp://www.bourns.com/docs/Product-Datasheets/1140_series.pdf | 1140 | Ferrite | 1.8 | 20 | 34.5 | 80 | Unshielded | .002 |  |  |  | - | -55 - 105 |  | 38.1 x 38.1 x 26.16 | https://componentsearchengine.com/part-view/1140-1R8M-RC/Bourns | https://www.bourns.com/inventory-search-results?PARTS=1140-1R8M-RC
1140-182K-RC | https://www.bourns.comhttp://www.bourns.com/docs/Product-Datasheets/1140_series.pdf | 1140 | Ferrite | 1800 | 10 | 2.8 | 4.9 | Unshielded | .36 |  |  |  | - | -55 - 105 |  | 38.1 x 38.1 x 26.16 | https://componentsearchengine.com/part-view/1140-182K-RC/Bourns | https://www.bourns.com/inventory-search-results?PARTS=1140-182K-RC
1140-181K-RC | https://www.bourns.comhttp://www.bourns.com/docs/Product-Datasheets/1140_series.pdf | 1140 | Ferrite | 180 | 10 | 7.8 | 15.5 | Unshielded | .045 |  |  |  | - | -55 - 105 |  | 38.1 x 38.1 x 26.16 | https://componentsearchengine.com/part-view/1140-181K-RC/Bourns | https://www.bourns.com/inventory-search-results?PARTS=1140-181K-RC
1140-180K-RC | https://www.bourns.comhttp://www.bourns.com/docs/Product-Datasheets/1140_series.pdf | 1140 | Ferrite | 18 | 10 | 17.2 | 49.2 | Unshielded | .008 |  |  |  | - | -55 - 105 |  | 38.1 x 38.1 x 26.16 | https://componentsearchengine.com/part-view/1140-180K-RC/Bourns | https://www.bourns.com/inventory-search-results?PARTS=1140-180K-RC
1140-153K-RC | https://www.bourns.comhttp://www.bourns.com/docs/Product-Datasheets/1140_series.pdf | 1140 | Ferrite | 15000 | 10 | .9 | 1.7 | Unshielded | 3.39 |  |  |  | - | -55 - 105 |  | 38.1 x 38.1 x 26.16 | https://componentsearchengine.com/part-view/1140-153K-RC/Bourns | https://www.bourns.com/inventory-search-results?PARTS=1140-153K-RC
1140-152K-RC | https://www.bourns.comhttp://www.bourns.com/docs/Product-Datasheets/1140_series.pdf | 1140 | Ferrite | 1500 | 10 | 2.9 | 5.3 | Unshielded | .324 |  |  |  | - | -55 - 105 |  | 38.1 x 38.1 x 26.16 | https://componentsearchengine.com/part-view/1140-152K-RC/Bourns | https://www.bourns.com/inventory-search-results?PARTS=1140-152K-RC
1140-151K-RC | https://www.bourns.comhttp://www.bourns.com/docs/Product-Datasheets/1140_series.pdf | 1140 | Ferrite | 150 | 10 | 8.3 | 16.9 | Unshielded | .04 |  |  |  | - | -55 - 105 |  | 38.1 x 38.1 x 26.16 | https://componentsearchengine.com/part-view/1140-151K-RC/Bourns | https://www.bourns.com/inventory-search-results?PARTS=1140-151K-RC
1140-150K-RC | https://www.bourns.comhttp://www.bourns.com/docs/Product-Datasheets/1140_series.pdf | 1140 | Ferrite | 15 | 10 | 19.9 | 53.9 | Unshielded | .006 |  |  |  | - | -55 - 105 |  | 38.1 x 38.1 x 26.16 | https://componentsearchengine.com/part-view/1140-150K-RC/Bourns | https://www.bourns.com/inventory-search-results?PARTS=1140-150K-RC
1140-123K-RC | https://www.bourns.comhttp://www.bourns.com/docs/Product-Datasheets/1140_series.pdf | 1140 | Ferrite | 12000 | 10 | .9 | 1.9 | Unshielded | 3.04 |  |  |  | - | -55 - 105 |  | 38.1 x 38.1 x 26.16 | https://componentsearchengine.com/part-view/1140-123K-RC/Bourns | https://www.bourns.com/inventory-search-results?PARTS=1140-123K-RC
1140-122K-RC | https://www.bourns.comhttp://www.bourns.com/docs/Product-Datasheets/1140_series.pdf | 1140 | Ferrite | 1200 | 10 | 3.4 | 5.9 | Unshielded | .232 |  |  |  | - | -55 - 105 |  | 38.1 x 38.1 x 26.16 | https://componentsearchengine.com/part-view/1140-122K-RC/Bourns | https://www.bourns.com/inventory-search-results?PARTS=1140-122K-RC
1140-121K-RC | https://www.bourns.comhttp://www.bourns.com/docs/Product-Datasheets/1140_series.pdf | 1140 | Ferrite | 120 | 10 | 9.9 | 18.6 | Unshielded | .028 |  |  |  | - | -55 - 105 |  | 38.1 x 38.1 x 26.16 | https://componentsearchengine.com/part-view/1140-121K-RC/Bourns | https://www.bourns.com/inventory-search-results?PARTS=1140-121K-RC
1140-103K-RC | https://www.bourns.comhttp://www.bourns.com/docs/Product-Datasheets/1140_series.pdf | 1140 | Ferrite | 10000 | 10 | 1 | 2.1 | Unshielded | 2.76 |  |  |  | - | -55 - 105 |  | 38.1 x 38.1 x 26.1 | https://componentsearchengine.com/part-view/1140-103K-RC/Bourns | https://www.bourns.com/inventory-search-results?PARTS=1140-103K-RC
1140-102K-RC | https://www.bourns.comhttp://www.bourns.com/docs/Product-Datasheets/1140_series.pdf | 1140 | Ferrite | 1000 | 10 | 3.6 | 6.5 | Unshielded | .216 |  |  |  | - | -55 - 105 |  | 38.1 x 38.1 x 26.16 | https://componentsearchengine.com/part-view/1140-102K-RC/Bourns | https://www.bourns.com/inventory-search-results?PARTS=1140-102K-RC
1140-101K-RC | https://www.bourns.comhttp://www.bourns.com/docs/Product-Datasheets/1140_series.pdf | 1140 | Ferrite | 100 | 10 | 10.5 | 20.6 | Unshielded | .025 |  |  |  | - | -55 - 105 |  | 38.1 x 38.1 x 26.16 | https://componentsearchengine.com/part-view/1140-101K-RC/Bourns | https://www.bourns.com/inventory-search-results?PARTS=1140-101K-RC
1140-100K-RC | https://www.bourns.comhttp://www.bourns.com/docs/Product-Datasheets/1140_series.pdf | 1140 | Ferrite | 10 | 10 | 21.8 | 5.3 | Unshielded | .005 |  |  |  | - | -55 - 105 |  | 38.1 x 38.1 x 26.16 | https://componentsearchengine.com/part-view/1140-100K-RC/Bourns | https://www.bourns.com/inventory-search-results?PARTS=1140-100K-RC
2000-8R2-V-RC | https://www.bourns.comhttps://bourns.com/docs/product-datasheets/2000_series.pdf?sfvrsn=4b78637e_11 | 2000 | Iron Powder | 8.2 | 20 | 7 |  | Shielded | .014 |  |  |  | - | -55 - 105 |  | 17.3 x 10.4 x 17.3 | https://componentsearchengine.com/part-view/2000-8R2-V-RC/Bourns | https://www.bourns.com/inventory-search-results?PARTS=2000-8R2-V-RC
2000-8R2-H-RC | https://www.bourns.comhttps://bourns.com/docs/product-datasheets/2000_series.pdf?sfvrsn=4b78637e_11 | 2000 | Iron Powder | 8.2 | 20 | 7 |  | Shielded | .014 |  |  |  | - | -55 - 105 |  | 17.3 x 17.3 x 10.4 | https://componentsearchengine.com/part-view/2000-8R2-H-RC/Bourns | https://www.bourns.com/inventory-search-results?PARTS=2000-8R2-H-RC
2000-6R8-V-RC | https://www.bourns.comhttps://bourns.com/docs/product-datasheets/2000_series.pdf?sfvrsn=4b78637e_11 | 2000 | Iron Powder | 6.8 | 20 | 7.2 |  | Shielded | .013 |  |  |  | - | -55 - 105 |  | 17.3 x 10.4 x 17.3 | https://componentsearchengine.com/part-view/2000-6R8-V-RC/Bourns | https://www.bourns.com/inventory-search-results?PARTS=2000-6R8-V-RC
2000-6R8-H-RC | https://www.bourns.comhttps://bourns.com/docs/product-datasheets/2000_series.pdf?sfvrsn=4b78637e_11 | 2000 | Iron Powder | 6.8 | 20 | 7.2 |  | Shielded | .013 |  |  |  | - | -55 - 105 |  | 17.3 x 17.3 x 10.4 | https://componentsearchengine.com/part-view/2000-6R8-H-RC/Bourns | https://www.bourns.com/inventory-search-results?PARTS=2000-6R8-H-RC
2000-5R6-V-RC | https://www.bourns.comhttps://bourns.com/docs/product-datasheets/2000_series.pdf?sfvrsn=4b78637e_11 | 2000 | Iron Powder | 5.6 | 20 | 9.7 |  | Shielded | .0084 |  |  |  | - | -55 - 105 |  | 17.3 x 10.4 x 17.3 | https://componentsearchengine.com/part-view/2000-5R6-V-RC/Bourns | https://www.bourns.com/inventory-search-results?PARTS=2000-5R6-V-RC
2000-5R6-H-RC | https://www.bourns.comhttps://bourns.com/docs/product-datasheets/2000_series.pdf?sfvrsn=4b78637e_11 | 2000 | Iron Powder | 5.6 | 20 | 9.7 |  | Shielded | .0084 |  |  |  | - | -55 - 105 |  | 17.3 x 17.3 x 10.4 | https://componentsearchengine.com/part-view/2000-5R6-H-RC/Bourns | https://www.bourns.com/inventory-search-results?PARTS=2000-5R6-H-RC
2000-4R7-V-RC | https://www.bourns.comhttps://bourns.com/docs/product-datasheets/2000_series.pdf?sfvrsn=4b78637e_11 | 2000 | Iron Powder | 4.7 | 20 | 10.1 |  | Shielded | .0077 |  |  |  | - | -55 - 105 |  | 17.3 x 10.4 x 17.3 | https://componentsearchengine.com/part-view/2000-4R7-V-RC/Bourns | https://www.bourns.com/inventory-search-results?PARTS=2000-4R7-V-RC
2000-4R7-H-RC | https://www.bourns.comhttps://bourns.com/docs/product-datasheets/2000_series.pdf?sfvrsn=4b78637e_11 | 2000 | Iron Powder | 4.7 | 20 | 10.1 |  | Shielded | .0077 |  |  |  | - | -55 - 105 |  | 17.3 x 17.3 x 10.4 | https://componentsearchengine.com/part-view/2000-4R7-H-RC/Bourns | https://www.bourns.com/inventory-search-results?PARTS=2000-4R7-H-RC
2000-470-V-RC | https://www.bourns.comhttps://bourns.com/docs/product-datasheets/2000_series.pdf?sfvrsn=4b78637e_11 | 2000 | Iron Powder | 47 | 20 | 3.2 |  | Shielded | .064 |  |  |  | - | -55 - 105 |  | 17.3 x 10.4 x 17.3 | https://componentsearchengine.com/part-view/2000-470-V-RC/Bourns | https://www.bourns.com/inventory-search-results?PARTS=2000-470-V-RC
2000-470-H-RC | https://www.bourns.comhttps://bourns.com/docs/product-datasheets/2000_series.pdf?sfvrsn=4b78637e_11 | 2000 | Iron Powder | 47 | 20 | 3.2 |  | Shielded | .064 |  |  |  | - | -55 - 105 |  | 17.3 x 17.3 x 10.4 | https://componentsearchengine.com/part-view/2000-470-H-RC/Bourns | https://www.bourns.com/inventory-search-results?PARTS=2000-470-H-RC
2000-3R9-V-RC | https://www.bourns.comhttps://bourns.com/docs/product-datasheets/2000_series.pdf?sfvrsn=4b78637e_11 | 2000 | Iron Powder | 3.9 | 20 | 10.5 |  | Shielded | .0074 |  |  |  | - | -55 - 105 |  | 17.3 x 10.4 x 17.3 | https://componentsearchengine.com/part-view/2000-3R9-V-RC/Bourns | https://www.bourns.com/inventory-search-results?PARTS=2000-3R9-V-RC
2000-3R9-H-RC | https://www.bourns.comhttps://bourns.com/docs/product-datasheets/2000_series.pdf?sfvrsn=4b78637e_11 | 2000 | Iron Powder | 3.9 | 20 | 10.5 |  | Shielded | .0074 |  |  |  | - | -55 - 105 |  | 17.3 x 17.3 x 10.4 | https://componentsearchengine.com/part-view/2000-3R9-H-RC/Bourns | https://www.bourns.com/inventory-search-results?PARTS=2000-3R9-H-RC
2000-3R3-V-RC | https://www.bourns.comhttps://bourns.com/docs/product-datasheets/2000_series.pdf?sfvrsn=4b78637e_11 | 2000 | Iron Powder | 3.3 | 20 | 11.1 |  | Shielded | .0067 |  |  |  | - | -55 - 105 |  | 17.3 x 10.4 x 17.3 | https://componentsearchengine.com/part-view/2000-3R3-V-RC/Bourns | https://www.bourns.com/inventory-search-results?PARTS=2000-3R3-V-RC
2000-3R3-H-RC | https://www.bourns.comhttps://bourns.com/docs/product-datasheets/2000_series.pdf?sfvrsn=4b78637e_11 | 2000 | Iron Powder | 3.3 | 20 | 11.1 |  | Shielded | .0067 |  |  |  | - | -55 - 105 |  | 17.3 x 17.3 x 10.4 | https://componentsearchengine.com/part-view/2000-3R3-H-RC/Bourns | https://www.bourns.com/inventory-search-results?PARTS=2000-3R3-H-RC
2000-390-V-RC | https://www.bourns.comhttps://bourns.com/docs/product-datasheets/2000_series.pdf?sfvrsn=4b78637e_11 | 2000 | Iron Powder | 39 | 20 | 3.3 |  | Shielded | .059 |  |  |  | - | -55 - 105 |  | 17.3 x 10.4 x 17.3 | https://componentsearchengine.com/part-view/2000-390-V-RC/Bourns | https://www.bourns.com/inventory-search-results?PARTS=2000-390-V-RC
2000-390-H-RC | https://www.bourns.comhttps://bourns.com/docs/product-datasheets/2000_series.pdf?sfvrsn=4b78637e_11 | 2000 | Iron Powder | 39 | 20 | 3.3 |  | Shielded | .059 |  |  |  | - | -55 - 105 |  | 17.3 x 17.3 x 10.4 | https://componentsearchengine.com/part-view/2000-390-H-RC/Bourns | https://www.bourns.com/inventory-search-results?PARTS=2000-390-H-RC
2000-330-V-RC | https://www.bourns.comhttps://bourns.com/docs/product-datasheets/2000_series.pdf?sfvrsn=4b78637e_11 | 2000 | Iron Powder | 33 | 20 | 3.5 |  | Shielded | .054 |  |  |  | - | -55 - 105 |  | 17.3 x 10.4 x 17.3 | https://componentsearchengine.com/part-view/2000-330-V-RC/Bourns | https://www.bourns.com/inventory-search-results?PARTS=2000-330-V-RC
2000-330-H-RC | https://www.bourns.comhttps://bourns.com/docs/product-datasheets/2000_series.pdf?sfvrsn=4b78637e_11 | 2000 | Iron Powder | 33 | 20 | 3.5 |  | Shielded | .054 |  |  |  | - | -55 - 105 |  | 17.3 x 17.3 x 10.4 | https://componentsearchengine.com/part-view/2000-330-H-RC/Bourns | https://www.bourns.com/inventory-search-results?PARTS=2000-330-H-RC
2000-270-V-RC | https://www.bourns.comhttps://bourns.com/docs/product-datasheets/2000_series.pdf?sfvrsn=4b78637e_11 | 2000 | Iron Powder | 27 | 20 | 4.1 |  | Shielded | .039 |  |  |  | - | -55 - 105 |  | 17.3 x 10.4 x 17.3 | https://componentsearchengine.com/part-view/2000-270-V-RC/Bourns | https://www.bourns.com/inventory-search-results?PARTS=2000-270-V-RC
2000-270-H-RC | https://www.bourns.comhttps://bourns.com/docs/product-datasheets/2000_series.pdf?sfvrsn=4b78637e_11 | 2000 | Iron Powder | 27 | 20 | 4.1 |  | Shielded | .039 |  |  |  | - | -55 - 105 |  | 17.3 x 17.3 x 10.4 | https://componentsearchengine.com/part-view/2000-270-H-RC/Bourns | https://www.bourns.com/inventory-search-results?PARTS=2000-270-H-RC
2000-220-V-RC | https://www.bourns.comhttps://bourns.com/docs/product-datasheets/2000_series.pdf?sfvrsn=4b78637e_11 | 2000 | Iron Powder | 22 | 20 | 4.3 |  | Shielded | .035 |  |  |  | - | -55 - 105 |  | 17.3 x 10.4 x 17.3 | https://componentsearchengine.com/part-view/2000-220-V-RC/Bourns | https://www.bourns.com/inventory-search-results?PARTS=2000-220-V-RC
2000-220-H-RC | https://www.bourns.comhttps://bourns.com/docs/product-datasheets/2000_series.pdf?sfvrsn=4b78637e_11 | 2000 | Iron Powder | 22 | 20 | 4.3 |  | Shielded | .035 |  |  |  | - | -55 - 105 |  | 17.3 x 17.3 x 10.4 | https://componentsearchengine.com/part-view/2000-220-H-RC/Bourns | https://www.bourns.com/inventory-search-results?PARTS=2000-220-H-RC
2000-1R2-V-RC | https://www.bourns.comhttps://bourns.com/docs/product-datasheets/2000_series.pdf?sfvrsn=4b78637e_11 | 2000 | Iron Powder | 1.2 | 20 | 20.2 |  | Shielded | .0022 |  |  |  | - | -55 - 105 |  | 17.3 x 10.4 x 17.3 | https://componentsearchengine.com/part-view/2000-1R2-V-RC/Bourns | https://www.bourns.com/inventory-search-results?PARTS=2000-1R2-V-RC
2000-1R2-H-RC | https://www.bourns.comhttps://bourns.com/docs/product-datasheets/2000_series.pdf?sfvrsn=4b78637e_11 | 2000 | Iron Powder | 1.2 | 20 | 20.2 |  | Shielded | .0022 |  |  |  | - | -55 - 105 |  | 17.3 x 17.3 x 10.4 | https://componentsearchengine.com/part-view/2000-1R2-H-RC/Bourns | https://www.bourns.com/inventory-search-results?PARTS=2000-1R2-H-RC
2000-180-V-RC | https://www.bourns.comhttps://bourns.com/docs/product-datasheets/2000_series.pdf?sfvrsn=4b78637e_11 | 2000 | Iron Powder | 18 | 20 | 4.5 |  | Shielded | .032 |  |  |  | - | -55 - 105 |  | 17.3 x 10.4 x 17.3 | https://componentsearchengine.com/part-view/2000-180-V-RC/Bourns | https://www.bourns.com/inventory-search-results?PARTS=2000-180-V-RC
2000-180-H-RC | https://www.bourns.comhttps://bourns.com/docs/product-datasheets/2000_series.pdf?sfvrsn=4b78637e_11 | 2000 | Iron Powder | 18 | 20 | 4.5 |  | Shielded | .032 |  |  |  | - | -55 - 105 |  | 17.3 x 17.3 x 10.4 | https://componentsearchengine.com/part-view/2000-180-H-RC/Bourns | https://www.bourns.com/inventory-search-results?PARTS=2000-180-H-RC
2000-150-V-RC | https://www.bourns.comhttps://bourns.com/docs/product-datasheets/2000_series.pdf?sfvrsn=4b78637e_11 | 2000 | Iron Powder | 15 | 20 | 4.7 |  | Shielded | .029 |  |  |  | - | -55 - 105 |  | 17.3 x 10.4 x 17.3 | https://componentsearchengine.com/part-view/2000-150-V-RC/Bourns | https://www.bourns.com/inventory-search-results?PARTS=2000-150-V-RC
2000-150-H-RC | https://www.bourns.comhttps://bourns.com/docs/product-datasheets/2000_series.pdf?sfvrsn=4b78637e_11 | 2000 | Iron Powder | 15 | 20 | 4.7 |  | Shielded | .029 |  |  |  | - | -55 - 105 |  | 17.3 x 17.3 x 10.4 | https://componentsearchengine.com/part-view/2000-150-H-RC/Bourns | https://www.bourns.com/inventory-search-results?PARTS=2000-150-H-RC
2000-120-V-RC | https://www.bourns.comhttps://bourns.com/docs/product-datasheets/2000_series.pdf?sfvrsn=4b78637e_11 | 2000 | Iron Powder | 12 | 20 | 6.4 |  | Shielded | .016 |  |  |  | - | -55 - 105 |  | 17.3 x 10.4 x 17.3 | https://componentsearchengine.com/part-view/2000-120-V-RC/Bourns | https://www.bourns.com/inventory-search-results?PARTS=2000-120-V-RC
2000-120-H-RC | https://www.bourns.comhttps://bourns.com/docs/product-datasheets/2000_series.pdf?sfvrsn=4b78637e_11 | 2000 | Iron Powder | 12 | 20 | 6.4 |  | Shielded | .016 |  |  |  | - | -55 - 105 |  | 17.3 x 17.3 x 10.4 | https://componentsearchengine.com/part-view/2000-120-H-RC/Bourns | https://www.bourns.com/inventory-search-results?PARTS=2000-120-H-RC
2000-100-V-RC | https://www.bourns.comhttps://bourns.com/docs/product-datasheets/2000_series.pdf?sfvrsn=4b78637e_11 | 2000 | Iron Powder | 10 | 20 | 6.6 |  | Shielded | .015 |  |  |  | - | -55 - 105 |  | 17.3 x 10.4 x 17.3 | https://componentsearchengine.com/part-view/2000-100-V-RC/Bourns | https://www.bourns.com/inventory-search-results?PARTS=2000-100-V-RC
2000-100-H-RC | https://www.bourns.comhttps://bourns.com/docs/product-datasheets/2000_series.pdf?sfvrsn=4b78637e_11 | 2000 | Iron Powder | 10 | 20 | 6.6 |  | Shielded | .015 |  |  |  | - | -55 - 105 |  | 17.3 x 17.3 x 10.4 | https://componentsearchengine.com/part-view/2000-100-H-RC/Bourns | https://www.bourns.com/inventory-search-results?PARTS=2000-100-H-RC
2124-V-RC | https://www.bourns.comhttps://bourns.com/docs/product-datasheets/2100_series.pdf?sfvrsn=7e01698c_7 | 2100 | Iron Powder | 1000 | 15 | 1.3 |  | Shielded | .4 |  |  |  | - | -55 - 105 |  | 21.8 x 11.4 x 21.8 | https://componentsearchengine.com/part-view/2124-V-RC/Bourns | https://www.bourns.com/inventory-search-results?PARTS=2124-V-RC
2124-H-RC | https://www.bourns.comhttps://bourns.com/docs/product-datasheets/2100_series.pdf?sfvrsn=7e01698c_7 | 2100 | Iron Powder | 1000 | 15 | 1.3 |  | Shielded | .4 |  |  |  | - | -55 - 105 |  | 21.8 x 21.8 x 11.4 | https://componentsearchengine.com/part-view/2124-H-RC/Bourns | https://www.bourns.com/inventory-search-results?PARTS=2124-H-RC
2123-V-RC | https://www.bourns.comhttps://bourns.com/docs/product-datasheets/2100_series.pdf?sfvrsn=7e01698c_7 | 2100 | Iron Powder | 820 | 15 | 1.4 |  | Shielded | .37 |  |  |  | - | -55 - 105 |  | 21.8 x 11.4 x 21.8 | https://componentsearchengine.com/part-view/2123-V-RC/Bourns | https://www.bourns.com/inventory-search-results?PARTS=2123-V-RC
2123-H-RC | https://www.bourns.comhttps://bourns.com/docs/product-datasheets/2100_series.pdf?sfvrsn=7e01698c_7 | 2100 | Iron Powder | 820 | 15 | 1.4 |  | Shielded | .37 |  |  |  | - | -55 - 105 |  | 21.8 x 21.8 x 11.4 | https://componentsearchengine.com/part-view/2123-H-RC/Bourns | https://www.bourns.com/inventory-search-results?PARTS=2123-H-RC
2122-V-RC | https://www.bourns.comhttps://bourns.com/docs/product-datasheets/2100_series.pdf?sfvrsn=7e01698c_7 | 2100 | Iron Powder | 680 | 15 | 1.4 |  | Shielded | .33 |  |  |  | - | -55 - 105 |  | 21.8 x 11.4 x 21.8 | https://componentsearchengine.com/part-view/2122-V-RC/Bourns | https://www.bourns.com/inventory-search-results?PARTS=2122-V-RC
2122-H-RC | https://www.bourns.comhttps://bourns.com/docs/product-datasheets/2100_series.pdf?sfvrsn=7e01698c_7 | 2100 | Iron Powder | 680 | 15 | 1.4 |  | Shielded | .33 |  |  |  | - | -55 - 105 |  | 21.8 x 21.8 x 11.4 | https://componentsearchengine.com/part-view/2122-H-RC/Bourns | https://www.bourns.com/inventory-search-results?PARTS=2122-H-RC
2121-V-RC | https://www.bourns.comhttps://bourns.com/docs/product-datasheets/2100_series.pdf?sfvrsn=7e01698c_7 | 2100 | Iron Powder | 560 | 15 | 1.5 |  | Shielded | .3 |  |  |  | - | -55 - 105 |  | 21.8 x 11.4 x 21.8 | https://componentsearchengine.com/part-view/2121-V-RC/Bourns | https://www.bourns.com/inventory-search-results?PARTS=2121-V-RC
2121-H-RC | https://www.bourns.comhttps://bourns.com/docs/product-datasheets/2100_series.pdf?sfvrsn=7e01698c_7 | 2100 | Iron Powder | 560 | 15 | 1.5 |  | Shielded | .3 |  |  |  | - | -55 - 105 |  | 21.8 x 21.8 x 11.4 | https://componentsearchengine.com/part-view/2121-H-RC/Bourns | https://www.bourns.com/inventory-search-results?PARTS=2121-H-RC
2120-V-RC | https://www.bourns.comhttps://bourns.com/docs/product-datasheets/2100_series.pdf?sfvrsn=7e01698c_7 | 2100 | Iron Powder | 470 | 15 | 1.6 |  | Shielded | .28 |  |  |  | - | -55 - 105 |  | 21.8 x 11.4 x 21.8 | https://componentsearchengine.com/part-view/2120-V-RC/Bourns | https://www.bourns.com/inventory-search-results?PARTS=2120-V-RC
2120-H-RC | https://www.bourns.comhttps://bourns.com/docs/product-datasheets/2100_series.pdf?sfvrsn=7e01698c_7 | 2100 | Iron Powder | 470 | 15 | 1.6 |  | Shielded | .28 |  |  |  | - | -55 - 105 |  | 21.8 x 21.8 x 11.4 | https://componentsearchengine.com/part-view/2120-H-RC/Bourns | https://www.bourns.com/inventory-search-results?PARTS=2120-H-RC
2119-V-RC | https://www.bourns.comhttps://bourns.com/docs/product-datasheets/2100_series.pdf?sfvrsn=7e01698c_7 | 2100 | Iron Powder | 390 | 15 | 1.7 |  | Shielded | .25 |  |  |  | - | -55 - 105 |  | 21.8 x 11.4 x 21.8 | https://componentsearchengine.com/part-view/2119-V-RC/Bourns | https://www.bourns.com/inventory-search-results?PARTS=2119-V-RC
2119-H-RC | https://www.bourns.comhttps://bourns.com/docs/product-datasheets/2100_series.pdf?sfvrsn=7e01698c_7 | 2100 | Iron Powder | 390 | 15 | 1.7 |  | Shielded | .25 |  |  |  | - | -55 - 105 |  | 21.8 x 21.8 x 11.4 | https://componentsearchengine.com/part-view/2119-H-RC/Bourns | https://www.bourns.com/inventory-search-results?PARTS=2119-H-RC
2118-V-RC | https://www.bourns.comhttps://bourns.com/docs/product-datasheets/2100_series.pdf?sfvrsn=7e01698c_7 | 2100 | Iron Powder | 330 | 15 | 1.7 |  | Shielded | .23 |  |  |  | - | -55 - 105 |  | 21.8 x 11.4 x 21.8 | https://componentsearchengine.com/part-view/2118-V-RC/Bourns | https://www.bourns.com/inventory-search-results?PARTS=2118-V-RC
2118-H-RC | https://www.bourns.comhttps://bourns.com/docs/product-datasheets/2100_series.pdf?sfvrsn=7e01698c_7 | 2100 | Iron Powder | 330 | 15 | 1.7 |  | Shielded | .23 |  |  |  | - | -55 - 105 |  | 21.8 x 21.8 x 11.4 | https://componentsearchengine.com/part-view/2118-H-RC/Bourns | https://www.bourns.com/inventory-search-results?PARTS=2118-H-RC
2117-V-RC | https://www.bourns.comhttps://bourns.com/docs/product-datasheets/2100_series.pdf?sfvrsn=7e01698c_7 | 2100 | Iron Powder | 270 | 15 | 1.8 |  | Shielded | .21 |  |  |  | - | -55 - 105 |  | 21.8 x 11.4 x 21.8 | https://componentsearchengine.com/part-view/2117-V-RC/Bourns | https://www.bourns.com/inventory-search-results?PARTS=2117-V-RC
2117-H-RC | https://www.bourns.comhttps://bourns.com/docs/product-datasheets/2100_series.pdf?sfvrsn=7e01698c_7 | 2100 | Iron Powder | 270 | 15 | 1.8 |  | Shielded | .21 |  |  |  | - | -55 - 105 |  | 21.8 x 21.8 x 11.4 | https://componentsearchengine.com/part-view/2117-H-RC/Bourns | https://www.bourns.com/inventory-search-results?PARTS=2117-H-RC
2116-V-RC | https://www.bourns.comhttps://bourns.com/docs/product-datasheets/2100_series.pdf?sfvrsn=7e01698c_7 | 2100 | Iron Powder | 220 | 15 | 2.4 |  | Shielded | .12 |  |  |  | - | -55 - 105 |  | 21.8 x 11.4 x 21.8 | https://componentsearchengine.com/part-view/2116-V-RC/Bourns | https://www.bourns.com/inventory-search-results?PARTS=2116-V-RC
2116-H-RC | https://www.bourns.comhttps://bourns.com/docs/product-datasheets/2100_series.pdf?sfvrsn=7e01698c_7 | 2100 | Iron Powder | 220 | 15 | 2.4 |  | Shielded | .12 |  |  |  | - | -55 - 105 |  | 21.8 x 21.8 x 11.4 | https://componentsearchengine.com/part-view/2116-H-RC/Bourns | https://www.bourns.com/inventory-search-results?PARTS=2116-H-RC
2115-V-RC | https://www.bourns.comhttps://bourns.com/docs/product-datasheets/2100_series.pdf?sfvrsn=7e01698c_7 | 2100 | Iron Powder | 180 | 15 | 2.6 |  | Shielded | .11 |  |  |  | - | -55 - 105 |  | 21.8 x 11.4 x 21.8 | https://componentsearchengine.com/part-view/2115-V-RC/Bourns | https://www.bourns.com/inventory-search-results?PARTS=2115-V-RC
2115-H-RC | https://www.bourns.comhttps://bourns.com/docs/product-datasheets/2100_series.pdf?sfvrsn=7e01698c_7 | 2100 | Iron Powder | 180 | 15 | 2.6 |  | Shielded | .11 |  |  |  | - | -55 - 105 |  | 21.8 x 21.8 x 11.4 | https://componentsearchengine.com/part-view/2115-H-RC/Bourns | https://www.bourns.com/inventory-search-results?PARTS=2115-H-RC
2114-V-RC | https://www.bourns.comhttps://bourns.com/docs/product-datasheets/2100_series.pdf?sfvrsn=7e01698c_7 | 2100 | Iron Powder | 150 | 15 | 3.4 |  | Shielded | .062 |  |  |  | - | -55 - 105 |  | 21.8 x 11.4 x 21.8 | https://componentsearchengine.com/part-view/2114-V-RC/Bourns | https://www.bourns.com/inventory-search-results?PARTS=2114-V-RC
2114-H-RC | https://www.bourns.comhttps://bourns.com/docs/product-datasheets/2100_series.pdf?sfvrsn=7e01698c_7 | 2100 | Iron Powder | 150 | 15 | 3.4 |  | Shielded | .062 |  |  |  | - | -55 - 105 |  | 21.8 x 21.8 x 11.4 | https://componentsearchengine.com/part-view/2114-H-RC/Bourns | https://www.bourns.com/inventory-search-results?PARTS=2114-H-RC
2113-V-RC | https://www.bourns.comhttps://bourns.com/docs/product-datasheets/2100_series.pdf?sfvrsn=7e01698c_7 | 2100 | Iron Powder | 120 | 15 | 2.2 |  | Shielded | .15 |  |  |  | - | -55 - 105 |  | 21.8 x 11.4 x 21.8 | https://componentsearchengine.com/part-view/2113-V-RC/Bourns | https://www.bourns.com/inventory-search-results?PARTS=2113-V-RC
2113-H-RC | https://www.bourns.comhttps://bourns.com/docs/product-datasheets/2100_series.pdf?sfvrsn=7e01698c_7 | 2100 | Iron Powder | 120 | 15 | 2.2 |  | Shielded | .15 |  |  |  | - | -55 - 105 |  | 21.8 x 21.8 x 11.4 | https://componentsearchengine.com/part-view/2113-H-RC/Bourns | https://www.bourns.com/inventory-search-results?PARTS=2113-H-RC
2112-V-RC | https://www.bourns.comhttps://bourns.com/docs/product-datasheets/2100_series.pdf?sfvrsn=7e01698c_7 | 2100 | Iron Powder | 100 | 15 | 2.4 |  | Shielded | .13 |  |  |  | - | -55 - 105 |  | 21.8 x 11.4 x 21.8 | https://componentsearchengine.com/part-view/2112-V-RC/Bourns | https://www.bourns.com/inventory-search-results?PARTS=2112-V-RC
2112-H-RC | https://www.bourns.comhttps://bourns.com/docs/product-datasheets/2100_series.pdf?sfvrsn=7e01698c_7 | 2100 | Iron Powder | 100 | 15 | 2.4 |  | Shielded | .13 |  |  |  | - | -55 - 105 |  | 21.8 x 21.8 x 11.4 | https://componentsearchengine.com/part-view/2112-H-RC/Bourns | https://www.bourns.com/inventory-search-results?PARTS=2112-H-RC
2111-V-RC | https://www.bourns.comhttps://bourns.com/docs/product-datasheets/2100_series.pdf?sfvrsn=7e01698c_7 | 2100 | Iron Powder | 68 | 15 | 3.3 |  | Shielded | .067 |  |  |  | - | -55 - 105 |  | 21.8 x 11.4 x 21.8 | https://componentsearchengine.com/part-view/2111-V-RC/Bourns | https://www.bourns.com/inventory-search-results?PARTS=2111-V-RC
2111-H-RC | https://www.bourns.comhttps://bourns.com/docs/product-datasheets/2100_series.pdf?sfvrsn=7e01698c_7 | 2100 | Iron Powder | 68 | 15 | 3.3 |  | Shielded | .067 |  |  |  | - | -55 - 105 |  | 21.8 x 21.8 x 11.4 | https://componentsearchengine.com/part-view/2111-H-RC/Bourns | https://www.bourns.com/inventory-search-results?PARTS=2111-H-RC
2110-V-RC | https://www.bourns.comhttps://bourns.com/docs/product-datasheets/2100_series.pdf?sfvrsn=7e01698c_7 | 2100 | Iron Powder | 56 | 15 | 3.4 |  | Shielded | .06 |  |  |  | - | -55 - 105 |  | 21.8 x 11.4 x 21.8 | https://componentsearchengine.com/part-view/2110-V-RC/Bourns | https://www.bourns.com/inventory-search-results?PARTS=2110-V-RC
2110-H-RC | https://www.bourns.comhttps://bourns.com/docs/product-datasheets/2100_series.pdf?sfvrsn=7e01698c_7 | 2100 | Iron Powder | 56 | 15 | 3.4 |  | Shielded | .06 |  |  |  | - | -55 - 105 |  | 21.8 x 21.8 x 11.4 | https://componentsearchengine.com/part-view/2110-H-RC/Bourns | https://www.bourns.com/inventory-search-results?PARTS=2110-H-RC
2109-V-RC | https://www.bourns.comhttps://bourns.com/docs/product-datasheets/2100_series.pdf?sfvrsn=7e01698c_7 | 2100 | Iron Powder | 47 | 15 | 3.6 |  | Shielded | .055 |  |  |  | - | -55 - 105 |  | 21.8 x 11.4 x 21.8 | https://componentsearchengine.com/part-view/2109-V-RC/Bourns | https://www.bourns.com/inventory-search-results?PARTS=2109-V-RC
2109-H-RC | https://www.bourns.comhttps://bourns.com/docs/product-datasheets/2100_series.pdf?sfvrsn=7e01698c_7 | 2100 | Iron Powder | 47 | 15 | 3.6 |  | Shielded | .055 |  |  |  | - | -55 - 105 |  | 21.8 x 21.8 x 11.4 | https://componentsearchengine.com/part-view/2109-H-RC/Bourns | https://www.bourns.com/inventory-search-results?PARTS=2109-H-RC
2108-V-RC | https://www.bourns.comhttps://bourns.com/docs/product-datasheets/2100_series.pdf?sfvrsn=7e01698c_7 | 2100 | Iron Powder | 39 | 15 | 4.8 |  | Shielded | .032 |  |  |  | - | -55 - 105 |  | 21.8 x 11.4 x 21.8 | https://componentsearchengine.com/part-view/2108-V-RC/Bourns | https://www.bourns.com/inventory-search-results?PARTS=2108-V-RC
2108-H-RC | https://www.bourns.comhttps://bourns.com/docs/product-datasheets/2100_series.pdf?sfvrsn=7e01698c_7 | 2100 | Iron Powder | 39 | 15 | 4.8 |  | Shielded | .032 |  |  |  | - | -55 - 105 |  | 21.8 x 21.8 x 11.4 | https://componentsearchengine.com/part-view/2108-H-RC/Bourns | https://www.bourns.com/inventory-search-results?PARTS=2108-H-RC
2107-V-RC | https://www.bourns.comhttps://bourns.com/docs/product-datasheets/2100_series.pdf?sfvrsn=7e01698c_7 | 2100 | Iron Powder | 33 | 15 | 5 |  | Shielded | .029 |  |  |  | - | -55 - 105 |  | 21.8 x 11.4 x 21.8 | https://componentsearchengine.com/part-view/2107-V-RC/Bourns | https://www.bourns.com/inventory-search-results?PARTS=2107-V-RC
2107-H-RC | https://www.bourns.comhttps://bourns.com/docs/product-datasheets/2100_series.pdf?sfvrsn=7e01698c_7 | 2100 | Iron Powder | 33 | 15 | 5 |  | Shielded | .029 |  |  |  | - | -55 - 105 |  | 21.8 x 21.8 x 11.4 | https://componentsearchengine.com/part-view/2107-H-RC/Bourns | https://www.bourns.com/inventory-search-results?PARTS=2107-H-RC
2106-V-RC | https://www.bourns.comhttps://bourns.com/docs/product-datasheets/2100_series.pdf?sfvrsn=7e01698c_7 | 2100 | Iron Powder | 27 | 15 | 5.3 |  | Shielded | .026 |  |  |  | - | -55 - 105 |  | 21.8 x 11.4 x 21.8 | https://componentsearchengine.com/part-view/2106-V-RC/Bourns | https://www.bourns.com/inventory-search-results?PARTS=2106-V-RC
2106-H-RC | https://www.bourns.comhttps://bourns.com/docs/product-datasheets/2100_series.pdf?sfvrsn=7e01698c_7 | 2100 | Iron Powder | 27 | 15 | 5.3 |  | Shielded | .026 |  |  |  | - | -55 - 105 |  | 21.8 x 21.8 x 11.4 | https://componentsearchengine.com/part-view/2106-H-RC/Bourns | https://www.bourns.com/inventory-search-results?PARTS=2106-H-RC
2105-V-RC | https://www.bourns.comhttps://bourns.com/docs/product-datasheets/2100_series.pdf?sfvrsn=7e01698c_7 | 2100 | Iron Powder | 22 | 15 | 7 |  | Shielded | .015 |  |  |  | - | -55 - 105 |  | 21.8 x 11.4 x 21.8 | https://componentsearchengine.com/part-view/2105-V-RC/Bourns | https://www.bourns.com/inventory-search-results?PARTS=2105-V-RC
2105-H-RC | https://www.bourns.comhttps://bourns.com/docs/product-datasheets/2100_series.pdf?sfvrsn=7e01698c_7 | 2100 | Iron Powder | 22 | 15 | 7 |  | Shielded | .015 |  |  |  | - | -55 - 105 |  | 21.8 x 21.8 x 11.4 | https://componentsearchengine.com/part-view/2105-H-RC/Bourns | https://www.bourns.com/inventory-search-results?PARTS=2105-H-RC
2104-V-RC | https://www.bourns.comhttps://bourns.com/docs/product-datasheets/2100_series.pdf?sfvrsn=7e01698c_7 | 2100 | Iron Powder | 18 | 15 | 7.4 |  | Shielded | .013 |  |  |  | - | -55 - 105 |  | 21.8 x 11.4 x 21.8 | https://componentsearchengine.com/part-view/2104-V-RC/Bourns | https://www.bourns.com/inventory-search-results?PARTS=2104-V-RC
2104-H-RC | https://www.bourns.comhttps://bourns.com/docs/product-datasheets/2100_series.pdf?sfvrsn=7e01698c_7 | 2100 | Iron Powder | 18 | 15 | 7.4 |  | Shielded | .013 |  |  |  | - | -55 - 105 |  | 21.8 x 21.8 x 11.4 | https://componentsearchengine.com/part-view/2104-H-RC/Bourns | https://www.bourns.com/inventory-search-results?PARTS=2104-H-RC
2103-V-RC | https://www.bourns.comhttps://bourns.com/docs/product-datasheets/2100_series.pdf?sfvrsn=7e01698c_7 | 2100 | Iron Powder | 15 | 15 | 7.7 |  | Shielded | .012 |  |  |  | - | -55 - 105 |  | 21.8 x 11.4 x 21.8 | https://componentsearchengine.com/part-view/2103-V-RC/Bourns | https://www.bourns.com/inventory-search-results?PARTS=2103-V-RC
2103-H-RC | https://www.bourns.comhttps://bourns.com/docs/product-datasheets/2100_series.pdf?sfvrsn=7e01698c_7 | 2100 | Iron Powder | 15 | 15 | 7.7 |  | Shielded | .012 |  |  |  | - | -55 - 105 |  | 21.8 x 21.8 x 11.4 | https://componentsearchengine.com/part-view/2103-H-RC/Bourns | https://www.bourns.com/inventory-search-results?PARTS=2103-H-RC
2102-V-RC | https://www.bourns.comhttps://bourns.com/docs/product-datasheets/2100_series.pdf?sfvrsn=7e01698c_7 | 2100 | Iron Powder | 12 | 15 | 10.3 |  | Shielded | .007 |  |  |  | - | -55 - 105 |  | 21.8 x 11.4 x 21.8 | https://componentsearchengine.com/part-view/2102-V-RC/Bourns | https://www.bourns.com/inventory-search-results?PARTS=2102-V-RC
2102-H-RC | https://www.bourns.comhttps://bourns.com/docs/product-datasheets/2100_series.pdf?sfvrsn=7e01698c_7 | 2100 | Iron Powder | 12 | 15 | 10.3 |  | Shielded | .007 |  |  |  | - | -55 - 105 |  | 21.8 x 21.8 x 11.4 | https://componentsearchengine.com/part-view/2102-H-RC/Bourns | https://www.bourns.com/inventory-search-results?PARTS=2102-H-RC
2101-V-RC | https://www.bourns.comhttps://bourns.com/docs/product-datasheets/2100_series.pdf?sfvrsn=7e01698c_7 | 2100 | Iron Powder | 10 | 15 | 10.8 |  | Shielded | .006 |  |  |  | - | -55 - 105 |  | 21.8 x 11.4 x 21.8 | https://componentsearchengine.com/part-view/2101-V-RC/Bourns | https://www.bourns.com/inventory-search-results?PARTS=2101-V-RC
2101-H-RC | https://www.bourns.comhttps://bourns.com/docs/product-datasheets/2100_series.pdf?sfvrsn=7e01698c_7 | 2100 | Iron Powder | 10 | 15 | 10.8 |  | Shielded | .006 |  |  |  | - | -55 - 105 |  | 21.8 x 21.8 x 11.4 | https://componentsearchengine.com/part-view/2101-H-RC/Bourns | https://www.bourns.com/inventory-search-results?PARTS=2101-H-RC
2100HT-8R2--V-RC | https://www.bourns.comhttps://bourns.com/docs/product-datasheets/2100ht_series.pdf?sfvrsn=4ba5b1f4_7 | 2100HT | Iron Powder | 8.2 | 15 | 13.2 |  | Shielded | .007 |  |  |  | - | -55 - 105 |  | 21.8 x 11.4 x 21.8 | https://componentsearchengine.com/part-view/2100HT-8R2--V-RC/Bourns | https://www.bourns.com/inventory-search-results?PARTS=2100HT-8R2--V-RC
2100HT-8R2--H-RC | https://www.bourns.comhttps://bourns.com/docs/product-datasheets/2100ht_series.pdf?sfvrsn=4ba5b1f4_7 | 2100HT | Iron Powder | 8.2 | 15 | 13.2 |  | Shielded | .007 |  |  |  | - | -55 - 105 |  | 21.8 x 21.8 x 11.4 | https://componentsearchengine.com/part-view/2100HT-8R2--H-RC/Bourns | https://www.bourns.com/inventory-search-results?PARTS=2100HT-8R2--H-RC
2100HT-821--V-RC | https://www.bourns.comhttps://bourns.com/docs/product-datasheets/2100ht_series.pdf?sfvrsn=4ba5b1f4_7 | 2100HT | Iron Powder | 820 | 15 | 1.7 |  | Shielded | .39 |  |  |  | - | -55 - 105 |  | 21.8 x 11.4 x 21.8 | https://componentsearchengine.com/part-view/2100HT-821--V-RC/Bourns | https://www.bourns.com/inventory-search-results?PARTS=2100HT-821--V-RC
2100HT-821--H-RC | https://www.bourns.comhttps://bourns.com/docs/product-datasheets/2100ht_series.pdf?sfvrsn=4ba5b1f4_7 | 2100HT | Iron Powder | 820 | 15 | 1.7 |  | Shielded | .39 |  |  |  | - | -55 - 105 |  | 21.8 x 21.8 x 11.4 | https://componentsearchengine.com/part-view/2100HT-821--H-RC/Bourns | https://www.bourns.com/inventory-search-results?PARTS=2100HT-821--H-RC
2100HT-820--V-RC | https://www.bourns.comhttps://bourns.com/docs/product-datasheets/2100ht_series.pdf?sfvrsn=4ba5b1f4_7 | 2100HT | Iron Powder | 82 | 15 | 4.8 |  | Shielded | .049 |  |  |  | - | -55 - 105 |  | 21.8 x 11.4 x 21.8 | https://componentsearchengine.com/part-view/2100HT-820--V-RC/Bourns | https://www.bourns.com/inventory-search-results?PARTS=2100HT-820--V-RC
2100HT-820--H-RC | https://www.bourns.comhttps://bourns.com/docs/product-datasheets/2100ht_series.pdf?sfvrsn=4ba5b1f4_7 | 2100HT | Iron Powder | 82 | 15 | 4.8 |  | Shielded | .049 |  |  |  | - | -55 - 105 |  | 21.8 x 21.8 x 11.4 | https://componentsearchengine.com/part-view/2100HT-820--H-RC/Bourns | https://www.bourns.com/inventory-search-results?PARTS=2100HT-820--H-RC
2100HT-6R8--V-RC | https://www.bourns.comhttps://bourns.com/docs/product-datasheets/2100ht_series.pdf?sfvrsn=4ba5b1f4_7 | 2100HT | Iron Powder | 6.8 | 15 | 13.7 |  | Shielded | .006 |  |  |  | - | -55 - 105 |  | 21.8 x 11.4 x 21.8 | https://componentsearchengine.com/part-view/2100HT-6R8--V-RC/Bourns | https://www.bourns.com/inventory-search-results?PARTS=2100HT-6R8--V-RC
2100HT-6R8--H-RC | https://www.bourns.comhttps://bourns.com/docs/product-datasheets/2100ht_series.pdf?sfvrsn=4ba5b1f4_7 | 2100HT | Iron Powder | 6.8 | 15 | 13.7 |  | Shielded | .006 |  |  |  | - | -55 - 105 |  | 21.8 x 21.8 x 11.4 | https://componentsearchengine.com/part-view/2100HT-6R8--H-RC/Bourns | https://www.bourns.com/inventory-search-results?PARTS=2100HT-6R8--H-RC
2100HT-681--V-RC | https://www.bourns.comhttps://bourns.com/docs/product-datasheets/2100ht_series.pdf?sfvrsn=4ba5b1f4_7 | 2100HT | Iron Powder | 680 | 15 | 1.8 |  | Shielded | .35 |  |  |  | - | -55 - 105 |  | 21.8 x 11.4 x 21.8 | https://componentsearchengine.com/part-view/2100HT-681--V-RC/Bourns | https://www.bourns.com/inventory-search-results?PARTS=2100HT-681--V-RC
2100HT-681--H-RC | https://www.bourns.comhttps://bourns.com/docs/product-datasheets/2100ht_series.pdf?sfvrsn=4ba5b1f4_7 | 2100HT | Iron Powder | 680 | 15 | 1.8 |  | Shielded | .35 |  |  |  | - | -55 - 105 |  | 21.8 x 21.8 x 11.4 | https://componentsearchengine.com/part-view/2100HT-681--H-RC/Bourns | https://www.bourns.com/inventory-search-results?PARTS=2100HT-681--H-RC
2100HT-680--V-RC | https://www.bourns.comhttps://bourns.com/docs/product-datasheets/2100ht_series.pdf?sfvrsn=4ba5b1f4_7 | 2100HT | Iron Powder | 68 | 15 | 5.1 |  | Shielded | .044 |  |  |  | - | -55 - 105 |  | 21.8 x 11.4 x 21.8 | https://componentsearchengine.com/part-view/2100HT-680--V-RC/Bourns | https://www.bourns.com/inventory-search-results?PARTS=2100HT-680--V-RC
2100HT-680--H-RC | https://www.bourns.comhttps://bourns.com/docs/product-datasheets/2100ht_series.pdf?sfvrsn=4ba5b1f4_7 | 2100HT | Iron Powder | 68 | 15 | 5.1 |  | Shielded | .044 |  |  |  | - | -55 - 105 |  | 21.8 x 21.8 x 11.4 | https://componentsearchengine.com/part-view/2100HT-680--H-RC/Bourns | https://www.bourns.com/inventory-search-results?PARTS=2100HT-680--H-RC
2100HT-5R6--V-RC | https://www.bourns.comhttps://bourns.com/docs/product-datasheets/2100ht_series.pdf?sfvrsn=4ba5b1f4_7 | 2100HT | Iron Powder | 5.6 | 15 | 14.3 |  | Shielded | .006 |  |  |  | - | -55 - 105 |  | 21.8 x 11.4 x 21.8 | https://componentsearchengine.com/part-view/2100HT-5R6--V-RC/Bourns | https://www.bourns.com/inventory-search-results?PARTS=2100HT-5R6--V-RC
2100HT-5R6--H-RC | https://www.bourns.comhttps://bourns.com/docs/product-datasheets/2100ht_series.pdf?sfvrsn=4ba5b1f4_7 | 2100HT | Iron Powder | 5.6 | 15 | 14.3 |  | Shielded | .006 |  |  |  | - | -55 - 105 |  | 21.8 x 21.8 x 11.4 | https://componentsearchengine.com/part-view/2100HT-5R6--H-RC/Bourns | https://www.bourns.com/inventory-search-results?PARTS=2100HT-5R6--H-RC
2100HT-561--V-RC | https://www.bourns.comhttps://bourns.com/docs/product-datasheets/2100ht_series.pdf?sfvrsn=4ba5b1f4_7 | 2100HT | Iron Powder | 560 | 15 | 1.9 |  | Shielded | .32 |  |  |  | - | -55 - 105 |  | 21.8 x 11.4 x 21.8 | https://componentsearchengine.com/part-view/2100HT-561--V-RC/Bourns | https://www.bourns.com/inventory-search-results?PARTS=2100HT-561--V-RC
2100HT-561--H-RC | https://www.bourns.comhttps://bourns.com/docs/product-datasheets/2100ht_series.pdf?sfvrsn=4ba5b1f4_7 | 2100HT | Iron Powder | 560 | 15 | 1.9 |  | Shielded | .32 |  |  |  | - | -55 - 105 |  | 21.8 x 21.8 x 11.4 | https://componentsearchengine.com/part-view/2100HT-561--H-RC/Bourns | https://www.bourns.com/inventory-search-results?PARTS=2100HT-561--H-RC
2100HT-560--V-RC | https://www.bourns.comhttps://bourns.com/docs/product-datasheets/2100ht_series.pdf?sfvrsn=4ba5b1f4_7 | 2100HT | Iron Powder | 56 | 15 | 5.3 |  | Shielded | .04 |  |  |  | - | -55 - 105 |  | 21.8 x 11.4 x 21.8 | https://componentsearchengine.com/part-view/2100HT-560--V-RC/Bourns | https://www.bourns.com/inventory-search-results?PARTS=2100HT-560--V-RC
2100HT-560--H-RC | https://www.bourns.comhttps://bourns.com/docs/product-datasheets/2100ht_series.pdf?sfvrsn=4ba5b1f4_7 | 2100HT | Iron Powder | 56 | 15 | 5.3 |  | Shielded | .04 |  |  |  | - | -55 - 105 |  | 21.8 x 21.8 x 11.4 | https://componentsearchengine.com/part-view/2100HT-560--H-RC/Bourns | https://www.bourns.com/inventory-search-results?PARTS=2100HT-560--H-RC
2100HT-4R7--V-RC | https://www.bourns.comhttps://bourns.com/docs/product-datasheets/2100ht_series.pdf?sfvrsn=4ba5b1f4_7 | 2100HT | Iron Powder | 4.7 | 15 | 14.9 |  | Shielded | .006 |  |  |  | - | -55 - 105 |  | 21.8 x 11.4 x 21.8 | https://componentsearchengine.com/part-view/2100HT-4R7--V-RC/Bourns | https://www.bourns.com/inventory-search-results?PARTS=2100HT-4R7--V-RC
2100HT-4R7--H-RC | https://www.bourns.comhttps://bourns.com/docs/product-datasheets/2100ht_series.pdf?sfvrsn=4ba5b1f4_7 | 2100HT | Iron Powder | 4.7 | 15 | 14.9 |  | Shielded | .006 |  |  |  | - | -55 - 105 |  | 21.8 x 21.8 x 11.4 | https://componentsearchengine.com/part-view/2100HT-4R7--H-RC/Bourns | https://www.bourns.com/inventory-search-results?PARTS=2100HT-4R7--H-RC
2100HT-471--V-RC | https://www.bourns.comhttps://bourns.com/docs/product-datasheets/2100ht_series.pdf?sfvrsn=4ba5b1f4_7 | 2100HT | Iron Powder | 470 | 15 | 2 |  | Shielded | .29 |  |  |  | - | -55 - 105 |  | 21.8 x 11.4 x 21.8 | https://componentsearchengine.com/part-view/2100HT-471--V-RC/Bourns | https://www.bourns.com/inventory-search-results?PARTS=2100HT-471--V-RC
2100HT-471--H-RC | https://www.bourns.comhttps://bourns.com/docs/product-datasheets/2100ht_series.pdf?sfvrsn=4ba5b1f4_7 | 2100HT | Iron Powder | 470 | 15 | 2 |  | Shielded | .29 |  |  |  | - | -55 - 105 |  | 21.8 x 21.8 x 11.4 | https://componentsearchengine.com/part-view/2100HT-471--H-RC/Bourns | https://www.bourns.com/inventory-search-results?PARTS=2100HT-471--H-RC
2100HT-470--V-RC | https://www.bourns.comhttps://bourns.com/docs/product-datasheets/2100ht_series.pdf?sfvrsn=4ba5b1f4_7 | 2100HT | Iron Powder | 47 | 15 | 5.6 |  | Shielded | .036 |  |  |  | - | -55 - 105 |  | 21.8 x 11.4 x 21.8 | https://componentsearchengine.com/part-view/2100HT-470--V-RC/Bourns | https://www.bourns.com/inventory-search-results?PARTS=2100HT-470--V-RC
2100HT-470--H-RC | https://www.bourns.comhttps://bourns.com/docs/product-datasheets/2100ht_series.pdf?sfvrsn=4ba5b1f4_7 | 2100HT | Iron Powder | 47 | 15 | 5.6 |  | Shielded | .036 |  |  |  | - | -55 - 105 |  | 21.8 x 21.8 x 11.4 | https://componentsearchengine.com/part-view/2100HT-470--H-RC/Bourns | https://www.bourns.com/inventory-search-results?PARTS=2100HT-470--H-RC
2100HT-3R9--V-RC | https://www.bourns.comhttps://bourns.com/docs/product-datasheets/2100ht_series.pdf?sfvrsn=4ba5b1f4_7 | 2100HT | Iron Powder | 3.9 | 15 | 15.3 |  | Shielded | .005 |  |  |  | - | -55 - 105 |  | 21.8 x 11.4 x 21.8 | https://componentsearchengine.com/part-view/2100HT-3R9--V-RC/Bourns | https://www.bourns.com/inventory-search-results?PARTS=2100HT-3R9--V-RC
2100HT-3R9--H-RC | https://www.bourns.comhttps://bourns.com/docs/product-datasheets/2100ht_series.pdf?sfvrsn=4ba5b1f4_7 | 2100HT | Iron Powder | 3.9 | 15 | 15.3 |  | Shielded | .005 |  |  |  | - | -55 - 105 |  | 21.8 x 21.8 x 11.4 | https://componentsearchengine.com/part-view/2100HT-3R9--H-RC/Bourns | https://www.bourns.com/inventory-search-results?PARTS=2100HT-3R9--H-RC
2100HT-3R3--V-RC | https://www.bourns.comhttps://bourns.com/docs/product-datasheets/2100ht_series.pdf?sfvrsn=4ba5b1f4_7 | 2100HT | Iron Powder | 3.3 | 15 | 16.1 |  | Shielded | .005 |  |  |  | - | -55 - 105 |  | 21.8 x 11.4 x 21.8 | https://componentsearchengine.com/part-view/2100HT-3R3--V-RC/Bourns | https://www.bourns.com/inventory-search-results?PARTS=2100HT-3R3--V-RC
2100HT-3R3--H-RC | https://www.bourns.comhttps://bourns.com/docs/product-datasheets/2100ht_series.pdf?sfvrsn=4ba5b1f4_7 | 2100HT | Iron Powder | 3.3 | 15 | 16.1 |  | Shielded | .005 |  |  |  | - | -55 - 105 |  | 21.8 x 21.8 x 11.4 | https://componentsearchengine.com/part-view/2100HT-3R3--H-RC/Bourns | https://www.bourns.com/inventory-search-results?PARTS=2100HT-3R3--H-RC
2100HT-391--V-RC | https://www.bourns.comhttps://bourns.com/docs/product-datasheets/2100ht_series.pdf?sfvrsn=4ba5b1f4_7 | 2100HT | Iron Powder | 390 | 15 | 2.1 |  | Shielded | .27 |  |  |  | - | -55 - 105 |  | 21.8 x 11.4 x 21.8 | https://componentsearchengine.com/part-view/2100HT-391--V-RC/Bourns | https://www.bourns.com/inventory-search-results?PARTS=2100HT-391--V-RC
2100HT-391--H-RC | https://www.bourns.comhttps://bourns.com/docs/product-datasheets/2100ht_series.pdf?sfvrsn=4ba5b1f4_7 | 2100HT | Iron Powder | 390 | 15 | 2.1 |  | Shielded | .27 |  |  |  | - | -55 - 105 |  | 21.8 x 21.8 x 11.4 | https://componentsearchengine.com/part-view/2100HT-391--H-RC/Bourns | https://www.bourns.com/inventory-search-results?PARTS=2100HT-391--H-RC
2100HT-390--V-RC | https://www.bourns.comhttps://bourns.com/docs/product-datasheets/2100ht_series.pdf?sfvrsn=4ba5b1f4_7 | 2100HT | Iron Powder | 39 | 15 | 5.9 |  | Shielded | .033 |  |  |  | - | -55 - 105 |  | 21.8 x 11.4 x 21.8 | https://componentsearchengine.com/part-view/2100HT-390--V-RC/Bourns | https://www.bourns.com/inventory-search-results?PARTS=2100HT-390--V-RC
2100HT-390--H-RC | https://www.bourns.comhttps://bourns.com/docs/product-datasheets/2100ht_series.pdf?sfvrsn=4ba5b1f4_7 | 2100HT | Iron Powder | 39 | 15 | 5.9 |  | Shielded | .033 |  |  |  | - | -55 - 105 |  | 21.8 x 21.8 x 11.4 | https://componentsearchengine.com/part-view/2100HT-390--H-RC/Bourns | https://www.bourns.com/inventory-search-results?PARTS=2100HT-390--H-RC
2100HT-331--V-RC | https://www.bourns.comhttps://bourns.com/docs/product-datasheets/2100ht_series.pdf?sfvrsn=4ba5b1f4_7 | 2100HT | Iron Powder | 330 | 15 | 2.7 |  | Shielded | .16 |  |  |  | - | -55 - 105 |  | 21.8 x 11.4 x 21.8 | https://componentsearchengine.com/part-view/2100HT-331--V-RC/Bourns | https://www.bourns.com/inventory-search-results?PARTS=2100HT-331--V-RC
2100HT-331--H-RC | https://www.bourns.comhttps://bourns.com/docs/product-datasheets/2100ht_series.pdf?sfvrsn=4ba5b1f4_7 | 2100HT | Iron Powder | 330 | 15 | 2.7 |  | Shielded | .16 |  |  |  | - | -55 - 105 |  | 21.8 x 21.8 x 11.4 | https://componentsearchengine.com/part-view/2100HT-331--H-RC/Bourns | https://www.bourns.com/inventory-search-results?PARTS=2100HT-331--H-RC
2100HT-330--V-RC | https://www.bourns.comhttps://bourns.com/docs/product-datasheets/2100ht_series.pdf?sfvrsn=4ba5b1f4_7 | 2100HT | Iron Powder | 33 | 15 | 6.1 |  | Shielded | .031 |  |  |  | - | -55 - 105 |  | 21.8 x 11.4 x 21.8 | https://componentsearchengine.com/part-view/2100HT-330--V-RC/Bourns | https://www.bourns.com/inventory-search-results?PARTS=2100HT-330--V-RC
2100HT-330--H-RC | https://www.bourns.comhttps://bourns.com/docs/product-datasheets/2100ht_series.pdf?sfvrsn=4ba5b1f4_7 | 2100HT | Iron Powder | 33 | 15 | 6.1 |  | Shielded | .031 |  |  |  | - | -55 - 105 |  | 21.8 x 21.8 x 11.4 | https://componentsearchengine.com/part-view/2100HT-330--H-RC/Bourns | https://www.bourns.com/inventory-search-results?PARTS=2100HT-330--H-RC
2100HT-2R7--V-RC | https://www.bourns.comhttps://bourns.com/docs/product-datasheets/2100ht_series.pdf?sfvrsn=4ba5b1f4_7 | 2100HT | Iron Powder | 2.7 | 15 | 17.1 |  | Shielded | .004 |  |  |  | - | -55 - 105 |  | 21.8 x 11.4 x 21.8 | https://componentsearchengine.com/part-view/2100HT-2R7--V-RC/Bourns | https://www.bourns.com/inventory-search-results?PARTS=2100HT-2R7--V-RC
2100HT-2R7--H-RC | https://www.bourns.comhttps://bourns.com/docs/product-datasheets/2100ht_series.pdf?sfvrsn=4ba5b1f4_7 | 2100HT | Iron Powder | 2.7 | 15 | 17.1 |  | Shielded | .004 |  |  |  | - | -55 - 105 |  | 21.8 x 21.8 x 11.4 | https://componentsearchengine.com/part-view/2100HT-2R7--H-RC/Bourns | https://www.bourns.com/inventory-search-results?PARTS=2100HT-2R7--H-RC
2100HT-2R2--V-RC | https://www.bourns.comhttps://bourns.com/docs/product-datasheets/2100ht_series.pdf?sfvrsn=4ba5b1f4_7 | 2100HT | Iron Powder | 2.2 | 15 | 18.3 |  | Shielded | .004 |  |  |  | - | -55 - 105 |  | 21.8 x 11.4 x 21.8 | https://componentsearchengine.com/part-view/2100HT-2R2--V-RC/Bourns | https://www.bourns.com/inventory-search-results?PARTS=2100HT-2R2--V-RC
2100HT-2R2--H-RC | https://www.bourns.comhttps://bourns.com/docs/product-datasheets/2100ht_series.pdf?sfvrsn=4ba5b1f4_7 | 2100HT | Iron Powder | 2.2 | 15 | 18.3 |  | Shielded | .004 |  |  |  | - | -55 - 105 |  | 21.8 x 21.8 x 11.4 | https://componentsearchengine.com/part-view/2100HT-2R2--H-RC/Bourns | https://www.bourns.com/inventory-search-results?PARTS=2100HT-2R2--H-RC
2100HT-271--V-RC | https://www.bourns.comhttps://bourns.com/docs/product-datasheets/2100ht_series.pdf?sfvrsn=4ba5b1f4_7 | 2100HT | Iron Powder | 270 | 15 | 2.8 |  | Shielded | .14 |  |  |  | - | -55 - 105 |  | 21.8 x 11.4 x 21.8 | https://componentsearchengine.com/part-view/2100HT-271--V-RC/Bourns | https://www.bourns.com/inventory-search-results?PARTS=2100HT-271--V-RC
2100HT-271--H-RC | https://www.bourns.comhttps://bourns.com/docs/product-datasheets/2100ht_series.pdf?sfvrsn=4ba5b1f4_7 | 2100HT | Iron Powder | 270 | 15 | 2.8 |  | Shielded | .14 |  |  |  | - | -55 - 105 |  | 21.8 x 21.8 x 11.4 | https://componentsearchengine.com/part-view/2100HT-271--H-RC/Bourns | https://www.bourns.com/inventory-search-results?PARTS=2100HT-271--H-RC
2100HT-270--V-RC | https://www.bourns.comhttps://bourns.com/docs/product-datasheets/2100ht_series.pdf?sfvrsn=4ba5b1f4_7 | 2100HT | Iron Powder | 27 | 15 | 6.4 |  | Shielded | .028 |  |  |  | - | -55 - 105 |  | 21.8 x 11.4 x 21.8 | https://componentsearchengine.com/part-view/2100HT-270--V-RC/Bourns | https://www.bourns.com/inventory-search-results?PARTS=2100HT-270--V-RC
2100HT-270--H-RC | https://www.bourns.comhttps://bourns.com/docs/product-datasheets/2100ht_series.pdf?sfvrsn=4ba5b1f4_7 | 2100HT | Iron Powder | 27 | 15 | 6.4 |  | Shielded | .028 |  |  |  | - | -55 - 105 |  | 21.8 x 21.8 x 11.4 | https://componentsearchengine.com/part-view/2100HT-270--H-RC/Bourns | https://www.bourns.com/inventory-search-results?PARTS=2100HT-270--H-RC
2100HT-221--V-RC | https://www.bourns.comhttps://bourns.com/docs/product-datasheets/2100ht_series.pdf?sfvrsn=4ba5b1f4_7 | 2100HT | Iron Powder | 220 | 15 | 3 |  | Shielded | .13 |  |  |  | - | -55 - 105 |  | 21.8 x 11.4 x 21.8 | https://componentsearchengine.com/part-view/2100HT-221--V-RC/Bourns | https://www.bourns.com/inventory-search-results?PARTS=2100HT-221--V-RC
2100HT-221--H-RC | https://www.bourns.comhttps://bourns.com/docs/product-datasheets/2100ht_series.pdf?sfvrsn=4ba5b1f4_7 | 2100HT | Iron Powder | 220 | 15 | 3 |  | Shielded | .13 |  |  |  | - | -55 - 105 |  | 21.8 x 21.8 x 11.4 | https://componentsearchengine.com/part-view/2100HT-221--H-RC/Bourns | https://www.bourns.com/inventory-search-results?PARTS=2100HT-221--H-RC
2100HT-220--V-RC | https://www.bourns.comhttps://bourns.com/docs/product-datasheets/2100ht_series.pdf?sfvrsn=4ba5b1f4_7 | 2100HT | Iron Powder | 22 | 15 | 6.7 |  | Shielded | .026 |  |  |  | - | -55 - 105 |  | 21.8 x 11.4 x 21.8 | https://componentsearchengine.com/part-view/2100HT-220--V-RC/Bourns | https://www.bourns.com/inventory-search-results?PARTS=2100HT-220--V-RC
2100HT-220--H-RC | https://www.bourns.comhttps://bourns.com/docs/product-datasheets/2100ht_series.pdf?sfvrsn=4ba5b1f4_7 | 2100HT | Iron Powder | 22 | 15 | 6.7 |  | Shielded | .026 |  |  |  | - | -55 - 105 |  | 21.8 x 21.8 x 11.4 | https://componentsearchengine.com/part-view/2100HT-220--H-RC/Bourns | https://www.bourns.com/inventory-search-results?PARTS=2100HT-220--H-RC
2100HT-1R5--V-RC | https://www.bourns.comhttps://bourns.com/docs/product-datasheets/2100ht_series.pdf?sfvrsn=4ba5b1f4_7 | 2100HT | Iron Powder | 1.5 | 15 | 19.8 |  | Shielded | .003 |  |  |  | - | -55 - 105 |  | 21.8 x 11.4 x 21.8 | https://componentsearchengine.com/part-view/2100HT-1R5--V-RC/Bourns | https://www.bourns.com/inventory-search-results?PARTS=2100HT-1R5--V-RC
2100HT-1R5--H-RC | https://www.bourns.comhttps://bourns.com/docs/product-datasheets/2100ht_series.pdf?sfvrsn=4ba5b1f4_7 | 2100HT | Iron Powder | 1.5 | 15 | 19.8 |  | Shielded | .003 |  |  |  | - | -55 - 105 |  | 21.8 x 21.8 x 11.4 | https://componentsearchengine.com/part-view/2100HT-1R5--H-RC/Bourns | https://www.bourns.com/inventory-search-results?PARTS=2100HT-1R5--H-RC
2100HT-1R0--V-RC | https://www.bourns.comhttps://bourns.com/docs/product-datasheets/2100ht_series.pdf?sfvrsn=4ba5b1f4_7 | 2100HT | Iron Powder | 1 | 15 | 21.7 |  | Shielded | .003 |  |  |  | - | -55 - 105 |  | 21.8 x 11.4 x 21.8 | https://componentsearchengine.com/part-view/2100HT-1R0--V-RC/Bourns | https://www.bourns.com/inventory-search-results?PARTS=2100HT-1R0--V-RC
2100HT-1R0--H-RC | https://www.bourns.comhttps://bourns.com/docs/product-datasheets/2100ht_series.pdf?sfvrsn=4ba5b1f4_7 | 2100HT | Iron Powder | 1 | 15 | 21.7 |  | Shielded | .003 |  |  |  | - | -55 - 105 |  | 21.8 x 21.8 x 11.4 | https://componentsearchengine.com/part-view/2100HT-1R0--H-RC/Bourns | https://www.bourns.com/inventory-search-results?PARTS=2100HT-1R0--H-RC
2100HT-181--V-RC | https://www.bourns.comhttps://bourns.com/docs/product-datasheets/2100ht_series.pdf?sfvrsn=4ba5b1f4_7 | 2100HT | Iron Powder | 180 | 15 | 3.1 |  | Shielded | .12 |  |  |  | - | -55 - 105 |  | 21.8 x 11.4 x 21.8 | https://componentsearchengine.com/part-view/2100HT-181--V-RC/Bourns | https://www.bourns.com/inventory-search-results?PARTS=2100HT-181--V-RC
2100HT-181--H-RC | https://www.bourns.comhttps://bourns.com/docs/product-datasheets/2100ht_series.pdf?sfvrsn=4ba5b1f4_7 | 2100HT | Iron Powder | 180 | 15 | 3.1 |  | Shielded | .12 |  |  |  | - | -55 - 105 |  | 21.8 x 21.8 x 11.4 | https://componentsearchengine.com/part-view/2100HT-181--H-RC/Bourns | https://www.bourns.com/inventory-search-results?PARTS=2100HT-181--H-RC
2100HT-180--V-RC | https://www.bourns.comhttps://bourns.com/docs/product-datasheets/2100ht_series.pdf?sfvrsn=4ba5b1f4_7 | 2100HT | Iron Powder | 18 | 15 | 8.6 |  | Shielded | .016 |  |  |  | - | -55 - 105 |  | 21.8 x 11.4 x 21.8 | https://componentsearchengine.com/part-view/2100HT-180--V-RC/Bourns | https://www.bourns.com/inventory-search-results?PARTS=2100HT-180--V-RC
2100HT-180--H-RC | https://www.bourns.comhttps://bourns.com/docs/product-datasheets/2100ht_series.pdf?sfvrsn=4ba5b1f4_7 | 2100HT | Iron Powder | 18 | 15 | 8.6 |  | Shielded | .016 |  |  |  | - | -55 - 105 |  | 21.8 x 21.8 x 11.4 | https://componentsearchengine.com/part-view/2100HT-180--H-RC/Bourns | https://www.bourns.com/inventory-search-results?PARTS=2100HT-180--H-RC
2100HT-151--V-RC | https://www.bourns.comhttps://bourns.com/docs/product-datasheets/2100ht_series.pdf?sfvrsn=4ba5b1f4_7 | 2100HT | Iron Powder | 150 | 15 | 3.3 |  | Shielded | .11 |  |  |  | - | -55 - 105 |  | 21.8 x 11.4 x 21.8 | https://componentsearchengine.com/part-view/2100HT-151--V-RC/Bourns | https://www.bourns.com/inventory-search-results?PARTS=2100HT-151--V-RC
2100HT-151--H-RC | https://www.bourns.comhttps://bourns.com/docs/product-datasheets/2100ht_series.pdf?sfvrsn=4ba5b1f4_7 | 2100HT | Iron Powder | 150 | 15 | 3.3 |  | Shielded | .11 |  |  |  | - | -55 - 105 |  | 21.8 x 21.8 x 11.4 | https://componentsearchengine.com/part-view/2100HT-151--H-RC/Bourns | https://www.bourns.com/inventory-search-results?PARTS=2100HT-151--H-RC
2100HT-150--V-RC | https://www.bourns.comhttps://bourns.com/docs/product-datasheets/2100ht_series.pdf?sfvrsn=4ba5b1f4_7 | 2100HT | Iron Powder | 15 | 15 | 9.1 |  | Shielded | .014 |  |  |  | - | -55 - 105 |  | 21.8 x 11.4 x 21.8 | https://componentsearchengine.com/part-view/2100HT-150--V-RC/Bourns | https://www.bourns.com/inventory-search-results?PARTS=2100HT-150--V-RC
2100HT-150--H-RC | https://www.bourns.comhttps://bourns.com/docs/product-datasheets/2100ht_series.pdf?sfvrsn=4ba5b1f4_7 | 2100HT | Iron Powder | 15 | 15 | 9.1 |  | Shielded | .014 |  |  |  | - | -55 - 105 |  | 21.8 x 21.8 x 11.4 | https://componentsearchengine.com/part-view/2100HT-150--H-RC/Bourns | https://www.bourns.com/inventory-search-results?PARTS=2100HT-150--H-RC
2100HT-121--V-RC | https://www.bourns.comhttps://bourns.com/docs/product-datasheets/2100ht_series.pdf?sfvrsn=4ba5b1f4_7 | 2100HT | Iron Powder | 120 | 15 | 3.5 |  | Shielded | .094 |  |  |  | - | -55 - 105 |  | 21.8 x 11.4 x 21.8 | https://componentsearchengine.com/part-view/2100HT-121--V-RC/Bourns | https://www.bourns.com/inventory-search-results?PARTS=2100HT-121--V-RC
2100HT-121--H-RC | https://www.bourns.comhttps://bourns.com/docs/product-datasheets/2100ht_series.pdf?sfvrsn=4ba5b1f4_7 | 2100HT | Iron Powder | 120 | 15 | 3.5 |  | Shielded | .094 |  |  |  | - | -55 - 105 |  | 21.8 x 21.8 x 11.4 | https://componentsearchengine.com/part-view/2100HT-121--H-RC/Bourns | https://www.bourns.com/inventory-search-results?PARTS=2100HT-121--H-RC
2100HT-120--V-RC | https://www.bourns.comhttps://bourns.com/docs/product-datasheets/2100ht_series.pdf?sfvrsn=4ba5b1f4_7 | 2100HT | Iron Powder | 12 | 15 | 9.6 |  | Shielded | .013 |  |  |  | - | -55 - 105 |  | 21.8 x 11.4 x 21.8 | https://componentsearchengine.com/part-view/2100HT-120--V-RC/Bourns | https://www.bourns.com/inventory-search-results?PARTS=2100HT-120--V-RC
2100HT-120--H-RC | https://www.bourns.comhttps://bourns.com/docs/product-datasheets/2100ht_series.pdf?sfvrsn=4ba5b1f4_7 | 2100HT | Iron Powder | 12 | 15 | 9.6 |  | Shielded | .013 |  |  |  | - | -55 - 105 |  | 21.8 x 21.8 x 11.4 | https://componentsearchengine.com/part-view/2100HT-120--H-RC/Bourns | https://www.bourns.com/inventory-search-results?PARTS=2100HT-120--H-RC
2100HT-102--V-RC | https://www.bourns.comhttps://bourns.com/docs/product-datasheets/2100ht_series.pdf?sfvrsn=4ba5b1f4_7 | 2100HT | Iron Powder | 1000 | 15 | 1.6 |  | Shielded | .43 |  |  |  | - | -55 - 105 |  | 21.8 x 11.4 x 21.8 | https://componentsearchengine.com/part-view/2100HT-102--V-RC/Bourns | https://www.bourns.com/inventory-search-results?PARTS=2100HT-102--V-RC
2100HT-102--H-RC | https://www.bourns.comhttps://bourns.com/docs/product-datasheets/2100ht_series.pdf?sfvrsn=4ba5b1f4_7 | 2100HT | Iron Powder | 1000 | 15 | 1.6 |  | Shielded | .43 |  |  |  | - | -55 - 105 |  | 21.8 x 21.8 x 11.4 | https://componentsearchengine.com/part-view/2100HT-102--H-RC/Bourns | https://www.bourns.com/inventory-search-results?PARTS=2100HT-102--H-RC
2100HT-101--V-RC | https://www.bourns.comhttps://bourns.com/docs/product-datasheets/2100ht_series.pdf?sfvrsn=4ba5b1f4_7 | 2100HT | Iron Powder | 100 | 15 | 4.6 |  | Shielded | .053 |  |  |  | - | -55 - 105 |  | 21.8 x 11.4 x 21.8 | https://componentsearchengine.com/part-view/2100HT-101--V-RC/Bourns | https://www.bourns.com/inventory-search-results?PARTS=2100HT-101--V-RC
2100HT-101--H-RC | https://www.bourns.comhttps://bourns.com/docs/product-datasheets/2100ht_series.pdf?sfvrsn=4ba5b1f4_7 | 2100HT | Iron Powder | 100 | 15 | 4.6 |  | Shielded | .053 |  |  |  | - | -55 - 105 |  | 21.8 x 21.8 x 11.4 | https://componentsearchengine.com/part-view/2100HT-101--H-RC/Bourns | https://www.bourns.com/inventory-search-results?PARTS=2100HT-101--H-RC
2100HT-100--V-RC | https://www.bourns.comhttps://bourns.com/docs/product-datasheets/2100ht_series.pdf?sfvrsn=4ba5b1f4_7 | 2100HT | Iron Powder | 10 | 15 | 9.9 |  | Shielded | .012 |  |  |  | - | -55 - 105 |  | 21.8 x 11.4 x 21.8 | https://componentsearchengine.com/part-view/2100HT-100--V-RC/Bourns | https://www.bourns.com/inventory-search-results?PARTS=2100HT-100--V-RC
2100HT-100--H-RC | https://www.bourns.comhttps://bourns.com/docs/product-datasheets/2100ht_series.pdf?sfvrsn=4ba5b1f4_7 | 2100HT | Iron Powder | 10 | 15 | 9.9 |  | Shielded | .012 |  |  |  | - | -55 - 105 |  | 21.8 x 21.8 x 11.4 | https://componentsearchengine.com/part-view/2100HT-100--H-RC/Bourns | https://www.bourns.com/inventory-search-results?PARTS=2100HT-100--H-RC
2100LL-8R2-V-RC | https://www.bourns.comhttps://bourns.com/docs/product-datasheets/2100ll_series.pdf?sfvrsn=585b0de4_7 | 2100LL | Sendust | 8.2 | 20 | 11.7 |  | Shielded | .005 |  |  |  | - | -55 - 125 |  | 21.8 x 11.4 x 21.8 | https://componentsearchengine.com/part-view/2100LL-8R2-V-RC/Bourns | https://www.bourns.com/inventory-search-results?PARTS=2100LL-8R2-V-RC
2100LL-8R2-H-RC | https://www.bourns.comhttps://bourns.com/docs/product-datasheets/2100ll_series.pdf?sfvrsn=585b0de4_7 | 2100LL | Sendust | 8.2 | 20 | 11.7 |  | Shielded | .005 |  |  |  | - | -55 - 125 |  | 21.8 x 21.8 x 11.4 | https://componentsearchengine.com/part-view/2100LL-8R2-H-RC/Bourns | https://www.bourns.com/inventory-search-results?PARTS=2100LL-8R2-H-RC
2100LL-821-V-RC | https://www.bourns.comhttps://bourns.com/docs/product-datasheets/2100ll_series.pdf?sfvrsn=585b0de4_7 | 2100LL | Sendust | 820 | 15 | 1.6 |  | Shielded | .257 |  |  |  | - | -55 - 125 |  | 21.8 x 11.4 x 21.8 | https://componentsearchengine.com/part-view/2100LL-821-V-RC/Bourns | https://www.bourns.com/inventory-search-results?PARTS=2100LL-821-V-RC
2100LL-821-H-RC | https://www.bourns.comhttps://bourns.com/docs/product-datasheets/2100ll_series.pdf?sfvrsn=585b0de4_7 | 2100LL | Sendust | 820 | 15 | 1.6 |  | Shielded | .257 |  |  |  | - | -55 - 125 |  | 21.8 x 21.8 x 11.4 | https://componentsearchengine.com/part-view/2100LL-821-H-RC/Bourns | https://www.bourns.com/inventory-search-results?PARTS=2100LL-821-H-RC
2100LL-820-V-RC | https://www.bourns.comhttps://bourns.com/docs/product-datasheets/2100ll_series.pdf?sfvrsn=585b0de4_7 | 2100LL | Sendust | 82 | 15 | 4.6 |  | Shielded | .032 |  |  |  | - | -55 - 125 |  | 21.8 x 11.4 x 21.8 | https://componentsearchengine.com/part-view/2100LL-820-V-RC/Bourns | https://www.bourns.com/inventory-search-results?PARTS=2100LL-820-V-RC
2100LL-820-H-RC | https://www.bourns.comhttps://bourns.com/docs/product-datasheets/2100ll_series.pdf?sfvrsn=585b0de4_7 | 2100LL | Sendust | 82 | 15 | 4.6 |  | Shielded | .032 |  |  |  | - | -55 - 125 |  | 21.8 x 21.8 x 11.4 | https://componentsearchengine.com/part-view/2100LL-820-H-RC/Bourns | https://www.bourns.com/inventory-search-results?PARTS=2100LL-820-H-RC
2100LL-6R8-V-RC | https://www.bourns.comhttps://bourns.com/docs/product-datasheets/2100ll_series.pdf?sfvrsn=585b0de4_7 | 2100LL | Sendust | 6.8 | 20 | 12.3 |  | Shielded | .004 |  |  |  | - | -55 - 125 |  | 21.8 x 11.4 x 21.8 | https://componentsearchengine.com/part-view/2100LL-6R8-V-RC/Bourns | https://www.bourns.com/inventory-search-results?PARTS=2100LL-6R8-V-RC
2100LL-6R8-H-RC | https://www.bourns.comhttps://bourns.com/docs/product-datasheets/2100ll_series.pdf?sfvrsn=585b0de4_7 | 2100LL | Sendust | 6.8 | 20 | 12.3 |  | Shielded | .004 |  |  |  | - | -55 - 125 |  | 21.8 x 21.8 x 11.4 | https://componentsearchengine.com/part-view/2100LL-6R8-H-RC/Bourns | https://www.bourns.com/inventory-search-results?PARTS=2100LL-6R8-H-RC
2100LL-681-V-RC | https://www.bourns.comhttps://bourns.com/docs/product-datasheets/2100ll_series.pdf?sfvrsn=585b0de4_7 | 2100LL | Sendust | 680 | 15 | 2.1 |  | Shielded | .147 |  |  |  | - | -55 - 125 |  | 21.8 x 11.4 x 21.8 | https://componentsearchengine.com/part-view/2100LL-681-V-RC/Bourns | https://www.bourns.com/inventory-search-results?PARTS=2100LL-681-V-RC
2100LL-681-H-RC | https://www.bourns.comhttps://bourns.com/docs/product-datasheets/2100ll_series.pdf?sfvrsn=585b0de4_7 | 2100LL | Sendust | 680 | 15 | 2.1 |  | Shielded | .147 |  |  |  | - | -55 - 125 |  | 21.8 x 21.8 x 11.4 | https://componentsearchengine.com/part-view/2100LL-681-H-RC/Bourns | https://www.bourns.com/inventory-search-results?PARTS=2100LL-681-H-RC
2100LL-680-V-RC | https://www.bourns.comhttps://bourns.com/docs/product-datasheets/2100ll_series.pdf?sfvrsn=585b0de4_7 | 2100LL | Sendust | 68 | 15 | 4.7 |  | Shielded | .03 |  |  |  | - | -55 - 125 |  | 21.8 x 11.4 x 21.8 | https://componentsearchengine.com/part-view/2100LL-680-V-RC/Bourns | https://www.bourns.com/inventory-search-results?PARTS=2100LL-680-V-RC
2100LL-680-H-RC | https://www.bourns.comhttps://bourns.com/docs/product-datasheets/2100ll_series.pdf?sfvrsn=585b0de4_7 | 2100LL | Sendust | 68 | 15 | 4.7 |  | Shielded | .03 |  |  |  | - | -55 - 125 |  | 21.8 x 21.8 x 11.4 | https://componentsearchengine.com/part-view/2100LL-680-H-RC/Bourns | https://www.bourns.com/inventory-search-results?PARTS=2100LL-680-H-RC
2100LL-5R6-V-RC | https://www.bourns.comhttps://bourns.com/docs/product-datasheets/2100ll_series.pdf?sfvrsn=585b0de4_7 | 2100LL | Sendust | 5.6 | 20 | 13.1 |  | Shielded | .004 |  |  |  | - | -55 - 125 |  | 21.8 x 11.4 x 21.8 | https://componentsearchengine.com/part-view/2100LL-5R6-V-RC/Bourns | https://www.bourns.com/inventory-search-results?PARTS=2100LL-5R6-V-RC
2100LL-5R6-H-RC | https://www.bourns.comhttps://bourns.com/docs/product-datasheets/2100ll_series.pdf?sfvrsn=585b0de4_7 | 2100LL | Sendust | 5.6 | 20 | 13.1 |  | Shielded | .004 |  |  |  | - | -55 - 125 |  | 21.8 x 21.8 x 11.4 | https://componentsearchengine.com/part-view/2100LL-5R6-H-RC/Bourns | https://www.bourns.com/inventory-search-results?PARTS=2100LL-5R6-H-RC
2100LL-561-V-RC | https://www.bourns.comhttps://bourns.com/docs/product-datasheets/2100ll_series.pdf?sfvrsn=585b0de4_7 | 2100LL | Sendust | 560 | 15 | 2.2 |  | Shielded | .134 |  |  |  | - | -55 - 125 |  | 21.8 x 11.4 x 21.8 | https://componentsearchengine.com/part-view/2100LL-561-V-RC/Bourns | https://www.bourns.com/inventory-search-results?PARTS=2100LL-561-V-RC
2100LL-561-H-RC | https://www.bourns.comhttps://bourns.com/docs/product-datasheets/2100ll_series.pdf?sfvrsn=585b0de4_7 | 2100LL | Sendust | 560 | 15 | 2.2 |  | Shielded | .134 |  |  |  | - | -55 - 125 |  | 21.8 x 21.8 x 11.4 | https://componentsearchengine.com/part-view/2100LL-561-H-RC/Bourns | https://www.bourns.com/inventory-search-results?PARTS=2100LL-561-H-RC
2100LL-560-V-RC | https://www.bourns.comhttps://bourns.com/docs/product-datasheets/2100ll_series.pdf?sfvrsn=585b0de4_7 | 2100LL | Sendust | 56 | 15 | 5 |  | Shielded | .026 |  |  |  | - | -55 - 125 |  | 21.8 x 11.4 x 21.8 | https://componentsearchengine.com/part-view/2100LL-560-V-RC/Bourns | https://www.bourns.com/inventory-search-results?PARTS=2100LL-560-V-RC
2100LL-560-H-RC | https://www.bourns.comhttps://bourns.com/docs/product-datasheets/2100ll_series.pdf?sfvrsn=585b0de4_7 | 2100LL | Sendust | 56 | 15 | 5 |  | Shielded | .026 |  |  |  | - | -55 - 125 |  | 21.8 x 21.8 x 11.4 | https://componentsearchengine.com/part-view/2100LL-560-H-RC/Bourns | https://www.bourns.com/inventory-search-results?PARTS=2100LL-560-H-RC
2100LL-4R7-V-RC | https://www.bourns.comhttps://bourns.com/docs/product-datasheets/2100ll_series.pdf?sfvrsn=585b0de4_7 | 2100LL | Sendust | 4.7 | 20 | 14 |  | Shielded | .003 |  |  |  | - | -55 - 125 |  | 21.8 x 11.4 x 21.8 | https://componentsearchengine.com/part-view/2100LL-4R7-V-RC/Bourns | https://www.bourns.com/inventory-search-results?PARTS=2100LL-4R7-V-RC
2100LL-4R7-H-RC | https://www.bourns.comhttps://bourns.com/docs/product-datasheets/2100ll_series.pdf?sfvrsn=585b0de4_7 | 2100LL | Sendust | 4.7 | 20 | 14 |  | Shielded | .003 |  |  |  | - | -55 - 125 |  | 21.8 x 21.8 x 11.4 | https://componentsearchengine.com/part-view/2100LL-4R7-H-RC/Bourns | https://www.bourns.com/inventory-search-results?PARTS=2100LL-4R7-H-RC
2100LL-471-V-RC | https://www.bourns.comhttps://bourns.com/docs/product-datasheets/2100ll_series.pdf?sfvrsn=585b0de4_7 | 2100LL | Sendust | 470 | 15 | 2.3 |  | Shielded | .124 |  |  |  | - | -55 - 125 |  | 21.8 x 11.4 x 21.8 | https://componentsearchengine.com/part-view/2100LL-471-V-RC/Bourns | https://www.bourns.com/inventory-search-results?PARTS=2100LL-471-V-RC
2100LL-471-H-RC | https://www.bourns.comhttps://bourns.com/docs/product-datasheets/2100ll_series.pdf?sfvrsn=585b0de4_7 | 2100LL | Sendust | 470 | 15 | 2.3 |  | Shielded | .124 |  |  |  | - | -55 - 125 |  | 21.8 x 21.8 x 11.4 | https://componentsearchengine.com/part-view/2100LL-471-H-RC/Bourns | https://www.bourns.com/inventory-search-results?PARTS=2100LL-471-H-RC
2100LL-470-V-RC | https://www.bourns.comhttps://bourns.com/docs/product-datasheets/2100ll_series.pdf?sfvrsn=585b0de4_7 | 2100LL | Sendust | 47 | 15 | 5.2 |  | Shielded | .024 |  |  |  | - | -55 - 125 |  | 21.8 x 11.4 x 21.8 | https://componentsearchengine.com/part-view/2100LL-470-V-RC/Bourns | https://www.bourns.com/inventory-search-results?PARTS=2100LL-470-V-RC
2100LL-470-H-RC | https://www.bourns.comhttps://bourns.com/docs/product-datasheets/2100ll_series.pdf?sfvrsn=585b0de4_7 | 2100LL | Sendust | 47 | 15 | 5.2 |  | Shielded | .024 |  |  |  | - | -55 - 125 |  | 21.8 x 21.8 x 11.4 | https://componentsearchengine.com/part-view/2100LL-470-H-RC/Bourns | https://www.bourns.com/inventory-search-results?PARTS=2100LL-470-H-RC
2100LL-3R3-V-RC | https://www.bourns.comhttps://bourns.com/docs/product-datasheets/2100ll_series.pdf?sfvrsn=585b0de4_7 | 2100LL | Sendust | 3.3 | 20 | 15.1 |  | Shielded | .003 |  |  |  | - | -55 - 125 |  | 21.8 x 11.4 x 21.8 | https://componentsearchengine.com/part-view/2100LL-3R3-V-RC/Bourns | https://www.bourns.com/inventory-search-results?PARTS=2100LL-3R3-V-RC
2100LL-3R3-H-RC | https://www.bourns.comhttps://bourns.com/docs/product-datasheets/2100ll_series.pdf?sfvrsn=585b0de4_7 | 2100LL | Sendust | 3.3 | 20 | 15.1 |  | Shielded | .003 |  |  |  | - | -55 - 125 |  | 21.8 x 21.8 x 11.4 | https://componentsearchengine.com/part-view/2100LL-3R3-H-RC/Bourns | https://www.bourns.com/inventory-search-results?PARTS=2100LL-3R3-H-RC
2100LL-391-V-RC | https://www.bourns.comhttps://bourns.com/docs/product-datasheets/2100ll_series.pdf?sfvrsn=585b0de4_7 | 2100LL | Sendust | 390 | 15 | 2.4 |  | Shielded | .112 |  |  |  | - | -55 - 125 |  | 21.8 x 11.4 x 21.8 | https://componentsearchengine.com/part-view/2100LL-391-V-RC/Bourns | https://www.bourns.com/inventory-search-results?PARTS=2100LL-391-V-RC
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
