muvi/ELController/board design R1/3d models/3-D NC3MAH.stp

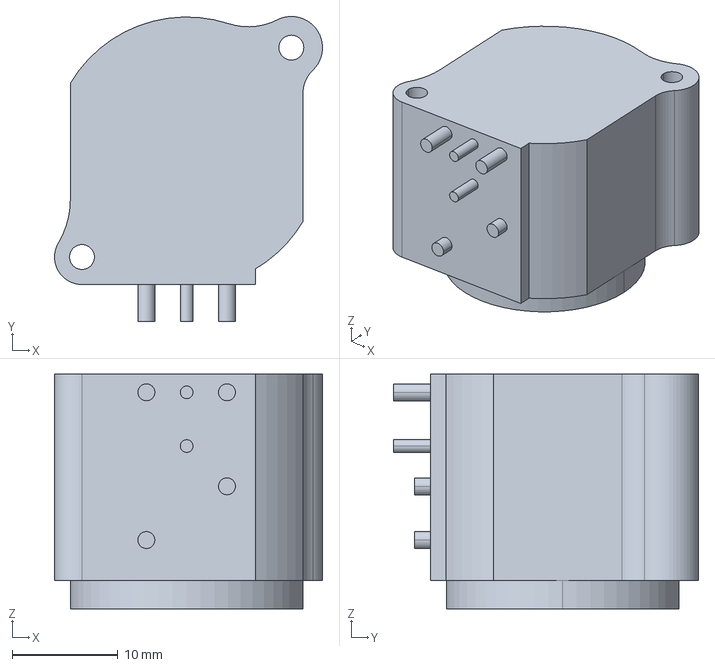
[picture p2: CAD file, 2023-04-17]
board design R1/3d models/3-D NC3MAH.stp
25.3 x 28.8 x 22.2 mm
