muvi/ELController/case/ELController case.FCStd

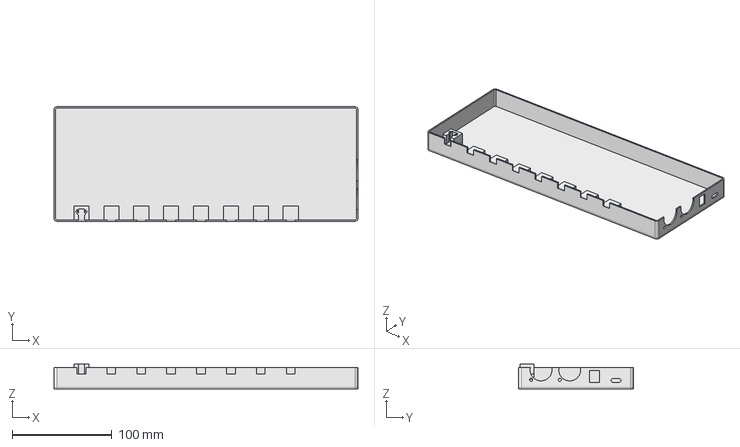
[picture p3: CAD file, 2023-04-17]
case/ELController case.FCStd
305.0 x 115.0 x 25.0 mm
