muvi/ELController/case/openscad/plug_carrier_top.stl

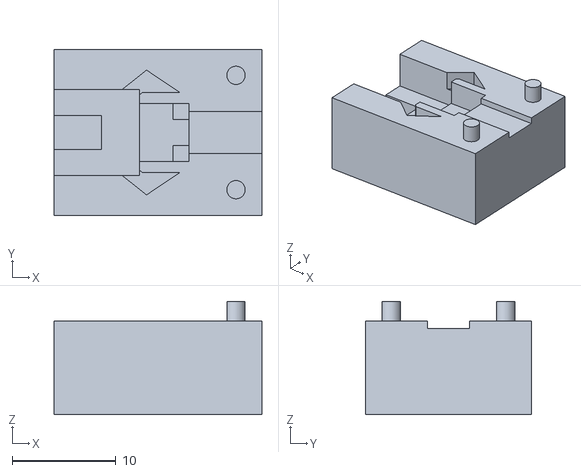
[picture p4: CAD file, 2023-04-17]
case/openscad/plug_carrier_top.stl
20.0 x 16.0 x 10.9
