muvi/ELController/case/openscad/plug_carrier_bottom.stl

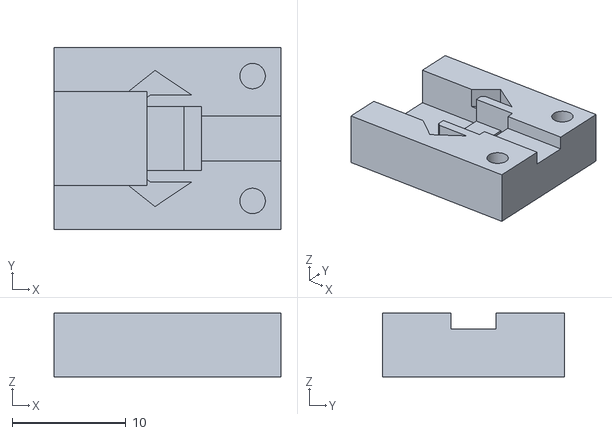
[picture p6: CAD file, 2023-04-17]
case/openscad/plug_carrier_bottom.stl
20.0 x 16.0 x 5.62
