muvi/ELController/ideal diode board/3d models/USB4105-GF-A--3DModel-STEP-56544.STEP

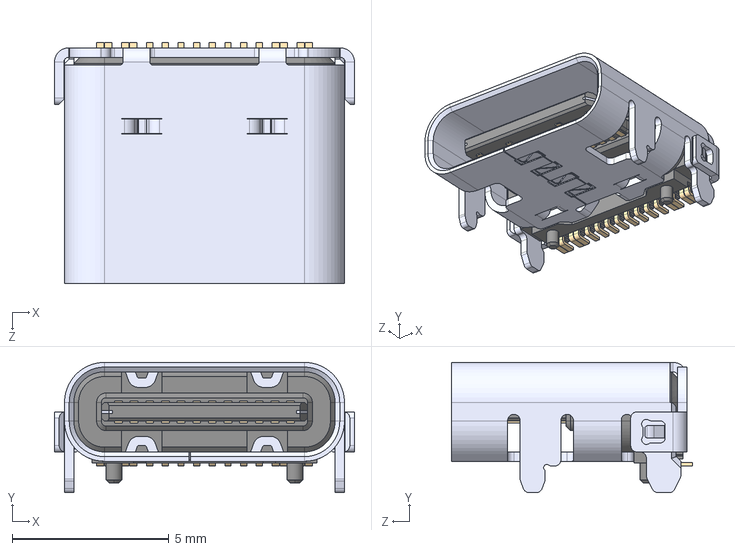
[picture p7: CAD file, 2023-04-17]
ideal diode board/3d models/USB4105-GF-A--3DModel-STEP-56544.STEP
9.58 x 4.16 x 7.71 mm
