muvi/ELController/board design R1/production files/SO12206116088/SO12206116088.DXF

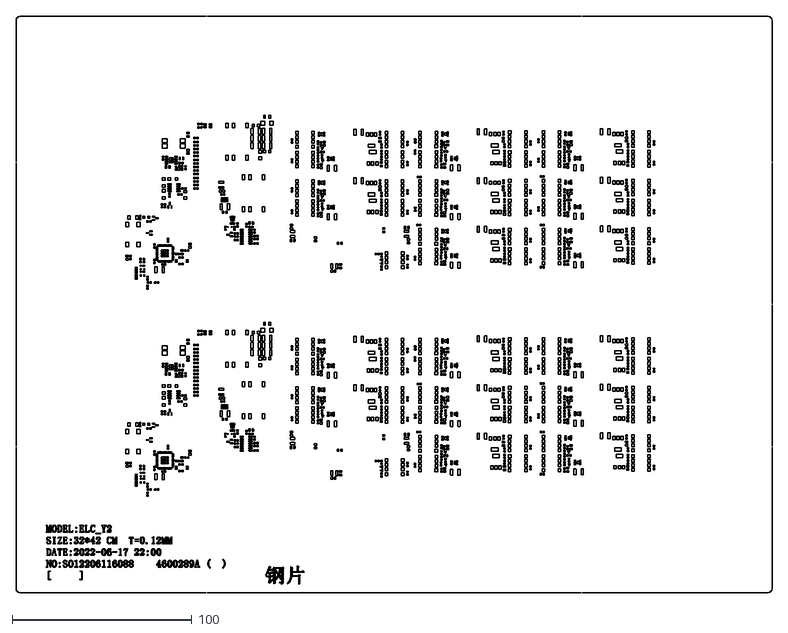
[picture p8: CAD file, 2023-04-17]
board design R1/production files/SO12206116088/SO12206116088.DXF
420.0 x 320.0
