muvi/ELController/board design/production files/SO12302176587/SO12302176587.DXF

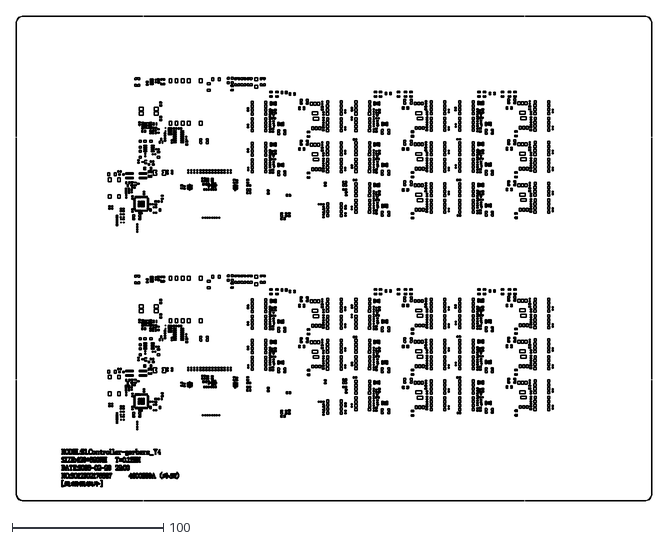
[picture p9: CAD file, 2023-04-17]
board design/production files/SO12302176587/SO12302176587.DXF
420.0 x 320.0
