muvi/ELController/(list of files, cad)

Other CAD files:
info/3D printer size.FCStd
ideal diode board/production files/SO12301086033/SO12301086033.DXF
