muvi/ELController/info/Testdisplay mapping.xlsx

 | bottom left | bottom | bottom right | middle | top left | top right | top | dot | binary | decimal | hexadecimal | binary | decimal | hexadecimal
0 | X | X | X |  | X | X | X |  | 0b00010001 | 136 | 0x88 | 0b10001000 | 17 | 0x11
1 |  |  | X |  |  | X |  |  | 0b11011011 | 219 | 0xDB | 0b11011011 | 219 | 0xDB
2 | X | X |  | X |  | X | X |  | 0b00101001 | 148 | 0x94 | 0b10010100 | 41 | 0x29
3 |  | X | X | X |  | X | X |  | 0b10001001 | 145 | 0x91 | 0b10010001 | 137 | 0x89
4 |  |  | X | X | X | X |  |  | 0b11000011 | 195 | 0xC3 | 0b11000011 | 195 | 0xC3
5 |  | X | X | X | X |  | X |  | 0b10000101 | 161 | 0xA1 | 0b10100001 | 133 | 0x85
6 | X | X | X | X | X |  | X |  | 0b00000101 | 160 | 0xA0 | 0b10100000 | 5 | 0x5
7 |  |  | X |  |  | X | X |  | 0b11011001 | 155 | 0x9B | 0b10011011 | 217 | 0xD9
8 | X | X | X | X | X | X | X |  | 0b00000001 | 128 | 0x80 | 0b10000000 | 1 | 0x1
9 |  | X | X | X | X | X | X |  | 0b10000001 | 129 | 0x81 | 0b10000001 | 129 | 0x81
. |  |  |  |  |  |  |  | X | 0b11111110 | 127 | 0x7F | 0b01111111 | 254 | 0xFE
 |  |  |  |  |  |  |  |  | 0b00010001, 0b11011011, 0b00101001, 0b10001001, 0b11000011, 0b10000101, 0b00000101, 0b11011001, 0b00000001, 0b10000001 |  |  | 0b10001000, 0b11011011, 0b10010100, 0b10010001, 0b11000011, 0b10100001, 0b10100000, 0b10011011, 0b10000000, 0b10000001
A | X |  | X | X | X | X | X |  | 0b01000001 | 130 | 0x82 | 0b10000010 | 65 | 0x41
B | X | X | X | X | X |  |  |  | 0b00000111 | 224 | 0xE0 | 0b11100000 | 7 | 0x7
C | X | X |  |  | X |  | X |  | 0b00110101 | 172 | 0xAC | 0b10101100 | 53 | 0x35
D | X | X | X | X |  | X |  |  | 0b00001011 | 208 | 0xD0 | 0b11010000 | 11 | 0xB
E | X | X |  | X | X |  | X |  | 0b00100101 | 164 | 0xA4 | 0b10100100 | 37 | 0x25
F | X |  |  | X | X |  | X |  | 0b01100101 | 166 | 0xA6 | 0b10100110 | 101 | 0x65
G
H
I
J
K
L
M
N
O
P
Q
R
S
T
U
V
W
X
Y
Z
