muvi/ELController/Debugging/Flyback diode reverse recovery.png

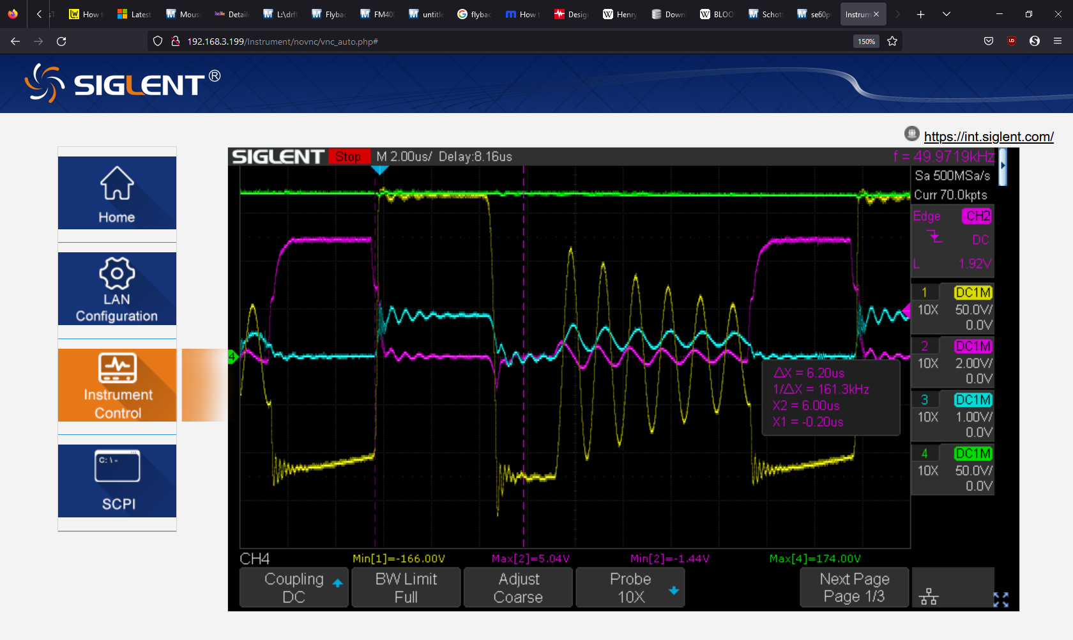
Debugging/Flyback diode reverse recovery.png
