muvi/ELController/Debugging/Oscilloscope output.png

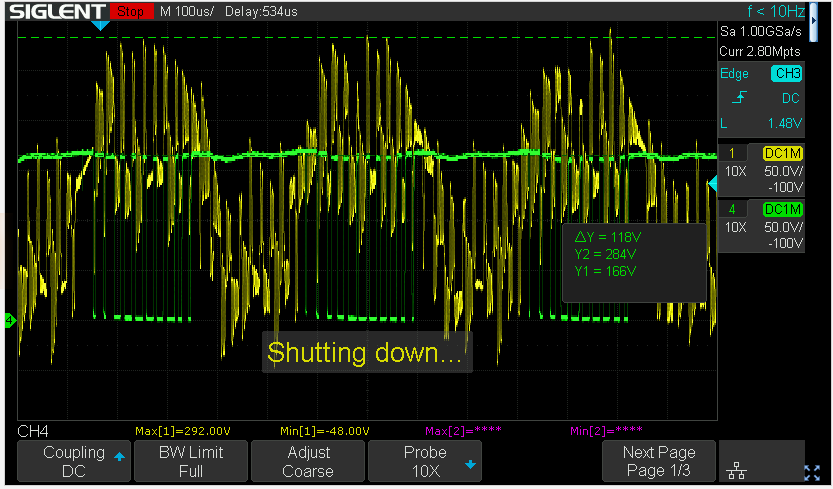
Debugging/Oscilloscope output.png
