muvi/ELController/board design/production files/SO12302176587/SO12302176587.pdf

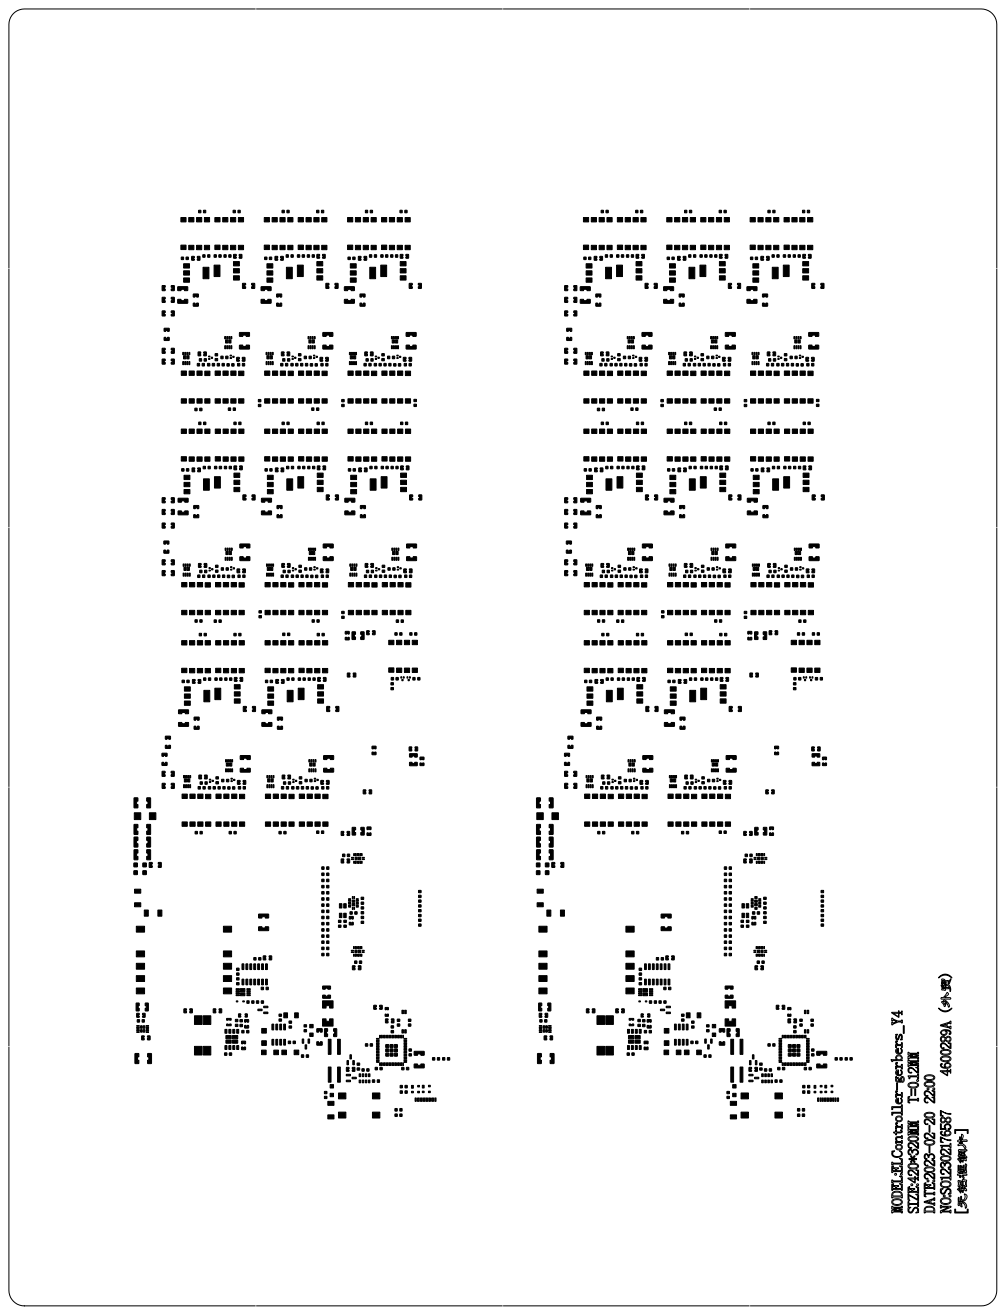
[picture p27: page 1]
