muvi/ELController/ideal diode board/production files/SO12301086033/SO12301086033.pdf

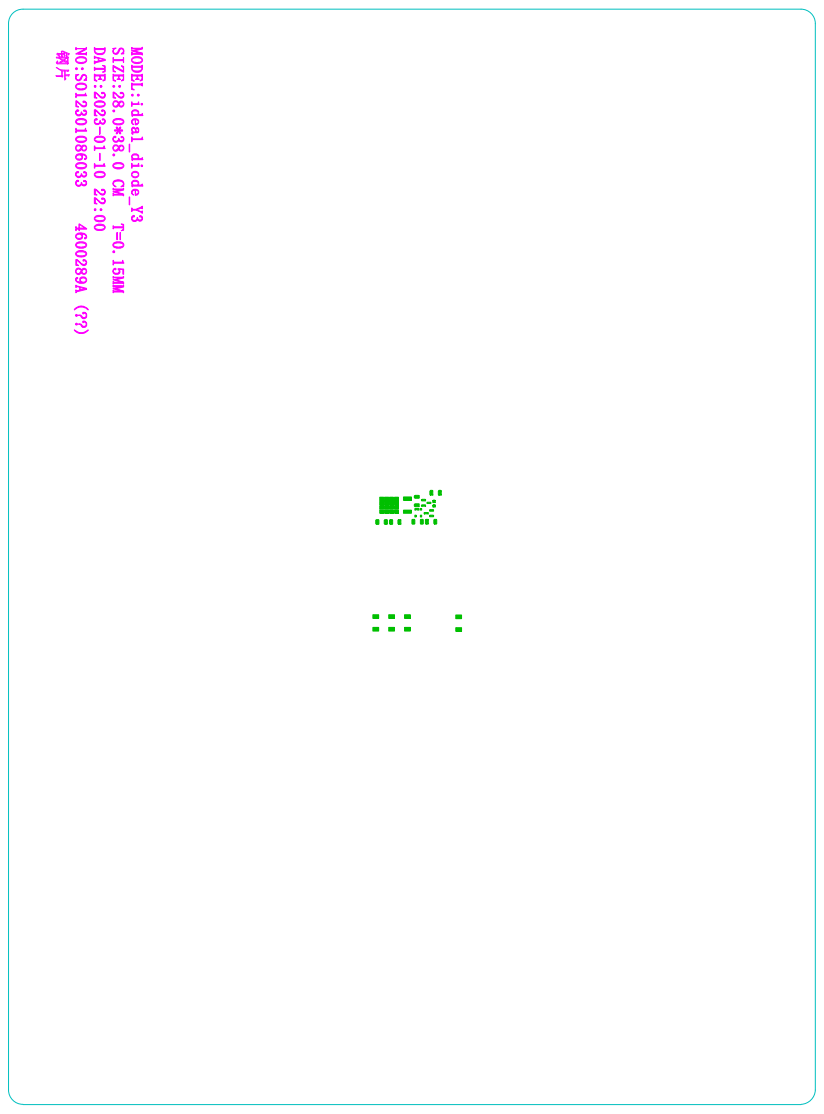
[picture p28: page 1]
