muvi/ELController/preview/schematic_V1.pdf

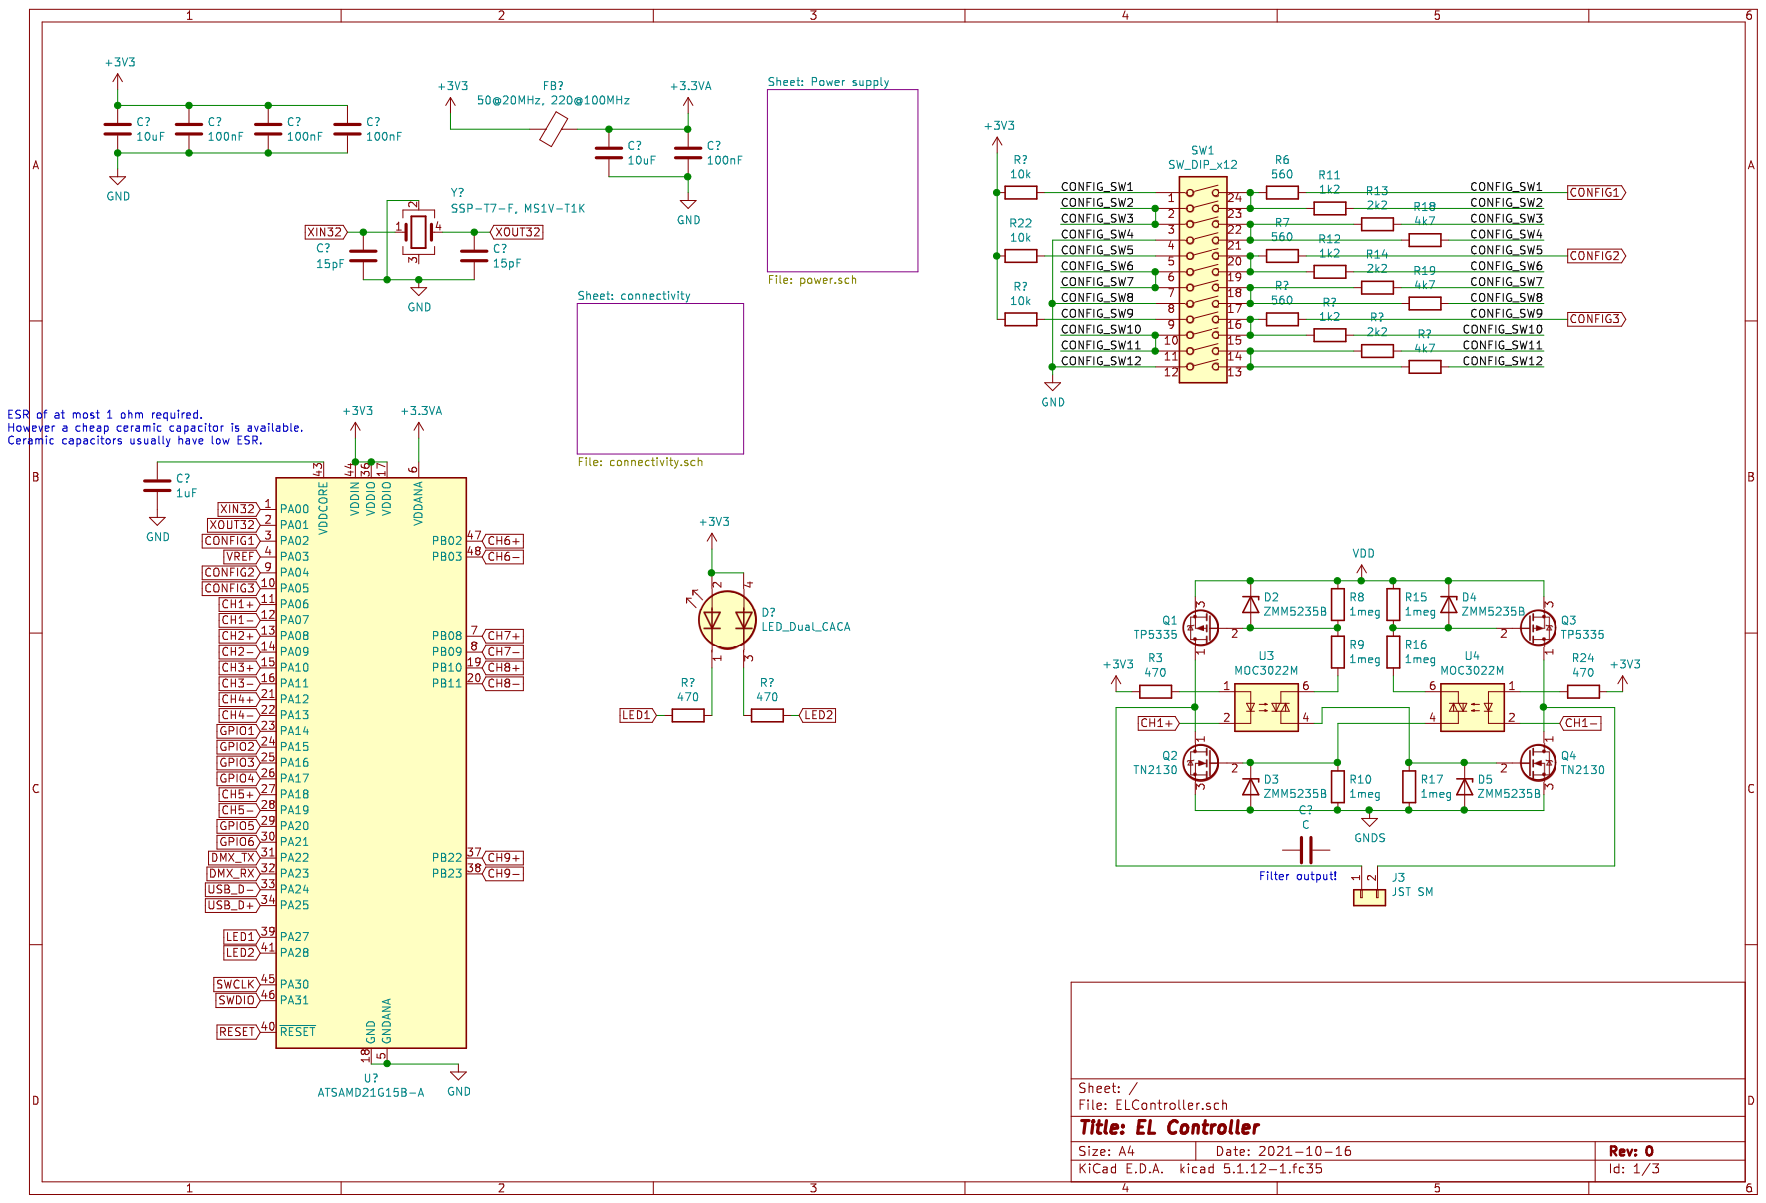
[picture p29: page 1]

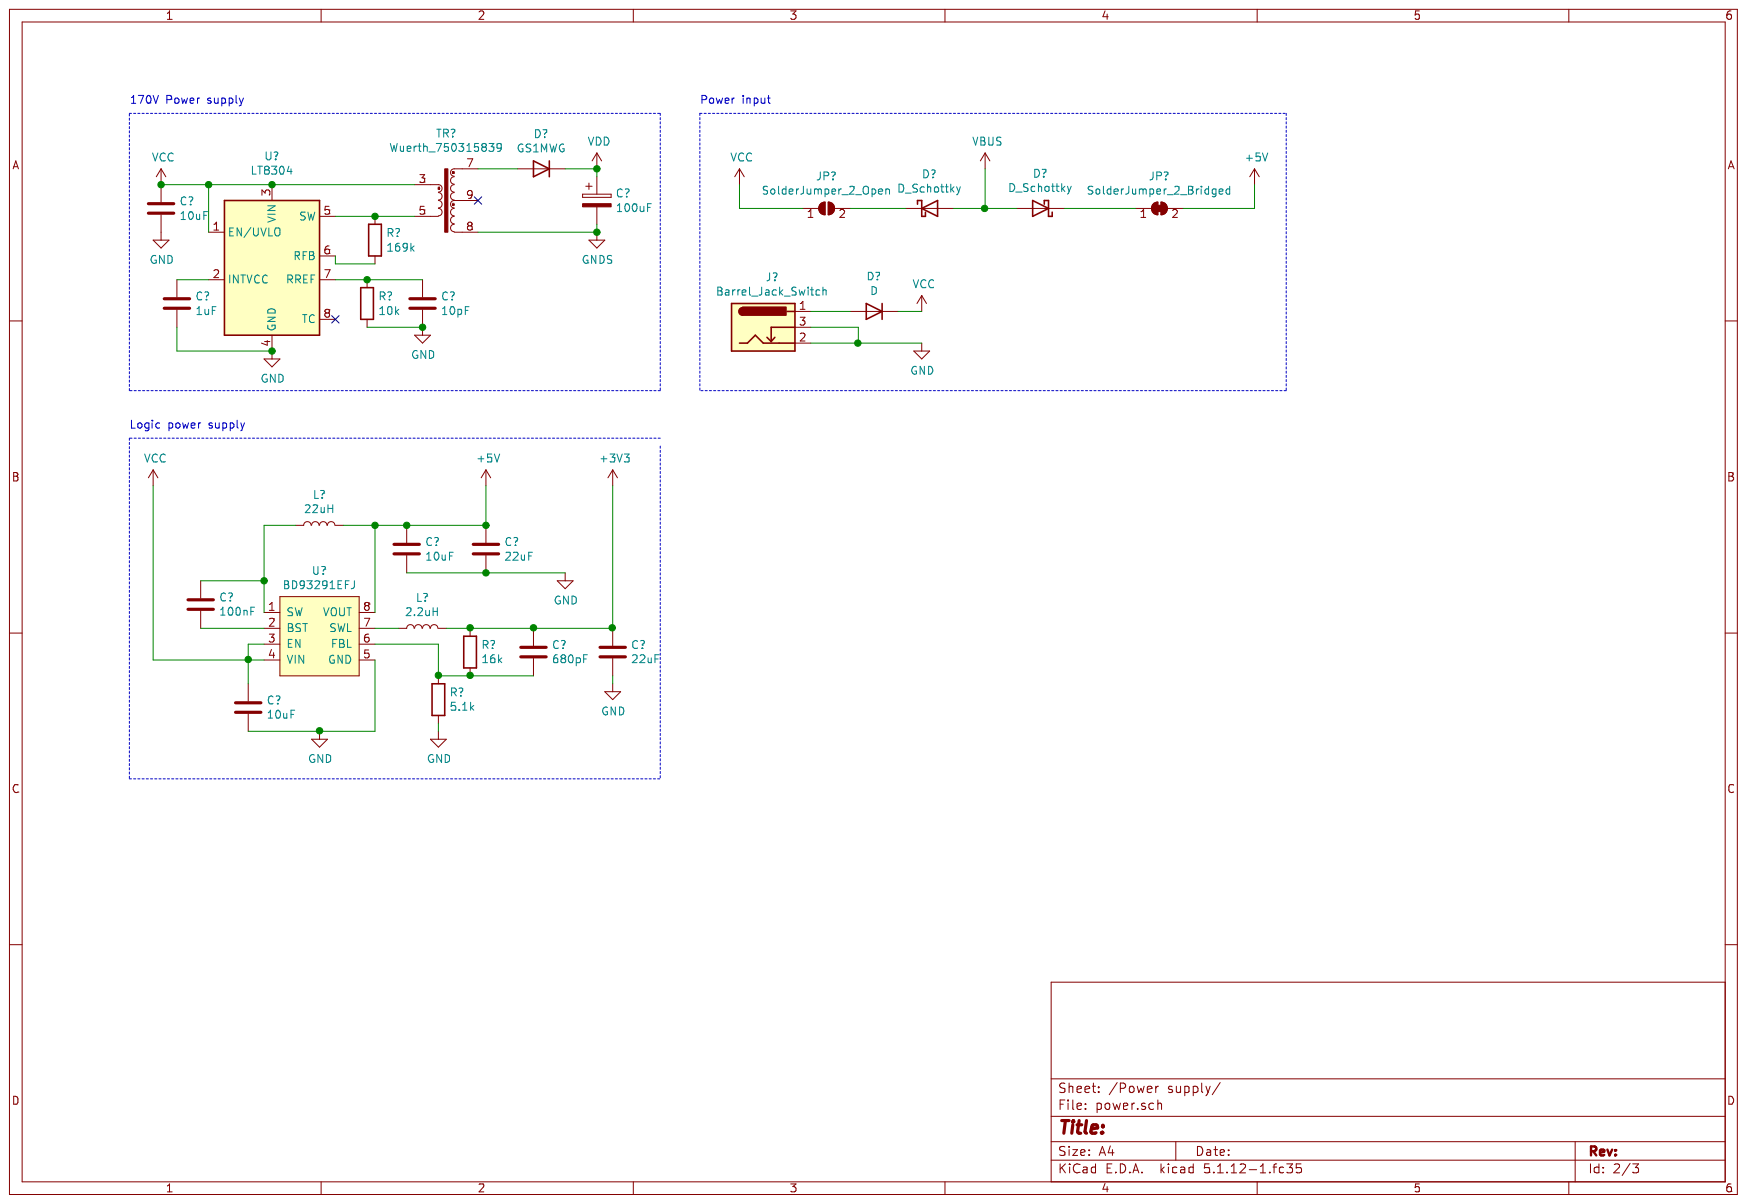
[picture p30: page 2]

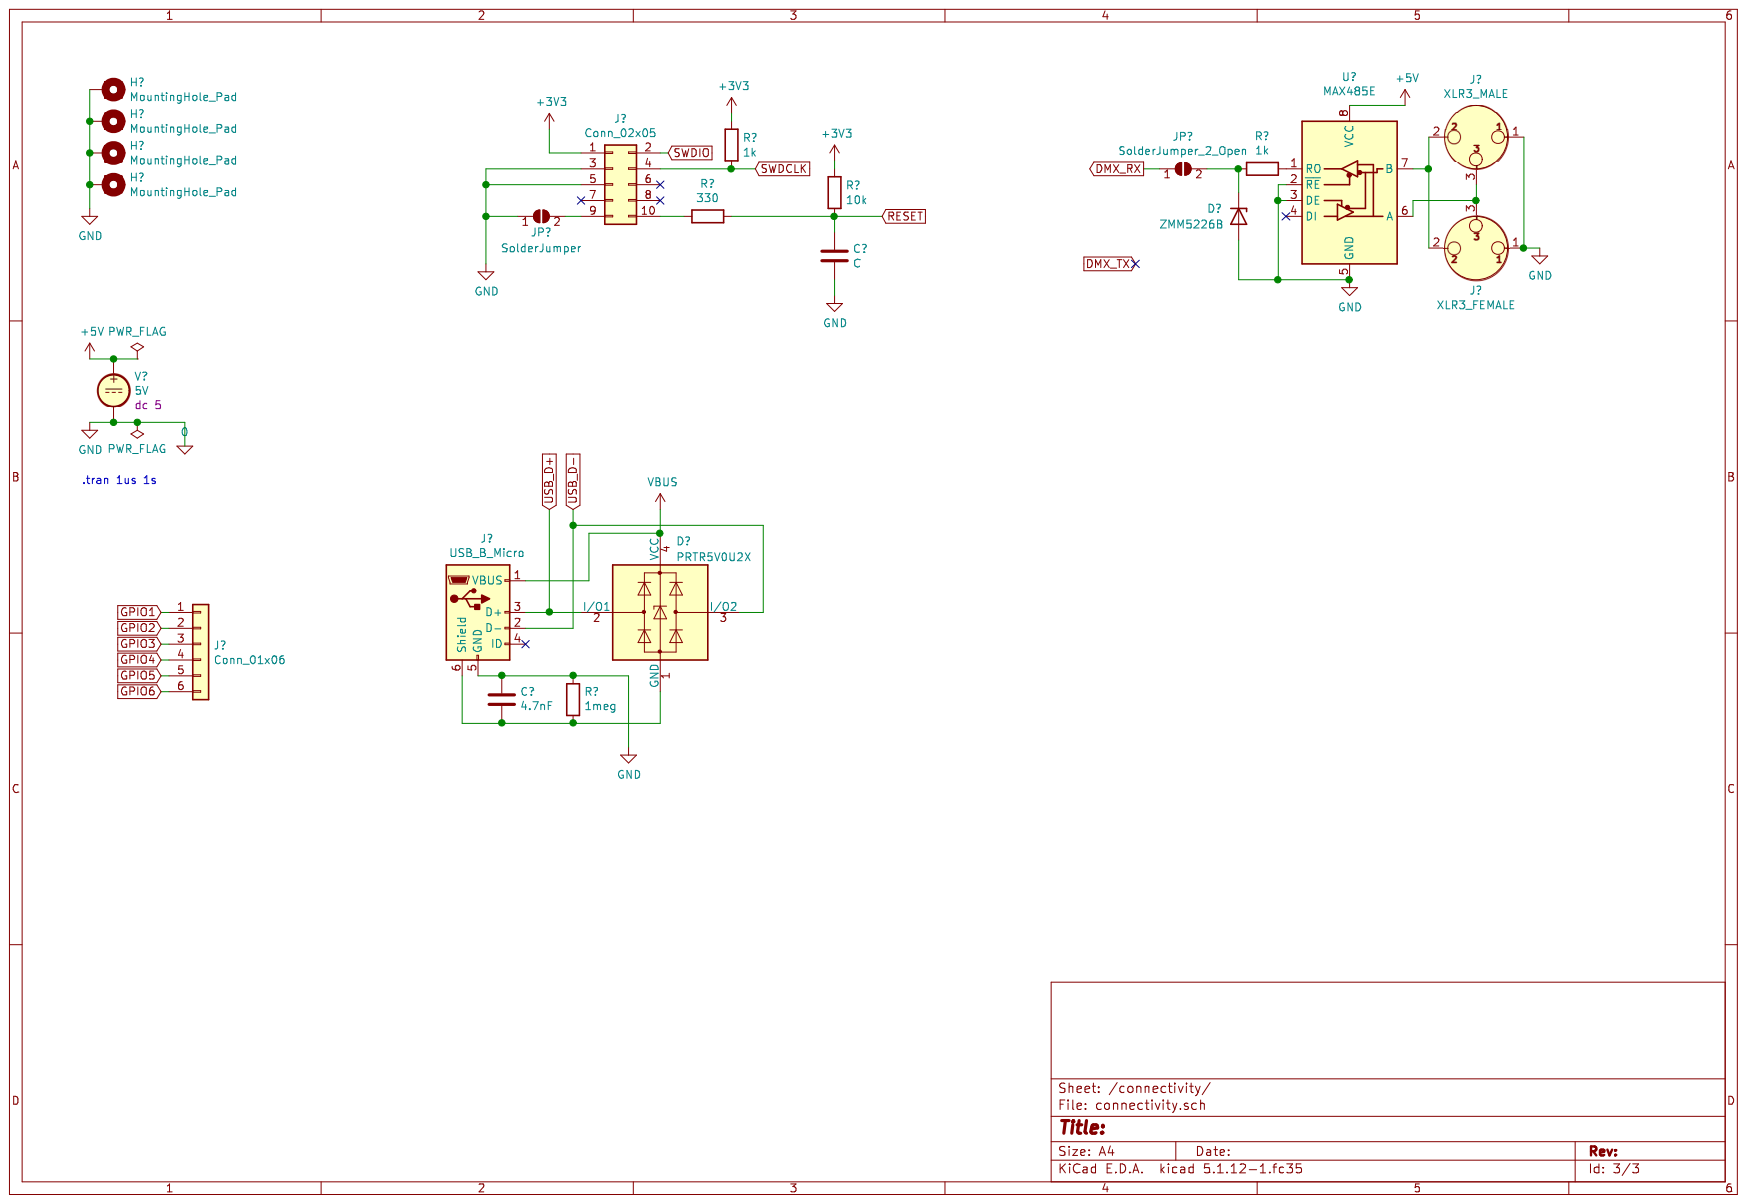
[picture p31: page 3]
