muvi/ELController/ltspice model/Filter Test R2.asc

C1: cap; 240nF
L1: ind; 500µH
L2: ind; 500µH
R1: res; 2.5k
R2: res; 0.1
V1: voltage; PWL file="D:\Projekte\ELController\ltspice model\PWL\output sine wave.csv"
V2: voltage; PWL file="Z:\media\Daten\Projekte\ELController\ltspice model\PWL\output sine wave inverse.csv"
Named nets: 0, out1, out2, in1, in2
.tran 6ms
