muvi/ELController/ltspice model/Filter Test R3.asc

C1: cap; 100nF
C2: cap; 1µF
I1: current; 30mA
L1: ind; 220µH
L2: ind; 220µH
R1: res; 6k
R3: res; 0.1
R5: res; 0.1
R6: res; 0.1
R7: res; 0.1
R8: res; 0.1
S1: sw; hvSW
S3: sw; hvSW
S5: sw; hvSW
S6: sw; hvSW
V1: voltage; PWL file="D:\Projekte\ELController\ltspice model\PWL\output sine wave.csv"
V2: voltage; PWL file="Z:\media\Daten\Projekte\ELController\ltspice model\PWL\output sine wave inverse.csv"
V3: voltage; 170V
V5: voltage; 170V
Named nets: out1, out2, 0
.tran 6ms
.model hvSW SW(Ron=1.1 Roff=17meg Vt=80 Vh=0)
