muvi/ELController/ltspice model/Filter Test R4 new dampened.asc

C1: cap; 48nF
C2: cap; 1µF
C3: cap; 10nF
C4: cap; 10nF
C5: cap; 10nF
C6: cap; 10nF
L1: ind; 3.3mH
L2: ind; 3.3mH
R1: res; 68k
R2: res; 0.1
R3: res; 0.1
R4: res; 0.1
R5: res; 10
R6: res; 0.1
R7: res; 1
R8: res; 0.1
R9: res; 1
R10: res; 10
R11: res; 1
R12: res; 1
R13: res; 1
R14: res; 1
R15: res; 1
S1: sw; hvSW
S3: sw; hvSW
S5: sw; hvSW
S6: sw; hvSW
V1: voltage; PWL file="D:\Projekte\ELController\ltspice model\PWL\output sine wave 5.csv"
V2: voltage; PWL file="D:\Projekte\ELController\ltspice model\PWL\output sine wave 5 inverse.csv"
V3: voltage; 5V
V4: voltage; 170V
V5: voltage; 5V
Named nets: out1, out2, 0, vcc, gn, unfiltered
.tran 6ms
.model hvSW SW(Ron=1.5 Roff=17meg Vt=3V Vh=0)
MAX: 6k, 96nF, MIN: 6nF, 100k
