muvi/ELController/ltspice model/Filter Test R4a.asc

C1: cap; 48nF
C2: cap; 1µF
D1: diode
D2: diode
D3: diode
D4: diode
L1: ind; 3.3mH
L2: ind; 3.3mH
R1: res; 68k
R2: res; 2.4
R3: res; 0.1
R4: res; 0.1
R5: res; 1
R6: res; 2.4
R7: res; 0.1
R8: res; 0.1
R9: res; 1
R10: res; 1.5
R11: res; 1.5
S1: sw; hvSW
S2: sw; hvSW
S3: sw; hvSW
S5: sw; hvSW
S6: sw; hvSW
V1: voltage; PWL file="D:\Projekte\ELController\ltspice model\PWL\output sine wave half waves with dead time.csv"
V2: voltage; PWL file="D:\Projekte\ELController\ltspice model\PWL\output sine wave half waves inverse with dead time.csv"
V3: voltage; 5V
V4: voltage; 170V
V5: voltage; 5V
V6: voltage; PULSE(0V 5V 0 0 0 1us 5us)
Named nets: out1, out2, 0, vcc, gn, unfiltered
.tran 6ms
.model hvSW SW(Ron=1.5 Roff=17meg Vt=0.1V Vh=0)
MAX: 6k, 96nF, MIN: 6nF, 100k
