muvi/ELController/ltspice model/Filter Test R4c.asc

C1: cap; 96nF
C2: cap; 100µF
C3: cap; 500nF
C4: cap; 500nF
C5: cap; 500nF
C6: cap; 500nF
D1: diode
D2: diode
D3: diode
D4: diode
L1: ind2; 3.3mH; Ipk=1
L2: ind2; 3.3mH; Ipk=1
R1: res; 6k
R2: res; 2.4
R3: res; 10
R4: res; 10
R5: res; 1
R6: res; 2.4
R7: res; 0.1
R8: res; 0.1
R9: res; 1
R10: res; 1.5
R11: res; 1.5
S1: sw; hvSW
S2: sw; hvSW
S3: sw; hvSW
S5: sw; hvSW
S6: sw; hvSW
V1: voltage; PWL file="D:\Projekte\ELController\ltspice model\PWL\output sine wave 5 with dead time.csv"
V2: voltage; PWL file="D:\Projekte\ELController\ltspice model\PWL\output sine wave 5 inverse with dead time 2.csv"
V3: voltage; 5V
V4: voltage; 170V
V5: voltage; 5V
V6: voltage; PULSE(0V 5V 0 0 0 1us 5us)
Named nets: out1, out2, 0, vcc, gn, unfiltered
.tran 6ms
.model hvSW SW(Ron=1.5 Roff=17meg Vt=0.1V Vh=0)
MAX: 6k, 96nF, MIN: 6nF, 100k
