muvi/ELController/ltspice model/Filter Test R4d.asc

C1: cap; 96nF
C2: cap; 1µF
C3: cap; 500nF
C4: cap; 500nF
C5: cap; 500nF
C6: cap; 500nF
C7: cap; 1µF
C8: cap; 1µF
D3: diode
D4: diode
L1: ind2; 3.3mH; Ipk=1
L2: ind2; 3.3mH; Ipk=1
R1: res; 6k
R3: res; 0.1
R4: res; 0.1
R5: res; 1
R6: res; 2.4
R7: res; 0.1
R8: res; 0.1
R10: res; 1.5
S2: sw; hvSW
S5: sw; hvSW
S6: sw; hvSW
V1: voltage; PWL file="D:\Projekte\ELController\ltspice model\PWL\output sine wave 5 with dead time.csv"
V4: voltage; 170V
V5: voltage; 5V
V6: voltage; PULSE(0V 5V 0 0 0 1us 5us)
Named nets: out1, out2, 0, vcc, gn, unfiltered
.tran 6ms
.model hvSW SW(Ron=1.5 Roff=17meg Vt=0.1V Vh=0)
MAX: 6k, 96nF, MIN: 6nF, 100k
K1 L1 L2 1
