muvi/ELController/ltspice model/Filter Test R5.asc

C1: cap; 25nF
C2: cap; 1µF
L1: ind; 440µH
L2: ind; 440µH
R1: res; 24k
R6: res; 0.1
R7: res; 0.1
R8: res; 0.1
U1: Si7119DN
U2: Si7119DN
U3: STN6N60M2_V2
U4: STN6N60M2_V2
V1: voltage; PWL file="D:\Projekte\ELController\ltspice model\PWL\output sine wave 5.csv"
V2: voltage; PWL file="D:\Projekte\ELController\ltspice model\PWL\output sine wave 5 inverse.csv"
V3: voltage; PWL file="D:\Projekte\ELController\ltspice model\PWL\output sine wave 5 inverse.csv"
V4: voltage; 170V
V5: voltage; PWL file="D:\Projekte\ELController\ltspice model\PWL\output sine wave 5.csv"
Named nets: out1, out2, 0
.tran 6ms
.model hvSW SW(Ron=1.1 Roff=17meg Vt=2.5V Vh=0)
