muvi/ELController/ltspice model/Filter Test T50.asc

C2: cap; 1µF
R2: res; 1k
R3: res; 100
R4: res; 100
R5: res; 1k
R6: res; 1k
R7: res; 1
R8: res; 1
U1: Si7119DN
U3: STN6N60M2_V2
V1: voltage; PWL file="D:\Projekte\ELController\ltspice model\PWL\output sine wave 5.csv"
V3: voltage; PWL file="D:\Projekte\ELController\ltspice model\PWL\output sine wave 5 inverse.csv"
V4: voltage; 170V
Named nets: 0
.tran 0 6ms 0 startup
.model hvSW SW(Ron=1.1 Roff=17meg Vt=2.5V Vh=0)
