muvi/ELController/ltspice model/FilterTest.asc

C1: cap; 400nF
C2: cap; 400nF
C3: cap; 40nF
C4: cap; 40nF
L1: ind; 5mH
L2: ind; 5mH
L3: ind; 5mH
L4: ind; 200mH
R1: res; 100
R2: res; 0
R3: res; 200
R4: res; 1k
R5: res; 0.1
R7: res; 100
V1: voltage; PULSE(0 170 0 0 0 250us 500us)
V2: voltage; 170V
V3: voltage; PULSE(0 170 0 0 0 250us 500us)
V4: voltage; PULSE(0 170 250us 0 0 250us 500us)
V5: voltage; PWL(0s 0V 83us 0V 84us 170V 166us 170V 167us 0V 333us 0V 334us -170V 416us -170V 417us 0V)
V7: voltage; PWL(0s 0V 83us 0V 84us 170V 166us 170V 167us 0V 333us 0V 334us -170V 416us -170V 417us 0V)
Named nets: 0, in, out
.tran 5ms
