muvi/ELController/ltspice model/Gate capacitance test.asc

C1: cap; 110pF
R1: res; 1Meg
V1: voltage; PULSE(0 7.5 0 0 0 0.25ms 0.5ms)
Named nets: 0
.tran 0.01s
