muvi/ELController/ltspice model/Gate loading test.asc

C1: cap; 11p
R1: res; 900k
V1: voltage; PULSE(0 9 0 0 0 500us 1ms)
Named nets: 0
.tran 1ms
