muvi/ELController/ltspice model/MOSC3022 test.asc

R1: res; 10
R2: res; 330
R3: res; 10
R4: res; 10
U1: MOC3022
V1: voltage; PULSE(0 3.3 1 0 0 2 4 1)
V2: voltage; SINE(0 50 2)
Named nets: 0
.tran 20s
