muvi/ELController/ltspice model/Output MOSFET Test combined with P pullup.asc

R1: res; 100
R2: res; 100
R3: res; 10k
R4: res; 0.1
R5: res; 5k
R7: res; 1k
R10: res; 0.1
R13: res; 2.2k
S1: sw; hvSW
S4: sw; hvSW
U1: Si7119DN
U2: STN4NF20L
U3: RZM001P02
V1: voltage; 85V
V3: voltage; 5V
V4: voltage; 170V
V5: voltage; PULSE(0V 5V 0 0 0 50us 100us)
V6: voltage; 5V
V9: voltage; PULSE(5V 0V 0 0 0 50us 100us)
Named nets: 0, outp, outn, out, pgate, ngate
.tran 0 0.3ms 0
.model hvSW SW(Ron=0.1 Roff=100meg Vt=2.5V Vh=0)
