muvi/ELController/ltspice model/Output MOSFET Test short circuit power failure.asc

C1: cap; 2µF
R1: res; 6.25
R2: res; 100
R3: res; 10k
R4: res; 0.1
R5: res; 5k
R6: res; 10k
R7: res; 1k
R8: res; 1k
R10: res; 0.1
R13: res; 137.5
S1: sw; hvSW
S2: sw; hvSW
S4: sw; hvSW
U1: Si7119DN
U2: STN4NF20L
U3: RZM001P02
U4: RZM001P02
U5: RZM001P02
U6: STN4NF20L
U7: STN4NF20L
U8: STN4NF20L
U9: STN4NF20L
U10: STN4NF20L
U11: STN4NF20L
U12: STN4NF20L
U13: STN4NF20L
U14: STN4NF20L
U15: STN4NF20L
U16: STN4NF20L
U17: STN4NF20L
U18: STN4NF20L
U19: STN4NF20L
U20: STN4NF20L
V1: voltage; 85V
V2: voltage; PULSE(0V 5V 0 0 0 50us 100us 1)
V3: voltage; 5V
V4: voltage; 170V
V5: voltage; PULSE(0V 5V 0 0 0 50us 100us 1)
V6: voltage; 5V
V9: voltage; PULSE(0V 5V 0 0 0 50us 100us 1)
Named nets: 0, outp, outn, out, pgate, ngate
.tran 0.1ms
.model hvSW SW(Ron=0.1 Roff=100meg Vt=2.5V Vh=0)
