muvi/ELController/ltspice model/Output MOSFET Test.asc

R1: res; 1k
R2: res; 1k
R3: res; 100
R4: res; 100
R5: res; 1k
R6: res; 1k
R7: res; 1k
S1: sw; hvSW
S2: sw; hvSW
U1: Si7119DN
U3: STN6N60M2_V2
V1: voltage; 5V
V2: voltage; 0V
V3: voltage; 5V
V4: voltage; 170V
V5: voltage; PULSE(0V 5V 0 0 0 50us 100us)
Named nets: 0
.tran 0 1ms 0
.model hvSW SW(Ron=0.1 Roff=100meg Vt=2.5V Vh=0)
