muvi/ELController/ltspice model/Output test board pullup.asc

R1: res; 1Meg
R2: res; 10k
S1: sw
V1: voltage; 5V
V2: voltage; PULSE(0V 1V 0 0 0 16ns 33ns)
Named nets: 0
.tran 1us
.model SW SW(Ron=0.1 Roff=17meg Vt=0.5V Vh=0)
