muvi/ELController/ltspice model/RZM001P02 test.asc

R1: res; 100
R2: res; 1
U1: RZM001P02
V1: voltage; 5V
V2: voltage; PULSE(0V 5V 0 0 0 5us 10us)
Named nets: 0
.tran 1ms
