muvi/ELController/ltspice model/SI7119DN test 2.asc

R1: res; 1
U1: Si7119DN
V1: voltage; 170
V2: voltage; PULSE(0 5 5us 0 0 5us 10us)
Named nets: 0
.tran 1ms
