muvi/ELController/ltspice model/SI7119DN test.asc

R1: res; 10
R2: res; 2k
R3: res; 1k
S1: sw; testsw
U1: Si7119DN
V1: voltage; 170V
V2: voltage; PULSE(0 5 5us 0 0 5us 10us)
V3: voltage; 5V
Named nets: 0
.tran 100us
.model testsw SW(Ron=0.1 Roff=100meg Vt=2.5 Vh=0)
