muvi/ELController/ltspice model/STN4NF20L Pin order test.asc

R1: res; 0.1
R2: res; 0.1
R3: res; 100
U1: STN4NF20L
V1: voltage; 5V
V2: voltage; 50V
V3: voltage; 0V
Named nets: 0, Drain, Source, Gate
.tran 0.5ms
