muvi/ELController/ltspice model/storage cap discharge test.asc

C1: cap; 10µF
R1: res; 2
S2: sw; testsw
V1: voltage; PULSE(5V 0V 0 0 0 100us 200us)
V2: voltage; 170V
Named nets: 0
.tran 500us
.model testsw SW(Ron=0.1 Roff = 100meg Vt=2.5V Vh=0)
