muvi/ELController/ltspice model/voltage controlled switch test 2.asc

R3: res; 1k
S1: sw; testsw
V1: voltage; 200V
V2: voltage; PULSE(0V 5V 0 0 0 0.5ms 1ms)
Named nets: 0
.model testsw SW(Ron=0.1 Roff=100meg Vt=4V Vh=0)
.tran 2ms
