muvi/ELController/ltspice model/voltage controlled switch test.asc

R1: res; 10k
S1: sw; testSW
V1: voltage; 170V
V2: voltage; 170V
Named nets: 0
.tran 2ms
.model testSW SW(Ron=0.1 Roff=100meg Vt=80 Vh=0)
