muvi/ELController/ltspice model/12V input dampening.asc

C1: cap; 47µF
C2: cap; 47µF
C3: cap; 47µF
D1: diode
L1: ind; 2.2µH
R1: res; 10
R2: res; 1
R3: res; 0.1
V1: voltage; PULSE(0V 12V 0 0 0 10us 20us)
Named nets: 0
.tran 100ms
