muvi/ELController/ltspice model/Draft1.asc

C1: cap; 47µF
C2: cap; 47µF
L1: ind; 2.2µH
R1: res; 10Meg
R2: res
V1: voltage; 12V
Named nets: 0
.tran 1ms
