muvi/ELController/ltspice model/Draft2.asc

C1: cap
L1: ind
V1: voltage
Named nets: 0
