muvi/ELController/ltspice model/Flyback BUK.asc

C1: cap; 20µF
D1: diode
D2: diode
L1: ind2; 5µH
L2: ind2; 500µH
R1: res; 20m
R2: res; 10000
R3: res; 10k
R4: res; 10k
R5: res; 1Meg
R6: res; 120Meg
U2: BUK7D25-40E
V1: voltage; 12V
V2: voltage; PWL file="D:\Projekte\ELController\ltspice model\PWL\HV supply PWL file.csv"
V3: voltage; 12V
Named nets: 0, out, FB
K1 L1 L2 1
.tran 10ms
