muvi/ELController/ltspice model/Flyback with alternating current draw.asc

C1: cap; 1µF
D1: diode
D2: diode
L1: ind2; 5µH
L2: ind2; 500µH
R1: res; 20m
R2: res; 1k
R3: res; 10k
R4: res; 10k
R5: res; 1Meg
R6: res; 120Meg
S1: sw; testsw
U1: RQ3E100BN
V1: voltage; 12V
V2: voltage; PWL file="D:\Projekte\ELController\ltspice model\PWL\HV supply PWL file.csv"
V3: voltage; 12V
V4: voltage; PULSE(0V 5V 0 0 0 5us 20us)
Named nets: 0, out, FB
K1 L1 L2 1
.tran 10ms
.model testsw SW(Ron=0.1 Roff=100meg Vt=2.5V Vh=0)
