muvi/ELController/ltspice model/ideal diode 2.asc

A2: diffschmitt; Vhigh=5 Vh=0 Vt=0.007
M1: nmos; PJU18N20
R1: res; 1k
R2: res; 100
R3: res; 1
R4: res; 555.55
R5: res; 1Meg
R6: res; 1Meg
R7: res; 1.001Meg
R8: res; 1Meg
V1: voltage; PULSE(0V 170V 0 0 0 6us 15us)
V2: voltage; 169V
V3: voltage; 5V
V4: voltage; 5V
V5: voltage; 0V
Named nets: 0, in, out, gate
.model PJU18N20 VDMOS(Vto=1.83 Kp=0.0000001 BV=200 Rd=0.08 Rs=0.08 Rg=1 Rds=100meg Cgs=1017p Cgdmin=148p Cgdmax=148p Tnom=25 )
.tran 200us
