muvi/ELController/ltspice model/ideal diode.asc

M1: pmos; AO3423
Q1: pnp; BC857B
Q2: pnp; BC857B
R1: res; 10k
R2: res; 10k
R3: res; 1
R4: res; 1
V1: voltage; 5V
V2: voltage; PULSE(0V 10V 0 0 0 1u 2u)
Named nets: 0, in, out, base, gate
.tran 10u
