muvi/ELController/ltspice model/inductors on same core.asc

C1: cap; 100µF
C2: cap; 100µF
C3: cap; 100nF
L1: ind2; 6.6mH
L2: ind2; 1.65mH
L3: ind2; 1.65mH
L4: ind; Flux=660m*tanh(5*x)
V2: voltage; PULSE(0V 100V 0 0 0 10ms 20ms)
Named nets: 0
.tran 0.03s
K1 L3 L2 1
