muvi/ELController/(list of files, drawings)

Other design files:
ltspice model/si7119dn/si7119dn_ps.olb
ltspice model/si7119dn/SI7119DN_PS_RC.OLB
