muvi/ELController/ideal diode board/ideal_diode.kicad_pcb

## KiCad design ideal diode board/ideal_diode.kicad_pcb (2023-04-17)

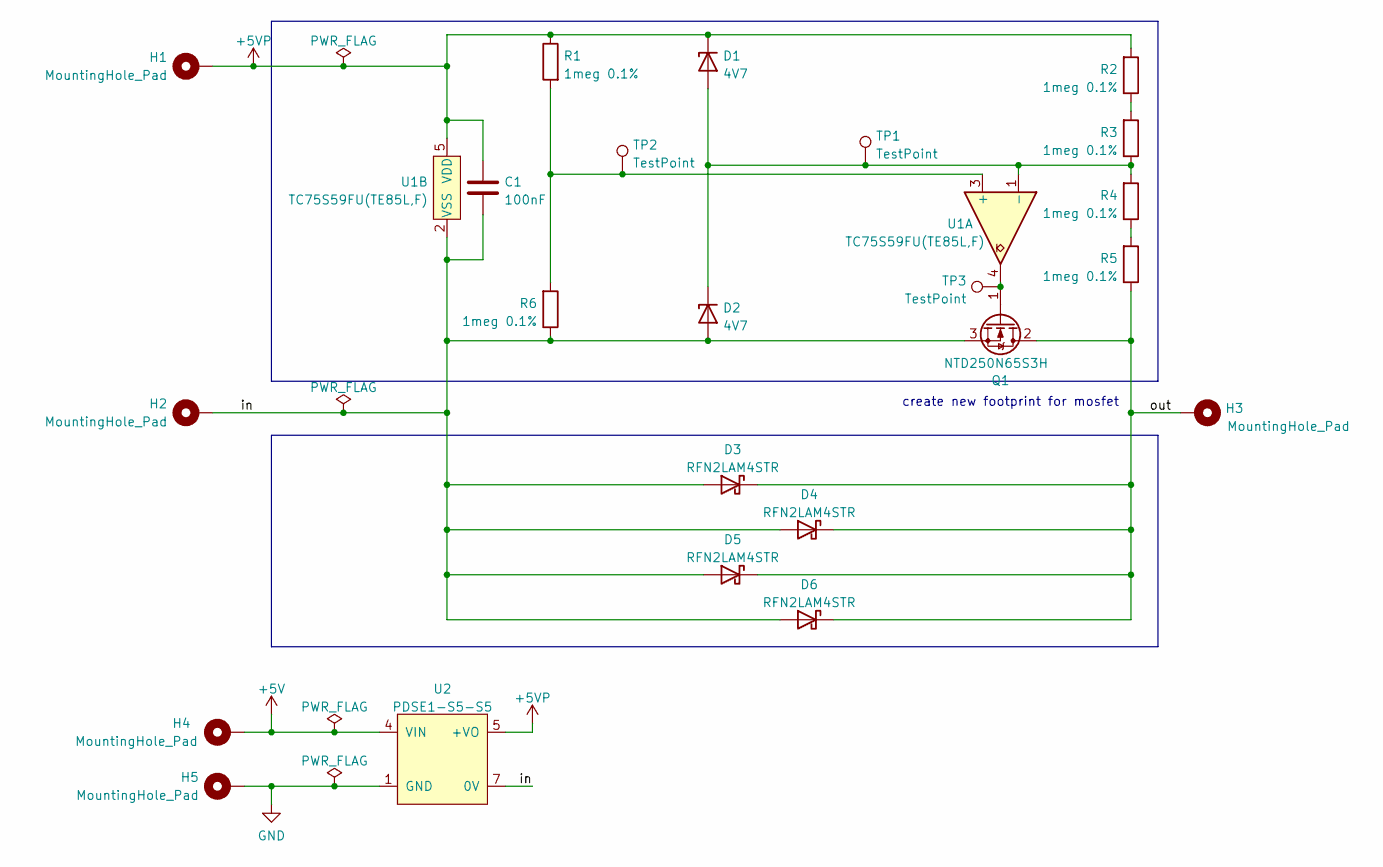
[picture p54: schematic ideal_diode.kicad_sch, Ideal diode]

Parts:
C1: 100nF; C_0603_1608Metric
D1, D2: 4V7; SOT-23
D3, D4, D5, D6: RFN2LAM4STR; D_SOD-128
H1, H2, H3, H4, H5: MountingHole_Pad; MountingHole_3.2mm_M3_Pad_Via
Q1: NTD250N65S3H; TO-252 3 LD
R1, R2, R3, R4, R5, R6: 1meg 0.1%; R_1206_3216Metric
TP1, TP2, TP3: TestPoint; TestPoint_THTPad_D2.0mm_Drill1.0mm
U1: TC75S59FU(TE85L,F); SSOP-P-0.95
U2: PDSE1-S5-S5; DIP-8_W7.62mm_S5-S5-D

Connections:
+5V: H4.1, U2.4 (VIN)
+5VP: C1.1, D1.3 (K), H1.1, R1.1, R2.2, U1.5 (VDD), U2.5 (+VO)
/in: C1.2, D2.1 (A), D3.2 (A), D4.2 (A), D5.2 (A), D6.2 (A), H2.1, Q1.3 (S), R6.1, U1.2 (VSS), U2.7 (0V)
/out: D3.1 (K), D4.1 (K), D5.1 (K), D6.1 (K), H3.1, Q1.2 (D), R5.1
GND: H5.1, U2.1 (GND)
unnamed: D1.1 (A), D2.3 (K), R3.1, R4.2, TP1.1, U1.1 (-)
unnamed: Q1.1 (G), TP3.1, U1.4
unnamed: R1.2, R6.2, TP2.1, U1.3 (+)
unnamed: R2.1, R3.2
unnamed: R4.1, R5.2

Notes on the sheet:
create new footprint for mosfet

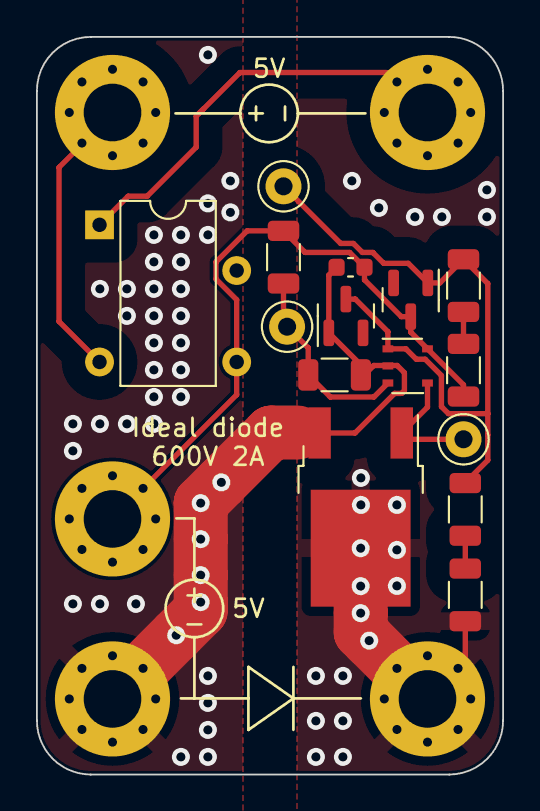
[picture p55: board ideal_diode.kicad_pcb from above]

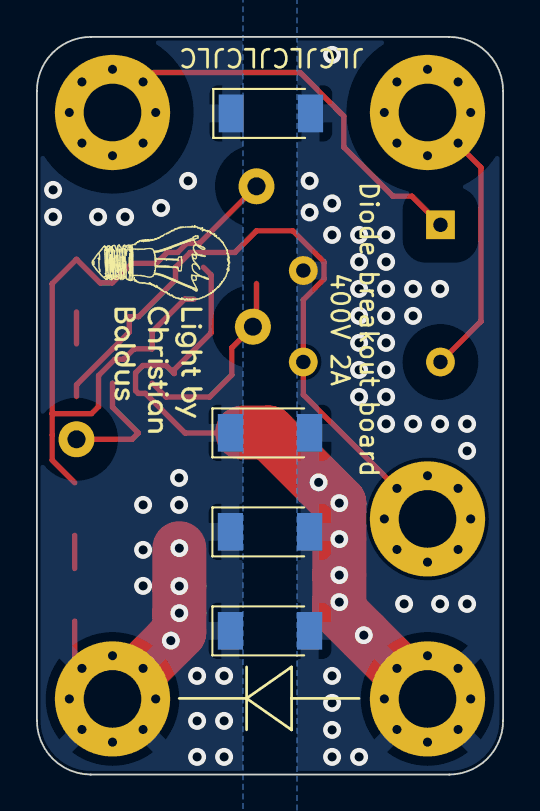
[picture p56: board ideal_diode.kicad_pcb from below]

Board: 4 copper layers, 25.9 x 41.0 mm, 24 parts (4 on the bottom side), 10 nets.
