muvi/ELController/code/ELController/My Project/sine_wave.h

/*
 * sine_wave.h
 *
 * Created: 26.08.2022 14:54:32
 *  Author: Christian
 */ 


#ifndef SINE_WAVE_H_
#define SINE_WAVE_H_

#include <hpl_pm_base.h>
#include <base_util.h>

typedef uint16_t sine_wave_frequency_t;
typedef uint8_t sine_wave_output_t;
typedef int16_t sine_wave_data_t;

//static const sine_wave_output_t sine_wave_data[] = {0x7F, 0x88, 0x90, 0x99, 0xA1, 0xA9, 0xB1, 0xB9, 0xC0, 0xC8, 0xCE, 0xD5, 0xDB, 0xE1, 0xE6, 0xEB, 0xEF, 0xF3, 0xF6, 0xF9, 0xFB, 0xFD, 0xFE, 0xFF, 0xFF, 0xFE, 0xFD, 0xFB, 0xF9, 0xF6, 0xF3, 0xEF, 0xEB, 0xE6, 0xE1, 0xDB, 0xD5, 0xCE, 0xC8, 0xC0, 0xB9, 0xB1, 0xA9, 0xA1, 0x99, 0x90, 0x88, 0x7F, 0x77, 0x6E, 0x66, 0x5E, 0x56, 0x4E, 0x46, 0x3E, 0x37, 0x30, 0x2A, 0x24, 0x1E, 0x19, 0x14, 0x10, 0x0C, 0x08, 0x06, 0x03, 0x02, 0x01, 0x00, 0x00, 0x01, 0x02, 0x03, 0x06, 0x08, 0x0C, 0x10, 0x14, 0x19, 0x1E, 0x24, 0x2A, 0x30, 0x37, 0x3E, 0x46, 0x4E, 0x56, 0x5E, 0x66, 0x6E, 0x77};
/*
static const sine_wave_data_t sine_wave_data[] = {
	0x0000,
	0x0004,
	0x0008,
	0x000D,
	0x0011,
	0x0015,
	0x0019,
	0x001E,
	0x0022,
	0x0026,
	0x002A,
	0x002E,
	0x0033,
	0x0037,
	0x003B,
	0x003F,
	0x0043,
	0x0047,
	0x004B,
	0x004F,
	0x0053,
	0x0057,
	0x005B,
	0x005F,
	0x0063,
	0x0067,
	0x006B,
	0x006F,
	0x0073,
	0x0077,
	0x007A,
	0x007E,
	0x0082,
	0x0085,
	0x0089,
	0x008C,
	0x0090,
	0x0093,
	0x0097,
	0x009A,
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
};
*/
extern sine_wave_data_t sine_wave_data[387];
/*static const sine_wave_data_t sine_wave_data[] = {
	0x0080,
	0x0082,
	0x0084,
	0x0086,
	0x0088,
	0x008A,
	0x008C,
	0x008E,
	0x0090,
	0x0093,
	0x0095,
	0x0097,
	0x0099,
	0x009B,
	0x009D,
	0x009F,
	0x00A1,
	0x00A3,
	0x00A5,
	0x00A7,
	0x00A9,
	0x00AB,
	0x00AD,
	0x00AF,
	0x00B1,
	0x00B3,
	0x00B5,
	0x00B7,
	0x00B9,
	0x00BB,
	0x00BD,
	0x00BE,
	0x00C0,
	0x00C2,
	0x00C4,
	0x00C6,
	0x00C7,
	0x00C9,
	0x00CB,
	0x00CD,
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
};*/

#define SINE_WAVE_MAX_VALUE 0xFF
#define SINE_WAVE_MIN_VALUE 0x00
#define SINE_WAVE_MAX_AMPLITUDE 0xFF
#define SINE_WAVE_AMPLITUDE_BITS 8
#define SINE_WAVE_PRESCALER 8
//#define SINE_WAVE_SAMPLE_COUNT (sizeof(sine_wave_data) / sizeof(sine_wave_data_t))
#define SINE_WAVE_SAMPLE_COUNT 387
#define SINE_WAVE_TICK_DURATION ((((float) SINE_WAVE_MAX_VALUE) * ((float) SINE_WAVE_PRESCALER)) / ((float) MAIN_CLOCK_SPEED))
#define SINE_WAVE_BASE_FREQUENCY (1.0 / (SINE_WAVE_SAMPLE_COUNT * SINE_WAVE_TICK_DURATION))
#define SINE_WAVE_FRACTIONAL_BITS 7

static const sine_wave_frequency_t SINE_WAVE_MAX_POSITION = (SINE_WAVE_SAMPLE_COUNT << SINE_WAVE_FRACTIONAL_BITS);
static const sine_wave_frequency_t SINE_WAVE_DECREMENT_START = 94; //first value where sine wave data is lower than the value before it (inclusive)
static const sine_wave_frequency_t SINE_WAVE_DECREMENT_END = 283; // last value where sine wave data is lower than the value before it (inclusive)

typedef struct {
	sine_wave_frequency_t position;
	sine_wave_output_t amplitude;
	sine_wave_frequency_t frequency;
	//sine_wave_output_t last_output;
	volatile sine_wave_output_t amplitude_buffer;
	volatile sine_wave_frequency_t frequency_buffer;
	volatile bool updated;
} SineWave;

typedef struct {
	sine_wave_output_t pos;
	sine_wave_output_t neg;
	//bool incrementing;
} SineWaveSample;

#define SINE_WAVE_DEFAULT_SAMPLE { \
	.pos = 0x00, \
	.neg = 0xFF, \
}

#define SINE_WAVE_FREQUENCY(real_frequency) (real_frequency * ((float) (1 << SINE_WAVE_FRACTIONAL_BITS)) / SINE_WAVE_BASE_FREQUENCY)

#define SINE_WAVE(_frequency, _amplitude) {\
	.position = 0, \
	.frequency = _frequency, \
	.amplitude = _amplitude, \
	.updated = false \
}

static inline SineWaveSample sine_wave_next(SineWave* sine) {
	if (sine->updated) {
		sine->frequency = sine->frequency_buffer;
		sine->amplitude = sine->amplitude_buffer;
		sine->updated = false;
	}
	sine->position = (sine->position + sine->frequency) % SINE_WAVE_MAX_POSITION;
	int16_t result = (((int16_t) sine_wave_data[sine->position >> SINE_WAVE_FRACTIONAL_BITS]) * (((int16_t) sine->amplitude) + 1)) >> SINE_WAVE_AMPLITUDE_BITS;
	SineWaveSample sample;
	sample.pos = result;
	sample.neg = SINE_WAVE_MAX_AMPLITUDE - ((int16_t) sine->amplitude) + result;
	
	//square wave modification
	/*
	sample.pos = sample.pos >= 0x7F ? 0xFF : 0x00;
	sample.neg = sample.neg >= 0x7F ? 0xFF : 0x00;
	*/
	
	//sample.incrementing = result > sine->last_output;
	//sine->last_output = result;
	//wrong sine wave
	/*
	if (result >= 0) {
		sample.pos = result;
		//sample.pos = result >= 0x7F ? 0xFF : 0x00;
		//sample.neg = 0;
		sample.neg = ((int16_t) sine->amplitude) - result;
	} else {
		//sample.pos = 0;
		sample.pos = ((int16_t) sine->amplitude) + result;
		//result = -result;
		//sample.neg = result >= 0x7F ? 0xFF : 0x00;
		sample.neg = -result;
	}
	*/
	return sample;
	//return result; //(sine_wave_data[sine->position >> SINE_WAVE_FRACTIONAL_BITS] * sine->amplitude) / SINE_WAVE_MAX_VALUE + (SINE_WAVE_MAX_VALUE - sine->amplitude) / 2;
}

static inline void sine_wave_update(SineWave* sine, sine_wave_frequency_t _frequency, sine_wave_output_t _amplitude) {
	//if there is a pending update, do that first
	if (!sine->updated) {
		sine->frequency_buffer = _frequency;
		sine->amplitude_buffer = _amplitude;
		sine->updated = true;
	}
}

#endif /* SINE_WAVE_H_ */
